l46kok/smart-doorlock/Documents/Smart Doorlock Poster.pptx

Department of
Electrical and
Computer Engineering

Applications

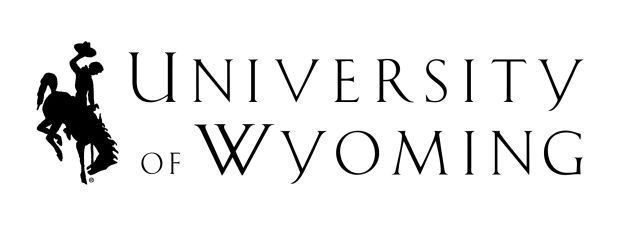
[picture p1: figure]
Image result for university of wyoming college of engineering

Smart Doorlock

Sokwhan Huh

Technology Background

http://sd.ufwfate.net/ Funded by Volpi and Cupal Senior Design Fund

Traditional mechanical locks have numerous issues pertaining to accessibility and security. Keys can be misplaced, broken, stuck in the lock and may not even turn, causing great deal of problems to home owners. Mechanical locks are easily picked by people with minimal knowledge in lock picking and keys are vulnerable to replication. A new type of door lock needs to be designed to better secure your assets.
With the advent of NFC (Near Field Communication) and IoT (Internet of Things), virtually everything around us can now be controlled via nothing more than a smartphone. The intent of this project is to provide a practical solution to aforementioned problems with traditional mechanical locks by applying both NFC and IoT technologies to an electronic door lock.

NFC Capability
- Open the door lock with NFC using an Android device.
IoT Capability
- Open the door lock over the internet using an Android device or by accessing Smart Doorlock’s web server with an internet browser.
Enhanced Security System
- Manage user access by registering smartphones.
- Entries are logged and can be audited.
Robust Operation
- 24 hour rechargeable battery backup system.

Smart Doorlock supports the following operations that can be navigated using the keypad:
- Active
- Configuration
  - Operation Setup
  - Register Phone
  - Unregister Phone
  - Setup Wi-Fi
  - Test Wi-Fi Connection
  - Factory Reset
- Reboot

System Block Diagram

Overview

Cost Summary

CC3200 Launchpad | $ 29.99
TRF7970A NFC BoosterPack | $ 24.99
Keypad | $ 9.04
6xAA Battery Holder | $ 2.50
20x4 LCD Display | $ 22.71
Solenoid Lock | $ 14.95
Enclosure | $ 21.94
Miscellaneous | $ 10.00
Total | $ 136.12

Final Design

Acknowledgements

For support and guidance in creating this project, I would like to give my special thanks to:
University of Wyoming
Dr. Steven Barrett
Victor Bershinsky
George Janack
Mike
LG Electronics Gasan R&D
Junseo Son
Nexol System
Jaesik Cho

Near Field Communication

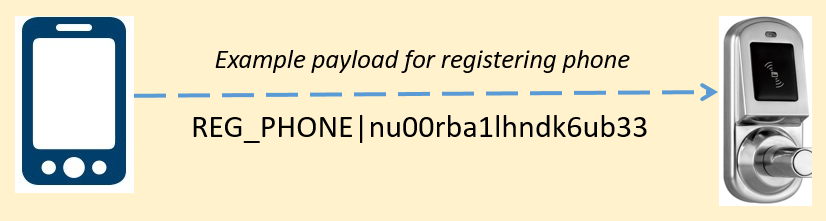
[picture p2: figure]

NFC is a collection of communication protocols that enable two electronic devices to establish communication in a close proximity, typically within 5cm if each other.
Android HCE (Host Based Card Emulation) technology
is used to emulate ISO 14443 type NFC tags. An encrypted payload from the smart phone is created in NDEF structure and sent to the door lock.

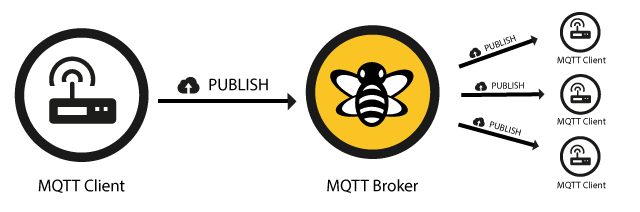
[picture p3: figure]
MQTT Publish Message Flow

MQTT (Message Queue Telemetry Transport) is a publish/subscribe based protocol specifically designed for use in IoT. Web server on cloud acts as a MQTT broker and Smart Doorlock acts as a MQTT client. Messages such as LOCK_CONTROL can published from the broker to control the door lock.

TRF7970A Circuit Diagram

Internet of Things

IoT Control Panel

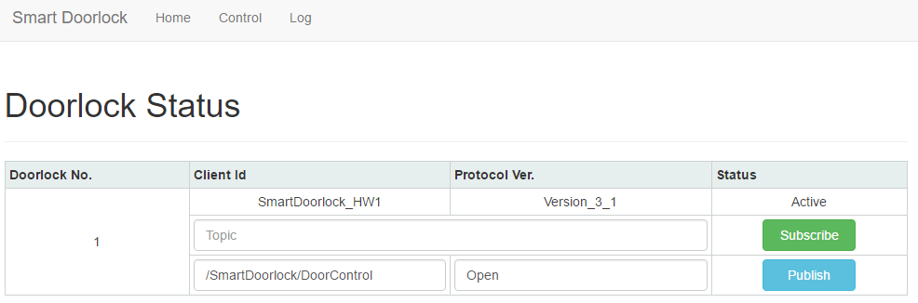
[picture p4: figure]

Android Application

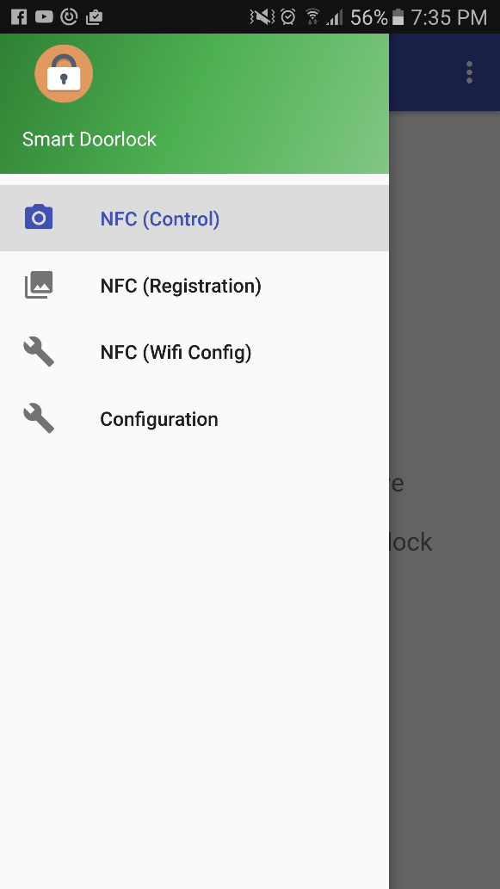
[picture p5: figure]

Access Log Audit

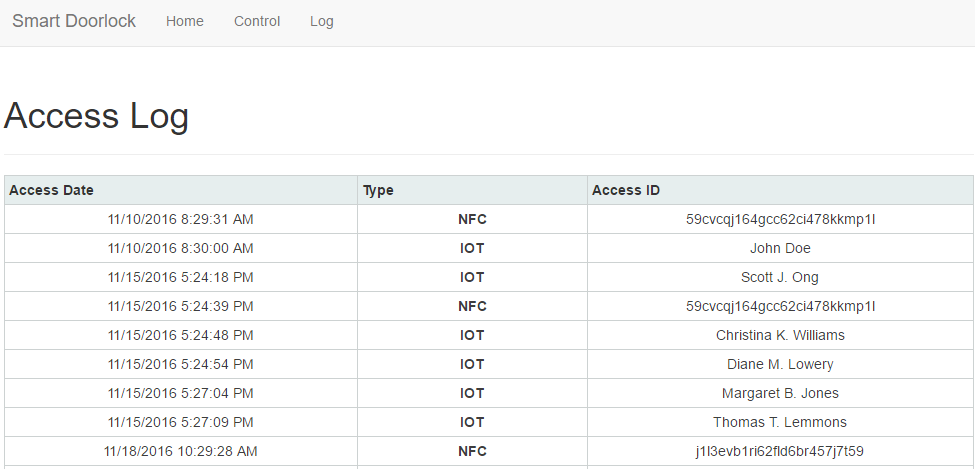
[picture p6: figure]

Features

CC3200 Circuit Diagram

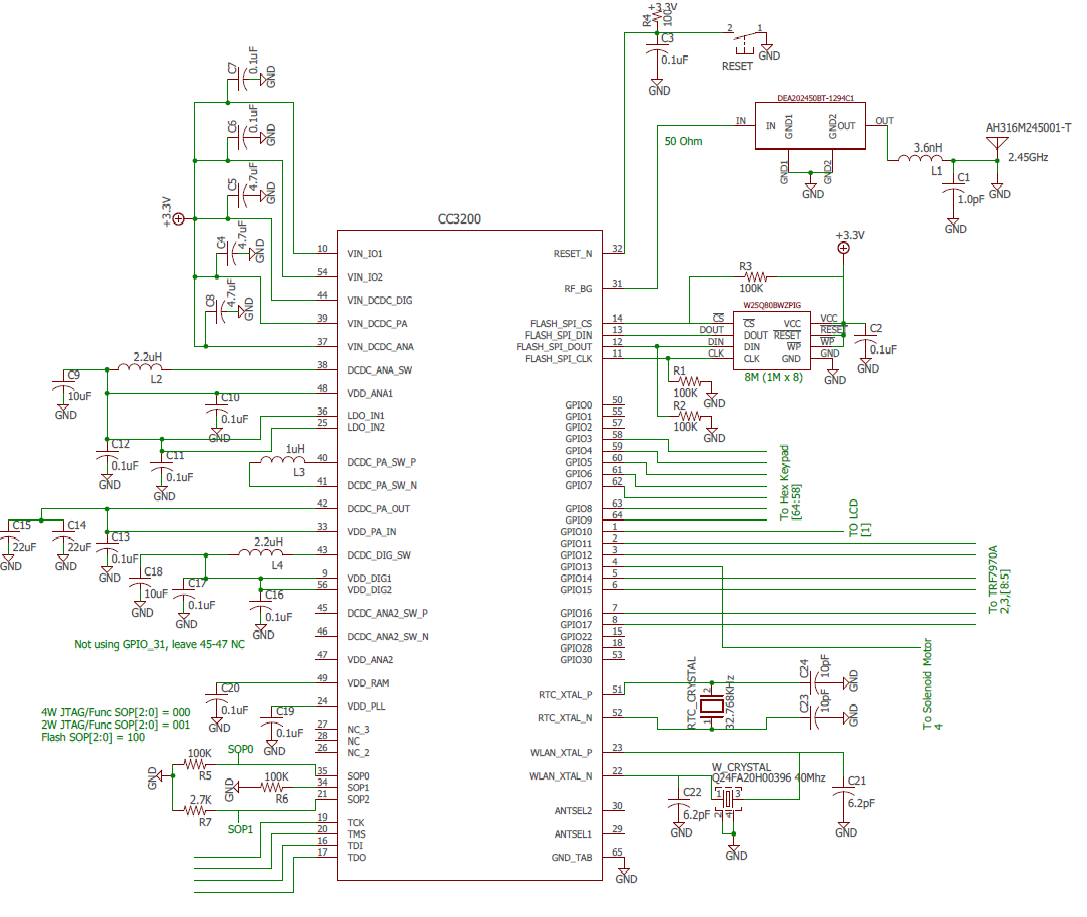
[picture p7: figure]

Hardware Design

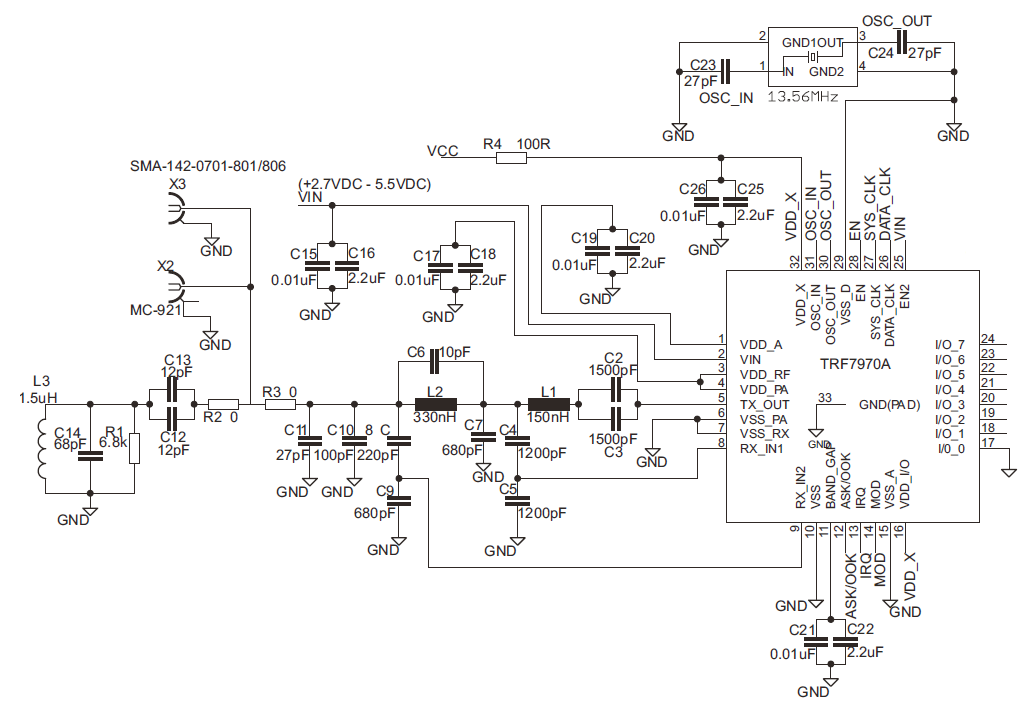
[picture p8: figure]

LCD/Solenoid/Keypad Driver Circuit Diagram

Operations

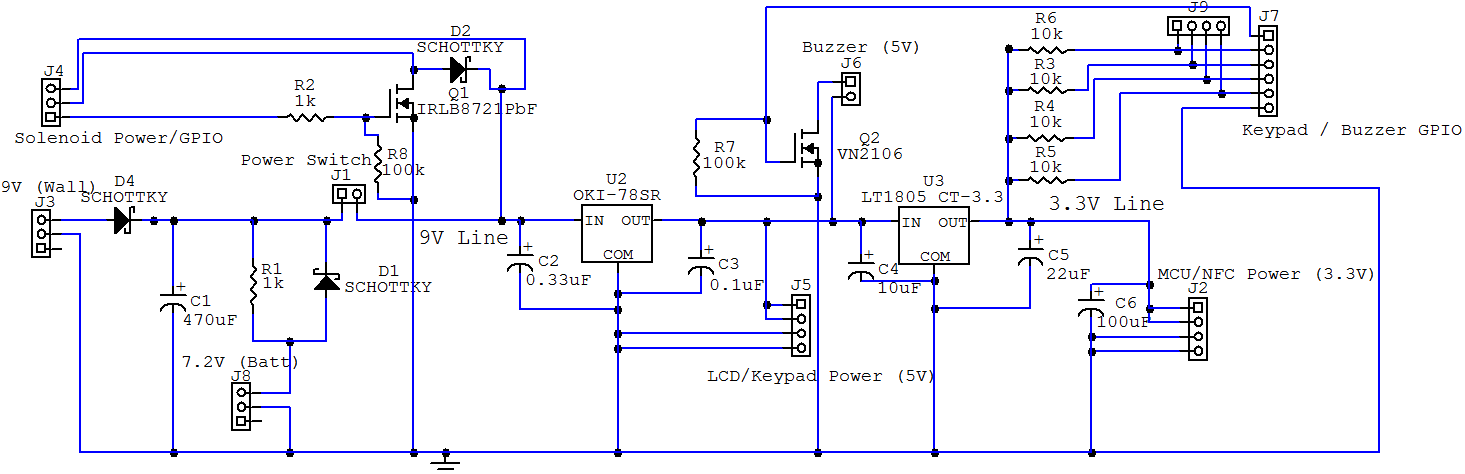
[picture p9: figure]
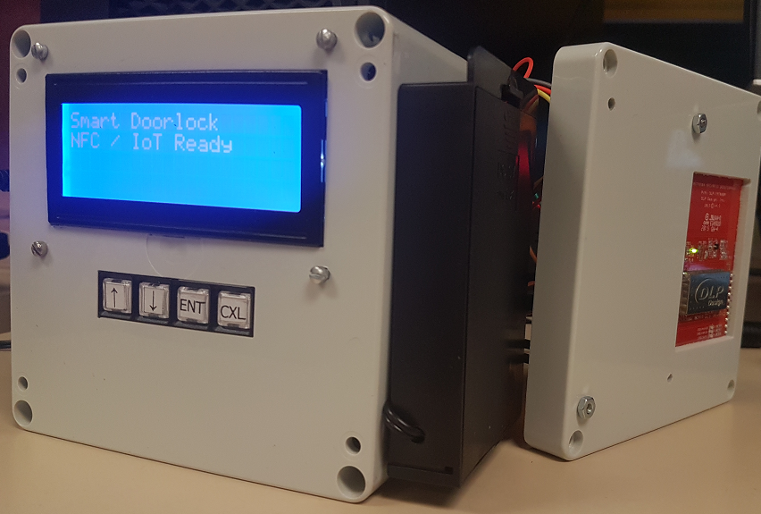
[picture p10: figure]

Microcontroller Boot Sequence

Software Design

NFC Task Diagram

Web Server Class Diagram

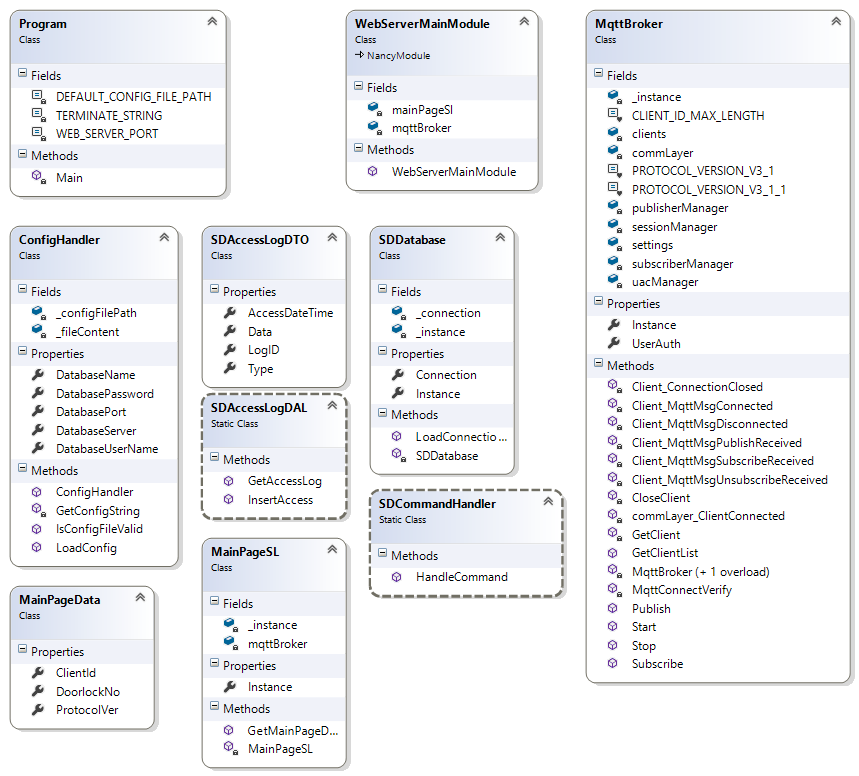
[picture p11: figure]
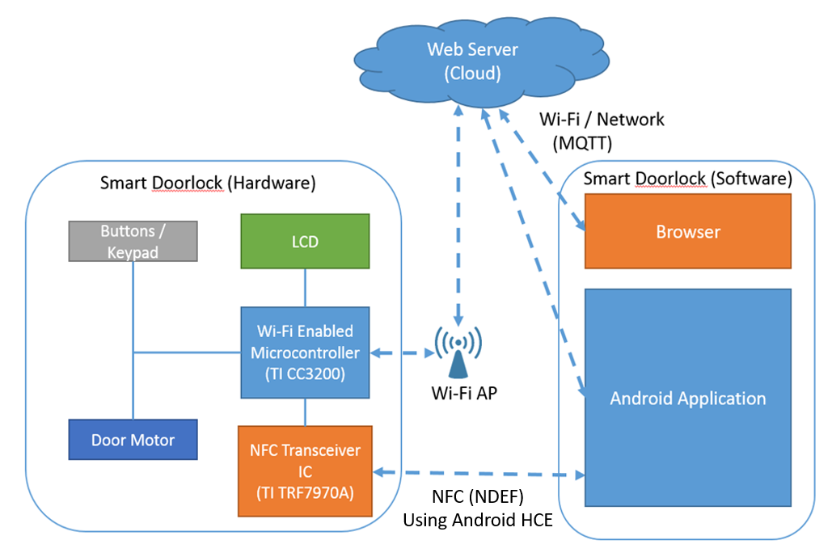
[picture p12: figure]

Android Application Flow Diagram

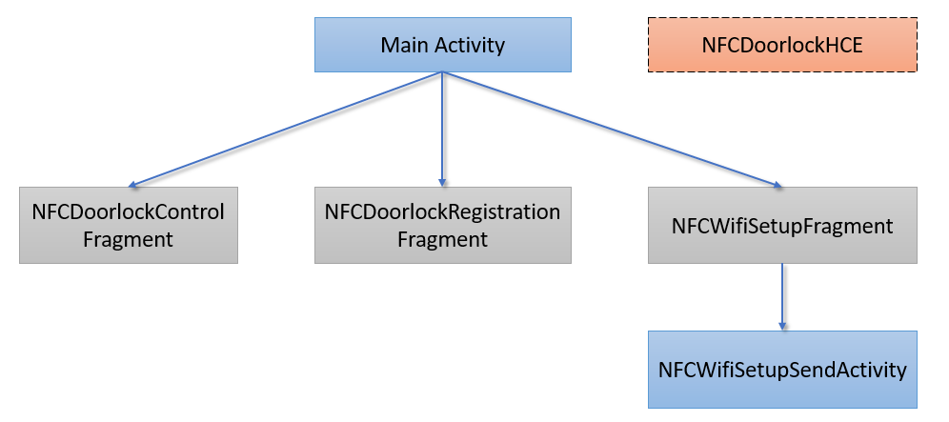
[picture p13: figure]

Microontroller Menu Flow Diagram

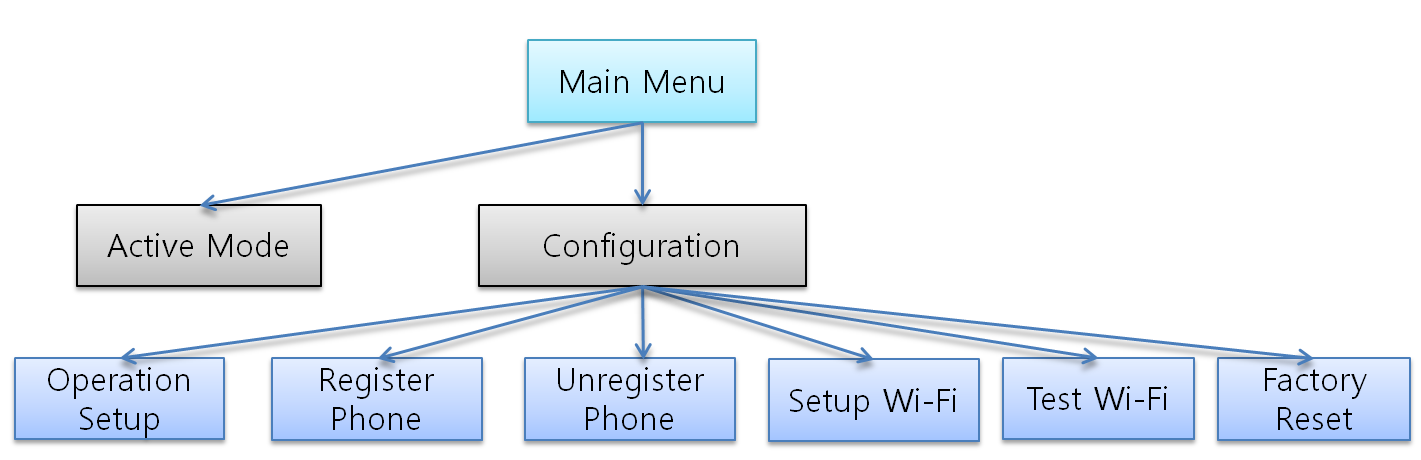
[picture p14: figure]
