l46kok/smart-doorlock/Documents/Smart Doorlock Final Project Report.docx

FINAL DESIGN REPORT TO: Dr. Steven F. Barrett

Associate Dean for Academic Programs

Professor, Electrical & Computer Engineering

FROM: Sokwhan Huh

DATE: Nov 21st, 2016

SUBJECT: Smart Doorlock Final Design Report Draft

For your review, attached is the final design report of the senior design project. Contents include 1) Introduction, briefly summarizing the goals, requirements and specification of the project, 2) Operation, discussing the functionalities and possible use cases of the door lock, 3) Parts, describing the specifications and the rationale for choosing the parts in detail, 4) Development, which captures the approach I will take to complete this project, 5) Project cost, which describes a preliminary analysis of the anticipated cost of the project and 6) References.

Sincerely,

Sokwhan Huh

Smart Doorlock Final Project Report

Date: November 21st, 2016

Primary Author: Sokwhan Huh

Revision History

Revision | Date | Reason for Changes
1.0 | May 12, 2016 | Created design report for Spring of 2016
1.1 | November 18, 2016 | Updated document to reflect actual progress of the project, added technical background section.
1.2 | November 19, 2016 | Added source codes for the project

Tables of Contents

# 1. Introduction

## 1.1 Executive Summary

Traditional mechanical locks have numerous issues pertaining to accessibility and security. Always having to carry keys can be burdensome and keys themselves can be misplaced, broken, stuck in the lock or may not even turn causing great deal of problems to home owners. These locks often are also not built to cater for disabled personnel who may lack the capability of operating such lock. But the bigger problem lies with its insufficient security. Mechanical locks are easily picked by people with minimal knowledge in lock picking and keys are vulnerable to replication by locksmiths. A new type of door lock needs to be designed to better secure your assets.

With the advent of NFC (Near Field Communication) and IoT (Internet of Things), virtually everything around us can now be controlled via nothing more than a smartphone. NFC is now a quintessential technology for transportation systems around the world, as a passenger simply needs to carry his or her smartphone to use the services as opposed to purchasing tickets and transportation cards. Commonly known as Smart Home Technology, IoT is being deployed in many households which allow household products to be controlled in all imaginable ways requiring nothing but an internet connection. The intent of this project is to provide a practical solution to aforementioned problems with traditional mechanical locks by applying both NFC and IoT technologies to an electronic door lock.

## 1.2 Terminologies

The following acronyms and terminologies are used in this document:

Acronym / Terminology | Description
NFC | Near Field Communication.
RFID | Radio-Frequency Identification.
IOT | Internet of Things.
ISO/IEC 14443 | Four-part international standard for contact-less smart cards operating at 13.56 MHz in close proximity.
ISO/IEC 7816-4 | International standard for logical structure of data in smart cards.
HCE | Host-based Card Emulation. Feature of Android operating system that allows smartphones to emulate a NFC tag in ISO 14443 standard.
NDEF | NFC Data Exchange Format. A standardized data format that is used to exchange information between any compatible NFC device.
TCP/IP | Transmission Control Protocol / Internet Protocol. Commonly known as Internet protocol suite. Defines set of communications protocols used on the Internet.
MQTT | Message Queuing Telemetry Transport. A publish-subscribe based "light weight" messaging protocol for use on top of the TCP/IP protocol.
API | Application Programming Interface.
OFDM | Orthogonal Frequency-Division Multiplexing
AP | Access Point.
SSID | Service Set Identifier.
ASK | Amplitude-Shift Keying .
APDU | Application Protocol Data Unit. Command and response packets for communication with smartcards. Defined in ISO 7816-4 standard.
AID | Application ID. Defined in ISO 7816-4 standard to distinguish NFC devices.
PICC | Proximity Integrated Circuit Cards. Examples include NFC tags and contactless smart cards.

## 1.3 Target Market

This project is intended for the following audience:

- Lay person being able to control their door locks with ease, eliminating the need of carrying a key or memorizing passwords.
- Handicapped personnel who may have difficulties locking and unlocking a traditional door lock.
- People who are looking for additional security measures.

## 1.4 Project Requirements

The core project requirements are as follows:

- Demonstrate NFC capability
  - Be able to open the door lock with NFC using an Android device. The device must be registered in advance to open the door lock.
- Demonstrate IoT capability
  - Be able to open or permanently lock (lockdown mode) the door lock over the internet using an Android device or by accessing Smart Doorlock’s web server with a browser. The phone must be registered in advance to open the door lock.
- Demonstrate enhanced security system
  - Be able to register phones for access.
  - Be able to clear existing registered phones.

Additional requirements are as follows:

- Implement full logging system for entries.
- Have the door lock function with a battery backup in case of power outage.

## 1.5 Technical Specifications

- Interfacing via NFC between Smart Doorlock and an Android device using Host-based Card Emulation technology
- Interfacing via IoT to a cloud server over MQTT Protocol
- NFC communication range: 5 cm maximum (from smartphone to Smart Doorlock)
- Wi-Fi communication range: 50 meters maximum (TX 14.5dBM, RX -74.0dBM at 54 OFDM)
- Microcontroller: Texas Instruments CC3200
- NFC Transceiver IC: Texas Instruments TRF7970A
- AC power with DC battery backup
- Minimum backup battery life of 24 hours
- Keypad: Grayhill 4x1 87FC3-201 transparent keypad
- LCD: Newhaven’s NHD-0420D3Z-NSW-BBW-V3-ND 4x20 characters
- Programming Language: C (Microcontroller), Java (Android Application), C# (Web Server)
- Supported Android versions: 4.4 (Kitkat) and above
- Web Server Framework: NancyFX
- Web Server Database: MySQL

# 2. Technology Background

As Smart Doorlock utilizes some of the most cutting edge technologies available today, this section will briefly provide a background information on the two major technologies (NFC, IoT) driving the project.

## 2.1 NFC Introduction

NFC is a collection of communication protocols that enable two electronic devices to establish communication in a close proximity, typically within 5 cm of each other. Specifically, NFC is a branch of High-Frequency (HF) RFID (Radio-Frequency Identification) that operates at the 13.56 MHz frequency. NFC is designed to be a secure form of data exchange and unlike RFID, an NFC device is flexible in the sense that it is capable of acting as a reader (active mode) or as a tag (passive mode). This unique feature allows the two devices to communicate in a bi-directional manner (peer-to-peer communication). The following chart displays the speed and two codings NFC employs:

Speed | Active device | Passive device
424 kbits/s | Manchester coding, 10% ASK | Manchester coding, 10% ASK
212 kbits/s | Manchester coding, 10% ASK | Manchester coding, 10% ASK
106 kbits/s | Modified Miller, 100% ASK | Manchester coding, 10% ASK

Table 2.1: Speed and codings used by NFC technology

## 2.2 NFC Standards

As NFC is a subset of RFID, much of its standards are derived from existing RFID standards including ISO 7816-4, ISO 14443, ISO 15693, ISO 18092 and FeliCa. These standards specify the modulation schemes, coding, transfer speeds, frame format, initialization schemes, collision-control, and transport protocol. The choice of standard entirely dictates the method and capability of communication between the two NFC devices. This document will provide background on ISO 7816-4 and ISO 14443 standards as Smart Doorlock utilizes these two standards to communicate between the door lock and the smart phone.

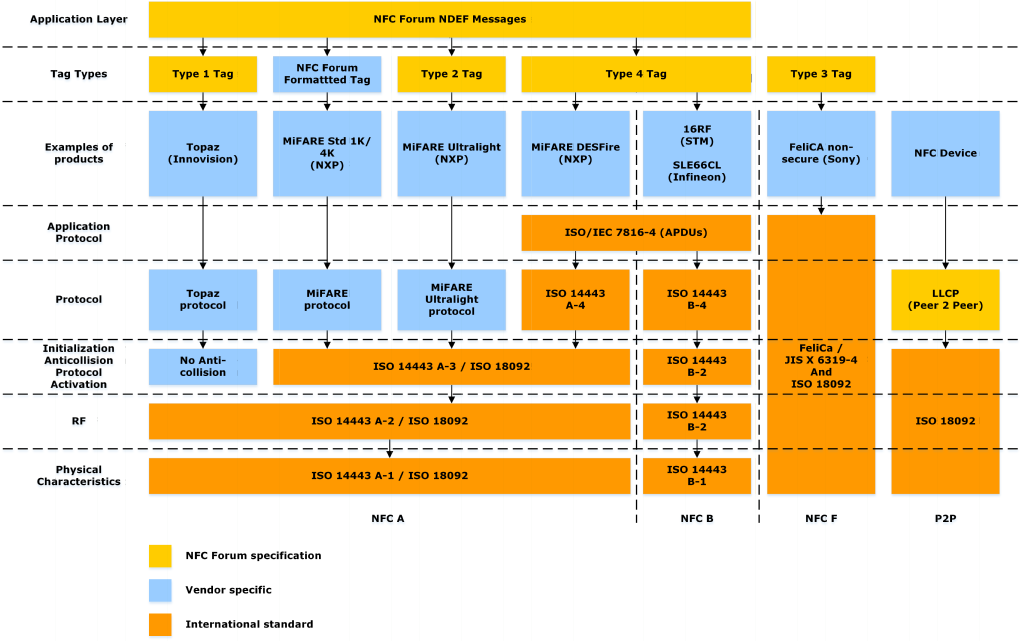
[picture p15: figure]

Figure 2.2: NFC protocol stack overview

## 2.3 ISO 7816-4 Standard

ISO 7816 is an international standard covering electronic identification cards with contacts, such as smart cards. ISO 7816-4 specifically denotes the organization, security and commands for interchange. The standard specifies the following:

- Contents of command-response pairs exchanged at the interface,
- Means of retrieval of data elements and data objects in the card,
- Structures and contents of historical bytes to describe operating characteristics of the card,
- Structures for applications and data in the card, as seen at the interface when processing commands,
- Access methods to files and data in the card,
- A security architecture defining access rights to files and data in the card,
- Means and mechanisms for identifying and addressing applications in the card,
- Methods for secure messaging,
- Access methods to the algorithms processed by the card.

Note that this standard does not cover the internal implementation within the card or the outside world. This is covered in a different standard such as ISO 14443.

APDU (Application Protocol Data Unit) are the command and response packets used in ISO 7816-4 standard. A command APDU consists of an instruction code and associated parameter data. In response to a preceding command APDU, a response APDU is sent back which consists of response data and a response status code. Table 2.31 shows the structure of command-response APDU.

Field | Description | Number of bytes
Command Header | Class byte denoted CLA | 1
| Instruction byte denoted INS | 1
| Parameter bytes denoted P1-P2 | 2
Lc field | Absent for encoding Nc = 0, present for encoding Nc > 0 | 0, 1 or 3
Command data field | Absent if Nc = 0, present as a string of Nc bytes if Nc > 0 | Nc
Le field | Absent for encoding Ne = 0, present for encoding Ne > 0 | 0, 1, 2 or 3
Response data field | Absent if Nr = 0, present as a string of Nr bytes if Nr > 0 | Nr (at most Ne)
Response trailer | Status bytes denoted SW1-SW2 | 2

Table 2.31: Command-response APDU pair

ISO 7816-4 also defines a unique identifier called AID (Application Identifier). This identifier is used to distinguish between different NFC devices so that it provides a guarantee method for an NFC device to recognize that it’s communicating to the correct target.

In relation to Smart Doorlock, a SELECT AID command is sent from NFC reader to Android device when the two devices are attempting to establish the NFC communication. For appliactions to be used with existing NFC readers, the AIDs that those readers are looking for are typically well-known and publicly registered (for example, the AIDs of payment networks such as Visa and MasterCard). If a new reader infrastructure is to be deployed for a proprietary application, registering a unique AID in accordance to ISO 7816-5 specification is recommended to avoid collisions with other applications.

Table 2.32 shows an actual example of APDU sent from Smart Doorlock to Android device in an attempt to check if the target has an AID of “D2760000850101”

Command Header | | | | Lc | Command Data Field | Le
CLA | INS | P1 | P2 | | AID
0x00 | 0xA4 | 0x04 | 0x00 | 0x07 | 0xD2760000850101 | 0x00

Table 2.32: Command-response APDU pair

## 2.4 ISO 14443 Standard

ISO 14443 is a four-part international standard for contactless smart cards. The four parts, denoted from ISO 14443-1 to ISO 14443-4 are as follows:

- Part 1 [ISO 14443-1]: Defines the size and physical characteristics of the card. This standard lists several environmental stresses that the card must be capable of withstanding without permanent damage to the functionality.
- Part 2 [ISO 14443-2]: Defines the RF power and signal interface. Two signaling schemes known as Type A and Type B are defined in this part. Both communication schemes are half duplex with a 106 kbis per second data rate in each direction. Data transmitted by the card is load modulated with a 847.5 kHz subcarrier.
- Part 3 [ISO 14443-3]: Defines the initialization and anticollision protocols for Type A and Type B. The anticollision commands, responses, data frame, and timing are defined in this part. The initialization and anticollision scheme is designed to permit the construction of multi-protocol readers capable of communication with both Type A and Type B cards. Both card types wait silently in the field for a polling command. A multi-protocol reader would poll one type of card, complete any transactions with cards responding and then poll for the other type of card and transact witht hem.
- Part 4 [ISO 14443-4]: Defines the high-level data transmission protocols for Type A and Type B. The protocol defined in this part is also capable of transferring APDU as defined in ISO 7816-4 and of AID selection.

Difference between Type A and Type B is that Type A uses Miller encoding (delay encoding) with an amplitude modulation at 100% while Type B uses Manchester encoding with amplitude modulation at 10%. Note that in case of Smart Doorlock, Android devices emulate Type A cards with HCE (Host-Based Card Emulation) technology. Figure 2.4 provides an overview of ISO 14443 protocol stack.

ISO/IEC 14443

ISO 14443-1
Physical Properties

ISO 14443-2 Type A

Power, Bit Transmission

ISO 14443-3 Type A

Activation, Anticollision

ISO 14443-4

Transport Protocol

ISO 7816-4
APDU, Application Protocol

Figure 2.41: ISO 14443 Protocol Stack

As ISO 14443-1 and ISO 14443-2 focuses on the physical and RF characteristics of the standard, the actual implementation of these two protocols are dictated by the choice of hardware (in case of Smart Doorlock, this refers to NFC reader and Android device). This section will primarily focus on ISO 14443-3 and ISO 14443-4 for the actual implementation of the protocol.

ISO 14443-3 defines the activation and anticollision sequence. In order for an NFC reader to detect PICC (Proximity Integrated Circuit Cards), the NFC reader goes through a sequence of polling to repeatedly send request commands known as REQA (Request Command, Type A). When a PICC of Type A is exposed to an unmodulated operating field, the request to command is accepted and responded with ATQA (Answer to Request, Type A). Next, the NFC reader undergoes a looping process known as anticollision detection to determine if at least two PICCs are simultaneously transmitting bit patterns. As bit patterns are continuously sent from the PICC, the NFC reader needs to determine if the received UID (Unique Identifier, Type A) is complete during its anticollision loop.

Each time the NFC reader receives a UID, it transmits a SEL (Select) command appended with either partial or fully received UID to the PICC, which is responded with SAK (Select Acknowledge). The SAK response indicates that UID transmission is complete or not. ISO 14443A standard permits UIDs of different lengths – 4 bytes, 7 bytes and 10 bytes. Therefore, in case the PICC has a UID of 7 or 10 bytes, it will notify the NFC reader by setting the cascade bit in SAK command. This causes the reader to increase the cascade level in anticollision loop and repeat the process starting from selecting the UID. If the UID is 10 bytes long, the anticollision loop is ran a third time. Table 2.42 and 2.43 shows the SEL command and the SAK response structure.

b8 | b7 | b6 | b5 | b4 | b3 | b2 | b1 | Meaning
1 | 0 | 0 | 1 | 0 | 1 | 1 | 1 | ‘93’ Select cascade level 1
1 | 0 | 0 | 1 | 0 | 1 | 0 | 1 | ‘95’ Select cascade level 2
1 | 0 | 0 | 1 | 0 | 1 | 1 | 1 | ‘97’ Select cascade level 3
1 | 0 | 0 | 1 | Other values except those here above | | | | RFU

Table 2.42 SEL command structure

b8 | b7 | b6 | b5 | b4 | b3 | b2 | b1 | Meaning
x | x | x | x | x | 1 | x | x | Cascade bit set: UID not complete
x | x | 1 | x | x | 0 | x | x | UID complete, PICC compliant with ISO 14443-4
x | x | 0 | x | x | 0 | x | x | UID complete, PICC not compliant with ISO 14443-4

Table 2.43 SAK response structure

Note that UID serves a completely different purpose than AID as mentioned in ISO 7816-4 standard. Contrary to its name, there is no specification in the standard that mandates the UID to be truly unique. As it will be apparent in Android HCE section of this document, the UID is randomly generated on an Android device each time the device attempts to perform NFC communication. Hence, the UID should not be relied on for actual identification of the NFC device or PICC in the actual implementation of an application. Figure 2.44 is a flowchart for initialization and anticollision procedure of ISO 14443-3.

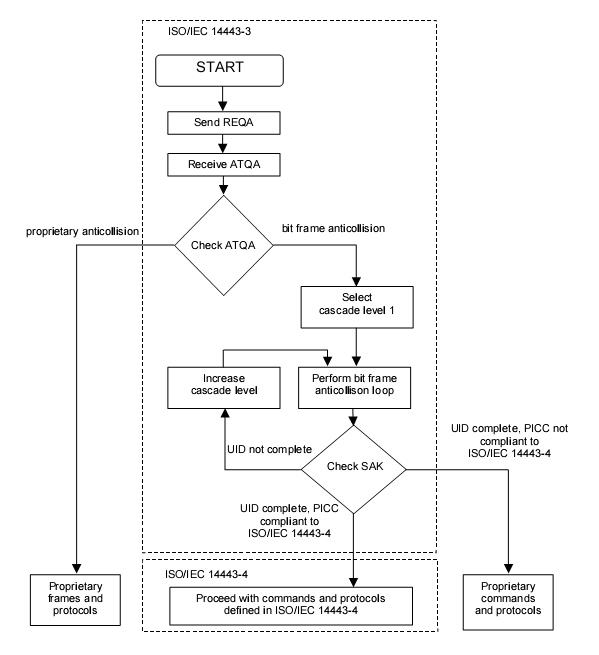
[picture p16: figure]

Figure 2.44 – Initialization and anticollision flowchart for NFC reader

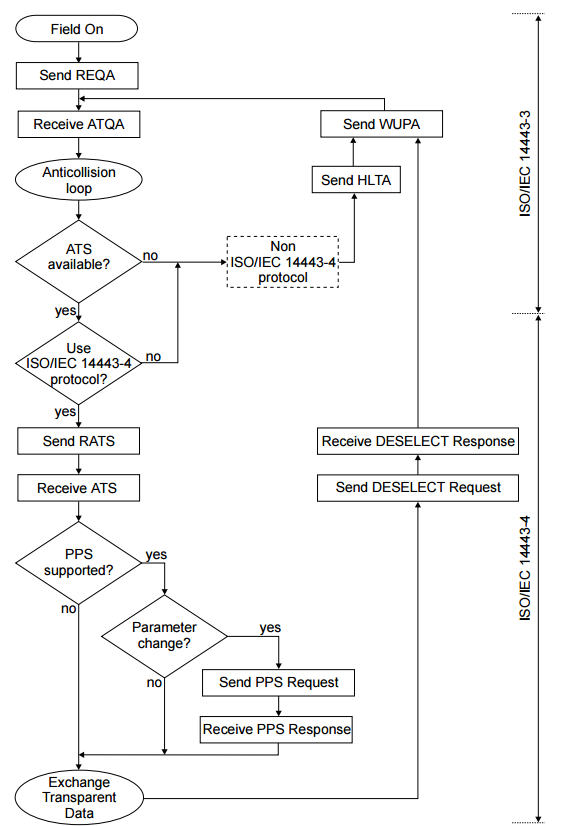
[picture p17: figure]

ISO 14443-4 specifies a half-duplex block transmission protocol featuring the special needs of contactless environment and defines the activation and deactivation sequence of the protocol. When PICC activation sequence as defind in ISO 14443-3 is complete, the SAK byte is checked for availability of an ATS (Answer To Select). If ATS is not available, then the target of NFC reader is assumed to be non ISO14443-4 compliant. If it is available, the NFC reader sends RATS (Request for Answer To Select) to the PICC. The PICC must respond with ATS as an answer to the RATS. NFC reader can check the ATS to determine if PICC supports any changeable parameters, such as transmission rate. The NFC reader may optionally send a PPS command if the PICC has any modifiable parameters. The protocol activation sequence for ISO 14443-4 is shown in Figure 2.45.

Figure 2.45 – Protocol activation sequence for ISO 14443-4

## 2.5 NDEF Structure

NDEF (NFC Data Exchange Format) is a standardized data format that is used to exchange information between any compatible NFC devices. It is a binary format structured in messages, intended to be used on the application layer. Each record is made up of a header, which contains metadata about the record, such as the record type, length etc. The header is followed by a payload, which is the actual content of the message being transmitted.

Each record’s payload can be one of several different data types. The header for each record contains metadata describing the record and its place in the mssage, followed by its type and ID. Figure 2.51 shows the structure of the bits and bytes of an NDEF record.

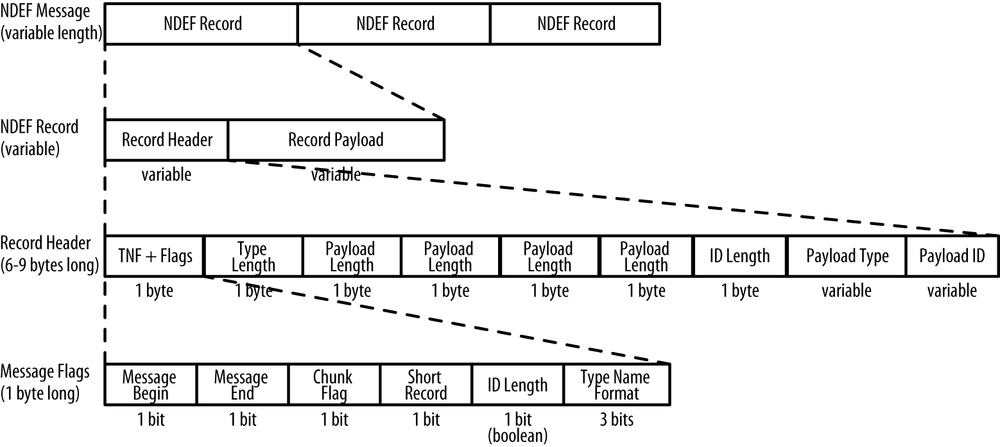
[picture p18: figure]
NDEF message structure, with details about the bytes of the header

Figure 2.51 NDEF Message Structure

TNF (Type Name Format) indicates how to interpret the type field. The seven possible TNF values are shown in Table 2.52

TNF | Meaning | Description
0 | Empty | Empty record with no payload
1 | Well-Known | One of several pre-defined types laid out in the NFC Forum RTD specification
2 | MIME media-type | An Internet media type as defined in RFC 2046
3 | Absolute URI | A URI as defined in RFC 3986
4 | External | A user-defined value
5 | Unknown | Type is unknown
6 | Unchanged | Only for middle and terminating records of chunked payloads
7 | Reserved | Reserved by the NFC Forum for future use

Table 2.52 Type Name Format values

For use in proprietary applications, the choice of TNF is often 04 (external). Smart Doorlock uses this TNF to transmit its set of messages defined by the application protocol.

Use of NDEF structure is not mandated for NFC communication by ISO 7816-4 and ISO 14443. However, large data may have to be transmitted in chunks due to the nature of NFC transactions being short. Thus, NDEF structure is generally considered to be lingua franca for NFC devices and certain protocols in Android devices, such as ISO 18092 (Peer-to-Peer) is strictly configured to handle NDEF type messages only.

## 2.6 Android Host-Based Card Emulation

Android-powered devices with NFC support three main modes of operation:

  - Reader / writer mode, allowing the NFC device to read and/or write passive NFC tags and stickers. Supported from version Gingerbread (2.3.3).
  - Peer-to-Peer mode, allowing the NFC device to exchange data with other NFC peers (Android Beam). Supported from version Ice Cream Sandwitch (4.0).
  - Card emulation mode, allowing the NFC device itself to act as an NFC card. The emulated NFC card can then be accessed by an external NFC reader. Supported from version KitKat (4.4)

For bi-directional NFC communication, Peer-to-Peer mode or Card emulation mode may be chosen as the mode of operation. While Peer-to-Peer mode has the advantage that the API (Application Programming Interface) is more widely supported than Card emulation mode, Android OS requires the user to manually “tap” the screen to transmit the payload to the target with Peer-to-Peer mode. As this manual intervention by the user can cause usability issues, Smart Doorlock’s Android application takes advantage of HCE (Host-Based Card Emulation) mode to perform NFC communication.

HCE emulates NFC cards that are based on ISO 14443 and ISO 7816-4 specification. By default, Type A technology is supported by the Android but support for Type B technology is optional.

When an NFC card is emulated, the data is routed to the host CPU on which Android applications are running directly. Figure 2.6 illustrates how HCE works.

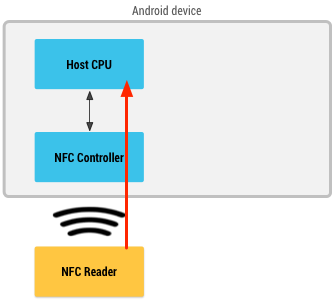
[picture p19: figure]

Figure 2.6 NFC card emulation on an Android device

Majority of details pertaining to ISO 14443 and ISO 7816-4, such as the anti-collision sequence and protocol activation are all handled by Android automatically are abstracted away in Android APIs hence, this allows Android developers to primarily focus on the highest NFC layer available to them, but any implementation change in the underneath protocol is practically disallowed. HCE based applications must define an AID for NFC readers to be able to select for identification (See ISO 7816-4 standard).

## 2.7 IoT Introduction

IoT (Internet of Things) is the internetworking of physical devices embedded with electronics, software, sensors, actuators, and network connectivity that enable these objects to exchange data. As the name “Things” indicate, it can refer to a variety of devices such as heart monitoring implants, biochip transponders, automobiles with built-in sensors, or field operation devices that assist firefighters in search and rescue operations. IoT is expected to offer advanced connectivity of devices, systems, and services that goes beyond machine-to-machine communications and covers a variety of protocols, domains, and applications.

Many connectivity options exist today for IoT including Bluetooth, Zigbee, Wi-Fi, and 2G/3G/4G cellular. As Smart Doorlock is expected to be installed in buildings with access point available nearby, Wi-Fi was chosen as main option for IoT connection. Thus, this document will illustrate the technology and protocol behind Smart Doorlock’s Wi-Fi connectivity.

## 2.7 MQTT Protocol

MQTT (Message Queing Telemetry Transport) is a connectivity protocol specifically designed for use in IoT. It is a publish/subscribe, simple and lightweight messaging protocol for use on top of the TCP/IP protocol. Its design makes it ideal for constrained devices and low-bandwidth, high-latency or unreliable networks.

MQTT defines methods (also referred to as verbs) to indicate the desired action to be performed on the identified resource. The representation of this resource, wherther pre-existing data or data that is generated dynamically depends entirely on the implementation of the server, known as MQTT broker. Table 2.71 shows the available MQTT methods.

Method | Description
Connect | Waits for a connection to be established with the server.
Disconnect | Waits for the MQTT client to finish any work it must do, and for the TCP/IP session to disconnect.
Subscribe | Subscribes to a given topic to receive messages in the futre via Publish.
Unsubscribe | Unsubscribes from a given topic to no longer receive published message on the topic.
Publish | Publishes a message to a topic. The message is broadcasted to all clients subscribed to the topic.

Table 2.71 MQTT Methods

After a MQTT client is connected to a broker, it can publish messages. MQTT has a topic-based filtering of the messages on the broker; hence each message must contain a topic, which will be used by the broker to forward the message to interested clients. Each message typically has a payload which contains the actual data to transmit in byte format. As MQTT is data-agnostic, the format of the data is up to the implementation of application. An example MQTT packet is shown in figure 2.72.

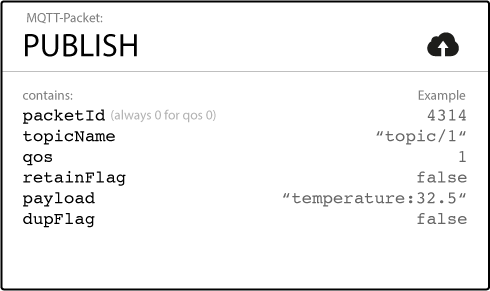
[picture p20: figure]
MQTT Publish attributes

Figure 2.72 Example of MQTT Packet

Aside from the performance bottleneck of the broker, there is no hard limitation on the number of MQTT clients that can connect. As mentioned earlier, a published message from a client is only broadcasted to other clients that subscribed to the topic of interest. This enables a simple yet efficient management of multiple IoT devices being connected to a single MQTT broker as illustrated in Figure 2.73.

MQTT Publish Message Flow

Figure 2.73 Example of MQTT Broker Handling Message Publish

A QoS (Quality of Service) level can be defined for each message being published. The level (0,1,2) determines the guarantee of message reaching the other end (client or broker). The minimal level zero, often referred to as “fire and forget”, guarantees a best effort delivery. The message sent won’t be acknowledged by the receiver or stored and redelivered by the sender. Using QoS level one guarantees that a message will be delivered at least once to the receiver. However, there is a chance that a duplicate message is delivered to the receiver. The highest level of QoS two guarantees that each message is received only once by the counter part. This is by far the safest and also the slowest quality of service level. The guarantee is provided by two flows there and back between sender and receiver. If a receiver gets a QoS two publish, it will process the publish message accordingly and acknowledge it to the sender with a PUBREC message. Security is of a highest concern in Smart Doorlock thus, QoS level of two was used.

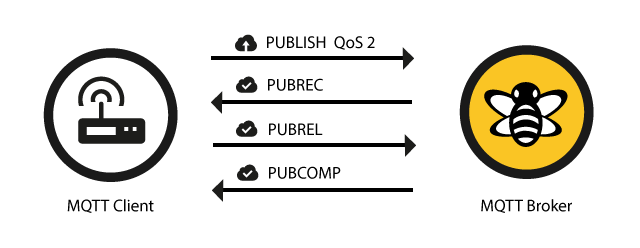
[picture p21: figure]
publish_qos2_flow

Figure 2.74 Example of QoS Two Message Publish and Response

# 3. Hardware

## 3.1 Microcontroller

Texas Instruments CC3200 SimpleLink™ was chosen for the microcontroller for this project. Relevant specifications of the chip are as follows:

- Single-Chip Wireless MCU
- ARM®Cortex®-M4 Core at 80 MHz
- Up to 27 Individually Programmable, Multiplexed GPIO Pins
- 1 Serial Peripheral Interface (SPI)

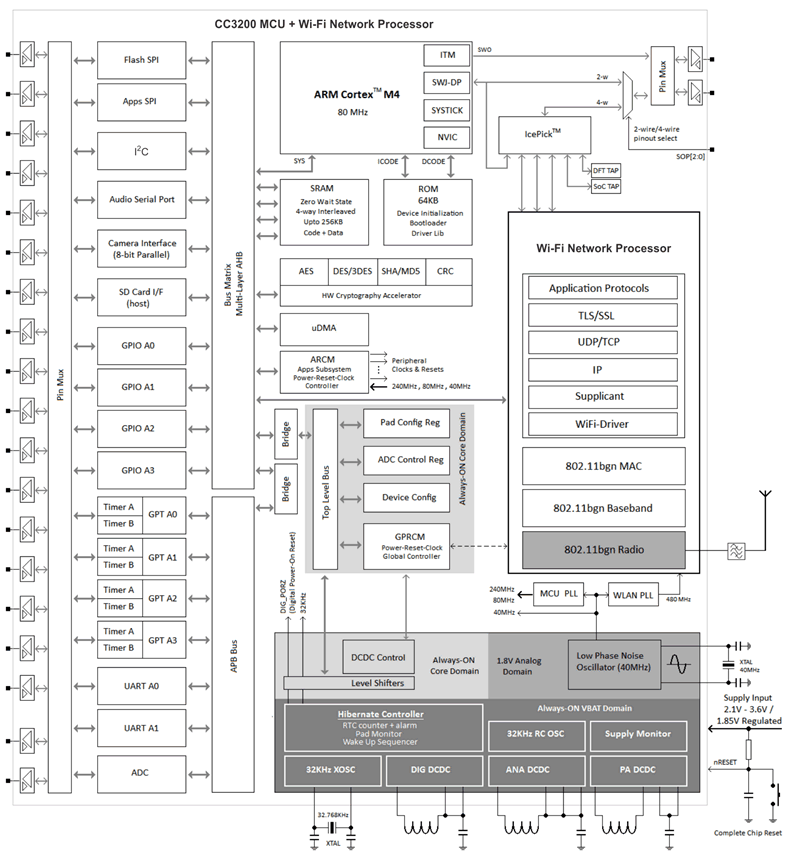
[picture p22: figure]

- Embedded Memory RAM (Up to 256KB)

Figure 3.1: Functional block diagram of Texas Instruments CC3200

## 3.2 NFC Transceiver IC

Texas Instruments TRF7970A was chosen for the NFC transceiver IC. A core requirement of this project is to be able to perform P2P communication via NFC and this chip satisfies this requirement. Relevant specifications of the chip are as follows:

- Supports Near Field Communication (NFC) Standards NFCIP-1 (ISO/IEC 18092) and NFCIP-2 (ISO/IEC 21481)
- Parallel or SPI Interface (With 127-Byte FIFO)
- Integrated Encoders, Decoders, and Data Framing for NFC Initiator, Active and Passive Target Operation for All Three Bit Rates (106 kbps, 212 kbps, 424 kbps) and Card Emulation

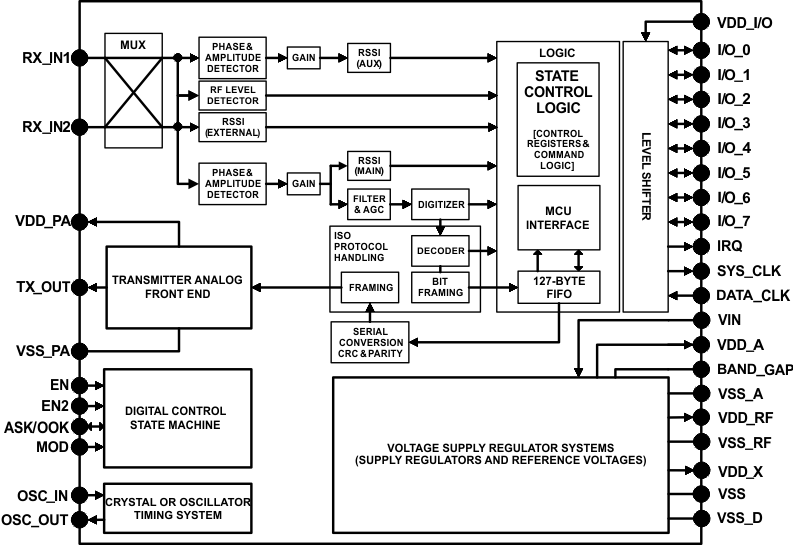
[picture p23: figure]

Figure 3.2: Functional block diagram of Texas Instruments TRF7970A

## 3.3 LCD

Due to the number of initial configuration required, an LCD display that can display a relatively large number of characters is required. An LCD capable of interfacing in UART was chosen to limit the number of connections lines to the MCU. This project will use Newhaven’s NHD-0420D3Z-NSW-BBW-V3-ND LCD as it is capable of displaying 80 characters total and supports UART interfacing. Following is the specification of the LCD:

- Display Format: 20 x 4
- Character Format: 5 x 8 Dots
- Character Size: 4.75mm H x 2.95mm W
- Outline: 98.00mm x 60.00mm x 13.50mm
- Viewing Area: 76.00mm L x 25.20mm W

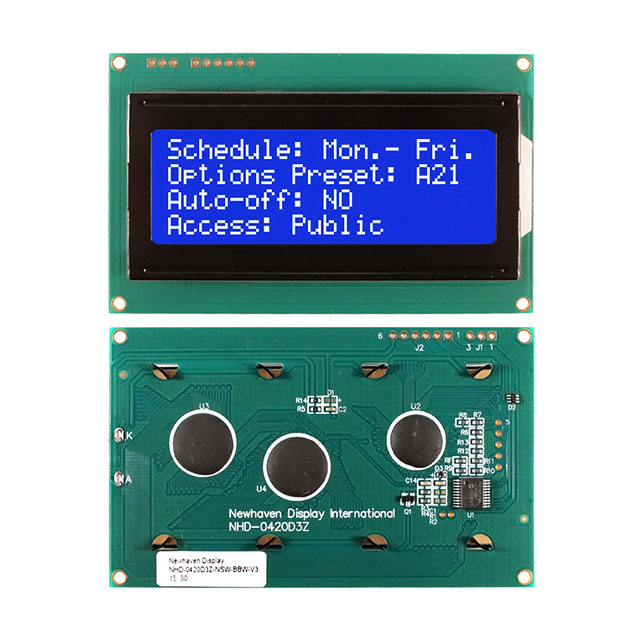
[picture p24: figure]

- Interface: UART

Figure 3.3: NHD-0420D3Z-NSW-BBW-V3-ND LCD unit

## 3.4 Keypad

A keypad is required for the navigation of the menus described in section 2: Operation of this document. This project will use Storm Interface’s Storm 720GFXI Series (7207-121W20) keypad. Relevant specifications of the keypad are as follows:

- 3 x 4 Matrix keypad
- Switch Type: Snap Dome
- Pins required: 10
- Mounting Type: Panel Mount, Front

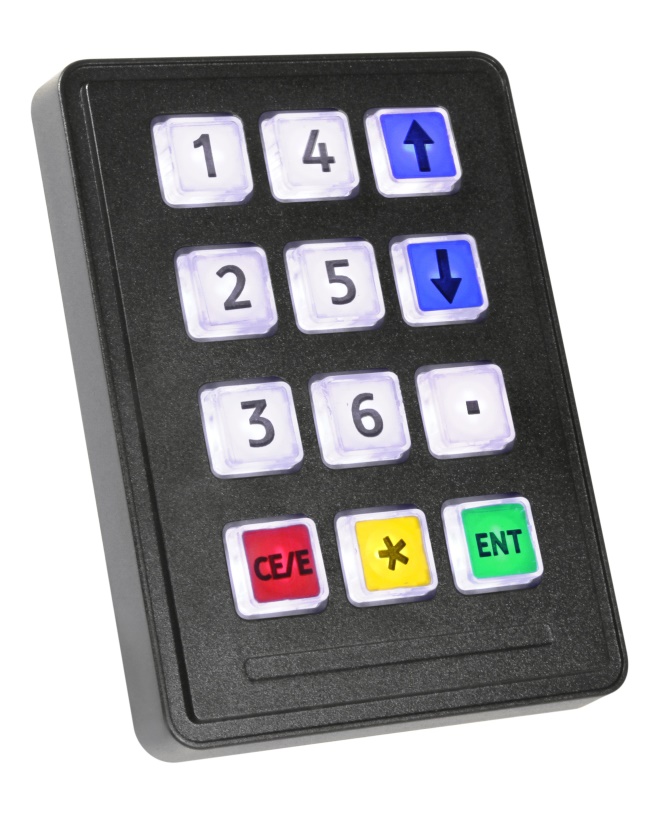
[picture p25: figure]

Figure 3.4: Storm Interface’s Storm 720GFXI Series

# 4. Operation

## 4.1 General

The Smart Doorlock will have three modes of operation: 1) Active, 2) Registration and 3) Configuration. Current mode of operation is displayed on LCD and the user is able to shift through the modes using the keypad. It should be noted that any IoT related functionalities are purely optional as the door lock may not have access to internet on the premises.

## 4.2 Active Mode

This is the default mode of operation for the door lock. In order to operate the door lock by smartphone contact (NFC) or by accessing the Smart Doorlock’s web service (IoT), the door lock must currently be set in this mode. Only registered phones will be able to open the door using NFC (see registration mode). A login ID with a password is required to operate the door lock over the web service. Records of access are written inside the microcontroller’s log each time the door lock is operated which can be queried by accessing the web service.

## 4.3 Registration Mode

This is the mode to register or unregister a given smartphone. Upon entering this mode, a list of already registered smartphones will be shown on the LCD. Using the arrow keys on the keypad, the user can navigate through registered phones and press a designated “clear” button to delete it from the list. Upon pressing a designated “new” button, the LCD will display “contact smartphone on the door lock to register”, indicating that the door lock is ready to register a new phone. When the phone is in contact with the reader in this instance, NFC communication is initiated and the phone is successfully registered into the door lock.

## 4.4 Configuration Mode

Settings for the Smart Doorlock can be adjusted in this mode. There are several configurations to adjust from:

- Door lock operation: NFC / Web Service / Both Default setting is NFC. To enable web service access, Smart Doorlock must be configured in advance to ensure proper connectivity with the access point (see IoT settings below).
- Enable / Disable Lockdown Mode When lockdown mode is initiated, operating the door lock via NFC or web service is entirely forbidden. Intended for emergent cases only.
- IoT settings In order for the IoT functionality to work, Smart Doorlock must be connected to an active AP. Due to the complexity of configuring the AP connection using the keypad, all settings must be entered in the application of smartphone, then the settings will be transferred via NFC. A confirmation message will be displayed on the LCD upon the transmission of settings. The following IoT settings are available:
  - Set / Reset admin password
  - Configure AP settings (SSID, Password, DHCP/Static IP)

## 4.5 Web Service

Upon successfully configuring AP, the door lock will automatically be added to a list of devices in the web server in order to maintain the connection. At any point the connection is lost (based on the keep alive interval set in the protocol), the door lock is automatically removed from the web server’s list. As long as the connection is maintained, users can access the web service using a browser to control the door lock. The following is a list of functionalities offered by the web service:

- Open / Lock door lock
- Lockdown Mode
- Create / Modify / Delete web service accounts
- View / Clear entry logs

# 5. Design

## 5.1 Platform and Dependencies

## 5.2 Block Diagram

The following is a functional block diagram of Smart Doorlock. The diagram shows the relationship between each electronic components and the method of interface between hardware and software.

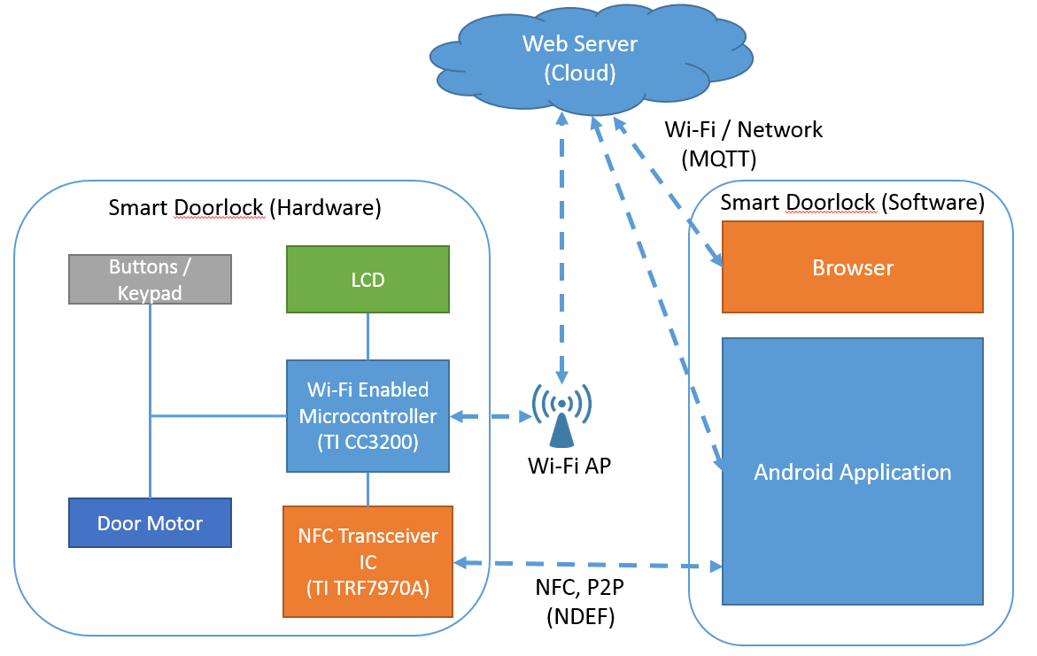
[picture p26: figure]

Figure 4.2: Functional block diagram of Smart Doorlock

## 5.3 High-Level Design (Microcontroller)

## 5.4 UML Flowchart(Microcontroller)

## 5.5 High-Level Design (Web Server)

## 5.6 UML Flowchart(Web Server)

## 5.7 High-Level Design (Android)

## 5.8 UML Flowchart(Android)

## 5.9 Database Schema

## 5.10 Schematic Diagram

The following is a schematic diagram of the hardware part of Smart Doorlock.

## 5.11 Development Plan

To ensure the project can be successfully completed, the project will take the following phases of development:

Phase | Content | Estimated date of completion
1 | Design the case and any related mechanic parts using Solidworks | August 15, 2016
2 | Build a prototype of the hardware with only microcontroller and NFC Transceiver IC connected. Ensure the microcontroller is able to utilize NFC communication by reading and writing to a simple tag. | August 22, 2016
3 | Connect LCD, Keypad and door servo. Test their basic functionalities. Begin coding logic for active / registration mode of the phone. | September 5, 2016
4 | Begin developing android application, switch NFC Transceiver IC from tag mode to P2P mode. Ensure P2P communication via NDEF protocol works as intended. Test that phone registration and door lock activation via NFC works without any issue. | September 19, 2016
5 | Begin writing logic for MQTT server on microcontroller’s side. Ensure MQTT protocol works as intended by directly performing test calls from a browser connected to the same AP. | October 3, 2016
6 | Begin developing web server for the cloud. Ensure the communication works when the calls to control APIs are invoked outside the network microcontroller is connected in. | October 17, 2016
7 | Design UI for android application, browser and build a case for the door lock. Assemble the final product. | November 7, 2016
8 | Stress test the final product | December 5, 2016

# 6. Testing

# 7. Packaging

# 8. Project Cost

## 8.1 Preliminary Cost Analysis

The following table is an estimation of the total project cost. All figures are in US dollars.

Type | Part name | Cost ($, USD)
Microcontroller | Texas Instruments CC3200 | 16.78
Microcontroller development board | Texas Instruments CC3200 LaunchPad | 29.99
NFC transceiver IC | Texas Instruments TRF7970A | 6.98
NFC transceiver IC development kit | Texas Instruments TRF7970A booster pack | 24.99
Keypad | Storm 720GFXI Series (7207-121W20) | 39.14
LCD | Electronic Assembly EADIP203G-4NLED LCD | 30.32
Total | | 145.20

The figure includes the parts needed for development as well (CC3200 LaunchPad and TRF7970A booster pack). Excluding parts necessary for development, the actual total of the final product is estimated to be $90.22 USD. The figure also excludes any labor fee that may occur.

## 8.2 Funding Source

A total amount of $250 from Volpi Cupal fund will be used to cover for the expenses of the project.

# 7. Other Considerations

## 7.1 Security

# 8. Lessons Learned

# 9. Source Code

## 9.1 Microcontroller (C language)

main.c

/*

* Smart Doorlock

* main.c

*

* Created on: 2016. 8. 27.

*

* Author: Sokwhan Huh

*/

// C-Library includes

#include <string.h>

// Driverlib includes

#include "rom.h"

#include "rom_map.h"

#include "hw_memmap.h"

#include "hw_common_reg.h"

#include "hw_types.h"

#include "hw_ints.h"

#include "uart.h"

#include "interrupt.h"

#include "pinmux.h"

#include "utils.h"

#include "prcm.h"

#include "simplelink.h"

#include "gpio.h"

// Common interface include

#include "common.h"

#include "uart_if.h"

#include "gpio_if.h"

// Project includes

#include "sd_globals.h"

#include "network.h"

#include "keypad.h"

#include "lcd.h"

#include "nfc.h"

#include "mqtt_client.h"

#include "spi_l.h"

#include "s_flash.h"

#include "menu.h"

#include "mcu.h"

#define APP_NAME "Smart Doorlock"

//RTOS Related Defines

#define OSI_STACK_SIZE 4096 /* 2048 */

#define SPAWN_TASK_PRIORITY 9

//SD Related Defines

#define DOORLOCK_OPEN_DELAY 4000

#define PHONE_REGISTER_DELAY 6000

#define MENU_NAVIGATE_DELAY 110

#define BUZZER_DELAY 55

//Globals

unsigned int g_firstTimeSetup;

unsigned int g_appMode;

unsigned int g_currMenuOption;

static unsigned int g_nfcFirstTimeSetup = 0;

//Function Prototypes

static void SmartDoorlockNFCTask(void *pvParameters);

static void SmartDoorlockMenuTask(void *pvParameters);

static void SmartDoorlockInitTask(void *pvParameters);

static void DisplayBanner(char * AppName)

{

Report("\n\n\n\r");

Report("\t\t *************************************************\n\r");

Report("\t\t %s \n\r", AppName);

Report("\t\t *************************************************\n\r");

Report("\n\n\n\r");

}

static void BoardInit(void)

{

// Enable Processor

MAP_IntMasterEnable();

MAP_IntEnable(FAULT_SYSTICK);

PRCMCC3200MCUInit();

}

static void SoundBuzzer(unsigned int count) {

unsigned int i;

for (i = 0; i < count; i++) {

GPIO_IF_Set(PIN_BUZZER,1);

osi_Sleep(BUZZER_DELAY);

GPIO_IF_Set(PIN_BUZZER,0);

osi_Sleep(BUZZER_DELAY);

}

GPIO_IF_Set(PIN_BUZZER,0);

}

static void OpenDoor(unsigned char *logMsg) {

Report("Opening Doorlock\n\r");

SmartDoorlockLCDDisplay(LCD_DISP_OPENING_DOOR);

if (g_ConfigData.operationMode != OPER_NFC_ONLY) {

MqttPublishLockAccess(logMsg);

}

g_appMode = MODE_OPENING_DOOR;

GPIO_IF_Set(13,1);

SoundBuzzer(1);

osi_Sleep(DOORLOCK_OPEN_DELAY);

GPIO_IF_Set(13,0);

g_appMode = MODE_ACTIVE;

SmartDoorlockLCDDisplay(LCD_DISP_ACTIVE);

Report("Closing Doorlock\n\r");

}

static void RebootSmartDoorlock() {

g_appMode = MODE_EXIT;

Report("Disconnecting from MQTT/AP\n\r");

/* Mqtt_ClientExit();

Network_IF_DisconnectFromAP();

Network_IF_DeInitDriver();*/

SmartDoorlockLCDDisplay(LCD_DISP_REBOOTING);

osi_Sleep(2000);

RebootMCU();

Report("Rebooting");

}

static void RegisterNewPhone() {

g_appMode = MODE_REGISTERING_PHONE;

SmartDoorlockLCDDisplay(LCD_DISP_REGISTERING_PHONE);

Report("Register Phone\n\r");

strcpy(g_ConfigData.doorlockPhoneId[g_ConfigData.regDoorlockCount],nfcCmdPayload);

strcpy(g_ConfigData.doorlockRegDate[g_ConfigData.regDoorlockCount],nfcCmdPayload2);

Report("Writing Phone ID: %s\n\r",g_ConfigData.doorlockPhoneId[g_ConfigData.regDoorlockCount]);

Report("Date: %s\n\r",g_ConfigData.doorlockRegDate[g_ConfigData.regDoorlockCount]);

g_ConfigData.regDoorlockCount++;

ManageConfigData(SF_WRITE_DATA_RECORD);

osi_Sleep(PHONE_REGISTER_DELAY);

if (g_firstTimeSetup) {

if (g_ConfigData.operationMode == OPER_NFC_ONLY) {

SmartDoorlockLCDDisplay(LCD_DISP_REBOOTING);

osi_Sleep(2000);

RebootMCU();

}

else {

SmartDoorlockLCDDisplay(LCD_DISP_WIFI_SETUP_NFC);

g_appMode = MODE_WIFI_CONFIG_NFC;

}

}

else {

SmartDoorlockLCDDisplay(LCD_DISP_REGISTER_ACTIVE);

g_appMode = MODE_REGISTER_ACTIVE;

}

}

static long IsPhoneIdRegistered(char *phoneId) {

int i;

Report("Received ID: %s\n\r",phoneId);

for (i = 0; i < g_ConfigData.regDoorlockCount; i++) {

Report("Comparing: %s\n\r",g_ConfigData.doorlockPhoneId[i]);

if (strcmp(phoneId,g_ConfigData.doorlockPhoneId[i]) == 0) {

return 1;

}

}

return 0;

}

static void NFCWifiConfig() {

g_appMode = MODE_REGISTERING_PHONE;

SmartDoorlockLCDDisplay(LCD_DISP_WIFI_SETUP_NFC_CONFIGURING);

Report("Wifi Config (NFC)\n\r");

strcpy(g_ConfigData.SSID,nfcCmdPayload);

strcpy(g_ConfigData.Password,nfcCmdPayload2);

Report("SSID: %s\n\r",g_ConfigData.SSID);

Report("Password: %s\n\r",g_ConfigData.Password);

ManageConfigData(SF_WRITE_DATA_RECORD);

osi_Sleep(3000);

SmartDoorlockLCDDisplay(LCD_DISP_REBOOTING);

osi_Sleep(2000);

RebootMCU();

}

static void SmartDoorlockMenuTask(void *pvParameters) {

if (g_firstTimeSetup) {

g_currMenuOption = MENU_OPERATION_SETUP;

MenuProcessConfig(ENTER);

}

while (g_firstTimeSetup) {

buttonEnum pressedBtn = getPressedButton();

if (g_appMode == MODE_REGISTER_ACTIVE && !g_nfcFirstTimeSetup) {

g_nfcFirstTimeSetup = 1;

// Start the SmartDoorlock NFC task

osi_TaskCreate( SmartDoorlockNFCTask,

(const signed char*)"Smart Doorlock NFCTask",

OSI_STACK_SIZE, NULL, 1, NULL );

}

MenuProcessConfigInner(pressedBtn);

osi_Sleep(MENU_NAVIGATE_DELAY);

}

while (g_appMode != MODE_INITIALIZE_COMPLETE) {

osi_Sleep(1);

}

g_currMenuOption = 0;

Report("Initializing Menu\n\r");

g_appMode = MODE_ACTIVE;

SmartDoorlockLCDDisplay(LCD_DISP_ACTIVE);

/*g_appMode = MODE_MENU;

MoveMenu(g_currMenuOption);*/

for (;;) {

if (g_appMode == MODE_EXIT) {

RebootSmartDoorlock();

return;

}

buttonEnum pressedBtn = getPressedButton();

if (g_appMode == MODE_MENU) {

MenuProcessMain(pressedBtn);

}

else if (g_appMode == MODE_ACTIVE) {

if (pressedBtn == CANCEL) {

g_appMode = MODE_MENU;

MoveMenu(g_currMenuOption);

}

}

else if (g_appMode == MODE_CONFIG) {

MenuProcessConfig(pressedBtn);

}

else if (g_appMode == MODE_REGISTER_ACTIVE ||

g_appMode == MODE_UNREGISTER_PHONE ||

g_appMode == MODE_OPERATION_SETUP ||

g_appMode == MODE_WIFI_CONFIG_NFC) {

MenuProcessConfigInner(pressedBtn);

}

osi_Sleep(MENU_NAVIGATE_DELAY);

}

}

static void SmartDoorlockNFCTask(void *pvParameters) {

// Init NFC hardware

Report("Initializing NFC\n\r");

NFCInit();

unsigned char logPayload[100];

if (!g_firstTimeSetup) {

g_appMode = MODE_INITIALIZE_COMPLETE;

}

for (;;) {

if (g_appMode == MODE_EXIT)

return;

if (g_appMode != MODE_ACTIVE && g_appMode != MODE_REGISTER_ACTIVE && g_appMode != MODE_WIFI_CONFIG_NFC) {

osi_Sleep(1);

continue;

}

nfcCmdEnum cmd = readNFCTag();

switch (cmd) {

case NFC_OPEN_DOORLOCK:

if (g_appMode == MODE_ACTIVE) {

if (IsPhoneIdRegistered(nfcCmdPayload)) {

memset(logPayload, 0, sizeof(logPayload));

strncpy((char*)logPayload, "LOG|NFC|", 8);

strncat((char*)logPayload, nfcCmdPayload, sizeof(nfcCmdPayload));

OpenDoor(logPayload);

}

else {

g_appMode = MODE_UNREGISTERED_PHONE_TAPPED;

SmartDoorlockLCDDisplay(LCD_DISP_UNREGISTERED_PHONE_TAPPED);

osi_Sleep(3000);

SmartDoorlockLCDDisplay(LCD_DISP_ACTIVE);

g_appMode = MODE_ACTIVE;

}

}

break;

case NFC_REG_PHONE:

if (g_appMode == MODE_REGISTER_ACTIVE) {

SoundBuzzer(1);

RegisterNewPhone();

}

break;

case NFC_WIFI_CONFIG:

if (g_appMode == MODE_WIFI_CONFIG_NFC) {

SoundBuzzer(1);

NFCWifiConfig();

}

break;

default:

break;

}

}

}

static void SmartDoorlockIoTTask(void *pvParameters) {

unsigned char logPayload[100];

while (g_appMode == MODE_INITIALIZING) {

osi_Sleep(1);

}

SmartDoorlockLCDDisplay(LCD_DISP_CONNECT_AP);

int retVal = ConnectAP(g_ConfigData.SSID, g_ConfigData.Password);

if (retVal != 0) {

SmartDoorlockLCDDisplay(LCD_DISP_AP_CONN_FAILURE);

g_ConfigData.operationMode = OPER_NFC_ONLY;

osi_Sleep(3000);

// Start the SmartDoorlock NFC task

osi_TaskCreate( SmartDoorlockNFCTask,

(const signed char*)"Smart Doorlock NFCTask",

OSI_STACK_SIZE, NULL, 1, NULL );

return;

}

Report("Connection Successful!\n\r");

retVal = initMqtt();

if (retVal != 0)

return;

osi_Sleep(100);

SmartDoorlockLCDDisplay(LCD_DISP_CONNECT_MQTT);

retVal = mqttConnect();

osi_Sleep(500);

if (retVal != 0) {

SmartDoorlockLCDDisplay(LCD_DISP_MQTT_CONN_FAILURE);

g_ConfigData.operationMode = OPER_NFC_ONLY;

osi_Sleep(3000);

// Start the SmartDoorlock NFC task

osi_TaskCreate( SmartDoorlockNFCTask,

(const signed char*)"Smart Doorlock NFCTask",

OSI_STACK_SIZE, NULL, 1, NULL );

return;

}

if (g_ConfigData.operationMode == OPER_NFC_IOT) {

// Start the SmartDoorlock NFC task

osi_TaskCreate( SmartDoorlockNFCTask,

(const signed char*)"Smart Doorlock NFCTask",

OSI_STACK_SIZE, NULL, 1, NULL );

}

else {

g_appMode = MODE_INITIALIZE_COMPLETE;

}

event_msg RecvQue;

for(;;)

{

if (g_appMode == MODE_EXIT)

return;

osi_MsgQRead( &g_PBQueue, &RecvQue, OSI_WAIT_FOREVER);

if (g_appMode != MODE_ACTIVE) {

Report("IoT Task: Msg received but not in active mode\n\r");

osi_Sleep(1);

continue;

}

if(BROKER_DISCONNECTION == RecvQue.event)

{

attemptReconnect();

}

if(DOORLOCK_OPEN == RecvQue.event)

{

if (g_appMode == MODE_OPENING_DOOR) {

Report("IoT Task: Doorlock is already being opened\n\r");

continue;

}

memset(logPayload, 0, sizeof(logPayload));

strncpy((char*)logPayload, "LOG|IOT|SmartDoorlock", 21);

OpenDoor(logPayload);

}

}

}

static void SmartDoorlockInitTask(void *pvParameters) {

// Init LCD

lcdInit();

lcdClearScreen();

SmartDoorlockLCDDisplay(LCD_DISP_INIT);

SoundBuzzer(3);

//Initialize simplelink

long lMode = sl_Start(0, 0, 0);

ASSERT_ON_ERROR(lMode);

//ManageConfigData(SF_DELETE_DATA_RECORD);

if (ManageConfigData(SF_TEST_DATA_RECORD) < 0) {

ManageConfigData(SF_CREATE_DATA_RECORD);

g_firstTimeSetup = 1;

g_appMode = MODE_OPERATION_SETUP;

osi_Sleep(1000);

SmartDoorlockLCDDisplay(LCD_DISP_FIRST_TIME_SETUP);

osi_Sleep(4000);

// Start the Menu task

osi_TaskCreate( SmartDoorlockMenuTask,

(const signed char*)"MenuTask",

OSI_STACK_SIZE, NULL, 1, NULL );

return;

}

else {

ManageConfigData(SF_READ_DATA_RECORD);

g_firstTimeSetup = 0;

// Start the Menu task

osi_TaskCreate( SmartDoorlockMenuTask,

(const signed char*)"MenuTask",

OSI_STACK_SIZE, NULL, 1, NULL );

}

if (g_ConfigData.operationMode == OPER_NFC_IOT || g_ConfigData.operationMode == OPER_IOT_ONLY) {

g_appMode = MODE_INITIALIZING_IOT;

// Start the SmartDoorlock IoT task

osi_MsgQCreate(&g_PBQueue,"PBQueue",sizeof(event_msg),10);

osi_TaskCreate( SmartDoorlockIoTTask,

(const signed char*)"Smart Doorlock IoTTask",

OSI_STACK_SIZE, NULL, 1, NULL );

}

else {

g_appMode = MODE_INITIALIZING_NFC;

// Start the SmartDoorlock NFC task

osi_TaskCreate( SmartDoorlockNFCTask,

(const signed char*)"Smart Doorlock NFCTask",

OSI_STACK_SIZE, NULL, 1, NULL );

}

}

int main(void) {

// Initailizing the board

BoardInit();

// Muxing for Enabling GPIO, UART_TX and UART_RX.

PinMuxConfig();

// Init SPI

SPIInit();

// Init Terminal

InitTerm();

ClearTerm();

DisplayBanner(APP_NAME);

GPIO_IF_Set(PIN_BUZZER,0);

//Start the simplelink host

VStartSimpleLinkSpawnTask(SPAWN_TASK_PRIORITY);

//Set app mode to initializing

g_appMode = MODE_INITIALIZING;

// Start the SmartDoorlock Initialization Task

osi_TaskCreate( SmartDoorlockInitTask,

(const signed char*)"Smart Doorlock InitTask",

OSI_STACK_SIZE, NULL, 1, NULL );

osi_start();

return 0;

}

sd_globals.h

/*

* sd_globals.h

*

* Created on: Oct 31, 2016

* Author: shuh

*/

#ifndef SD_GLOBALS_H_

#define SD_GLOBALS_H_

typedef enum

{

MODE_INITIALIZING,

MODE_INITIALIZING_IOT,

MODE_INITIALIZING_NFC,

MODE_INITIALIZE_COMPLETE,

MODE_MENU,

MODE_ACTIVE,

MODE_CONFIG,

MODE_OPENING_DOOR,

MODE_OPERATION_SETUP_FIRST,

MODE_OPERATION_SETUP,

MODE_REGISTER_ACTIVE,

MODE_REGISTERING_PHONE,

MODE_UNREGISTERED_PHONE_TAPPED,

MODE_UNREGISTER_PHONE,

MODE_WIFI_TEST,

MODE_WIFI_CONFIG_NFC,

MODE_EXIT

} appModeEnum;

typedef enum

{

MENU_ACTIVE,

MENU_CONFIG,

MENU_REBOOT

} appMenuEnum;

typedef enum

{

MENU_OPERATION_SETUP,

MENU_REGISTER_PHONE,

MENU_UNREGISTER_PHONE,

MENU_WIFI_CONFIG,

MENU_WIFI_TEST,

MENU_FACTORY_RESET

} configMenuEnum;

typedef enum

{

OPER_NFC_ONLY,

OPER_IOT_ONLY,

OPER_NFC_IOT,

OPER_NOT_SET

} operEnum;

//Globals

extern unsigned int g_appMode;

extern unsigned int g_currMenuOption;

extern unsigned int g_firstTimeSetup;

#endif /* SD_GLOBALS_H_ */

mcu.h

/*

* mcu.h

*

* Created on: Oct 31, 2016

* Author: shuh

*/

#ifndef MCU_H_

#define MCU_H_

extern void RebootMCU();

#endif /* MCU_H_ */

mcu.c

/*

* mcu.c

*

* Created on: Oct 31, 2016

* Author: shuh

*/

#include "rom.h"

#include "rom_map.h"

#include "hw_memmap.h"

#include "hw_common_reg.h"

#include "hw_types.h"

#include "hw_ints.h"

#include "prcm.h"

void RebootMCU() {

sl_Stop(30);

MAP_PRCMHibernateIntervalSet(330);

MAP_PRCMHibernateWakeupSourceEnable(PRCM_HIB_SLOW_CLK_CTR);

MAP_PRCMHibernateEnter();

}

gpio_if.h

/*

* gpio_if.h

*

* Created on: 2016. 9. 7.

* Author: Sokwhan

*/

#ifndef __GPIOIF_H__

#define __GPIOIF_H__

//GPIO # Definitions

typedef enum

{

PIN_LCD_RS = 0, //4 RS (CS) H / L H=Data, L=Command

PIN_LCD_RW = 3, //5 R/W (SID) H / L H=Read, L=Write

PIN_LCD_E = 4, //6 E (SCLK) H Enable (falling edge)

PIN_LCD_D0 = 5, //7 D0 (SOD) H / L Display Data, LSB

PIN_LCD_D1 = 6, //8 D1 H / L Display Data

PIN_LCD_D2 = 7, //9 D2 H / L Display Data

PIN_LCD_D3 = 8, //10 D3 H / L Display Data

PIN_LCD_D4 = 9, //11 D4 (D0) H / L Display Data

PIN_LCD_D5 = 10, //12 D5 (D1) H / L Display Data

PIN_LCD_D6 = 11, //13 D6 (D2) H / L Display Data

PIN_LCD_D7 = 12 //14 D7 (D3) H / L Display Data, MSB

} lcdPinEnum;

typedef enum

{

PIN_KEYPAD_B1 = 3,

PIN_KEYPAD_B2 = 4,

PIN_KEYPAD_B3 = 5,

PIN_KEYPAD_B4 = 6,

} keypadPinEnum;

#define PIN_BUZZER 8

//*****************************************************************************

//

// API Function prototypes

//

//*****************************************************************************

extern void GPIO_IF_GetPortNPin(unsigned char ucPin,

unsigned int *puiGPIOPort,

unsigned char *pucGPIOPin);

extern void GPIO_IF_ConfigureNIntEnable(unsigned int uiGPIOPort,

unsigned char ucGPIOPin,

unsigned int uiIntType,

void (*pfnIntHandler)(void));

extern void GPIO_IF_Set(unsigned int gpioNum, unsigned int state);

extern void GPIO_IF_Toggle(unsigned int gpioNum);

extern unsigned char GPIO_IF_GetVal(unsigned char ucPin,

unsigned int uiGPIOPort,

unsigned char ucGPIOPin);

static void GPIO_IF_SetVal(unsigned char ucPin,

unsigned int uiGPIOPort,

unsigned char ucGPIOPin,

unsigned char ucGPIOValue);

extern void GPIO_Set(unsigned char ucGPIONum);

extern void GPIO_Clear(unsigned char ucGPIONum);

extern void GPIO_Toggle(unsigned char ucGPIONum);

extern unsigned char GPIO_IF_Get(unsigned int gpioNum);

void GPIOIntInit( unsigned long ulPort,

unsigned char ucPin,

unsigned long ulInterrupt,

void (*pfnHandler)(void),

unsigned long ulIntType,

unsigned char ucPriority);

void GPIOs3IntHandler(void);

//*****************************************************************************

//

// Mark the end of the C bindings section for C++ compilers.

//

//*****************************************************************************

#ifdef __cplusplus

}

#endif

#endif // __GPIOIF_H__

gpio_if.c

/*

* gpio_if.c

*

* Created on: 2016. 9. 7.

* Author: Sokwhan

*/

#include <stdio.h>

#include "hw_types.h"

#include "hw_ints.h"

#include "hw_memmap.h"

#include "interrupt.h"

#include "pin.h"

#include "gpio.h"

#include "hw_apps_rcm.h"

#include "prcm.h"

#include "rom.h"

#include "rom_map.h"

#include "gpio_if.h"

//****************************************************************************

// GLOBAL VARIABLES

//****************************************************************************

static unsigned long ulReg[]=

{

GPIOA0_BASE,

GPIOA1_BASE,

GPIOA2_BASE,

GPIOA3_BASE

};

//****************************************************************************

// LOCAL FUNCTION DEFINITIONS

//****************************************************************************

void

GPIO_IF_Set(unsigned int gpioNum, unsigned int state) {

unsigned int portNum = 0;

unsigned char pinNum;

GPIO_IF_GetPortNPin(gpioNum,

&portNum,

&pinNum);

GPIO_IF_SetVal(gpioNum, portNum, pinNum, state);

}

void

GPIO_IF_Toggle(unsigned int gpioNum) {

unsigned int portNum = 0;

unsigned char pinNum;

unsigned int portStatus;

GPIO_IF_GetPortNPin(gpioNum,

&portNum,

&pinNum);

portStatus = !GPIO_IF_GetVal(gpioNum, portNum, pinNum);

GPIO_IF_SetVal(gpioNum, portNum, pinNum, portStatus);

}

unsigned char

GPIO_IF_Get(unsigned int gpioNum) {

unsigned int portNum = 0;

unsigned char pinNum;

GPIO_IF_GetPortNPin(gpioNum,

&portNum,

&pinNum);

return GPIO_IF_GetVal(gpioNum, portNum, pinNum);

}

//****************************************************************************

//

//! Get the port and pin of a given GPIO

//!

//! \param ucPin is the pin to be set-up as a GPIO (0:39)

//! \param puiGPIOPort is the pointer to store GPIO port address return value

//! \param pucGPIOPin is the pointer to store GPIO pin return value

//!

//! This function

//! 1. Return the GPIO port address and pin for a given external pin number

//!

//! \return None.

//

//****************************************************************************

void

GPIO_IF_GetPortNPin(unsigned char ucPin,

unsigned int *puiGPIOPort,

unsigned char *pucGPIOPin)

{

//

// Get the GPIO pin from the external Pin number

//

*pucGPIOPin = 1 << (ucPin % 8);

//

// Get the GPIO port from the external Pin number

//

*puiGPIOPort = (ucPin / 8);

*puiGPIOPort = ulReg[*puiGPIOPort];

}

//****************************************************************************

//

//! Configures the GPIO selected as input to generate interrupt on activity

//!

//! \param uiGPIOPort is the GPIO port address

//! \param ucGPIOPin is the GPIO pin of the specified port

//! \param uiIntType is the type of the interrupt (refer gpio.h)

//! \param pfnIntHandler is the interrupt handler to register

//!

//! This function

//! 1. Sets GPIO interrupt type

//! 2. Registers Interrupt handler

//! 3. Enables Interrupt

//!

//! \return None

//

//****************************************************************************

void

GPIO_IF_ConfigureNIntEnable(unsigned int uiGPIOPort,

unsigned char ucGPIOPin,

unsigned int uiIntType,

void (*pfnIntHandler)(void))

{

//

// Set GPIO interrupt type

//

MAP_GPIOIntTypeSet(uiGPIOPort,ucGPIOPin,uiIntType);

//

// Register Interrupt handler

//

MAP_GPIOIntRegister(uiGPIOPort,pfnIntHandler);

//

// Enable Interrupt

//

MAP_GPIOIntClear(uiGPIOPort,ucGPIOPin);

MAP_GPIOIntEnable(uiGPIOPort,ucGPIOPin);

}

//****************************************************************************

//

//! Set a value to the specified GPIO pin

//!

//! \param ucPin is the GPIO pin to be set (0:39)

//! \param uiGPIOPort is the GPIO port address

//! \param ucGPIOPin is the GPIO pin of the specified port

//! \param ucGPIOValue is the value to be set

//!

//! This function

//! 1. Sets a value to the specified GPIO pin

//!

//! \return None.

//

//****************************************************************************

static void

GPIO_IF_SetVal(unsigned char ucPin,

unsigned int uiGPIOPort,

unsigned char ucGPIOPin,

unsigned char ucGPIOValue)

{

//

// Set the corresponding bit in the bitmask

//

ucGPIOValue = ucGPIOValue << (ucPin % 8);

//

// Invoke the API to set the value

//

MAP_GPIOPinWrite(uiGPIOPort,ucGPIOPin,ucGPIOValue);

}

//****************************************************************************

//

//! Set a value to the specified GPIO pin

//!

//! \param ucPin is the GPIO pin to be set (0:39)

//! \param uiGPIOPort is the GPIO port address

//! \param ucGPIOPin is the GPIO pin of the specified port

//!

//! This function

//! 1. Gets a value of the specified GPIO pin

//!

//! \return value of the GPIO pin

//

//****************************************************************************

unsigned char

GPIO_IF_GetVal(unsigned char ucPin,

unsigned int uiGPIOPort,

unsigned char ucGPIOPin)

{

unsigned char ucGPIOValue;

long lGPIOStatus;

//

// Invoke the API to Get the value

//

lGPIOStatus = MAP_GPIOPinRead(uiGPIOPort,ucGPIOPin);

//

// Set the corresponding bit in the bitmask

//

ucGPIOValue = lGPIOStatus >> (ucPin % 8);

return ucGPIOValue;

}

void GPIOIntInit(unsigned long ulPort, unsigned char ucPin, unsigned long ulInterrupt, void (*pfnHandler)(void), unsigned long ulIntType, unsigned char ucPriority) {

IntRegister(ulInterrupt, pfnHandler);

IntPrioritySet(ulInterrupt, INT_PRIORITY_LVL_1);

GPIOIntTypeSet(ulPort,ucPin,ulIntType);

GPIOIntClear(ulPort,0xFF);

GPIOIntEnable(ulPort,ucPin);

IntEnable(ulInterrupt);

}

keypad.h

/*

* keypad.h

*

* Created on: Sep 23, 2016

* Author: shuh

*/

#ifndef KEYPAD_H_

#define KEYPAD_H_

#define MAX_KEYPAD_ROWS 4

typedef enum

{

NONE = 0,

UP_ARROW = 1,

LEFT_ARROW = 2,

DOWN_ARROW = 3,

RIGHT_ARROW = 4,

ENTER = 5,

CANCEL = 6

} buttonEnum;

extern buttonEnum getPressedButton();

#endif /* KEYPAD_H_ */

keypad.c

/*

* keypad.c

*

* Created on: Sep 23, 2016

* Author: shuh

*/

#include "keypad.h"

#include "gpio_if.h"

buttonEnum getPressedButton() {

if (GPIO_IF_Get(PIN_KEYPAD_B1) == 0)

return CANCEL;

if (GPIO_IF_Get(PIN_KEYPAD_B2) == 0)

return ENTER;

if (GPIO_IF_Get(PIN_KEYPAD_B3) == 0)

return DOWN_ARROW;

if (GPIO_IF_Get(PIN_KEYPAD_B4) == 0)

return UP_ARROW;

return NONE;

}

lcd.h

/*

* lcd.h

*

* Created on: Sep 23, 2016

* Author: shuh

*/

#ifndef LCD_H_

#define LCD_H_

typedef enum

{

LCD_DISP_INIT,

LCD_DISP_CONNECT_AP,

LCD_DISP_CONNECT_MQTT,

LCD_DISP_ACTIVE,

LCD_DISP_REGISTER_ACTIVE,

LCD_DISP_OPENING_DOOR,

LCD_DISP_UNREGISTERED_PHONE_TAPPED,

LCD_DISP_REGISTERING_PHONE,

LCD_DISP_EXITING_APP,

LCD_DISP_NFC_DISABLED,

LCD_DISP_NO_PHONE_REGISTERED,

LCD_DISP_FACTORY_RESET,

LCD_DISP_REBOOTING,

LCD_DISP_UNREGISTER_PHONE_SUCCESS,

LCD_DISP_FIRST_TIME_SETUP,

LCD_DISP_WIFI_SETUP_NFC,

LCD_DISP_WIFI_SETUP_NFC_CONFIGURING,

LCD_DISP_IOT_DISABLED,

LCD_DISP_AP_CONN_FAILURE,

LCD_DISP_MQTT_CONN_FAILURE,

LCD_DISP_WIFI_TEST_LAN,

LCD_DISP_WIFI_TEST_MQTT_BROKER,

LCD_DISP_WIFI_TEST_PASS

} sdLcdEnum;

extern void lcdInit();

extern void lcdClearScreen(void);

extern void lcdPutString(unsigned char* str);

extern void lcdPutChar(unsigned char lcdChar);

extern void lcdSetPosition(unsigned int position);

extern void SmartDoorlockLCDDisplay(sdLcdEnum lcdEnum);

#endif /* LCD_H_ */

lcd.c

/*

* lcd.c

*

* Created on: Sep 23, 2016

* Author: shuh

*/

// Driverlib includes

#include "rom_map.h"

#include "hw_memmap.h"

#include "hw_types.h"

#include "prcm.h"

#include "simplelink.h"

#include "uart.h"

// Common Interface Includes

#include "uart_if.h"

//Project includes

#include "sd_globals.h"

#include "lcd.h"

#include "s_flash.h"

#define LCD_LINE1 0

#define LCD_LINE2 0x40

#define LCD_LINE3 0x14

#define LCD_LINE4 0x54

typedef enum

{

LCD_INIT,

CLEAR_SCREEN

} lcdCommandEnum;

static void lcdPutCommand(lcdCommandEnum cmdType) {

switch (cmdType) {

case CLEAR_SCREEN:

MAP_UARTCharPut(UARTA1_BASE,0xFE);

MAP_UARTCharPut(UARTA1_BASE,0x51);

break;

case LCD_INIT:

MAP_UARTConfigSetExpClk(UARTA1_BASE,MAP_PRCMPeripheralClockGet(CONSOLE_PERIPH),

9600, (UART_CONFIG_WLEN_8 | UART_CONFIG_STOP_ONE |

UART_CONFIG_PAR_NONE));

osi_Sleep(5);

MAP_UARTCharPut(UARTA1_BASE,0xFE);

MAP_UARTCharPut(UARTA1_BASE,0x41);

break;

}

}

void lcdSetPosition(unsigned int position) {

if (position < 1 || position > 4)

return;

MAP_UARTCharPut(UARTA1_BASE,0xFE);

MAP_UARTCharPut(UARTA1_BASE,0x45);

switch (position) {

case 1:

MAP_UARTCharPut(UARTA1_BASE,LCD_LINE1);

break;

case 2:

MAP_UARTCharPut(UARTA1_BASE,LCD_LINE2);

break;

case 3:

MAP_UARTCharPut(UARTA1_BASE,LCD_LINE3);

break;

case 4:

MAP_UARTCharPut(UARTA1_BASE,LCD_LINE4);

break;

}

}

void lcdClearScreen(void) {

lcdPutCommand(CLEAR_SCREEN);

osi_Sleep(4);

}

void lcdInit(void) {

lcdPutCommand(LCD_INIT);

osi_Sleep(1);

}

void lcdPutChar(unsigned char lcdChar) {

MAP_UARTCharPut(UARTA1_BASE,lcdChar);

}

void lcdPutString(unsigned char* str) {

osi_Sleep(1);

do

{

lcdPutChar(*str++);

}

while(*str);

}

void SmartDoorlockLCDDisplay(sdLcdEnum lcdEnum) {

lcdClearScreen();

switch (lcdEnum) {

case LCD_DISP_INIT:

lcdPutString("Smart Doorlock");

lcdSetPosition(2);

lcdPutString("Initializing");

break;

case LCD_DISP_CONNECT_AP:

lcdPutString("Smart Doorlock");

lcdSetPosition(2);

lcdPutString("Connecting to AP...");

lcdSetPosition(3);

lcdPutString("SSID: ");

lcdPutString((unsigned char*)g_ConfigData.SSID);

break;

case LCD_DISP_CONNECT_MQTT:

lcdPutString("Smart Doorlock");

lcdSetPosition(2);

lcdPutString("Connecting to");

lcdSetPosition(3);

lcdPutString("MQTT Broker...");

break;

case LCD_DISP_ACTIVE:

lcdPutString("Smart Doorlock");

lcdSetPosition(2);

switch (g_ConfigData.operationMode) {

case OPER_NFC_IOT:

lcdPutString("NFC / IoT Ready");

break;

case OPER_NFC_ONLY:

lcdPutString("NFC Ready");

break;

case OPER_IOT_ONLY:

lcdPutString("IoT Ready");

break;

}

break;

case LCD_DISP_OPENING_DOOR:

lcdPutString("Smart Doorlock");

lcdSetPosition(2);

lcdPutString("Opening Door...");

break;

case LCD_DISP_NFC_DISABLED:

lcdPutString("NFC is disabled");

lcdSetPosition(2);

lcdPutString("Please enable NFC");

lcdSetPosition(3);

lcdPutString("From Oper. Setup");

break;

case LCD_DISP_UNREGISTERED_PHONE_TAPPED:

lcdPutString("Smart Doorlock");

lcdSetPosition(2);

lcdPutString("Unregister Phone");

break;

case LCD_DISP_EXITING_APP:

lcdPutString("Smart Doorlock");

lcdSetPosition(2);

lcdPutString("Exiting App.");

break;

case LCD_DISP_REGISTERING_PHONE:

lcdPutString("Registering phone");

lcdSetPosition(3);

lcdPutString("Please remove phone");

lcdSetPosition(4);

lcdPutString("from the doorlock");

break;

case LCD_DISP_REGISTER_ACTIVE:

lcdPutString("Registering phone");

lcdSetPosition(3);

lcdPutString("Please place phone");

lcdSetPosition(4);

lcdPutString("on the doorlock");

break;

case LCD_DISP_NO_PHONE_REGISTERED:

lcdPutString("No Phone Registered");

break;

case LCD_DISP_FACTORY_RESET:

lcdPutString("Factory Resetting..");

lcdSetPosition(2);

lcdPutString("Please do not");

lcdSetPosition(3);

lcdPutString("turn off the power");

break;

case LCD_DISP_REBOOTING:

lcdPutString("Rebooting..");

lcdSetPosition(2);

lcdPutString("Please do not");

lcdSetPosition(3);

lcdPutString("turn off the power");

break;

case LCD_DISP_UNREGISTER_PHONE_SUCCESS:

lcdPutString("Phone Unregistered");

break;

case LCD_DISP_FIRST_TIME_SETUP:

lcdPutString("Welcome to");

lcdSetPosition(2);

lcdPutString("Smart Doorlock");

lcdSetPosition(3);

lcdPutString("We will walk you");

lcdSetPosition(4);

lcdPutString("Through Setup");

break;

case LCD_DISP_WIFI_SETUP_NFC:

lcdPutString("Wifi Config (NFC)");

lcdSetPosition(2);

lcdPutString("Select AP from");

lcdSetPosition(3);

lcdPutString("Android Application");

lcdSetPosition(4);

lcdPutString("Then tap phone");

break;

case LCD_DISP_IOT_DISABLED:

lcdPutString("IoT is disabled");

lcdSetPosition(2);

lcdPutString("Please enable IoT");

lcdSetPosition(3);

lcdPutString("From Oper. Setup");

break;

case LCD_DISP_WIFI_SETUP_NFC_CONFIGURING:

lcdPutString("Configuring Wi-Fi...");

lcdSetPosition(3);

lcdPutString("Please remove phone");

lcdSetPosition(4);

lcdPutString("from the doorlock");

break;

case LCD_DISP_AP_CONN_FAILURE:

lcdPutString("Failed to connect");

lcdSetPosition(2);

lcdPutString("to Access Point.");

lcdSetPosition(3);

lcdPutString("Please check your");

lcdSetPosition(4);

lcdPutString("Settings");

break;

case LCD_DISP_MQTT_CONN_FAILURE:

lcdPutString("Connection to MQTT");

lcdSetPosition(2);

lcdPutString("broker failed!");

break;

case LCD_DISP_WIFI_TEST_LAN:

lcdPutString("Testing Access Point");

lcdSetPosition(2);

lcdPutString("Connectivity...");

break;

case LCD_DISP_WIFI_TEST_MQTT_BROKER:

lcdPutString("Ping Testing");

lcdSetPosition(2);

lcdPutString("MQTT Broker...");

break;

case LCD_DISP_WIFI_TEST_PASS:

lcdPutString("Wi-Fi Testing");

lcdSetPosition(2);

lcdPutString("Successful");

lcdSetPosition(3);

lcdPutString("IoT is Available");

break;

}

}

menu.h

/*

* menu.h

*

* Created on: Oct 31, 2016

* Author: shuh

*/

#ifndef MENU_H_

#define MENU_H_

#include "keypad.h"

extern void MoveMenu(int menuOption);

extern void MoveConfigMenu(int menuOption);

extern void MenuProcessMain(buttonEnum pressedBtn);

extern void MenuProcessConfig(buttonEnum pressedBtn);

extern void MenuProcessConfigInner(buttonEnum pressedBtn);

#endif /* MENU_H_ */

menu.c

/*

* menu.c

*

* Created on: Oct 31, 2016

* Author: shuh

*/

// Driverlib includes

#include "simplelink.h"

//Standard Library Includes

#include <string.h>

#include <stdio.h>

//Project Includes

#include "s_flash.h"

#include "sd_globals.h"

#include "menu.h"

#include "lcd.h"

#include "mcu.h"

#include "network.h"

#define MENU_COUNT 3

#define CONFIG_MENU_COUNT 6

#define OPER_COUNT 3

static unsigned int innerMenuOption = 0;

const unsigned char *menuList[MENU_COUNT] = {

"Active",

"Configuration",

"Reboot"

};

const unsigned char *configMenuList[CONFIG_MENU_COUNT] = {

"Operation Setup",

"Register Phone",

"Unregister Phone",

"Setup Wifi",

"Test Wifi Conn.",

"Factory Reset"

};

const unsigned char *menuOperList[OPER_COUNT] = {

"NFC Only",

"IoT Only",

"NFC / IoT"

};

void MoveMenu(int menuOption) {

lcdClearScreen();

int i = 0;

for (i = 0; i < MENU_COUNT; i++) {

lcdSetPosition(i+1);

i == menuOption ? lcdPutChar('>') : lcdPutChar(' ');

lcdPutString((unsigned char*)menuList[i]);

}

}

void MoveConfigMenu(int menuOption) {

lcdClearScreen();

int i;

int menuIdx = 0;

int menuCount = 4;

if (menuOption >= 4) {

menuIdx = 4;

menuCount = CONFIG_MENU_COUNT - 4;

}

for (i = 0; i < menuCount; i++) {

lcdSetPosition(i+1);

i == (menuOption % 4) ? lcdPutChar('>') : lcdPutChar(' ');

lcdPutString((unsigned char*)configMenuList[menuIdx]);

menuIdx++;

}

}

void MoveUnregisterMenu(unsigned int phoneIdx) {

char phoneId[19];

sprintf(phoneId,"%u: ", phoneIdx+1);

char strippedId[16];

memcpy(strippedId, g_ConfigData.doorlockPhoneId[phoneIdx], sizeof(strippedId));

strncat(phoneId, strippedId, 16);

lcdClearScreen();

lcdPutString((unsigned char*)phoneId);

lcdSetPosition(2);

char date[16] = "Date: ";

char dateStripped[10];

memcpy(dateStripped, g_ConfigData.doorlockRegDate[phoneIdx], sizeof(dateStripped));

strncat(date, dateStripped, 10);

lcdPutString((unsigned char*)date);

lcdSetPosition(3);

lcdPutString("[Up/Down]: Select");

lcdSetPosition(4);

lcdPutString("[OK]: Delete");

}

void MoveOperMenu(unsigned int operMenu) {

lcdClearScreen();

switch (g_ConfigData.operationMode) {

case OPER_NFC_IOT:

lcdPutString("Current: NFC/IOT");

break;

case OPER_NFC_ONLY:

lcdPutString("Current: NFC Only");

break;

case OPER_IOT_ONLY:

lcdPutString("Current: IoT Only");

break;

case OPER_NOT_SET:

lcdPutString("Select Operation");

break;

}

int i;

for (i = 0; i < OPER_COUNT; i++) {

lcdSetPosition(i+2);

i == operMenu ? lcdPutChar('>') : lcdPutChar(' ');

lcdPutString((unsigned char*)menuOperList[i]);

}

}

static void FactoryReset() {

SmartDoorlockLCDDisplay(LCD_DISP_FACTORY_RESET);

ManageConfigData(SF_DELETE_DATA_RECORD);

osi_Sleep(2000);

RebootMCU();

}

static void SetOperationMode() {

g_ConfigData.operationMode = innerMenuOption;

ManageConfigData(SF_WRITE_DATA_RECORD);

if (g_firstTimeSetup) {

if (g_ConfigData.operationMode == OPER_NFC_IOT || g_ConfigData.operationMode == OPER_NFC_ONLY) {

g_appMode = MODE_REGISTER_ACTIVE;

g_currMenuOption = MENU_REGISTER_PHONE;

MenuProcessConfig(ENTER);

}

}

else {

SmartDoorlockLCDDisplay(LCD_DISP_REBOOTING);

osi_Sleep(2000);

RebootMCU();

}

}

static void UnregisterPhone(unsigned int phoneIdx) {

int i;

memset(g_ConfigData.doorlockPhoneId[phoneIdx], 0, sizeof(g_ConfigData.doorlockPhoneId[phoneIdx]));

memset(g_ConfigData.doorlockRegDate[phoneIdx], 0, sizeof(g_ConfigData.doorlockRegDate[phoneIdx]));

for (i = phoneIdx; i < g_ConfigData.regDoorlockCount-1; i++) {

strncpy(g_ConfigData.doorlockPhoneId[i], g_ConfigData.doorlockPhoneId[i+1], 40);

strncpy(g_ConfigData.doorlockRegDate[i], g_ConfigData.doorlockRegDate[i+1], 10);

}

g_ConfigData.regDoorlockCount--;

ManageConfigData(SF_WRITE_DATA_RECORD);

SmartDoorlockLCDDisplay(LCD_DISP_UNREGISTER_PHONE_SUCCESS);

osi_Sleep(1000);

}

void MenuProcessMain(buttonEnum pressedBtn) {

if (pressedBtn == UP_ARROW && g_currMenuOption > 0) {

g_currMenuOption--;

MoveMenu(g_currMenuOption);

}

else if (pressedBtn == DOWN_ARROW && g_currMenuOption < MENU_COUNT - 1) {

g_currMenuOption++;

MoveMenu(g_currMenuOption);

}

else if (pressedBtn == ENTER) {

if (g_currMenuOption == MENU_ACTIVE) {

g_appMode = MODE_ACTIVE;

SmartDoorlockLCDDisplay(LCD_DISP_ACTIVE);

}

else if (g_currMenuOption == MENU_CONFIG) {

g_appMode = MODE_CONFIG;

g_currMenuOption = MENU_OPERATION_SETUP;

MoveConfigMenu(g_currMenuOption);

}

else if (g_currMenuOption == MENU_REBOOT) {

SmartDoorlockLCDDisplay(LCD_DISP_EXITING_APP);

g_appMode = MODE_EXIT;

return;

}

}

}

void MenuProcessConfig(buttonEnum pressedBtn) {

if (pressedBtn == CANCEL) {

g_appMode = MODE_MENU;

g_currMenuOption = MENU_CONFIG;

MoveMenu(g_currMenuOption);

}

else if (pressedBtn == UP_ARROW && g_currMenuOption > 0) {

g_currMenuOption--;

MoveConfigMenu(g_currMenuOption);

}

else if (pressedBtn == DOWN_ARROW && g_currMenuOption < CONFIG_MENU_COUNT - 1) {

g_currMenuOption++;

MoveConfigMenu(g_currMenuOption);

}

else if (pressedBtn == ENTER) {

if (g_currMenuOption == MENU_REGISTER_PHONE) {

if (g_ConfigData.operationMode == OPER_IOT_ONLY) {

SmartDoorlockLCDDisplay(LCD_DISP_NFC_DISABLED);

osi_Sleep(1500);

MoveConfigMenu(g_currMenuOption);

}

else {

g_appMode = MODE_REGISTER_ACTIVE;

SmartDoorlockLCDDisplay(LCD_DISP_REGISTER_ACTIVE);

}

}

else if (g_currMenuOption == MENU_UNREGISTER_PHONE) {

if (g_ConfigData.regDoorlockCount == 0) {

SmartDoorlockLCDDisplay(LCD_DISP_NO_PHONE_REGISTERED);

osi_Sleep(1500);

MoveConfigMenu(g_currMenuOption);

return;

}

innerMenuOption = 0;

g_appMode = MODE_UNREGISTER_PHONE;

MoveUnregisterMenu(innerMenuOption);

}

else if (g_currMenuOption == MENU_WIFI_TEST) {

if (g_ConfigData.operationMode == OPER_NFC_ONLY) {

SmartDoorlockLCDDisplay(LCD_DISP_IOT_DISABLED);

osi_Sleep(2000);

MoveConfigMenu(g_currMenuOption);

return;

}

g_appMode = MODE_WIFI_TEST;

SmartDoorlockLCDDisplay(LCD_DISP_WIFI_TEST_LAN);

long lRetVal;

lRetVal = CheckLanConnection();

if (lRetVal < 0) {

SmartDoorlockLCDDisplay(LCD_DISP_AP_CONN_FAILURE);

osi_Sleep(2000);

g_appMode = MODE_CONFIG;

return;

}

SmartDoorlockLCDDisplay(LCD_DISP_WIFI_TEST_MQTT_BROKER);

lRetVal = CheckInternetConnection();

if (lRetVal < 0) {

SmartDoorlockLCDDisplay(LCD_DISP_MQTT_CONN_FAILURE);

osi_Sleep(2000);

g_appMode = MODE_CONFIG;

return;

}

SmartDoorlockLCDDisplay(LCD_DISP_WIFI_TEST_PASS);

osi_Sleep(2000);

g_appMode = MODE_CONFIG;

MoveConfigMenu(g_currMenuOption);

return;

}

else if (g_currMenuOption == MENU_FACTORY_RESET) {

FactoryReset();

return;

}

else if (g_currMenuOption == MENU_OPERATION_SETUP) {

g_appMode = MODE_OPERATION_SETUP;

if (g_firstTimeSetup)

innerMenuOption = OPER_NFC_ONLY;

else

innerMenuOption = g_ConfigData.operationMode;

MoveOperMenu(innerMenuOption);

}

else if (g_currMenuOption == MENU_WIFI_CONFIG) {

if (g_ConfigData.operationMode == OPER_NFC_ONLY) {

SmartDoorlockLCDDisplay(LCD_DISP_IOT_DISABLED);

osi_Sleep(2000);

MoveConfigMenu(g_currMenuOption);

}

else {

SmartDoorlockLCDDisplay(LCD_DISP_WIFI_SETUP_NFC);

g_appMode = MODE_WIFI_CONFIG_NFC;

}

}

}

}

void MenuProcessConfigInner(buttonEnum pressedBtn) {

if (!g_firstTimeSetup && pressedBtn == CANCEL) {

g_appMode = MODE_CONFIG;

MoveConfigMenu(g_currMenuOption);

return;

}

if (g_appMode == MODE_UNREGISTER_PHONE) {

if (pressedBtn == UP_ARROW) {

if (innerMenuOption > 0) {

innerMenuOption--;

}

MoveUnregisterMenu(innerMenuOption);

}

else if (pressedBtn == DOWN_ARROW) {

if (innerMenuOption < g_ConfigData.regDoorlockCount - 1) {

innerMenuOption++;

}

MoveUnregisterMenu(innerMenuOption);

}

else if (pressedBtn == ENTER) {

UnregisterPhone(innerMenuOption);

if (g_ConfigData.regDoorlockCount > 0) {

innerMenuOption = 0;

MoveUnregisterMenu(innerMenuOption);

}

else {

g_appMode = MODE_CONFIG;

MoveConfigMenu(g_currMenuOption);

}

}

return;

}

if (g_appMode == MODE_OPERATION_SETUP) {

if (pressedBtn == UP_ARROW) {

if (innerMenuOption > 0) {

innerMenuOption--;

}

MoveOperMenu(innerMenuOption);

}

else if (pressedBtn == DOWN_ARROW) {

if (innerMenuOption < OPER_COUNT - 1) {

innerMenuOption++;

}

MoveOperMenu(innerMenuOption);

}

else if (pressedBtn == ENTER) {

SetOperationMode();

}

return;

}

}

mqtt_client.h

/*

* mqtt_client.h

*

* Created on: Sep 26, 2016

* Author: shuh

*/

#ifndef MQTT_CLIENT_H_

#define MQTT_CLIENT_H_

typedef enum

{

BROKER_DISCONNECTION,

DOORLOCK_OPEN

}events;

typedef struct

{

void * hndl;

events event;

}event_msg;

extern int initMqtt();

extern int mqttConnect();

extern int attemptReconnect();

extern void Mqtt_ClientExit();

extern void MqttPublishLockAccess(unsigned char *data);

extern OsiMsgQ_t g_PBQueue;

#endif /* MQTT_CLIENT_H_ */

mqtt_client.c

/*

* mqtt_client.c

*

* Created on: Sep 26, 2016

* Author: shuh

*/

// Standard includes

#include <stdlib.h>

// Common Interface Includes

#include "common.h"

#include "sl_mqtt_client.h"

#include "uart_if.h"

#include "network.h"

// Project Includes

#include "mqtt_client.h"

/*Operate Lib in MQTT 3.1 mode.*/

#define MQTT_3_1_1 false /*MQTT 3.1.1 */

#define MQTT_3_1 true /*MQTT 3.1*/

#define WILL_TOPIC "Client"

#define WILL_MSG "Client Stopped"

#define WILL_QOS QOS2

#define WILL_RETAIN false

/*Background receive task priority*/

#define TASK_PRIORITY 3

#define UART_PRINT Report

/*Defining Number of topics*/

#define TOPIC_COUNT 1

/* Keep Alive Timer value*/

#define KEEP_ALIVE_TIMER 25

/*Retain Flag. Used in publish message. */

#define RETAIN 1

/*Defining Broker IP address and port Number*/

#define SERVER_ADDRESS "54.210.38.182"

//#define SERVER_ADDRESS "192.168.2.2"

#define PORT_NUMBER 1883

#define SERVER_MODE MQTT_3_1

/*Specifying Receive time out for the Receive task*/

#define RCV_TIMEOUT 30

/*Defining QOS levels*/

#define QOS0 0

#define QOS1 1

#define QOS2 2

/*Defining Subscription Topic Values*/

#define TOPIC_DOORLOCK_CONTROL "/SmartDoorlock/DoorControl"

#define TOPIC_PUB_LOG "/SmartDoorlock/Log"

//*****************************************************************************

// LOCAL FUNCTION PROTOTYPES

//*****************************************************************************

static void

Mqtt_Recv(void *app_hndl, const char *topstr, long top_len, const void *payload,

long pay_len, bool dup,unsigned char qos, bool retain);

static void sl_MqttEvt(void *app_hndl,long evt, const void *buf,

unsigned long len);

static void sl_MqttDisconnect(void *app_hndl);

int initMqtt();

/* library configuration */

SlMqttClientLibCfg_t Mqtt_Client={

1882,

TASK_PRIORITY,

30,

true,

(long(*)(const char *, ...))UART_PRINT

};

typedef struct connection_config{

SlMqttClientCtxCfg_t broker_config;

void *clt_ctx;

unsigned char *client_id;

unsigned char *usr_name;

unsigned char *usr_pwd;

bool is_clean;

unsigned int keep_alive_time;

SlMqttClientCbs_t CallBAcks;

int num_topics;

char *topic[TOPIC_COUNT];

unsigned char qos[TOPIC_COUNT];

SlMqttWill_t will_params;

bool is_connected;

}connect_config;

/* connection configuration */

connect_config usr_connect_config[] =

{

{

{

{

SL_MQTT_NETCONN_URL,

SERVER_ADDRESS,

PORT_NUMBER,

0,

0,

0,

NULL

},

SERVER_MODE,

true,

},

NULL,

"SmartDoorlock_HW1",

NULL,

NULL,

true,

KEEP_ALIVE_TIMER,

{Mqtt_Recv, sl_MqttEvt, sl_MqttDisconnect},

TOPIC_COUNT,

{TOPIC_DOORLOCK_CONTROL},

{QOS2},

{WILL_TOPIC,WILL_MSG,WILL_QOS,WILL_RETAIN},

false

}

};

/*Message Queue*/

OsiMsgQ_t g_PBQueue;

void *app_hndl = (void*)usr_connect_config;

int mqttConnect() {

int iCount = 0;

connect_config *local_con_conf = (connect_config *)app_hndl;

//create client context

local_con_conf[iCount].clt_ctx =

sl_ExtLib_MqttClientCtxCreate(&local_con_conf[iCount].broker_config,

&local_con_conf[iCount].CallBAcks,

&(local_con_conf[iCount]));

//

// Set Client ID

//

sl_ExtLib_MqttClientSet((void*)local_con_conf[iCount].clt_ctx,

SL_MQTT_PARAM_CLIENT_ID,

local_con_conf[iCount].client_id,

strlen((char*)(local_con_conf[iCount].client_id)));

//

// Set will Params

//

if(local_con_conf[iCount].will_params.will_topic != NULL)

{

sl_ExtLib_MqttClientSet((void*)local_con_conf[iCount].clt_ctx,

SL_MQTT_PARAM_WILL_PARAM,

&(local_con_conf[iCount].will_params),

sizeof(SlMqttWill_t));

}

//

// setting username and password

//

if(local_con_conf[iCount].usr_name != NULL)

{

sl_ExtLib_MqttClientSet((void*)local_con_conf[iCount].clt_ctx,

SL_MQTT_PARAM_USER_NAME,

local_con_conf[iCount].usr_name,

strlen((char*)local_con_conf[iCount].usr_name));

if(local_con_conf[iCount].usr_pwd != NULL)

{

sl_ExtLib_MqttClientSet((void*)local_con_conf[iCount].clt_ctx,

SL_MQTT_PARAM_PASS_WORD,

local_con_conf[iCount].usr_pwd,

strlen((char*)local_con_conf[iCount].usr_pwd));

}

}

//

// connectin to the broker

//

if((sl_ExtLib_MqttClientConnect((void*)local_con_conf[iCount].clt_ctx,

local_con_conf[iCount].is_clean,

local_con_conf[iCount].keep_alive_time) & 0xFF) != 0)

{

UART_PRINT("\n\rBroker connect fail for conn no. %d \n\r",iCount+1);

//delete the context for this connection

sl_ExtLib_MqttClientCtxDelete(local_con_conf[iCount].clt_ctx);

return -1;

}

else

{

UART_PRINT("\n\rSuccess: conn to Broker no. %d\n\r ", iCount+1);

local_con_conf[iCount].is_connected = true;

}

//

// Subscribe to topics

//

if(sl_ExtLib_MqttClientSub((void*)local_con_conf[iCount].clt_ctx,

local_con_conf[iCount].topic,

local_con_conf[iCount].qos, TOPIC_COUNT) < 0)

{

UART_PRINT("\n\r Subscription Error for conn no. %d\n\r", iCount+1);

UART_PRINT("Disconnecting from the broker\r\n");

sl_ExtLib_MqttClientDisconnect(local_con_conf[iCount].clt_ctx);

local_con_conf[iCount].is_connected = false;

//delete the context for this connection

sl_ExtLib_MqttClientCtxDelete(local_con_conf[iCount].clt_ctx);

return -1;

}

else

{

int iSub;

UART_PRINT("Client subscribed on following topics:\n\r");

for(iSub = 0; iSub < local_con_conf[iCount].num_topics; iSub++)

{

UART_PRINT("%s\n\r", local_con_conf[iCount].topic[iSub]);

}

}

return 0;

}

int attemptReconnect() {

if(!IS_CONNECTED(g_ulStatus))

{

UART_PRINT("device has disconnected from AP \n\r");

UART_PRINT("retry connection to the AP\n\r");

while(!(IS_CONNECTED(g_ulStatus)) || !(IS_IP_ACQUIRED(g_ulStatus)))

{

osi_Sleep(10);

}

}

return mqttConnect();

}

int initMqtt() {

long lRetVal = -1;

lRetVal = sl_ExtLib_MqttClientInit(&Mqtt_Client);

if(lRetVal != 0)

{

// lib initialization failed

UART_PRINT("MQTT Client lib initialization failed\n\r");

return -1;

}

return 0;

}

void MqttPublishLockAccess(unsigned char *data) {

connect_config *local_con_conf = (connect_config *)app_hndl;

//unsigned char *data_sw2={"Push button sw2 is pressed on CC32XX device"};

sl_ExtLib_MqttClientSend((void*)local_con_conf[0].clt_ctx,//

TOPIC_PUB_LOG,data,strlen((char*)data),QOS2,RETAIN);

UART_PRINT("\n\r CC3200 Publishes the following message \n\r");

UART_PRINT("Topic: %s\n\r",TOPIC_PUB_LOG);

UART_PRINT("Data: %s\n\r",data);

}

void Mqtt_ClientExit() {

sl_ExtLib_MqttClientExit();

}

//****************************************************************************

//! Defines Mqtt_Pub_Message_Receive event handler.

//! Client App needs to register this event handler with sl_ExtLib_mqtt_Init

//! API. Background receive task invokes this handler whenever MQTT Client

//! receives a Publish Message from the broker.

//!

//!\param[out] topstr => pointer to topic of the message

//!\param[out] top_len => topic length

//!\param[out] payload => pointer to payload

//!\param[out] pay_len => payload length

//!\param[out] retain => Tells whether its a Retained message or not

//!\param[out] dup => Tells whether its a duplicate message or not

//!\param[out] qos => Tells the Qos level

//!

//!\return none

//****************************************************************************

static void

Mqtt_Recv(void *app_hndl, const char *topstr, long top_len, const void *payload,

long pay_len, bool dup,unsigned char qos, bool retain)

{

char *topic_str=(char*)malloc(top_len+1);

memset(topic_str,'\0',top_len+1);

strncpy(topic_str, (char*)topstr, top_len);

topic_str[top_len]='\0';

char *data_str=(char*)malloc(pay_len+1);

memset(data_str,'\0',pay_len+1);

strncpy(data_str, (char*)payload, pay_len);

data_str[pay_len]='\0';

if(strncmp(topic_str, TOPIC_DOORLOCK_CONTROL, top_len) == 0)

{

event_msg msg;

msg.hndl = app_hndl;

msg.event = DOORLOCK_OPEN;

// write message indicating publish message

osi_MsgQWrite(&g_PBQueue,&msg,OSI_NO_WAIT);

}

UART_PRINT("\n\rPublish Message Received");

UART_PRINT("\n\rTopic: %s\n\r", topic_str);

free(topic_str);

UART_PRINT(" [Qos: %d] ",qos);

if(retain)

UART_PRINT(" [Retained]");

if(dup)

UART_PRINT(" [Duplicate]");

UART_PRINT("\n\rData is: %s\n\r", data_str);

free(data_str);

return;

}

//****************************************************************************

//! Defines sl_MqttEvt event handler.

//! Client App needs to register this event handler with sl_ExtLib_mqtt_Init

//! API. Background receive task invokes this handler whenever MQTT Client

//! receives an ack(whenever user is in non-blocking mode) or encounters an error.

//!

//! param[out] evt => Event that invokes the handler. Event can be of the

//! following types:

//! MQTT_ACK - Ack Received

//! MQTT_ERROR - unknown error

//!

//!

//! \param[out] buf => points to buffer

//! \param[out] len => buffer length

//!

//! \return none

//****************************************************************************

static void

sl_MqttEvt(void *app_hndl, long evt, const void *buf,unsigned long len)

{

int i;

switch(evt)

{

case SL_MQTT_CL_EVT_PUBACK:

UART_PRINT("PubAck:\n\r");

UART_PRINT("%s\n\r",buf);

break;

case SL_MQTT_CL_EVT_SUBACK:

UART_PRINT("\n\rGranted QoS Levels are:\n\r");

for(i=0;i<len;i++)

{

UART_PRINT("QoS %d\n\r",((unsigned char*)buf)[i]);

}

break;

case SL_MQTT_CL_EVT_UNSUBACK:

UART_PRINT("UnSub Ack \n\r");

UART_PRINT("%s\n\r",buf);

break;

default:

break;

}

}

//****************************************************************************

//

//! callback event in case of MQTT disconnection

//!

//! \param app_hndl is the handle for the disconnected connection

//!

//! return none

//

//****************************************************************************

static void

sl_MqttDisconnect(void *app_hndl)

{

connect_config *local_con_conf;

event_msg msg;

local_con_conf = app_hndl;

msg.hndl = app_hndl;

msg.event = BROKER_DISCONNECTION;

UART_PRINT("disconnect from broker %s\r\n",

(local_con_conf->broker_config).server_info.server_addr);

local_con_conf->is_connected = false;

//Derive the value of the local_con_conf or clt_ctx from the message

sl_ExtLib_MqttClientCtxDelete(local_con_conf->clt_ctx);

//

// write message indicating publish message

//

osi_MsgQWrite(&g_PBQueue,&msg,OSI_NO_WAIT);

}

network_common.c

/*

* network_common.c

*

* Created on: 2016. 9. 7.

* Author: Sokwhan

*/

#include <stdlib.h>

// Simplelink includes

#include "simplelink.h"

//*****************************************************************************

// SimpleLink Asynchronous Event Handlers -- Start

//*****************************************************************************

//*****************************************************************************

//

//! \brief This function serves as first level handler for HTTP GET/POST tokens

//! It runs under driver context and performs only operation that can run

//! from this context. For operations that can't is sets an indication of

//! received token and preempts the provisioning context.

//!

//! \param pSlHttpServerEvent Pointer indicating http server event

//! \param pSlHttpServerResponse Pointer indicating http server response

//!

//! \return None

//!

//*****************************************************************************

_SlEventPropogationStatus_e sl_Provisioning_HttpServerEventHdl(

SlHttpServerEvent_t *apSlHttpServerEvent,

SlHttpServerResponse_t *apSlHttpServerResponse)

{

// Unused in this application

return EVENT_PROPAGATION_CONTINUE;

}

//*****************************************************************************

//

//! \brief This function serves as first level network application events handler.

//! It runs under driver context and performs only operation that can run

//! from this context. For operations that can't is sets an indication of

//! received token and preempts the provisioning context.

//!

//! \param apEventInfo Pointer to the net app event information

//!

//! \return None

//!

//*****************************************************************************

_SlEventPropogationStatus_e sl_Provisioning_NetAppEventHdl(SlNetAppEvent_t *apNetAppEvent)

{

// Unused in this application

return EVENT_PROPAGATION_CONTINUE;

}

//*****************************************************************************

//

//! \brief This function serves as first level WLAN events handler.

//! It runs under driver context and performs only operation that can run

//! from this context. For operations that can't is sets an indication of

//! received token and preempts the provisioning context.

//!

//! \param apEventInfo Pointer to the WLAN event information

//!

//! \return None

//!

//*****************************************************************************

_SlEventPropogationStatus_e sl_Provisioning_WlanEventHdl(SlWlanEvent_t *apEventInfo)

{

// Unused in this application

return EVENT_PROPAGATION_CONTINUE;

}

//*****************************************************************************

// SimpleLink Asynchronous Event Handlers -- End

//*****************************************************************************

network.h

/*

* network.h

*

* Created on: 2016. 9. 7.

* Author: Sokwhan

*/

#ifndef NETWORK_H_

#define NETWORK_H_

extern unsigned long g_ulStatus;

// Application specific status/error codes

typedef enum{

// Choosing -0x7D0 to avoid overlap w/ host-driver's error codes

LAN_CONNECTION_FAILED = -0x7D0,

INTERNET_CONNECTION_FAILED = LAN_CONNECTION_FAILED - 1,

DEVICE_NOT_IN_STATION_MODE = INTERNET_CONNECTION_FAILED - 1,

STATUS_CODE_MAX = -0xBB8

}e_AppStatusCodes;

extern int ConnectAP(const char* ssidName, const char* securityKey);

extern long Network_IF_DeInitDriver(void);

extern long Network_IF_DisconnectFromAP();

extern long CheckInternetConnection();

extern long CheckLanConnection();

#endif /* NETWORK_H_ */

network.c

/* network.c

*

* Created on: 2016. 9. 7.

* Author: Sokwhan

*/

#include <string.h>

// Simplelink includes

#include "simplelink.h"

//Driverlib includes

#include "hw_ints.h"

//Common interface includes

#include "gpio_if.h"

#include "uart_if.h"

#include "common.h"

//Project includes

#include "network.h"

#define HOST_NAME "www.google.com"

//

// Values for below macros shall be modified for setting the 'Ping' properties

//

#define PING_INTERVAL 1000 /* In msecs */

#define PING_TIMEOUT 3000 /* In msecs */

#define PING_PKT_SIZE 20 /* In bytes */

#define NO_OF_ATTEMPTS 3

#define WLAN_CONNECT_TIMEOUT 10000 /* In msecs */

//*****************************************************************************

// GLOBAL VARIABLES -- Start

//*****************************************************************************

unsigned long g_ulStatus = 0;//SimpleLink Status

unsigned long g_ulPingPacketsRecv = 0; //Number of Ping Packets received

unsigned long g_ulGatewayIP = 0; //Network Gateway IP address

unsigned char g_ucConnectionSSID[SSID_LEN_MAX+1]; //Connection SSID

unsigned char g_ucConnectionBSSID[BSSID_LEN_MAX]; //Connection BSSID

//*****************************************************************************

// GLOBAL VARIABLES -- End

//*****************************************************************************

//****************************************************************************

// LOCAL FUNCTION PROTOTYPES

//****************************************************************************

static long WlanConnect();

void WlanStationMode( void *pvParameters );

static void InitializeAppVariables();

static long ConfigureSimpleLinkToDefaultState();

long Network_IF_DeInitDriver(void);

long Network_IF_DisconnectFromAP();

void Network_IF_UnsetMCUMachineState(char cStat);

void Network_IF_SetMCUMachineState(char cStat);

unsigned long Network_IF_CurrentMCUState();

void Network_IF_ResetMCUStateMachine();

long Network_IF_GetHostIP( char* pcHostName,unsigned long * pDestinationIP );

long Network_IF_IpConfigGet(unsigned long *pulIP, unsigned long *pulSubnetMask,

unsigned long *pulDefaultGateway, unsigned long *pulDNSServer);

//*****************************************************************************

// SimpleLink Asynchronous Event Handlers -- Start

//*****************************************************************************

//*****************************************************************************

//

//! \brief The Function Handles WLAN Events

//!

//! \param[in] pWlanEvent - Pointer to WLAN Event Info

//!

//! \return None

//!

//*****************************************************************************

void SimpleLinkWlanEventHandler(SlWlanEvent_t *pWlanEvent)

{

switch(pWlanEvent->Event)

{

case SL_WLAN_CONNECT_EVENT:

{

SET_STATUS_BIT(g_ulStatus, STATUS_BIT_CONNECTION);

//

// Information about the connected AP (like name, MAC etc) will be

// available in 'slWlanConnectAsyncResponse_t'-Applications

// can use it if required

//

// slWlanConnectAsyncResponse_t *pEventData = NULL;

// pEventData = &pWlanEvent->EventData.STAandP2PModeWlanConnected;

//

// Copy new connection SSID and BSSID to global parameters

memcpy(g_ucConnectionSSID,pWlanEvent->EventData.

STAandP2PModeWlanConnected.ssid_name,

pWlanEvent->EventData.STAandP2PModeWlanConnected.ssid_len);

memcpy(g_ucConnectionBSSID,

pWlanEvent->EventData.STAandP2PModeWlanConnected.bssid,

SL_BSSID_LENGTH);

UART_PRINT("[WLAN EVENT] STA Connected to the AP: %s ,"

"BSSID: %x:%x:%x:%x:%x:%x\n\r",

g_ucConnectionSSID,g_ucConnectionBSSID[0],

g_ucConnectionBSSID[1],g_ucConnectionBSSID[2],

g_ucConnectionBSSID[3],g_ucConnectionBSSID[4],

g_ucConnectionBSSID[5]);

}

break;

case SL_WLAN_DISCONNECT_EVENT:

{

slWlanConnectAsyncResponse_t* pEventData = NULL;

CLR_STATUS_BIT(g_ulStatus, STATUS_BIT_CONNECTION);

CLR_STATUS_BIT(g_ulStatus, STATUS_BIT_IP_AQUIRED);

pEventData = &pWlanEvent->EventData.STAandP2PModeDisconnected;

// If the user has initiated 'Disconnect' request,

//'reason_code' is SL_WLAN_DISCONNECT_USER_INITIATED_DISCONNECTION

if(SL_WLAN_DISCONNECT_USER_INITIATED_DISCONNECTION == pEventData->reason_code)

{

UART_PRINT("[WLAN EVENT]Device disconnected from the AP: %s,"

"BSSID: %x:%x:%x:%x:%x:%x on application's request \n\r",

g_ucConnectionSSID,g_ucConnectionBSSID[0],

g_ucConnectionBSSID[1],g_ucConnectionBSSID[2],

g_ucConnectionBSSID[3],g_ucConnectionBSSID[4],

g_ucConnectionBSSID[5]);

}

else

{

UART_PRINT("[WLAN ERROR]Device disconnected from the AP AP: %s,"

"BSSID: %x:%x:%x:%x:%x:%x on an ERROR..!! \n\r",

g_ucConnectionSSID,g_ucConnectionBSSID[0],

g_ucConnectionBSSID[1],g_ucConnectionBSSID[2],

g_ucConnectionBSSID[3],g_ucConnectionBSSID[4],

g_ucConnectionBSSID[5]);

}

memset(g_ucConnectionSSID,0,sizeof(g_ucConnectionSSID));

memset(g_ucConnectionBSSID,0,sizeof(g_ucConnectionBSSID));

}

break;

default:

{

UART_PRINT("[WLAN EVENT] Unexpected event [0x%x]\n\r",

pWlanEvent->Event);

}

break;

}

}

//*****************************************************************************

//

//! \brief This function handles network events such as IP acquisition, IP

//! leased, IP released etc.

//!

//! \param[in] pNetAppEvent - Pointer to NetApp Event Info

//!

//! \return None

//!

//*****************************************************************************

void SimpleLinkNetAppEventHandler(SlNetAppEvent_t *pNetAppEvent)

{

switch(pNetAppEvent->Event)

{

case SL_NETAPP_IPV4_IPACQUIRED_EVENT:

{

SlIpV4AcquiredAsync_t *pEventData = NULL;

SET_STATUS_BIT(g_ulStatus, STATUS_BIT_IP_AQUIRED);

//Ip Acquired Event Data

pEventData = &pNetAppEvent->EventData.ipAcquiredV4;

//Gateway IP address

g_ulGatewayIP = pEventData->gateway;

UART_PRINT("[NETAPP EVENT] IP Acquired: IP=%d.%d.%d.%d , "

"Gateway=%d.%d.%d.%d\n\r",

SL_IPV4_BYTE(pNetAppEvent->EventData.ipAcquiredV4.ip,3),

SL_IPV4_BYTE(pNetAppEvent->EventData.ipAcquiredV4.ip,2),

SL_IPV4_BYTE(pNetAppEvent->EventData.ipAcquiredV4.ip,1),

SL_IPV4_BYTE(pNetAppEvent->EventData.ipAcquiredV4.ip,0),

SL_IPV4_BYTE(pNetAppEvent->EventData.ipAcquiredV4.gateway,3),

SL_IPV4_BYTE(pNetAppEvent->EventData.ipAcquiredV4.gateway,2),

SL_IPV4_BYTE(pNetAppEvent->EventData.ipAcquiredV4.gateway,1),

SL_IPV4_BYTE(pNetAppEvent->EventData.ipAcquiredV4.gateway,0));

}

break;

default:

{

UART_PRINT("[NETAPP EVENT] Unexpected event [0x%x] \n\r",

pNetAppEvent->Event);

}

break;

}

}

//*****************************************************************************

//

//! \brief This function handles HTTP server events

//!

//! \param[in] pServerEvent - Contains the relevant event information

//! \param[in] pServerResponse - Should be filled by the user with the

//! relevant response information

//!

//! \return None

//!

//****************************************************************************

void SimpleLinkHttpServerCallback(SlHttpServerEvent_t *pHttpEvent,

SlHttpServerResponse_t *pHttpResponse)

{

// Unused in this application

}

//*****************************************************************************

//

//! \brief This function handles General Events

//!

//! \param[in] pDevEvent - Pointer to General Event Info

//!

//! \return None

//!

//*****************************************************************************

void SimpleLinkGeneralEventHandler(SlDeviceEvent_t *pDevEvent)

{

//

// Most of the general errors are not FATAL are are to be handled

// appropriately by the application

//

UART_PRINT("[GENERAL EVENT] - ID=[%d] Sender=[%d]\n\n",

pDevEvent->EventData.deviceEvent.status,

pDevEvent->EventData.deviceEvent.sender);

}

//*****************************************************************************

//

//! This function handles socket events indication

//!

//! \param[in] pSock - Pointer to Socket Event Info

//!

//! \return None

//!

//*****************************************************************************

void SimpleLinkSockEventHandler(SlSockEvent_t *pSock)

{

if(pSock == NULL)

{

return;

}

//

// This application doesn't work w/ socket - Events are not expected

//

switch( pSock->Event )

{

case SL_SOCKET_TX_FAILED_EVENT:

switch( pSock->socketAsyncEvent.SockTxFailData.status)

{

case SL_ECLOSE:

UART_PRINT("[SOCK ERROR] - close socket (%d) operation "

"failed to transmit all queued packets\n\n",

pSock->socketAsyncEvent.SockTxFailData.sd);

break;

default:

UART_PRINT("[SOCK ERROR] - TX FAILED : socket %d , reason "

"(%d) \n\n",

pSock->socketAsyncEvent.SockTxFailData.sd, pSock->socketAsyncEvent.SockTxFailData.status);

break;

}

break;

case SL_SOCKET_ASYNC_EVENT:

switch(pSock->socketAsyncEvent.SockAsyncData.type)

{

case SSL_ACCEPT:/*accept failed due to ssl issue ( tcp pass)*/

UART_PRINT("[SOCK ERROR] - close socket (%d) operation"

"accept failed due to ssl issue\n\r",

pSock->socketAsyncEvent.SockAsyncData.sd);

break;

case RX_FRAGMENTATION_TOO_BIG:

UART_PRINT("[SOCK ERROR] -close scoket (%d) operation"

"connection less mode, rx packet fragmentation\n\r"

"> 16K, packet is being released",

pSock->socketAsyncEvent.SockAsyncData.sd);

break;

case OTHER_SIDE_CLOSE_SSL_DATA_NOT_ENCRYPTED:

UART_PRINT("[SOCK ERROR] -close socket (%d) operation"

"remote side down from secure to unsecure\n\r",

pSock->socketAsyncEvent.SockAsyncData.sd);

break;

default:

UART_PRINT("unknown sock async event: %d\n\r",

pSock->socketAsyncEvent.SockAsyncData.type);

}

break;

default:

UART_PRINT("[SOCK EVENT] - Unexpected Event [%x0x]\n\n",pSock->Event);

break;

}

}

//*****************************************************************************

// SimpleLink Asynchronous Event Handlers -- End

//*****************************************************************************

//*****************************************************************************

//

//! \brief This function handles ping report events

//!

//! \param[in] pPingReport - Ping report statistics

//!

//! \return None

//!

//*****************************************************************************

static void SimpleLinkPingReport(SlPingReport_t *pPingReport)

{

SET_STATUS_BIT(g_ulStatus, STATUS_BIT_PING_DONE);

g_ulPingPacketsRecv = pPingReport->PacketsReceived;

}

//*****************************************************************************

//

//! \brief This function initializes the application variables

//!

//! \param None

//!

//! \return None

//!

//*****************************************************************************

static void InitializeAppVariables()

{

g_ulStatus = 0;

g_ulPingPacketsRecv = 0;

g_ulGatewayIP = 0;

memset(g_ucConnectionSSID,0,sizeof(g_ucConnectionSSID));

memset(g_ucConnectionBSSID,0,sizeof(g_ucConnectionBSSID));

}

//*****************************************************************************

//! \brief This function puts the device in its default state. It:

//! - Set the mode to STATION

//! - Configures connection policy to Auto and AutoSmartConfig

//! - Deletes all the stored profiles

//! - Enables DHCP

//! - Disables Scan policy

//! - Sets Tx power to maximum

//! - Sets power policy to normal

//! - Unregister mDNS services

//! - Remove all filters

//!

//! \param none

//! \return On success, zero is returned. On error, negative is returned

//*****************************************************************************

static long ConfigureSimpleLinkToDefaultState()

{

SlVersionFull ver = {0};

_WlanRxFilterOperationCommandBuff_t RxFilterIdMask = {0};

unsigned char ucVal = 1;

unsigned char ucConfigOpt = 0;

unsigned char ucConfigLen = 0;

unsigned char ucPower = 0;

long lRetVal = -1;

long lMode = -1;

/* lMode = sl_Start(0, 0, 0);

ASSERT_ON_ERROR(lMode);*/

// If the device is not in station-mode, try configuring it in station-mode

if (ROLE_STA != lMode)

{

if (ROLE_AP == lMode)

{

// If the device is in AP mode, we need to wait for this event

// before doing anything

while(!IS_IP_ACQUIRED(g_ulStatus))

{

#ifndef SL_PLATFORM_MULTI_THREADED

_SlNonOsMainLoopTask();

#endif

}

}

// Switch to STA role and restart

lRetVal = sl_WlanSetMode(ROLE_STA);

ASSERT_ON_ERROR(lRetVal);

lRetVal = sl_Stop(0xFF);

ASSERT_ON_ERROR(lRetVal);

lRetVal = sl_Start(0, 0, 0);

ASSERT_ON_ERROR(lRetVal);

// Check if the device is in station again

if (ROLE_STA != lRetVal)

{

// We don't want to proceed if the device is not coming up in STA-mode

ASSERT_ON_ERROR(DEVICE_NOT_IN_STATION_MODE);

}

}

// Get the device's version-information

ucConfigOpt = SL_DEVICE_GENERAL_VERSION;

ucConfigLen = sizeof(ver);

lRetVal = sl_DevGet(SL_DEVICE_GENERAL_CONFIGURATION, &ucConfigOpt,

&ucConfigLen, (unsigned char *)(&ver));

ASSERT_ON_ERROR(lRetVal);

UART_PRINT("Host Driver Version: %s\n\r",SL_DRIVER_VERSION);

UART_PRINT("Build Version %d.%d.%d.%d.31.%d.%d.%d.%d.%d.%d.%d.%d\n\r",

ver.NwpVersion[0],ver.NwpVersion[1],ver.NwpVersion[2],ver.NwpVersion[3],

ver.ChipFwAndPhyVersion.FwVersion[0],ver.ChipFwAndPhyVersion.FwVersion[1],

ver.ChipFwAndPhyVersion.FwVersion[2],ver.ChipFwAndPhyVersion.FwVersion[3],

ver.ChipFwAndPhyVersion.PhyVersion[0],ver.ChipFwAndPhyVersion.PhyVersion[1],

ver.ChipFwAndPhyVersion.PhyVersion[2],ver.ChipFwAndPhyVersion.PhyVersion[3]);

// Set connection policy to Auto + SmartConfig

// (Device's default connection policy)

lRetVal = sl_WlanPolicySet(SL_POLICY_CONNECTION,

SL_CONNECTION_POLICY(1, 0, 0, 0, 1), NULL, 0);

ASSERT_ON_ERROR(lRetVal);

// Remove all profiles

lRetVal = sl_WlanProfileDel(0xFF);

ASSERT_ON_ERROR(lRetVal);

//

// Device in station-mode. Disconnect previous connection if any

// The function returns 0 if 'Disconnected done', negative number if already

// disconnected Wait for 'disconnection' event if 0 is returned, Ignore

// other return-codes

//

lRetVal = sl_WlanDisconnect();

if(0 == lRetVal)

{

// Wait

while(IS_CONNECTED(g_ulStatus))

{

#ifndef SL_PLATFORM_MULTI_THREADED

_SlNonOsMainLoopTask();

#endif

}

}

// Enable DHCP client

lRetVal = sl_NetCfgSet(SL_IPV4_STA_P2P_CL_DHCP_ENABLE,1,1,&ucVal);

ASSERT_ON_ERROR(lRetVal);

// Disable scan

ucConfigOpt = SL_SCAN_POLICY(0);

lRetVal = sl_WlanPolicySet(SL_POLICY_SCAN , ucConfigOpt, NULL, 0);

ASSERT_ON_ERROR(lRetVal);

// Set Tx power level for station mode

// Number between 0-15, as dB offset from max power - 0 will set max power

ucPower = 0;

lRetVal = sl_WlanSet(SL_WLAN_CFG_GENERAL_PARAM_ID,

WLAN_GENERAL_PARAM_OPT_STA_TX_POWER, 1, (unsigned char *)&ucPower);

ASSERT_ON_ERROR(lRetVal);

// Set PM policy to normal

lRetVal = sl_WlanPolicySet(SL_POLICY_PM , SL_NORMAL_POLICY, NULL, 0);

ASSERT_ON_ERROR(lRetVal);

// Unregister mDNS services

lRetVal = sl_NetAppMDNSUnRegisterService(0, 0);

ASSERT_ON_ERROR(lRetVal);

// Remove all 64 filters (8*8)

memset(RxFilterIdMask.FilterIdMask, 0xFF, 8);

lRetVal = sl_WlanRxFilterSet(SL_REMOVE_RX_FILTER, (_u8 *)&RxFilterIdMask,

sizeof(_WlanRxFilterOperationCommandBuff_t));

ASSERT_ON_ERROR(lRetVal);

lRetVal = sl_Stop(SL_STOP_TIMEOUT);

ASSERT_ON_ERROR(lRetVal);

InitializeAppVariables();

return lRetVal; // Success

}

//*****************************************************************************

//! \brief This function checks the LAN connection by pinging the AP's gateway

//!

//! \param None

//!

//! \return 0 on success, negative error-code on error

//!

//*****************************************************************************

long CheckLanConnection()

{

SlPingStartCommand_t pingParams = {0};

SlPingReport_t pingReport = {0};

long lRetVal = -1;

CLR_STATUS_BIT(g_ulStatus, STATUS_BIT_PING_DONE);

g_ulPingPacketsRecv = 0;

// Set the ping parameters

pingParams.PingIntervalTime = PING_INTERVAL;

pingParams.PingSize = PING_PKT_SIZE;

pingParams.PingRequestTimeout = PING_TIMEOUT;

pingParams.TotalNumberOfAttempts = NO_OF_ATTEMPTS;

pingParams.Flags = 0;

pingParams.Ip = g_ulGatewayIP;

// Check for LAN connection

lRetVal = sl_NetAppPingStart((SlPingStartCommand_t*)&pingParams, SL_AF_INET,

(SlPingReport_t*)&pingReport, SimpleLinkPingReport);

ASSERT_ON_ERROR(lRetVal);

// Wait for NetApp Event

while(!IS_PING_DONE(g_ulStatus))

{

#ifndef SL_PLATFORM_MULTI_THREADED

_SlNonOsMainLoopTask();

#endif

}

if(0 == g_ulPingPacketsRecv)

{

//Problem with LAN connection

ASSERT_ON_ERROR(LAN_CONNECTION_FAILED);

}

// LAN connection is successful

return SUCCESS;

}

//*****************************************************************************

//! \brief This function checks the internet connection by pinging

//! the external-host (HOST_NAME)

//!

//! \param None

//!

//! \return 0 on success, negative error-code on error

//!

//*****************************************************************************

long CheckInternetConnection()

{

SlPingStartCommand_t pingParams = {0};

SlPingReport_t pingReport = {0};

unsigned long ulIpAddr = 0;

long lRetVal = -1;

CLR_STATUS_BIT(g_ulStatus, STATUS_BIT_PING_DONE);

g_ulPingPacketsRecv = 0;

// Set the ping parameters

pingParams.PingIntervalTime = PING_INTERVAL;

pingParams.PingSize = PING_PKT_SIZE;

pingParams.PingRequestTimeout = PING_TIMEOUT;

pingParams.TotalNumberOfAttempts = NO_OF_ATTEMPTS;

pingParams.Flags = 0;

pingParams.Ip = g_ulGatewayIP;

// Get external host IP address

lRetVal = sl_NetAppDnsGetHostByName((signed char*)HOST_NAME, sizeof(HOST_NAME),

&ulIpAddr, SL_AF_INET);

ASSERT_ON_ERROR(lRetVal);

// Replace the ping address to match HOST_NAME's IP address

pingParams.Ip = ulIpAddr;

// Try to ping HOST_NAME

lRetVal = sl_NetAppPingStart((SlPingStartCommand_t*)&pingParams, SL_AF_INET,

(SlPingReport_t*)&pingReport, SimpleLinkPingReport);

ASSERT_ON_ERROR(lRetVal);

// Wait

while(!IS_PING_DONE(g_ulStatus))

{

// Wait for Ping Event

#ifndef SL_PLATFORM_MULTI_THREADED

_SlNonOsMainLoopTask();

#endif

}

if (0 == g_ulPingPacketsRecv)

{

// Problem with internet connection

ASSERT_ON_ERROR(INTERNET_CONNECTION_FAILED);

}

// Internet connection is successful

return SUCCESS;

}

//****************************************************************************

//

//! \brief Connecting to a WLAN Accesspoint

//!

//! This function connects to the required AP (SSID_NAME) with Security

//! parameters specified in te form of macros at the top of this file

//!

//! \param None

//!

//! \return None

//!

//

//****************************************************************************

static long WlanConnect(const char* ssidName, const char* password)

{

SlSecParams_t secParams = {0};

long lRetVal = 0;

secParams.Key = (signed char*)password;

secParams.KeyLen = strlen(password);

secParams.Type = SL_SEC_TYPE_WPA;

lRetVal = sl_WlanConnect((signed char*)ssidName, strlen(ssidName), 0, &secParams, 0);

ASSERT_ON_ERROR(lRetVal);

unsigned long timeout = 0;

// Wait for WLAN Event

while((!IS_CONNECTED(g_ulStatus)) || (!IS_IP_ACQUIRED(g_ulStatus)))

{

if (timeout > WLAN_CONNECT_TIMEOUT) {

return FAILURE;

}

// Toggle LEDs to Indicate Connection Progress

GPIO_IF_Toggle(10);

osi_Sleep(250);

GPIO_IF_Toggle(10);

osi_Sleep(250);

timeout += 500;

}

return SUCCESS;

}

//****************************************************************************

//

//! \brief Start simplelink, connect to the ap and run the ping test

//!

//! This function starts the simplelink, connect to the ap and start the ping

//! test on the default gateway for the ap

//!

//! \param[in] pvParameters - Pointer to the list of parameters that

//! can bepassed to the task while creating it

//!

//! \return None

//

//****************************************************************************

int ConnectAP(const char* ssidName, const char* securityKey)

{

long lRetVal = -1;

InitializeAppVariables();

//

// Following function configure the device to default state by cleaning

// the persistent settings stored in NVMEM (viz. connection profiles &

// policies, power policy etc)

//

// Applications may choose to skip this step if the developer is sure

// that the device is in its default state at start of applicaton

//

// Note that all profiles and persistent settings that were done on the

// device will be lost

//

lRetVal = ConfigureSimpleLinkToDefaultState();

if(lRetVal < 0)

{

if (DEVICE_NOT_IN_STATION_MODE == lRetVal)

{

UART_PRINT("Failed to configure the device in its default state\n\r");

}

return lRetVal;

}

UART_PRINT("Device is configured in default state \n\r");

//

// Assumption is that the device is configured in station mode already

// and it is in its default state

//

lRetVal = sl_Start(0, 0, 0);

if (lRetVal < 0 || ROLE_STA != lRetVal)

{

UART_PRINT("Failed to start the device \n\r");

return lRetVal;

}

UART_PRINT("Device started as STATION \n\r");

//

//Connecting to WLAN AP

//

lRetVal = WlanConnect(ssidName,securityKey);

if(lRetVal < 0)

{

UART_PRINT("Failed to establish connection w/ an AP \n\r");

return lRetVal;

}

UART_PRINT("Connection established w/ AP and IP is aquired \n\r");

return 0;

}

//*****************************************************************************

//

//! Network_IF_DeInitDriver

//! The function de-initializes a CC3200 device

//!

//! \param None

//!

//! \return On success, zero is returned. On error, other

//

//*****************************************************************************

long

Network_IF_DeInitDriver(void)

{

long lRetVal = -1;

UART_PRINT("SL Disconnect...\n\r");

//

// Disconnect from the AP

//

lRetVal = Network_IF_DisconnectFromAP();

//

// Stop the simplelink host

//

sl_Stop(SL_STOP_TIMEOUT);

//

// Reset the state to uninitialized

//

Network_IF_ResetMCUStateMachine();

return lRetVal;

}

//*****************************************************************************

//

//! Disconnect Disconnects from an Access Point

//!

//! \param none

//!

//! \return 0 disconnected done, other already disconnected

//

//*****************************************************************************

long Network_IF_DisconnectFromAP()

{

long lRetVal = 0;

if (IS_CONNECTED(g_ulStatus))

{

lRetVal = sl_WlanDisconnect();

if(0 == lRetVal)

{

// Wait

while(IS_CONNECTED(g_ulStatus))

{

#ifndef SL_PLATFORM_MULTI_THREADED

_SlNonOsMainLoopTask();

#else

osi_Sleep(1);

#endif

}

return lRetVal;

}

else

{

return lRetVal;

}

}

else

{

return lRetVal;

}

}

//*****************************************************************************

//

//! Network_IF_IpConfigGet Get the IP Address of the device.

//!

//! \param pulIP IP Address of Device

//! \param pulSubnetMask Subnetmask of Device

//! \param pulDefaultGateway Default Gateway value

//! \param pulDNSServer DNS Server

//!

//! \return On success, zero is returned. On error, -1 is returned

//

//*****************************************************************************

long Network_IF_IpConfigGet(unsigned long *pulIP, unsigned long *pulSubnetMask,

unsigned long *pulDefaultGateway, unsigned long *pulDNSServer)

{

unsigned char isDhcp;

unsigned char len = sizeof(SlNetCfgIpV4Args_t);

long lRetVal = -1;

SlNetCfgIpV4Args_t ipV4 = {0};

lRetVal = sl_NetCfgGet(SL_IPV4_STA_P2P_CL_GET_INFO,&isDhcp,&len,

(unsigned char *)&ipV4);

ASSERT_ON_ERROR(lRetVal);

*pulIP=ipV4.ipV4;

*pulSubnetMask=ipV4.ipV4Mask;

*pulDefaultGateway=ipV4.ipV4Gateway;

*pulDefaultGateway=ipV4.ipV4DnsServer;

return lRetVal;

}

//*****************************************************************************

//

//! Network_IF_GetHostIP

//!

//! \brief This function obtains the server IP address using a DNS lookup

//!

//! \param[in] pcHostName The server hostname

//! \param[out] pDestinationIP This parameter is filled with host IP address.

//!

//! \return On success, +ve value is returned. On error, -ve value is returned

//!

//

//*****************************************************************************

long Network_IF_GetHostIP( char* pcHostName,unsigned long * pDestinationIP )

{

long lStatus = 0;

lStatus = sl_NetAppDnsGetHostByName((signed char *) pcHostName,

strlen(pcHostName),

pDestinationIP, SL_AF_INET);

ASSERT_ON_ERROR(lStatus);

UART_PRINT("Get Host IP succeeded.\n\rHost: %s IP: %d.%d.%d.%d \n\r\n\r",

pcHostName, SL_IPV4_BYTE(*pDestinationIP,3),

SL_IPV4_BYTE(*pDestinationIP,2),

SL_IPV4_BYTE(*pDestinationIP,1),

SL_IPV4_BYTE(*pDestinationIP,0));

return lStatus;

}

//*****************************************************************************

//

//! \brief Reset state from the state machine

//!

//! \param None

//!

//! \return none

//!

//*****************************************************************************

void Network_IF_ResetMCUStateMachine()

{

g_ulStatus = 0;

}

//*****************************************************************************

//

//! \brief Return the current state bits

//!

//! \param None

//!

//! \return none

//!

//

//*****************************************************************************

unsigned long Network_IF_CurrentMCUState()

{

return g_ulStatus;

}

//*****************************************************************************

//

//! \brief sets a state from the state machine

//!

//! \param cStat Status of State Machine defined in e_StatusBits

//!

//! \return none

//!

//*****************************************************************************

void Network_IF_SetMCUMachineState(char cStat)

{

SET_STATUS_BIT(g_ulStatus, cStat);

}

//*****************************************************************************

//

//! \brief Unsets a state from the state machine

//!

//! \param cStat Status of State Machine defined in e_StatusBits

//!

//! \return none

//!

//*****************************************************************************

void Network_IF_UnsetMCUMachineState(char cStat)

{

CLR_STATUS_BIT(g_ulStatus, cStat);

}

nfc.h

/*

* nfc.h

*

* Created on: 2016. 10. 12.

* Author: Sokwhan

*/

#ifndef NFC_H_

#define NFC_H_

typedef enum

{

NFC_NONE,

NFC_INVALID_PAYLOAD,

NFC_REG_PHONE,

NFC_UNREGISTERED_PHONE,

NFC_OPEN_DOORLOCK,

NFC_WIFI_CONFIG

} nfcCmdEnum;

extern void NFCInit();

extern nfcCmdEnum readNFCTag();

extern char nfcCmdPayload[100];

extern char nfcCmdPayload2[100];

extern char nfcCmdPayload3[100];

#endif /* NFC_H_ */

nfc.c

/*

* nfc.c

*

* Created on: 2016. 10. 12.

* Author: Sokwhan

*/

//Driver lib includes

#include "rom_map.h"

#include "hw_memmap.h"

#include "hw_types.h"

#include "prcm.h"

#include "simplelink.h"

#include "uart.h"

#include "gpio.h"

#include "hw_ints.h"

#include "interrupt.h"

#include "timer.h"

//Common interface includes

#include "common.h"

#include "timer_if.h"

#include "gpio_if.h"

#include "uart_if.h"

//Project includes

#include "nfc.h"

#include "trf797x.h"

#include "trf7970BoosterPack.h"

#include "iso15693.h"

#include "iso14443a.h"

#include "spi_l.h"

//===============================================================

/********** GLOBAL VARIABLES TRF7970A **********/

//===============================================================

u08_t i_reg = 0x01; // INTERRUPT REGISTER

u08_t irq_flag = 0x00;

s08_t rxtx_state = 1; // USED FOR TRANSMIT RECEIVE BYTE COUNT

u08_t stand_alone_flag = 1;

const char *CMD_DELIM_CHAR = "|";

char nfcCmdPayload[100];

char nfcCmdPayload2[100];

char nfcCmdPayload3[100];

void NFCInit() {

//Turn off TRF7970A CS

SPI_TRF_CS_OFF;

// GPIO interrupt setting

// TRF7970 IRQ

GPIOIntInit(GPIOA1_BASE, GPIO_PIN_4, INT_GPIOA1, Trf797xIRQ, GPIO_RISING_EDGE, INT_PRIORITY_LVL_1);

// Set Clock Frequency and Modulation

Trf797xCommunicationSetup();

}

static nfcCmdEnum parsePayload(char *ndef_content) {

char *splitStr;

splitStr = strtok (ndef_content,CMD_DELIM_CHAR);

nfcCmdEnum cmd = NFC_NONE;

int idx = 0;

while (splitStr != NULL)

{

if (idx == 0) {

if (strcmp(splitStr,"DOORLOCK_REGISTRATION") == 0) {

cmd = NFC_REG_PHONE;

}

else if (strcmp(splitStr,"DOORLOCK_CONTROL") == 0) {

cmd = NFC_OPEN_DOORLOCK;

}

else if (strcmp(splitStr,"WIFI_SETUP") == 0) {

cmd = NFC_WIFI_CONFIG;

}

}

else if (idx == 1) {

strcpy (nfcCmdPayload, splitStr);

}

else if (idx == 2) {

strcpy (nfcCmdPayload2, splitStr);

}

else if (idx == 3) {

strcpy (nfcCmdPayload3, splitStr);

}

splitStr = strtok (NULL,CMD_DELIM_CHAR);

idx++;

}

return cmd;

}

nfcCmdEnum readNFCTag() {

g_ndef_content_received = 0;

// TRF IRQ disable and clear

IRQ_OFF;

// TRF disable

TRF_OFF;

// delay at least 10 ms

osi_Sleep(100);

// Enter LPM3

TRF_ON;

// Must wait at least 4.8 mSec to allow TRF7970A to initialize.

osi_Sleep(5);

//ISO15693FindTag(); // Scan for 15693 tags

ISO14443aFindTag();

if(g_ndef_content_received) {

nfcCmdEnum cmd = parsePayload(g_ndef_content);

return cmd;

}

osi_Sleep(150);

return NFC_NONE;

}

pinmux.h

/*

* Smart Doorlock

*

* pinmux.h

*

* Created on: 2016. 8. 27.

* Author: Sokwhan

*/

#ifndef PINMUX_H_

#define PINMUX_H_

extern void PinMuxConfig(void);

#endif /* PINMUX_H_ */

pinmux.c

/*

* Smart Doorlock

*

* pinmux.c

*

* Created on: 2016. 8. 27.

* Author: Sokwhan

*/

#include "pinmux.h"

#include "hw_types.h"

#include "hw_memmap.h"

#include "hw_gpio.h"

#include "pin.h"

#include "rom.h"

#include "rom_map.h"

#include "gpio.h"

#include "prcm.h"

//*****************************************************************************

void

PinMuxConfig(void)

{

//

// Enable Peripheral Clocks

//

MAP_PRCMPeripheralClkEnable(PRCM_UARTA0, PRCM_RUN_MODE_CLK);

MAP_PRCMPeripheralClkEnable(PRCM_UARTA1, PRCM_RUN_MODE_CLK);

MAP_PRCMPeripheralClkEnable(PRCM_GSPI, PRCM_RUN_MODE_CLK);

MAP_PRCMPeripheralClkEnable(PRCM_GPIOA0, PRCM_RUN_MODE_CLK);

MAP_PRCMPeripheralClkEnable(PRCM_GPIOA1, PRCM_RUN_MODE_CLK);

MAP_PRCMPeripheralClkEnable(PRCM_TIMERA2, PRCM_RUN_MODE_CLK);

//

// Configure PIN_05 for SPI0 GSPI_CLK

//

MAP_PinTypeSPI(PIN_05, PIN_MODE_7);

//

// Configure PIN_06 for SPI0 GSPI_MISO (DOUT)

//

MAP_PinTypeSPI(PIN_06, PIN_MODE_7);

//

// Configure PIN_07 for SPI0 GSPI_MOSI (DIN)

//

MAP_PinTypeSPI(PIN_07, PIN_MODE_7);

//

// Configure PIN_08 for SPI0 GSPI_CS

//

MAP_PinTypeSPI(PIN_08, PIN_MODE_7);

//

// Configure PIN_03 for TRF IRQ Input (GPIO 12)

//

MAP_PinTypeGPIO(PIN_03, PIN_MODE_0, false);

MAP_GPIODirModeSet(GPIOA1_BASE, 0x10, GPIO_DIR_MODE_IN);

//

// Configure PIN_02 for TRF enable Output (GPIO11, LED D5)

//

MAP_PinTypeGPIO(PIN_02, PIN_MODE_0, false);

MAP_GPIODirModeSet(GPIOA1_BASE, 0x8, GPIO_DIR_MODE_OUT);

//

// Configure PIN_04 for Solenoid Motor (GPIO Output 13)

//

MAP_PinTypeGPIO(PIN_04, PIN_MODE_0, false);

MAP_GPIODirModeSet(GPIOA1_BASE, 0x20, GPIO_DIR_MODE_OUT);

// GPIO Definitions for keypad

// Pins 58/59/60/61 - GPIO 3,4,5,6

// Configure PIN_58 for GPIO Input 3

//

MAP_PinTypeGPIO(PIN_58, PIN_MODE_0, false);

MAP_GPIODirModeSet(GPIOA0_BASE, 0x8, GPIO_DIR_MODE_IN);

//

// Configure PIN_59 for GPIO Input 4

//

MAP_PinTypeGPIO(PIN_59, PIN_MODE_0, false);

MAP_GPIODirModeSet(GPIOA0_BASE, 0x10, GPIO_DIR_MODE_IN);

//

// Configure PIN_60 for GPIO Input 5

//

MAP_PinTypeGPIO(PIN_60, PIN_MODE_0, false);

MAP_GPIODirModeSet(GPIOA0_BASE, 0x20, GPIO_DIR_MODE_IN);

//

// Configure PIN_61 for GPIO Input 6

//

MAP_PinTypeGPIO(PIN_61, PIN_MODE_0, false);

MAP_GPIODirModeSet(GPIOA0_BASE, 0x40, GPIO_DIR_MODE_IN);

//

// Configure PIN_63 for GPIO Output

//

MAP_PinTypeGPIO(PIN_63, PIN_MODE_0, false);

MAP_GPIODirModeSet(GPIOA1_BASE, 0x1, GPIO_DIR_MODE_OUT);

//

// Configure PIN_55 for UART0 UART0_TX

//

MAP_PinTypeUART(PIN_55, PIN_MODE_3);

//

// Configure PIN_57 for UART0 UART0_RX

//

MAP_PinTypeUART(PIN_57, PIN_MODE_3);

//

// Configure PIN_01 for UART1 UART1_TX (LCD)

//

MAP_PinTypeUART(PIN_01, PIN_MODE_7);

}

s_flash.h

/*

* s_flash.h

*

* Created on: Oct 23, 2016

* Author: shuh

*/

#ifndef S_FLASH_H_

#define S_FLASH_H_

/* Configuration Data Access options */

#define SF_DELETE_DATA_RECORD (1)

#define SF_CREATE_DATA_RECORD (2)

#define SF_WRITE_DATA_RECORD (3)

#define SF_READ_DATA_RECORD (4)

#define SF_TEST_DATA_RECORD (5)

typedef struct

{

unsigned char operationMode;

char SSID[40];

char Password[40];

int regDoorlockCount;

char doorlockPhoneId[10][40];

char doorlockRegDate[10][10];

}ConfigData_t;

// initialize configuration data

extern ConfigData_t g_ConfigData;

extern long ManageConfigData(unsigned char Mode);

#endif /* S_FLASH_H_ */

s_flash.c

/*

* s_flash.c

*

* Created on: Oct 23, 2016

* Author: shuh

*/

#include "sd_globals.h"

#include "simplelink.h"

#include "s_flash.h"

#define CONFIG_FILE_NAME "SD_Config.txt"

long g_isFileHandle; // Configuration Record File Handler

// initialize configuration data

ConfigData_t g_ConfigData =

{

OPER_NOT_SET, \

"SW_Private", \

"smartdoorlock", \

0, \

{"Test"}, \

{"01/01/1900"}

};

//****************************************************************************

//

//! Manages the configuration data in the s-flash

//!

//! \param Mode indicates type of requested operation

//!

//! Possible Mode values: SF_TEST_DATA_RECORD, SF_CREATE_DATA_RECORD, SF_WRITE_DATA_RECORD, SF_READ_DATA_RECORD, SF_DELETE_DATA_RECORD

//!

//!

//! \return 0 on success.

//

//****************************************************************************

long ManageConfigData(unsigned char Mode)

{

long lRetVal;

unsigned long ulToken;

switch (Mode)

{

case SF_TEST_DATA_RECORD:

lRetVal = sl_FsOpen((unsigned char *)CONFIG_FILE_NAME, FS_MODE_OPEN_READ, &ulToken, &g_isFileHandle);

sl_FsClose(g_isFileHandle,0,0,NULL);

break;

case SF_CREATE_DATA_RECORD:

sl_FsOpen((unsigned char *) CONFIG_FILE_NAME, FS_MODE_OPEN_CREATE(1024,_FS_FILE_OPEN_FLAG_COMMIT|_FS_FILE_PUBLIC_WRITE), &ulToken,&g_isFileHandle);

sl_FsWrite(g_isFileHandle, 0, (unsigned char *) &g_ConfigData, sizeof(g_ConfigData));

sl_FsClose(g_isFileHandle,0,0,NULL);

break;

case SF_WRITE_DATA_RECORD:

sl_FsOpen((unsigned char *) CONFIG_FILE_NAME, FS_MODE_OPEN_WRITE, &ulToken,&g_isFileHandle);

sl_FsWrite(g_isFileHandle, 0, (unsigned char *) &g_ConfigData, sizeof(g_ConfigData));

sl_FsClose(g_isFileHandle,0,0,NULL);

break;

case SF_READ_DATA_RECORD:

sl_FsOpen((unsigned char *) CONFIG_FILE_NAME,FS_MODE_OPEN_READ, &ulToken,&g_isFileHandle);

sl_FsRead(g_isFileHandle,0, (unsigned char *) &g_ConfigData, sizeof(g_ConfigData));

sl_FsClose(g_isFileHandle,0,0,NULL);

break;

case SF_DELETE_DATA_RECORD:

sl_FsDel((unsigned char *) CONFIG_FILE_NAME,0);

break;

default:

lRetVal = -1;

break;

}

return lRetVal;

}

spi_l.h

/*

* spi.h

*

* Created on: Sep 30, 2016

* Author: shuh

*/

#ifndef SPI_L_H_

#define SPI_L_H_

//Common Interface Includes

#include "spi.h"

#include "gpio_if.h"

//#define SPI_IF_BIT_RATE 2000000

#define SPI_IF_BIT_RATE 2000000

#define SPI_TRF_CS_ON MAP_SPICSEnable(GSPI_BASE);

#define SPI_TRF_CS_OFF MAP_SPICSDisable(GSPI_BASE);

extern void SPIInit(void);

#endif /* SPI_L_H_ */

spi_l.c

/*

* spi.c

*

* Created on: Sep 30, 2016

* Author: shuh

*/

//Driver Lib Includes

#include "rom_map.h"

#include "hw_memmap.h"

#include "hw_types.h"

#include "prcm.h"

// Project Includes

#include "spi_l.h"

void SPIInit(void) {

MAP_PRCMPeripheralReset(PRCM_GSPI);

// Reset SPI

MAP_SPIReset(GSPI_BASE);

// Configure SPI interface

//SPI_SUB_MODE_1 = [POL = 0, PHA = 1]

MAP_SPIConfigSetExpClk(GSPI_BASE,MAP_PRCMPeripheralClockGet(PRCM_GSPI),

SPI_IF_BIT_RATE,SPI_MODE_MASTER,SPI_SUB_MODE_1,

(SPI_SW_CTRL_CS |

SPI_4PIN_MODE |

SPI_TURBO_OFF |

SPI_CS_ACTIVELOW |

SPI_WL_8));

// Enable SPI for communication

MAP_SPIEnable(GSPI_BASE);

}

timer_if.h

//*****************************************************************************

// timer_if.h

//

// timer interface header file: Prototypes and Macros for timer APIs

//

// Copyright (C) 2014 Texas Instruments Incorporated - http://www.ti.com/

//

//

// Redistribution and use in source and binary forms, with or without

// modification, are permitted provided that the following conditions

// are met:

//

// Redistributions of source code must retain the above copyright

// notice, this list of conditions and the following disclaimer.

//

// Redistributions in binary form must reproduce the above copyright

// notice, this list of conditions and the following disclaimer in the

// documentation and/or other materials provided with the

// distribution.

//

// Neither the name of Texas Instruments Incorporated nor the names of

// its contributors may be used to endorse or promote products derived

// from this software without specific prior written permission.

//

// THIS SOFTWARE IS PROVIDED BY THE COPYRIGHT HOLDERS AND CONTRIBUTORS

// "AS IS" AND ANY EXPRESS OR IMPLIED WARRANTIES, INCLUDING, BUT NOT

// LIMITED TO, THE IMPLIED WARRANTIES OF MERCHANTABILITY AND FITNESS FOR

// A PARTICULAR PURPOSE ARE DISCLAIMED. IN NO EVENT SHALL THE COPYRIGHT

// OWNER OR CONTRIBUTORS BE LIABLE FOR ANY DIRECT, INDIRECT, INCIDENTAL,

// SPECIAL, EXEMPLARY, OR CONSEQUENTIAL DAMAGES (INCLUDING, BUT NOT

// LIMITED TO, PROCUREMENT OF SUBSTITUTE GOODS OR SERVICES; LOSS OF USE,

// DATA, OR PROFITS; OR BUSINESS INTERRUPTION) HOWEVER CAUSED AND ON ANY

// THEORY OF LIABILITY, WHETHER IN CONTRACT, STRICT LIABILITY, OR TORT

// (INCLUDING NEGLIGENCE OR OTHERWISE) ARISING IN ANY WAY OUT OF THE USE

// OF THIS SOFTWARE, EVEN IF ADVISED OF THE POSSIBILITY OF SUCH DAMAGE.

//

//*****************************************************************************

#ifndef __TIMER_IF_H__

#define __TIMER_IF_H__

//*****************************************************************************

//

// If building with a C++ compiler, make all of the definitions in this header

// have a C binding.

//

//*****************************************************************************

#ifdef __cplusplus

extern "C"

{

#endif

/****************************************************************************/

/* MACROS */

/****************************************************************************/

#define PERIODIC_TEST_CYCLES 80000000

#define PERIODIC_TEST_LOOPS 5

extern void Timer_IF_Init( unsigned long ePeripheralc, unsigned long ulBase,

unsigned long ulConfig, unsigned long ulTimer, unsigned long ulValue);

extern void Timer_IF_IntSetup(unsigned long ulBase, unsigned long ulTimer,

void (*TimerBaseIntHandler)(void));

extern void Timer_IF_InterruptClear(unsigned long ulBase);

extern void Timer_IF_Start(unsigned long ulBase, unsigned long ulTimer,

unsigned long ulValue);

extern void Timer_IF_Stop(unsigned long ulBase, unsigned long ulTimer);

extern void Timer_IF_ReLoad(unsigned long ulBase, unsigned long ulTimer,

unsigned long ulValue);

extern unsigned int Timer_IF_GetCount(unsigned long ulBase, unsigned long ulTimer);

void Timer_IF_DeInit(unsigned long ulBase,unsigned long ulTimer);

void A2CounterLoad(unsigned long ulTimer);

void A2CounterEnable(void);

void A2CounterDisable(void);

void A2CounterStop(void);

void A2CounterInit ( void (*pfnHandler)(void) );

//*****************************************************************************

//

// Mark the end of the C bindings section for C++ compilers.

//

//*****************************************************************************

#ifdef __cplusplus

}

#endif

#endif // __TIMER_IF_H__

timer_if.c

//*****************************************************************************

// timer_if.c

//

// timer interface file: contains different interface functions for timer APIs

//

// Copyright (C) 2014 Texas Instruments Incorporated - http://www.ti.com/

//

//

// Redistribution and use in source and binary forms, with or without

// modification, are permitted provided that the following conditions

// are met:

//

// Redistributions of source code must retain the above copyright

// notice, this list of conditions and the following disclaimer.

//

// Redistributions in binary form must reproduce the above copyright

// notice, this list of conditions and the following disclaimer in the

// documentation and/or other materials provided with the

// distribution.

//

// Neither the name of Texas Instruments Incorporated nor the names of

// its contributors may be used to endorse or promote products derived

// from this software without specific prior written permission.

//

// THIS SOFTWARE IS PROVIDED BY THE COPYRIGHT HOLDERS AND CONTRIBUTORS

// "AS IS" AND ANY EXPRESS OR IMPLIED WARRANTIES, INCLUDING, BUT NOT

// LIMITED TO, THE IMPLIED WARRANTIES OF MERCHANTABILITY AND FITNESS FOR

// A PARTICULAR PURPOSE ARE DISCLAIMED. IN NO EVENT SHALL THE COPYRIGHT

// OWNER OR CONTRIBUTORS BE LIABLE FOR ANY DIRECT, INDIRECT, INCIDENTAL,

// SPECIAL, EXEMPLARY, OR CONSEQUENTIAL DAMAGES (INCLUDING, BUT NOT

// LIMITED TO, PROCUREMENT OF SUBSTITUTE GOODS OR SERVICES; LOSS OF USE,

// DATA, OR PROFITS; OR BUSINESS INTERRUPTION) HOWEVER CAUSED AND ON ANY

// THEORY OF LIABILITY, WHETHER IN CONTRACT, STRICT LIABILITY, OR TORT

// (INCLUDING NEGLIGENCE OR OTHERWISE) ARISING IN ANY WAY OUT OF THE USE

// OF THIS SOFTWARE, EVEN IF ADVISED OF THE POSSIBILITY OF SUCH DAMAGE.

//

//*****************************************************************************

#include "hw_types.h"

#include "hw_memmap.h"

#include "hw_ints.h"

#include "debug.h"

#include "interrupt.h"

#include "timer.h"

#include "hw_timer.h"

#include "rom.h"

#include "rom_map.h"

#include "prcm.h"

#include "timer_if.h"

#ifdef USE_TIRTOS

#include <stdlib.h>

#include "osi.h"

#endif

#ifdef USE_TIRTOS

static unsigned char

GetPeripheralIntNum(unsigned long ulBase, unsigned long ulTimer)

{

if(ulTimer == TIMER_A)

{

switch(ulBase)

{

case TIMERA0_BASE:

return INT_TIMERA0A;

case TIMERA1_BASE:

return INT_TIMERA1A;

case TIMERA2_BASE:

return INT_TIMERA2A;

case TIMERA3_BASE:

return INT_TIMERA3A;

default:

return INT_TIMERA0A;

}

}

else if(ulTimer == TIMER_B)

{

switch(ulBase)

{

case TIMERA0_BASE:

return INT_TIMERA0B;

case TIMERA1_BASE:

return INT_TIMERA1B;

case TIMERA2_BASE:

return INT_TIMERA2B;

case TIMERA3_BASE:

return INT_TIMERA3B;

default:

return INT_TIMERA0B;

}

}

else

{

return INT_TIMERA0A;

}

}

#endif

//*****************************************************************************

//

//! Initializing the Timer

//!

//! \param ePeripheral is the peripheral which need to be initialized.

//! \param ulBase is the base address for the timer.

//! \param ulConfig is the configuration for the timer.

//! \param ulTimer selects amoung the TIMER_A or TIMER_B or TIMER_BOTH.

//! \param ulValue is the timer prescale value which must be between 0 and

//! 255 (inclusive) for 16/32-bit timers and between 0 and 65535 (inclusive)

//! for 32/64-bit timers.

//! This function

//! 1. Enables and reset the peripheral for the timer.

//! 2. Configures and set the prescale value for the timer.

//!

//! \return none

//

//*****************************************************************************

void Timer_IF_Init( unsigned long ePeripheral, unsigned long ulBase, unsigned

long ulConfig, unsigned long ulTimer, unsigned long ulValue)

{

//

// Initialize GPT A0 (in 32 bit mode) as periodic down counter.

//

MAP_PRCMPeripheralClkEnable(ePeripheral, PRCM_RUN_MODE_CLK);

MAP_PRCMPeripheralReset(ePeripheral);

MAP_TimerConfigure(ulBase,ulConfig);

MAP_TimerPrescaleSet(ulBase,ulTimer,ulValue);

}

//*****************************************************************************

//

//! setting up the timer

//!

//! \param ulBase is the base address for the timer.

//! \param ulTimer selects between the TIMER_A or TIMER_B or TIMER_BOTH.

//! \param TimerBaseIntHandler is the pointer to the function that handles the

//! interrupt for the Timer

//!

//! This function

//! 1. Register the function handler for the timer interrupt.

//! 2. enables the timer interrupt.

//!

//! \return none

//

//*****************************************************************************

void Timer_IF_IntSetup(unsigned long ulBase, unsigned long ulTimer,

void (*TimerBaseIntHandler)(void))

{

//

// Setup the interrupts for the timer timeouts.

//

#ifdef USE_TIRTOS

if(ulTimer == TIMER_BOTH)

{

osi_InterruptRegister(GetPeripheralIntNum(ulBase, TIMER_A),

TimerBaseIntHandler, INT_PRIORITY_LVL_1);

osi_InterruptRegister(GetPeripheralIntNum(ulBase, TIMER_B),

TimerBaseIntHandler, INT_PRIORITY_LVL_1);

}

else

{

osi_InterruptRegister(GetPeripheralIntNum(ulBase, ulTimer),

TimerBaseIntHandler, INT_PRIORITY_LVL_1);

}

#else

MAP_TimerIntRegister(ulBase, ulTimer, TimerBaseIntHandler);

#endif

if(ulTimer == TIMER_BOTH)

{

MAP_TimerIntEnable(ulBase, TIMER_TIMA_TIMEOUT|TIMER_TIMB_TIMEOUT);

}

else

{

MAP_TimerIntEnable(ulBase, ((ulTimer == TIMER_A) ? TIMER_TIMA_TIMEOUT :

TIMER_TIMB_TIMEOUT));

}

}

//*****************************************************************************

//

//! clears the timer interrupt

//!

//! \param ulBase is the base address for the timer.

//!

//! This function

//! 1. clears the interrupt with given base.

//!

//! \return none

//

//*****************************************************************************

void Timer_IF_InterruptClear(unsigned long ulBase)

{

unsigned long ulInts;

ulInts = MAP_TimerIntStatus(ulBase, true);

//

// Clear the timer interrupt.

//

MAP_TimerIntClear(ulBase, ulInts);

}

//*****************************************************************************

//

//! starts the timer

//!

//! \param ulBase is the base address for the timer.

//! \param ulTimer selects amoung the TIMER_A or TIMER_B or TIMER_BOTH.

//! \param ulValue is the the number of clock cycles after which the timer will

//! run out and gives the interrupt.

//!

//! This function

//! 1. Load the Timer with the specified value.

//! 2. enables the timer.

//!

//! \return none

//

//*****************************************************************************

void Timer_IF_Start(unsigned long ulBase, unsigned long ulTimer,

unsigned long ulValue)

{

MAP_TimerLoadSet(ulBase,ulTimer,ulValue);

//

// Enable the GPT

//

MAP_TimerEnable(ulBase,ulTimer);

}

//*****************************************************************************

//

//! disable the timer

//!

//! \param ulBase is the base address for the timer.

//! \param ulTimer selects amoung the TIMER_A or TIMER_B or TIMER_BOTH.

//!

//! This function

//! 1. disables the interupt.

//!

//! \return none

//

//*****************************************************************************

void Timer_IF_Stop(unsigned long ulBase, unsigned long ulTimer)

{

//

// Disable the GPT

//

MAP_TimerDisable(ulBase,ulTimer);

}

//*****************************************************************************

//

//! De-Initialize the timer

//!

//! \param uiGPTBaseAddr

//! \param ulTimer

//!

//! This function

//! 1. disable the timer interrupts

//! 2. unregister the timer interrupt

//!

//! \return None.

//

//*****************************************************************************

void Timer_IF_DeInit(unsigned long ulBase,unsigned long ulTimer)

{

//

// Disable the timer interrupt

//

MAP_TimerIntDisable(ulBase,TIMER_TIMA_TIMEOUT|TIMER_TIMB_TIMEOUT);

//

// Unregister the timer interrupt

//

MAP_TimerIntUnregister(ulBase,ulTimer);

}

//*****************************************************************************

//

//! starts the timer

//!

//! \param ulBase is the base address for the timer.

//! \param ulTimer selects between the TIMER A and TIMER B.

//! \param ulValue is the the number of clock cycles after which the timer will

//! run out and gives the interrupt.

//!

//! This function

//! 1. Reload the Timer with the specified value.

//!

//! \return none

//

//*****************************************************************************

void Timer_IF_ReLoad(unsigned long ulBase, unsigned long ulTimer,

unsigned long ulValue)

{

MAP_TimerLoadSet(ulBase,ulTimer,ulValue);

}

//*****************************************************************************

//

//! starts the timer

//!

//! \param ulBase is the base address for the timer.

//! \param ulTimer selects amoung the TIMER_A or TIMER_B or TIMER_BOTH.

//!

//! This function

//! 1. returns the timer value.

//!

//! \return Timer Value.

//

//*****************************************************************************

unsigned int Timer_IF_GetCount(unsigned long ulBase, unsigned long ulTimer)

{

unsigned long ulCounter;

ulCounter = MAP_TimerValueGet(ulBase, ulTimer);

return 0xFFFFFFFF - ulCounter;

}

void A2CounterLoad(unsigned long ulTimer)

{

TimerLoadSet(TIMERA2_BASE, TIMER_A, ulTimer);

}

void A2CounterEnable(void)

{

TimerEnable(TIMERA2_BASE, TIMER_A);

}

void A2CounterDisable(void)

{

TimerDisable(TIMERA2_BASE, TIMER_A);

}

void A2CounterStop(void)

{

TimerIntClear(TIMERA2_BASE, TIMER_A);

}

void A2CounterInit ( void (*pfnHandler)(void) )

{

// MAP_PRCMPeripheralClkEnable(PRCM_TIMERA1, PRCM_RUN_MODE_CLK);

//

// MAP_TimerConfigure(ulBase,ulConfig);

// MAP_TimerPrescaleSet(ulBase,ulTimer,ulValue);

PRCMPeripheralReset(PRCM_TIMERA2);

TimerDisable(TIMERA2_BASE, TIMER_A);

TimerConfigure(TIMERA2_BASE,TIMER_CFG_ONE_SHOT);

// TimerPrescaleSet(TIMERA2_BASE, TIMER_A, 80);

TimerIntRegister(TIMERA2_BASE, TIMER_A, pfnHandler);

TimerIntClear(TIMERA2_BASE, TIMER_A);

TimerIntEnable(TIMERA2_BASE,TIMER_TIMA_TIMEOUT);

}

//*****************************************************************************

//

// Close the Doxygen group.

//! @}

//

//*****************************************************************************

uart_if.h

/*

* uart_if.h

*

* Created on: Oct 22, 2016

* Author: shuh

*/

#ifndef UART_IF_H_

#define UART_IF_H_

/****************************************************************************/

/* MACROS */

/****************************************************************************/

#define UART_BAUD_RATE 115200

#define SYSCLK 80000000

#define CONSOLE UARTA0_BASE

#define CONSOLE_PERIPH PRCM_UARTA0

//

// Define the size of UART IF buffer for RX

//

#define UART_IF_BUFFER 64

//

// Define the UART IF buffer

//

extern unsigned char g_ucUARTBuffer[];

/****************************************************************************/

/* FUNCTION PROTOTYPES */

/****************************************************************************/

extern void DispatcherUARTConfigure(void);

extern void DispatcherUartSendPacket(unsigned char *inBuff, unsigned short usLength);

extern int GetCmd(char *pcBuffer, unsigned int uiBufLen);

extern void InitTerm(void);

extern void ClearTerm(void);

extern void Message(char *format);

extern void Error(char *format,...);

extern int Report(char *format, ...);

void UartPutChar(unsigned char ch);

void UartPutCrlf(void);

extern void UartSendCString(char *format);

void UartPutByte(unsigned char ch);

void UartPutByteHex(unsigned char ch);

//*****************************************************************************

//

// Mark the end of the C bindings section for C++ compilers.

//

//*****************************************************************************

#endif /* UART_IF_H_ */

uart_if.c

//*****************************************************************************

// uart_if.c

//

// uart interface file: Prototypes and Macros for UARTLogger

//

// Copyright (C) 2014 Texas Instruments Incorporated - http://www.ti.com/

//

//

// Redistribution and use in source and binary forms, with or without

// modification, are permitted provided that the following conditions

// are met:

//

// Redistributions of source code must retain the above copyright

// notice, this list of conditions and the following disclaimer.

//

// Redistributions in binary form must reproduce the above copyright

// notice, this list of conditions and the following disclaimer in the

// documentation and/or other materials provided with the

// distribution.

//

// Neither the name of Texas Instruments Incorporated nor the names of

// its contributors may be used to endorse or promote products derived

// from this software without specific prior written permission.

//

// THIS SOFTWARE IS PROVIDED BY THE COPYRIGHT HOLDERS AND CONTRIBUTORS

// "AS IS" AND ANY EXPRESS OR IMPLIED WARRANTIES, INCLUDING, BUT NOT

// LIMITED TO, THE IMPLIED WARRANTIES OF MERCHANTABILITY AND FITNESS FOR

// A PARTICULAR PURPOSE ARE DISCLAIMED. IN NO EVENT SHALL THE COPYRIGHT

// OWNER OR CONTRIBUTORS BE LIABLE FOR ANY DIRECT, INDIRECT, INCIDENTAL,

// SPECIAL, EXEMPLARY, OR CONSEQUENTIAL DAMAGES (INCLUDING, BUT NOT

// LIMITED TO, PROCUREMENT OF SUBSTITUTE GOODS OR SERVICES; LOSS OF USE,

// DATA, OR PROFITS; OR BUSINESS INTERRUPTION) HOWEVER CAUSED AND ON ANY

// THEORY OF LIABILITY, WHETHER IN CONTRACT, STRICT LIABILITY, OR TORT

// (INCLUDING NEGLIGENCE OR OTHERWISE) ARISING IN ANY WAY OUT OF THE USE

// OF THIS SOFTWARE, EVEN IF ADVISED OF THE POSSIBILITY OF SUCH DAMAGE.

//

//*****************************************************************************

#include <stdarg.h>

#include <stdlib.h>

#include <stdio.h>

#include <string.h>

#include "osi.h"

#include "hw_types.h"

#include "hw_memmap.h"

#include "prcm.h"

#include "pin.h"

#include "uart.h"

#include "rom.h"

#include "rom_map.h"

#include "uart_if.h"

/* BIOS module Headers */

#include <ti/sysbios/BIOS.h>

#include <ti/sysbios/knl/Clock.h>

#include <ti/sysbios/knl/Task.h>

#include <ti/sysbios/knl/Semaphore.h>

Semaphore_Struct semStruct;

Semaphore_Handle semHandle;

OsiLockObj_t g_IntNotiSLockObj;

//*****************************************************************************

// Global variable indicating command is present

//*****************************************************************************

static unsigned long __Errorlog;

//*****************************************************************************

// Global variable indicating input length

//*****************************************************************************

unsigned int ilen=1;

//*****************************************************************************

//

//! Initialization

//!

//! This function

//! 1. Configures the UART to be used.

//!

//! \return none

//

//*****************************************************************************

void

InitTerm()

{

#ifndef NOTERM

MAP_UARTConfigSetExpClk(CONSOLE,MAP_PRCMPeripheralClockGet(CONSOLE_PERIPH),

UART_BAUD_RATE, (UART_CONFIG_WLEN_8 | UART_CONFIG_STOP_ONE |

UART_CONFIG_PAR_NONE));

#endif

__Errorlog = 0;

/* Semaphore_Params semParams;

Construct a Semaphore object to be use as a resource lock, inital count 0

Semaphore_Params_init(&semParams);

Semaphore_construct(&semStruct, 1, &semParams);

Obtain instance handle

semHandle = Semaphore_handle(&semStruct);*/

if (osi_LockObjCreate(&g_IntNotiSLockObj) < 0) {

Report("Semaphore creation failure!\n\r");

}

}

//*****************************************************************************

//

//! Outputs a character string to the console

//!

//! \param str is the pointer to the string to be printed

//!

//! This function

//! 1. prints the input string character by character on to the console.

//!

//! \return none

//

//*****************************************************************************

void

Message(char *str)

{

#ifndef NOTERM

if(str != NULL)

{

while(*str!='\0')

{

MAP_UARTCharPut(CONSOLE,*str++);

}

}

#endif

}

void

UartPutChar(unsigned char ch)

{

MAP_UARTCharPut(CONSOLE,ch);

}

void UartPutByte(unsigned char ch)

{

char str[4];

sprintf ( str, "%x", (ch >> 4) & 0x0F );

MAP_UARTCharPut(CONSOLE,str[0]);

sprintf ( str, "%x", ch & 0x0F );

MAP_UARTCharPut(CONSOLE,str[0]);

}

void UartPutByteHex(unsigned char ch)

{

char str[10];

int i = 0;

sprintf(str, "%x", ch);

while(str[i]!='\0')

{

MAP_UARTCharPut(CONSOLE,str[i]);

i=i+1;

}

}

void

UartPutCrlf(void){

MAP_UARTCharPut(CONSOLE,'\r');

MAP_UARTCharPut(CONSOLE,'\n');

}

void

UartSendCString(char *str)

{

#ifndef NOTERM

Report(str);

/*char *copiedStr;

copiedStr = malloc(strlen(str));

strcpy(copiedStr,str);

Get access to resource

//Semaphore_pend(semHandle, BIOS_WAIT_FOREVER);

osi_SyncObjWait(&g_IntNotiSyncObj, OSI_WAIT_FOREVER);

osi_SyncObjClear(&g_IntNotiSyncObj);

if(str != NULL)

{

while(*copiedStr!='\0')

{

MAP_UARTCharPut(CONSOLE,*copiedStr++);

}

}

osi_SyncObjSignal(&g_IntNotiSyncObj);

//Semaphore_post(semHandle);*/

#endif

}

//*****************************************************************************

//

//! Clear the console window

//!

//! This function

//! 1. clears the console window.

//!

//! \return none

//

//*****************************************************************************

void

ClearTerm()

{

Message("\33[2J\r");

}

//*****************************************************************************

//

//! Error Function

//!

//! \param

//!

//! \return none

//!

//*****************************************************************************

void

Error(char *pcFormat, ...)

{

#ifndef NOTERM

char cBuf[256];

va_list list;

va_start(list,pcFormat);

vsnprintf(cBuf,256,pcFormat,list);

Message(cBuf);

#endif

__Errorlog++;

}

//*****************************************************************************

//

//! Get the Command string from UART

//!

//! \param pucBuffer is the command store to which command will be populated

//! \param ucBufLen is the length of buffer store available

//!

//! \return Length of the bytes received. -1 if buffer length exceeded.

//!

//*****************************************************************************

int

GetCmd(char *pcBuffer, unsigned int uiBufLen)

{

char cChar;

int iLen = 0;

//

// Wait to receive a character over UART

//

cChar = MAP_UARTCharGet(CONSOLE);

//

// Echo the received character

//

MAP_UARTCharPut(CONSOLE, cChar);

iLen = 0;

//

// Checking the end of Command

//

while((cChar != '\r') && (cChar !='\n') )

{

//

// Handling overflow of buffer

//

if(iLen >= uiBufLen)

{

return -1;

}

//

// Copying Data from UART into a buffer

//

if(cChar != '\b')

{

*(pcBuffer + iLen) = cChar;

iLen++;

}

else

{

//

// Deleting last character when you hit backspace

//

if(iLen)

{

iLen--;

}

}

//

// Wait to receive a character over UART

//

cChar = MAP_UARTCharGet(CONSOLE);

//

// Echo the received character

//

MAP_UARTCharPut(CONSOLE, cChar);

}

*(pcBuffer + iLen) = '\0';

Report("\n\r");

return iLen;

}

//*****************************************************************************

//

//! prints the formatted string on to the console

//!

//! \param format is a pointer to the character string specifying the format in

//! the following arguments need to be interpreted.

//! \param [variable number of] arguments according to the format in the first

//! parameters

//! This function

//! 1. prints the formatted error statement.

//!

//! \return count of characters printed

//

//*****************************************************************************

int Report(char *pcFormat, ...)

{

/*char *copiedStr;

copiedStr = malloc(strlen(str));

strcpy(copiedStr,str);

Get access to resource

//Semaphore_pend(semHandle, BIOS_WAIT_FOREVER);

osi_SyncObjWait(&g_IntNotiSyncObj, OSI_WAIT_FOREVER);

osi_SyncObjClear(&g_IntNotiSyncObj);

if(str != NULL)

{

while(*copiedStr!='\0')

{

MAP_UARTCharPut(CONSOLE,*copiedStr++);

}

}

osi_SyncObjSignal(&g_IntNotiSyncObj);

//Semaphore_post(semHandle);*/

//osi_LockObjLock(&g_IntNotiSLockObj, OSI_WAIT_FOREVER);

//osi_SyncObjClear(&g_IntNotiSyncObj);

int iRet = 0;

#ifndef NOTERM

char *pcBuff, *pcTemp;

int iSize = 256;

va_list list;

pcBuff = (char*)malloc(iSize);

if(pcBuff == NULL)

{

return -1;

}

while(1)

{

va_start(list,pcFormat);

iRet = vsnprintf(pcBuff,iSize,pcFormat,list);

va_end(list);

if(iRet > -1 && iRet < iSize)

{

break;

}

else

{

iSize*=2;

if((pcTemp=realloc(pcBuff,iSize))==NULL)

{

Message("Could not reallocate memory\n\r");

iRet = -1;

break;

}

else

{

pcBuff=pcTemp;

}

}

}

Message(pcBuff);

free(pcBuff);

//osi_LockObjUnlock(&g_IntNotiSLockObj);

#endif

return iRet;

}

iso14443a.h

/*

* File Name: iso14443.h

*

* Description: Headers and Defines for ISO14443A Specific Functions

*

* Copyright (C) 2016 Texas Instruments Incorporated - http://www.ti.com/

*

*

* Redistribution and use in source and binary forms, with or without

* modification, are permitted provided that the following conditions

* are met:

*

* Redistributions of source code must retain the above copyright

* notice, this list of conditions and the following disclaimer.

*

* Redistributions in binary form must reproduce the above copyright

* notice, this list of conditions and the following disclaimer in the

* documentation and/or other materials provided with the

* distribution.

*

* Neither the name of Texas Instruments Incorporated nor the names of

* its contributors may be used to endorse or promote products derived

* from this software without specific prior written permission.

*

* THIS SOFTWARE IS PROVIDED BY THE COPYRIGHT HOLDERS AND CONTRIBUTORS

* "AS IS" AND ANY EXPRESS OR IMPLIED WARRANTIES, INCLUDING, BUT NOT

* LIMITED TO, THE IMPLIED WARRANTIES OF MERCHANTABILITY AND FITNESS FOR

* A PARTICULAR PURPOSE ARE DISCLAIMED. IN NO EVENT SHALL THE COPYRIGHT

* OWNER OR CONTRIBUTORS BE LIABLE FOR ANY DIRECT, INDIRECT, INCIDENTAL,

* SPECIAL, EXEMPLARY, OR CONSEQUENTIAL DAMAGES (INCLUDING, BUT NOT

* LIMITED TO, PROCUREMENT OF SUBSTITUTE GOODS OR SERVICES; LOSS OF USE,

* DATA, OR PROFITS; OR BUSINESS INTERRUPTION) HOWEVER CAUSED AND ON ANY

* THEORY OF LIABILITY, WHETHER IN CONTRACT, STRICT LIABILITY, OR TORT

* (INCLUDING NEGLIGENCE OR OTHERWISE) ARISING IN ANY WAY OUT OF THE USE

* OF THIS SOFTWARE, EVEN IF ADVISED OF THE POSSIBILITY OF SUCH DAMAGE.

*

*/

#ifndef _ISO14443A_H_

#define _ISO14443A_H_

//================================================================

#include "trf797x.h"

#include "type_4_ndef.h"

//===============================================================

//Polling Defines

#define REQA 0x26

#define WUPA 0x52

//Anticollision Defines

#define SEL_CASCADE1 0x93

#define SEL_CASCADE2 0x95

#define SEL_CASCADE3 0x97

#define NVB_INIT 0x20

#define NVB_FULL 0x70

#define CT 0x88

//RATS Defines

#define RATS_CMD 0xE0

#define RATS_PARAM 0x70

//PPS Defines

#define PPSS 0xD0

#define PPS0 0x11

#define PPS1_106 0x00

#define PPS1_212 0x05

#define PPS1_424 0x0A

#define PPS1_848 0x0F

typedef enum

{

ISO14443A_UID_UNKNOWN = 0x00,

ISO14443A_UID_SINGLE = 0x04, // Four Bytes

ISO14443A_UID_DOUBLE = 0x07, // Seven Bytes

ISO14443A_UID_TRIPLE = 0x0A // Ten Bytes

}tISO14443A_UidSize;

typedef enum

{

CASCADE1,

CASCADE2,

CASCADE3,

UID_COMPLETE,

UID_INCOMPLETE

}tISO14443A_UidStatus;

typedef enum

{

NO_COLLISION,

COLLISION,

NO_RESPONSE,

COLLISION_ERROR

}tCollisionStatus;

//===============================================================

u08_t Iso14443a_TagSelection(u08_t ui8Command);

tCollisionStatus Iso14443a_AnticollisionLoop(tISO14443A_UidStatus sCascade);

u08_t Iso14443a_PollingCommand(u08_t ui8Command);

tCollisionStatus Iso14443a_AnticollisionCommand(tISO14443A_UidStatus sCascade, u08_t ui8NVB, u08_t * pui8UID);

u08_t Iso14443a_SelectCommand(tISO14443A_UidStatus sCascade, u08_t * pui8UID, bool bSendCT);

u08_t Iso14443a_Halt(void);

u08_t Iso14443a_Rats(void);

u08_t Iso14443a_Pps(void);

bool Iso14443a_StoreUid(tISO14443A_UidStatus sCascade, u08_t * pui8UID);

u08_t Iso14443a_Type2_Read4Blocks(u08_t ui8StartBlock);

bool Iso14443a_Get_Type4ACompliance(void);

void Iso14443a_Set_RecursionCount(u08_t ui8RecursionCount);

u08_t * Iso14443a_Get_Uid(void);

tISO14443A_UidSize Iso14443a_Get_UidSize(void);

extern void ISO14443aFindTag();

extern u08_t g_ndef_content_received;

//===============================================================

#endif

iso14443a.c

/*

* File Name: iso14443a.c

*

* Description: ISO14443A Specific Functions

*

* Copyright (C) 2016 Texas Instruments Incorporated - http://www.ti.com/

*

*

* Redistribution and use in source and binary forms, with or without

* modification, are permitted provided that the following conditions

* are met:

*

* Redistributions of source code must retain the above copyright

* notice, this list of conditions and the following disclaimer.

*

* Redistributions in binary form must reproduce the above copyright

* notice, this list of conditions and the following disclaimer in the

* documentation and/or other materials provided with the

* distribution.

*

* Neither the name of Texas Instruments Incorporated nor the names of

* its contributors may be used to endorse or promote products derived

* from this software without specific prior written permission.

*

* THIS SOFTWARE IS PROVIDED BY THE COPYRIGHT HOLDERS AND CONTRIBUTORS

* "AS IS" AND ANY EXPRESS OR IMPLIED WARRANTIES, INCLUDING, BUT NOT

* LIMITED TO, THE IMPLIED WARRANTIES OF MERCHANTABILITY AND FITNESS FOR

* A PARTICULAR PURPOSE ARE DISCLAIMED. IN NO EVENT SHALL THE COPYRIGHT

* OWNER OR CONTRIBUTORS BE LIABLE FOR ANY DIRECT, INDIRECT, INCIDENTAL,

* SPECIAL, EXEMPLARY, OR CONSEQUENTIAL DAMAGES (INCLUDING, BUT NOT

* LIMITED TO, PROCUREMENT OF SUBSTITUTE GOODS OR SERVICES; LOSS OF USE,

* DATA, OR PROFITS; OR BUSINESS INTERRUPTION) HOWEVER CAUSED AND ON ANY

* THEORY OF LIABILITY, WHETHER IN CONTRACT, STRICT LIABILITY, OR TORT

* (INCLUDING NEGLIGENCE OR OTHERWISE) ARISING IN ANY WAY OUT OF THE USE

* OF THIS SOFTWARE, EVEN IF ADVISED OF THE POSSIBILITY OF SUCH DAMAGE.

*

*/

#include "hw_memmap.h"

#include "iso14443a.h"

#include "trf7970BoosterPack.h"

#include "uart_if.h"

#include "gpio.h"

#include "gpio_if.h"

//===============================================================

// Global Variables

//===============================================================

extern u08_t g_ui8TrfBuffer[NFC_FIFO_SIZE];

static volatile tTRF797x_Status g_sTrfStatus;

static tISO14443A_UidSize g_sUidSize = ISO14443A_UID_UNKNOWN;

static u08_t g_pui8CompleteUid[10] = {0x00,0x00,0x00,0x00,0x00,0x00,0x00,0x00,0x00,0x00};

static u08_t g_pui8PartialUid[5] = {0x00,0x00,0x00,0x00,0x00};

static u08_t g_ui8UidPos = 0;

static u08_t g_ui8ValidUidByteCount = 0;

static u08_t g_ui8ValidUidBitCount = 0;

static u08_t g_ui8ValidBits;

static u08_t g_ui8RecursionCount = 0;

static u08_t g_ui8MaxRecurviseCalls = 5;

static u08_t g_ui8Iso14443aSAK;

static bool g_bType4ACompliant = false;

static u08_t g_ui8AtsSupportedBitrates = 0x00; // This is used to store the ATS reply for TA(1) which contains the Tags supported bitrates - needed to determine PPS request parameters.

u08_t g_ndef_content_received;

//===============================================================

//

// Iso14443a_TagSelection - Process to detect and select

// ISO14443A/NFC Type 2/4A Tag Platform compliant tags.

//

// \param ui8Command is the Polling command to be issued by

// the TRF797x for ISO14443A tag detection.

//

// This function issues polling command, processes the ATQA, and

// handles sending correct anticollision and selection commands.

//

// When a collision occurs, this function will call the

// anticollision function to handle the collision.

//

// \return ui8Status returns whether or not an ISO14443A

// compliant tag has been successfully selected.

//

//===============================================================

u08_t Iso14443a_TagSelection(u08_t ui8Command)

{

u08_t ui8Index = 0;

u08_t ui8LoopCount = 0;

u08_t ui8Status = STATUS_FAIL;

bool bSendCT = false;

tISO14443A_UidStatus sUidProgress = CASCADE1;

tCollisionStatus sCollisionStatus = NO_COLLISION;

// Clear UID to store new one

for(ui8Index = 0; ui8Index < 10; ui8Index++)

{

g_pui8CompleteUid[ui8Index] = 0x00;

}

// Clear partial UID buffer

for (ui8LoopCount = 0; ui8LoopCount < 5; ui8LoopCount++)

{

g_pui8PartialUid[ui8LoopCount] = 0x00;

}

g_ui8UidPos = 0; // Reset UID Position Marker

g_ui8ValidUidByteCount = 0; // Reset Valid Bytes Received Counter

g_ui8ValidUidBitCount = 0; // Reset Valid Bits Received Counter

g_ui8Iso14443aSAK = 0; // Reset the SAK

g_bType4ACompliant = false; // Reset Type 4A Compliance

g_ui8AtsSupportedBitrates = 0; // Reset the ATS Reply for TA(1)

g_ui8ValidBits = 0; // Clear Valid Bit global

// Poll for a ISO14443A tag

if (Iso14443a_PollingCommand(ui8Command))

{

if (g_sTrfStatus == RX_COMPLETE)

{

// Check ATQA Response for UID size

if ((g_ui8TrfBuffer[0] & 0xC0) == 0x00)

{

g_sUidSize = ISO14443A_UID_SINGLE;

}

else if ((g_ui8TrfBuffer[0] & 0xC0) == 0x40)

{

g_sUidSize = ISO14443A_UID_DOUBLE;

}

else if ((g_ui8TrfBuffer[0] & 0xC0) == 0x80)

{

g_sUidSize = ISO14443A_UID_TRIPLE;

}

else

{

g_sUidSize = ISO14443A_UID_UNKNOWN;

}

}

else

{

// Collision occurred, UID size not known

g_sUidSize = ISO14443A_UID_UNKNOWN;

}

}

else

{

// No response to polling command, exit function

ui8Status = STATUS_FAIL;

g_ui8RecursionCount = 0; // Reset the recursion count for the anticollision loops

return ui8Status;

}

while (sUidProgress != UID_COMPLETE)

{

sCollisionStatus = Iso14443a_AnticollisionCommand(sUidProgress, NVB_INIT, &g_pui8CompleteUid[0]); // Call anticollision loop function

// Process the response

if (sCollisionStatus == NO_COLLISION)

{

// Store the UID and keep track if the CT byte needs to be sent

bSendCT = Iso14443a_StoreUid(sUidProgress,&g_ui8TrfBuffer[0]);

// Issue Select command

if (Iso14443a_SelectCommand(sUidProgress,&g_pui8CompleteUid[g_ui8UidPos],bSendCT)) // Issue the Select Command

{

// If successful, use SAK information to determine if the UID is complete

if ((g_ui8Iso14443aSAK & BIT2) == 0x00)

{

// UID complete, set status to success

ui8Status = STATUS_SUCCESS;

sUidProgress = UID_COMPLETE;

if (g_sUidSize == ISO14443A_UID_UNKNOWN)

{

if (sUidProgress == CASCADE1)

{

g_sUidSize = ISO14443A_UID_SINGLE;

}

else if (sUidProgress == CASCADE2)

{

g_sUidSize = ISO14443A_UID_DOUBLE;

}

else if (sUidProgress == CASCADE3)

{

g_sUidSize = ISO14443A_UID_TRIPLE;

}

}

}

else

{

// UID is not Complete, increase cascade level, update UidSize as well

if (sUidProgress == CASCADE1)

{

sUidProgress = CASCADE2;

if (g_sUidSize == ISO14443A_UID_UNKNOWN)

{

g_sUidSize = ISO14443A_UID_DOUBLE;

}

}

else if (sUidProgress == CASCADE2)

{

sUidProgress = CASCADE3;

if (g_sUidSize == ISO14443A_UID_UNKNOWN)

{

g_sUidSize = ISO14443A_UID_TRIPLE;

}

}

else

{

// Either Cascade was already CASCADE3 or an error occured, so break to hit re-try loop

sUidProgress = UID_INCOMPLETE;

break;

}

}

}

else

{

// Break to hit the re-try loop

sUidProgress = UID_INCOMPLETE;

break;

}

}

else if (sCollisionStatus == COLLISION)

{

Report("COLLISION Occurred\n\r");

// If a collision occurs, call the Anticollision loop to handle tag collisions

sCollisionStatus = Iso14443a_AnticollisionLoop(sUidProgress);

// Check if the anticollision loop is successful

if (sCollisionStatus == NO_COLLISION)

{

// If successful, use SAK information to determine if the UID is complete

if ((g_ui8Iso14443aSAK & BIT2) == 0x00)

{

// UID complete, set status to success

ui8Status = STATUS_SUCCESS;

sUidProgress = UID_COMPLETE;

}

else

{

// UID is not Complete, increase cascade level, update UidSize as well

if (sUidProgress == CASCADE1)

{

sUidProgress = CASCADE2;

}

else if (sUidProgress == CASCADE2)

{

sUidProgress = CASCADE3;

}

else

{

// Either Cascade was already CASCADE3 or an error occured, so break to hit re-try loop

sUidProgress = UID_INCOMPLETE;

break;

}

}

}

else

{

break;

}

}

else

{

// Other error occurred, do not proceed

sUidProgress = UID_INCOMPLETE;

g_ui8RecursionCount = 0; // Reset the recursion count for the anticollision loops

return ui8Status;

}

}

if (sUidProgress == UID_INCOMPLETE)

{ // Some error occurred, attempt to find the tag again

if (g_ui8RecursionCount < g_ui8MaxRecurviseCalls)

{

Report("UID Incomplete: Recursively calling TAG find\n\r");

g_ui8RecursionCount++;

ui8Status = Iso14443a_TagSelection(ui8Command);

}

else

{

g_ui8RecursionCount = 0; // Reset the recursion count for the anticollision loops

return ui8Status;

}

}

// This won't repetively trigger after the recursive call of Iso14443a_TagSelection since the sUidProgress will not change

if (sUidProgress == UID_COMPLETE)

{

#ifdef ENABLE_HOST

// UID Completed

UartPutCrlf();

Report("Anticollison Completed");

UartPutCrlf();

// Output UID to UART Terminal

Report("ISO14443A UID: ");

UartPutChar('[');

if (g_sUidSize == ISO14443A_UID_UNKNOWN) // Assume ID is a single if it has not been defined to this point.

{

g_sUidSize = ISO14443A_UID_SINGLE;

}

for (ui8LoopCount=0; ui8LoopCount<g_sUidSize; ui8LoopCount++)

{

UartPutByte(g_pui8CompleteUid[ui8LoopCount]);

}

UartPutChar(']');

UartPutCrlf();

#endif

// Output compliance to ISO14443-4

if (g_ui8Iso14443aSAK & BIT5)

{

#ifdef ENABLE_HOST

Report("Tag is ISO14443-4 Compliant");

UartPutCrlf();

#endif

g_bType4ACompliant = true;

}

else

{

#ifdef ENABLE_HOST

Report("Tag is not ISO14443-4 Compliant");

UartPutCrlf();

#endif

g_bType4ACompliant = false;

}

#ifdef ENABLE_HOST

UartPutCrlf();

#endif

}

g_ui8RecursionCount = 0; // Reset the recursion count for the anticollision loops after anticollision is finished

return ui8Status;

}

//===============================================================

//

// Iso14443a_AnticollisionLoop - Issue the polling command for

// ISO14443A compliant tags.

//

// \param sCascade is the current anticollision cascade.

//

// This function handles the ISO14443A anticollision procedures

// including dealing with receiving broken bytes and issuing

// anticollisions based on those broken bytes. It will run until

// a complete UID is received unless an error occurs.

//

// This function uses a recursive call for the anticollision

// process.

//

// \return sStatus returns a status based on what tag response is

// received following the most recently issued Anticollision

// command.

//

//===============================================================

tCollisionStatus Iso14443a_AnticollisionLoop(tISO14443A_UidStatus sCascade)

{

u08_t ui8NVB = NVB_INIT;

u08_t ui8NVBytes = 0;

u08_t ui8NVBits = 0;

u08_t ui8NVBitCount = 0;

u08_t ui8CollisionPosition = 0;

u08_t ui8LoopCount = 0;

tCollisionStatus sStatus = COLLISION;

// Note: The g_ui8UidPos will be used differently in this function in that it will track where to place received

// valid UID bytes rather than mark the location of the first byte as it does in all other functions.

// When a full UID is received, the Iso14443a_StoreUid function will be called which will restore the g_ui8UidPos

// value to what is expected by the rest of the firmware. If a microcontroller with larger RAM reserves is used,

// a seperate global variable could be used instead.

ui8CollisionPosition = Trf797xGetCollisionPosition(); // Get the collision position information from the TRF driver

ui8NVBytes = (ui8CollisionPosition >> 4) - 2; // This represents the number of known valid bytes of the UID

ui8NVBitCount = ui8CollisionPosition & 0x07; // This represents the number of known valid bits of the UID (can't be more than 8 or else it would be a valid byte)

g_ui8ValidUidBitCount = ui8NVBitCount; // Set the valid bit count to be equal to the received value from the TRF

// Use the number of bits received to generate the value of the bits received so far

for(ui8LoopCount = 0; ui8LoopCount < ui8NVBitCount; ui8LoopCount++)

{

ui8NVBits = (ui8NVBits << 1) + 1; // Store the info for the valid bits

}

if (g_ui8ValidUidByteCount < ui8NVBytes)

{

if ((ui8NVBytes-g_ui8ValidUidByteCount) > 5)

{

sStatus = COLLISION_ERROR;

return sStatus;

}

// Store the received bytes of the UID in a storage buffer

for (ui8LoopCount = 0; ui8LoopCount < (ui8NVBytes-g_ui8ValidUidByteCount); ui8LoopCount++)

{

g_pui8PartialUid[ui8LoopCount+g_ui8UidPos] |= g_ui8TrfBuffer[ui8LoopCount];

}

g_ui8UidPos = ui8LoopCount+g_ui8UidPos; // Set the UID Position indicator to the next array index

if (g_ui8UidPos > 4)

{

sStatus = COLLISION_ERROR;

return sStatus;

}

g_ui8ValidUidByteCount = ui8NVBytes; // Set the Valid byte count equal to what was received by the TRF

// Store the received bits of the UID in a storage buffer

// "The valid bits shall be part of the UID CLn that was received before a collision occurred

// followed by a (0)b or (1)b, decided by the PCD. A typical implementation adds a (1)b."

if (g_ui8ValidUidBitCount < 7)

{

// Since the valid bits are not at the maximum amount of bits allowed, add the extra bit at the end of the UID

g_pui8PartialUid[g_ui8UidPos] = ((g_ui8TrfBuffer[g_ui8ValidUidByteCount] & ui8NVBits));

g_ui8ValidBits = g_pui8PartialUid[g_ui8UidPos]; // Save the current valid bits in a variable

// NVB is equivalent to the value received in the TRF797x Collision Position Register plus one for the extra bit added per the standard.

ui8NVB = ui8CollisionPosition+1; // "The PCD shall assign NVB with a value that specifies the number of valid bits of UID CLn."

g_ui8ValidUidBitCount++; // Increment the valid bit count by one to mark the extra bit which was added per specifications.

}

else

{

g_pui8PartialUid[g_ui8UidPos] = (g_ui8TrfBuffer[g_ui8ValidUidByteCount] & ui8NVBits);

g_ui8ValidBits = g_pui8PartialUid[g_ui8UidPos]; // Save the current valid bits in a variable

// NVB is equivalent to the value received in the TRF797x Collision Position Register plus one for the extra bit added per the standard.

ui8NVB = ui8CollisionPosition; // "The PCD shall assign NVB with a value that specifies the number of valid bits of UID CLn."

}

}

else

{

// Update the valid bits based on the current valid bits as well as the newly received valid bits from the tag response

// "The valid bits shall be part of the UID CLn that was received before a collision occurred

// followed by a (0)b or (1)b, decided by the PCD. A typical implementation adds a (1)b."

if (g_ui8ValidUidBitCount < 7)

{

// Since the valid bits are not at the maximum amount of bits allowed, add the extra bit at the end of the UID

g_pui8PartialUid[g_ui8UidPos] = (g_ui8ValidBits | ((g_ui8TrfBuffer[0] & ui8NVBits) << (g_ui8ValidUidBitCount-ui8NVBitCount)));

g_ui8ValidBits = g_pui8PartialUid[g_ui8UidPos]; // Save the current valid bits in a variable

ui8NVB = ui8CollisionPosition+1; // "The PCD shall assign NVB with a value that specifies the number of valid bits of UID CLn."

g_ui8ValidUidBitCount++; // Increment the valid bit count by one to mark the extra bit which was added per specifications.

}

else

{

g_pui8PartialUid[g_ui8UidPos] = (g_ui8ValidBits | ((g_ui8TrfBuffer[0] & ui8NVBits) << (g_ui8ValidUidBitCount-ui8NVBitCount)));

g_ui8ValidBits = g_pui8PartialUid[g_ui8UidPos]; // Save the current valid bits in a variable

ui8NVB = ui8CollisionPosition; // "The PCD shall assign NVB with a value that specifies the number of valid bits of UID CLn."

}

}

McuDelayMillisecond(1); // Small delay prior to sending out packet.

sStatus = Iso14443a_AnticollisionCommand(sCascade,ui8NVB,&g_pui8PartialUid[0]); // Issue anti-collision command with the partial UID

if (sStatus == NO_COLLISION)

{

// No Collision means the anticollision command was successful and the remaining bytes were received

g_pui8PartialUid[g_ui8UidPos] = g_pui8PartialUid[g_ui8UidPos] | g_ui8TrfBuffer[0]; // Combine broken byte with 1st received byte to finalize the 1st byte of the UID

g_ui8UidPos++; // Increment the UID Position Indicator

g_ui8ValidUidBitCount = 0; // Reset the valid bit counter

g_ui8ValidBits = 0; // Reset the valid bit variable

// Store the other bytes

for (ui8LoopCount = 0; ui8LoopCount < (5-g_ui8UidPos); ui8LoopCount++)

{

g_pui8PartialUid[ui8LoopCount+g_ui8UidPos] = g_ui8TrfBuffer[(ui8LoopCount+1)]; // Store remaining received UID bytes into the partial UID buffer

}

// Issue the Select Command with the fully received UID

if (Iso14443a_SelectCommand(sCascade,&g_pui8PartialUid[0],false))

{

// Received the SAK from the Select Command (This is stored in a global within the Select function)

// If the UID Size is not known yet

if (g_sUidSize == ISO14443A_UID_UNKNOWN)

{

// Use SAK information to determine if the UID is complete

if ((g_ui8Iso14443aSAK & BIT2) == 0x00)

{

if (sCascade == CASCADE1)

{

g_sUidSize = ISO14443A_UID_SINGLE;

}

else if (sCascade == CASCADE2)

{

g_sUidSize = ISO14443A_UID_DOUBLE;

}

else if (sCascade == CASCADE3)

{

g_sUidSize = ISO14443A_UID_TRIPLE;

}

}

else

{

// UID is not complete, update UidSize as well

if (sCascade == CASCADE1)

{

g_sUidSize = ISO14443A_UID_DOUBLE;

}

else if (sCascade == CASCADE2)

{

g_sUidSize = ISO14443A_UID_TRIPLE;

}

}

}

// Store the partial UID into the global UID buffer

Iso14443a_StoreUid(sCascade,&g_pui8PartialUid[0]);

// Clear partial UID buffer in order to handle future collisions

for (ui8LoopCount = 0; ui8LoopCount < 5; ui8LoopCount++)

{

g_pui8PartialUid[ui8LoopCount] = 0x00;

}

// Set status to NO_COLLISION and exit function

sStatus = NO_COLLISION;

return sStatus;

}

else

{

sStatus = COLLISION_ERROR;

}

}

else if (sStatus == COLLISION)

{

// If a collision occurred, check the Recursion Counter and then call Anticollision Loop function again if the condition is met

if (g_ui8RecursionCount < g_ui8MaxRecurviseCalls)

{

g_ui8RecursionCount++; // Increment Recursion Counter

sStatus = Iso14443a_AnticollisionLoop(sCascade); // Recursive call of Anticollision Loop

}

else

{

sStatus = COLLISION_ERROR;

}

}

else

{

// For all other statuses, return the status that was received

}

return sStatus;

}

//===============================================================

//

// Iso14443a_PollingCommand - Issue the polling command for

// ISO14443A compliant tags.

//

// \param ui8Command is the polling command to be issued.

//

// This function sends the Polling command based on the inputted

// command (either REQA or WUPA).

//

// \return ui8Status returns whether or not an ISO14443A

// compliant tag has responded to the Polling command.

//

//===============================================================

u08_t Iso14443a_PollingCommand(u08_t ui8Command)

{

u08_t ui8Offset = 0;

u08_t ui8Status = STATUS_FAIL;

if (Trf797xGetIsoControlValue() != 0x88)

{

// Trf797x has not been properly configured for ISO14443A

Trf797xWriteIsoControl(0x88); // Configure the TRF797x for ISO14443A @ 106kbps and Receive without CRC

}

if (Trf797xCheckRfField() == false)

{

// RF field is not enabled, VICC will not receive the command

Trf797xTurnRfOn(); // Ensure TRF797x is outputting an RF Field

// When a PICC is exposed to an unmodulated operating field

// it shall be able to accept a quest within 5 ms.

// PCDs should periodically present an unmodulated field of at least

// 5.1 ms duration. (ISO14443-3)

McuDelayMillisecond(6);

}

g_ui8TrfBuffer[ui8Offset++] = 0x8F; // Reset FIFO

g_ui8TrfBuffer[ui8Offset++] = 0x90; // Send without CRC

g_ui8TrfBuffer[ui8Offset++] = 0x3D; // Write Continuous

g_ui8TrfBuffer[ui8Offset++] = 0x00; // Length of packet in bytes - upper and middle nibbles of transmit byte length

g_ui8TrfBuffer[ui8Offset++] = 0x0F; // Length of packet in bytes - lower and broken nibbles of transmit byte length

g_ui8TrfBuffer[ui8Offset++] = ui8Command; // Send the polling command from function input - either REQA (0x26) or WUPA (0x52)

Trf797xRawWrite(&g_ui8TrfBuffer[0], ui8Offset); // Issue the ISO14443A Polling Command

Trf797xIrqWaitTimeout(3,30); // 3 millisecond TX timeout, 10 millisecond RX timeout

g_sTrfStatus = Trf797xGetTrfStatus();

//Report("Querying Iso14443a_PollingCommand status\n\r");

//StatusPrint(g_sTrfStatus);

if (g_sTrfStatus == RX_COMPLETE) // Tag detected - could be either a single or collided tag

{

ui8Status = STATUS_SUCCESS;

}

else if (g_sTrfStatus == PROTOCOL_ERROR)

{

ui8Status = STATUS_SUCCESS; // "A PCD detecting a collision in any bit of (b16 to b1) shall commence with the first step of the anticollision loop."

}

return ui8Status;

}

//===============================================================

//

// Iso14443a_AnticollisionCommand - Issue Anticollsion command

// for ISO14443A compliant tags.

//

// \param sCascade is the current anticollision cascade

// \param ui8NVB is the NVB value for the UID bytes and bits

// \param pui8UID is the location of the UID bytes/bits to send.

//

// This function sends the Anticollision command based on the

// current cascade level.

//

// \return sStatus returns a status based on what tag response is

// received following the Anticollision command.

//

//===============================================================

tCollisionStatus Iso14443a_AnticollisionCommand(tISO14443A_UidStatus sCascade, u08_t ui8NVB, u08_t * pui8UID)

{

u08_t ui8Offset = 0;

u08_t ui8LoopCount = 0;

u08_t ui8UidLength = 0;

u08_t ui8RxLength = 0;

u08_t ui8Select = SEL_CASCADE1;

tCollisionStatus sStatus = NO_COLLISION;

if (sCascade == CASCADE1)

{

ui8Select = SEL_CASCADE1;

}

else if (sCascade == CASCADE2)

{

ui8Select = SEL_CASCADE2;

}

else if (sCascade == CASCADE3)

{

ui8Select = SEL_CASCADE3;

}

else

{

return sStatus = COLLISION_ERROR;

}

if (Trf797xGetIsoControlValue() != 0x88)

{

// Trf797x has not been properly configured for ISO14443A with no RX CRC

Trf797xWriteIsoControl(0x88); // Configure the TRF797x for ISO14443A @ 106kbps and Receive without CRC

}

if (Trf797xCheckRfField() == false)

{

// RF field is not enabled, VICC will not receive the command

Trf797xTurnRfOn(); // Ensure TRF797x is outputting an RF Field

// When a PICC is exposed to an unmodulated operating field

// it shall be able to accept a quest within 5 ms.

// PCDs should periodically present an unmodulated field of at least

// 5.1 ms duration. (ISO14443-3)

McuDelayMillisecond(6);

}

g_ui8TrfBuffer[ui8Offset++] = 0x8F; // Reset FIFO

g_ui8TrfBuffer[ui8Offset++] = 0x90; // Transmit without CRC

g_ui8TrfBuffer[ui8Offset++] = 0x3D; // Write Continuous

g_ui8TrfBuffer[ui8Offset++] = 0x00; // Length of packet in bytes - upper and middle nibbles of transmit byte length

if((ui8NVB & 0x07) != 0x00) // Length of packet in bytes - lower nibble and broken bits of transmit byte length

{

g_ui8TrfBuffer[ui8Offset++] = (ui8NVB & 0xF0) | (((ui8NVB & 0x07) << 1) + 1); // Set the number of broken bits, last bit is 1 means broken byte

}

else

{

g_ui8TrfBuffer[ui8Offset++] = ui8NVB & 0xF0; // No broken bits

}

g_ui8TrfBuffer[ui8Offset++] = ui8Select; // Select Command; can be 0x93, 0x95 or 0x97

g_ui8TrfBuffer[ui8Offset++] = ui8NVB; // Number of valid bits

ui8UidLength = (ui8NVB >> 4) - 2;

if ((ui8NVB & 0x0F) != 0x00)

{

ui8UidLength++;

}

for (ui8LoopCount = 0; ui8LoopCount < ui8UidLength; ui8LoopCount++)

{

g_ui8TrfBuffer[ui8Offset++] = pui8UID[ui8LoopCount]; // UID Bytes

}

Trf797xRawWrite(&g_ui8TrfBuffer[0], ui8Offset); // Issue the Select Command

Trf797xIrqWaitTimeout(25,50); // 5 millisecond TX timeout, 15 millisecond RX timeout

g_sTrfStatus = Trf797xGetTrfStatus();

if (g_sTrfStatus == RX_COMPLETE)

{

ui8RxLength = Trf797xGetRxBytesReceived();

if (ui8RxLength > 1)

{

sStatus = NO_COLLISION;

}

else

{

sStatus = COLLISION_ERROR;

}

}

else if (g_sTrfStatus == PROTOCOL_ERROR)

{

sStatus = COLLISION;

}

else if (g_sTrfStatus == NO_RESPONSE_RECEIVED)

{

sStatus = NO_RESPONSE;

}

else

{

// Do nothing

sStatus = COLLISION_ERROR;

}

return sStatus;

}

//===============================================================

//

// Iso14443a_SelectCommand - Issue Select command for ISO14443A

// compliant tags.

//

// \param sCascade is the current anticollision cascade.

// \param pui8UID is the location of the UID bytes to send.

// \param bSendCT determines if the CT byte must be sent.

//

// This function issues the Select command based on the current

// cascade level.

//

// \return ui8Status returns whether or not an ISO14443A

// compliant tag has responded to the Select command.

//

//===============================================================

u08_t Iso14443a_SelectCommand(tISO14443A_UidStatus sCascade, u08_t * pui8UID, bool bSendCT)

{

u08_t ui8Offset = 0;

u08_t ui8Status = STATUS_FAIL;

u08_t ui8Select = SEL_CASCADE1;

// Sending select command and will receive a SAK response which has a CRC.

if (Trf797xGetIsoControlValue() != 0x08)

{

// Trf797x has not been properly configured for ISO14443A with RX CRC

Trf797xWriteIsoControl(0x08); // Configure the TRF797x for ISO14443A @ 106kbps and Receive with CRC

}

if (Trf797xCheckRfField() == false)

{

// RF field is not enabled, VICC will not receive the command

Trf797xTurnRfOn(); // Ensure TRF797x is outputting an RF Field

// When a PICC is exposed to an unmodulated operating field

// it shall be able to accept a quest within 5 ms.

// PCDs should periodically present an unmodulated field of at least

// 5.1 ms duration. (ISO14443-3)

McuDelayMillisecond(10);

}

if (sCascade == CASCADE1)

{

ui8Select = SEL_CASCADE1;

}

else if (sCascade == CASCADE2)

{

ui8Select = SEL_CASCADE2;

}

else if (sCascade == CASCADE3)

{

ui8Select = SEL_CASCADE3;

}

else

{

return ui8Status = STATUS_FAIL;

}

g_ui8TrfBuffer[ui8Offset++] = 0x8F; // Reset FIFO

g_ui8TrfBuffer[ui8Offset++] = 0x91; // Transmit with CRC

g_ui8TrfBuffer[ui8Offset++] = 0x3D; // Write Continuous

g_ui8TrfBuffer[ui8Offset++] = 0x00; // Length of packet in bytes - upper and middle nibbles of transmit byte length

g_ui8TrfBuffer[ui8Offset++] = 0x70; // Length of packet in bytes - lower and broken nibbles of transmit byte length

g_ui8TrfBuffer[ui8Offset++] = ui8Select; // Select Command; can be 0x93, 0x95 or 0x97

g_ui8TrfBuffer[ui8Offset++] = NVB_FULL; // Number of valid bits

if (bSendCT == true)

{

g_ui8TrfBuffer[ui8Offset++] = 0x88; // CT

g_ui8TrfBuffer[ui8Offset++] = *pui8UID; // UID Bytes

g_ui8TrfBuffer[ui8Offset++] = *(pui8UID + 1);

g_ui8TrfBuffer[ui8Offset++] = *(pui8UID + 2);

g_ui8TrfBuffer[ui8Offset++] = ( 0x88 ^ *pui8UID ^ *(pui8UID + 1) ^ *(pui8UID + 2) ); // Calculate BCC Byte

}

else

{

g_ui8TrfBuffer[ui8Offset++] = *pui8UID; // UID Bytes

g_ui8TrfBuffer[ui8Offset++] = *(pui8UID + 1);

g_ui8TrfBuffer[ui8Offset++] = *(pui8UID + 2);

g_ui8TrfBuffer[ui8Offset++] = *(pui8UID + 3);

g_ui8TrfBuffer[ui8Offset++] = ( *pui8UID ^ *(pui8UID + 1) ^ *(pui8UID + 2) ^ *(pui8UID + 3) ); // Calculate BCC Byte

}

Trf797xRawWrite(&g_ui8TrfBuffer[0], ui8Offset); // Issue the Select Command

Trf797xIrqWaitTimeout(20,80); // 5 millisecond TX timeout, 15 millisecond RX timeout

g_sTrfStatus = Trf797xGetTrfStatus();

//Report("Iso14443a_SelectCommand trfStatus: ");

//StatusPrint(g_sTrfStatus);

if (g_sTrfStatus == RX_COMPLETE)

{

ui8Status = STATUS_SUCCESS;

g_ui8Iso14443aSAK = g_ui8TrfBuffer[0];

}

else

{

// Do nothing

}

return ui8Status;

}

//===============================================================

//

// Iso14443a_Halt - Issue the Halt command to the currently

// selected ISO14443A compliant tag.

//

// This function sends the Polling command based on the inputted

// command (either REQA or WUPA).

//

// \return ui8Status returns STATUS_FAIL if the tag erroneously

// responded to the Halt command.

//

//===============================================================

u08_t Iso14443a_Halt(void)

{

u08_t ui8Offset = 0;

if (Trf797xGetIsoControlValue() != 0x88)

{

// Trf797x has not been properly configured for ISO14443A

Trf797xWriteIsoControl(0x88); // Configure the TRF797x for ISO14443A @ 106kbps and Receive without CRC

}

if (Trf797xCheckRfField() == false)

{

// RF field is not enabled, VICC will not receive the command

Trf797xTurnRfOn(); // Ensure TRF797x is outputting an RF Field

// When a PICC is exposed to an unmodulated operating field

// it shall be able to accept a quest within 5 ms.

// PCDs should periodically present an unmodulated field of at least

// 5.1 ms duration. (ISO14443-3)

McuDelayMillisecond(6);

}

g_ui8TrfBuffer[ui8Offset++] = 0x8F; // Reset FIFO

g_ui8TrfBuffer[ui8Offset++] = 0x90; // Send without CRC

g_ui8TrfBuffer[ui8Offset++] = 0x3D; // Write Continuous

g_ui8TrfBuffer[ui8Offset++] = 0x00; // Length of packet in bytes - upper and middle nibbles of transmit byte length

g_ui8TrfBuffer[ui8Offset++] = 0x20; // Length of packet in bytes - lower and broken nibbles of transmit byte length

g_ui8TrfBuffer[ui8Offset++] = 0x50; // Halt Command

g_ui8TrfBuffer[ui8Offset++] = 0x00;

Trf797xRawWrite(&g_ui8TrfBuffer[0], ui8Offset); // Issue the Halt Command

Trf797xIrqWaitTimeout(3,10); // 3 millisecond TX timeout, 10 millisecond RX timeout

g_sTrfStatus = Trf797xGetTrfStatus();

if (g_sTrfStatus != NO_RESPONSE_RECEIVED) // If PICC gives a response to the command, this means the Halt command failed or had an error

{

g_sTrfStatus = PROTOCOL_ERROR;

Trf797xSetTrfStatus(g_sTrfStatus);

#ifdef ENABLE_HOST

Report("Halt command error \n \r");

#endif

return STATUS_FAIL;

}

else

{

return STATUS_SUCCESS;

}

}

//===================================================================

//

// Iso14443a_Rats - Issue the RATS command to the currently selected

// ISO14443A compliant tag.

//

// This function sends the RATS command to activate an ISO14443A

// compliant tag for data exchange.

//

// \return ui8Status returns whether or not the selected ISO14443A

// compliant tag responded to the RATS command.

//

//===================================================================

u08_t Iso14443a_Rats(void)

{

u08_t ui8Offset = 0;

u08_t ui8RxLength = 0;

u08_t ui8Status = STATUS_FAIL;

#ifdef ENABLE_HOST

u08_t ui8LoopCount = 0;

#endif

if (Trf797xGetIsoControlValue() != 0x08)

{

// Trf797x has not been properly configured for ISO14443A

Trf797xWriteIsoControl(0x08); // Configure the TRF797x for ISO14443A @ 106kbps and Receive with CRC

}

if (Trf797xCheckRfField() == false)

{

// RF field is not enabled, VICC will not receive the command

Trf797xTurnRfOn(); // Ensure TRF797x is outputting an RF Field

// When a PICC is exposed to an unmodulated operating field

// it shall be able to accept a quest within 5 ms.

// PCDs should periodically present an unmodulated field of at least

// 5.1 ms duration. (ISO14443-3)

McuDelayMillisecond(6);

}

// Buffer setup for FIFO writing

g_ui8TrfBuffer[ui8Offset++] = 0x8F; // Reset FIFO

g_ui8TrfBuffer[ui8Offset++] = 0x91; // Send with CRC

g_ui8TrfBuffer[ui8Offset++] = 0x3D; // Write Continuous

g_ui8TrfBuffer[ui8Offset++] = 0x00; // Length of packet in bytes - upper and middle nibbles of transmit byte length

g_ui8TrfBuffer[ui8Offset++] = 0x20; // Length of packet in bytes - lower and broken nibbles of transmit byte length

g_ui8TrfBuffer[ui8Offset++] = RATS_CMD; //RATS Command

g_ui8TrfBuffer[ui8Offset++] = RATS_PARAM; //RATS Parameters: 128 byte max receive and CID = 0

Trf797xRawWrite(&g_ui8TrfBuffer[0], ui8Offset); // Issue the RATS command

Trf797xIrqWaitTimeout(3,10); // 3 millisecond TX timeout, 10 millisecond RX timeout

g_sTrfStatus = Trf797xGetTrfStatus();

// If data received

if(g_sTrfStatus == RX_COMPLETE)

{

ui8RxLength = Trf797xGetRxBytesReceived();

if (g_ui8TrfBuffer[0] == ui8RxLength)

{

ui8Status = STATUS_SUCCESS;

ui8Offset = 0;

// Print out TL

#ifdef ENABLE_HOST

Report("ISO14443A ATS Response - TL: ");

UartPutByte(g_ui8TrfBuffer[ui8Offset++]);

UartPutCrlf();

// If TL is greater than 1, at minimum Format Byte T0 will be present

if (g_ui8TrfBuffer[0] > 1)

{

// Print out the value of T0

Report("ISO14443A ATS Response - T0: ");

UartPutByte(g_ui8TrfBuffer[ui8Offset++]);

UartPutCrlf();

if (g_ui8TrfBuffer[1] & 0x10)

{

g_ui8AtsSupportedBitrates = g_ui8TrfBuffer[ui8Offset++];

// TA(1) has been received, print it out

Report("ISO14443A ATS Response - TA(1): ");

UartPutByte(g_ui8AtsSupportedBitrates);

UartPutCrlf();

}

if (g_ui8TrfBuffer[1] & 0x20)

{

// TB(1) has been received, print it out

Report("ISO14443A ATS Response - TB(1): ");

UartPutByte(g_ui8TrfBuffer[ui8Offset++]);

UartPutCrlf();

}

if (g_ui8TrfBuffer[1] & 0x40)

{

// TC(1) has been received, print it out

Report("ISO14443A ATS Response - TC(1): ");

UartPutByte(g_ui8TrfBuffer[ui8Offset++]);

UartPutCrlf();

}

if (ui8RxLength > ui8Offset)

{

// Historical Bytes have been received, print out all of them

Report("ISO14443A ATS Response - Historical Bytes: ");

for (ui8LoopCount = ui8Offset; ui8LoopCount < ui8RxLength; ui8LoopCount++)

{

UartPutByte(g_ui8TrfBuffer[ui8LoopCount]);

}

UartPutCrlf();

}

}

UartPutCrlf();

#endif

}

else

{

ui8Status = STATUS_FAIL;

}

}

else

{

ui8Status = STATUS_FAIL;

}

return ui8Status;

}

//===================================================================

//

// Iso14443a_Pps - Issue the PPS command to the currently selected

// ISO14443A compliant tag.

//

// This function sends the PPS command to modify the over the air

// data rate of the selected ISO14443A compliant tag.

//

// \return ui8Status returns whether or not the selected ISO14443A

// compliant tag responded to the PPS command.

//

//===================================================================

u08_t Iso14443a_Pps(void)

{

u08_t ui8Offset = 0;

u08_t ui8Status = STATUS_FAIL;

u08_t ui8PPSBitrate;

// Check if PPS is supported based on last received ATS reply

if ((g_ui8AtsSupportedBitrates == 0x00) || (g_ui8AtsSupportedBitrates == 0x80))

{

#ifdef ENABLE_HOST

Report("Tag does not support data rates above 106kbps. No PPS issued.");

UartPutCrlf();

UartPutCrlf();

#endif

return ui8Status = STATUS_SUCCESS;

}

if (Trf797xGetIsoControlValue() != 0x08)

{

// Trf797x has not been properly configured for ISO14443A

Trf797xWriteIsoControl(0x08); // Configure the TRF797x for ISO14443A @ 106kbps and Receive with CRC

}

if (Trf797xCheckRfField() == false)

{

// RF field is not enabled, VICC will not receive the command

Trf797xTurnRfOn(); // Ensure TRF797x is outputting an RF Field

// When a PICC is exposed to an unmodulated operating field

// it shall be able to accept a quest within 5 ms.

// PCDs should periodically present an unmodulated field of at least

// 5.1 ms duration. (ISO14443-3)

McuDelayMillisecond(6);

}

ui8PPSBitrate = PPS1_106; // Set the PPS bit rate to 106kbps for best range performance

// It is recommended to keep the data rate low to get better transmission ranges

// Buffer setup for FIFO writing

g_ui8TrfBuffer[ui8Offset++] = 0x8F; // Reset FIFO

g_ui8TrfBuffer[ui8Offset++] = 0x91; // Send with CRC

g_ui8TrfBuffer[ui8Offset++] = 0x3D; // Write Continuous

g_ui8TrfBuffer[ui8Offset++] = 0x00; // Length of packet in bytes - upper and middle nibbles of transmit byte length

g_ui8TrfBuffer[ui8Offset++] = 0x30; // Length of packet in bytes - lower and broken nibbles of transmit byte length

g_ui8TrfBuffer[ui8Offset++] = PPSS; // PPS Command

g_ui8TrfBuffer[ui8Offset++] = PPS0;

g_ui8TrfBuffer[ui8Offset++] = ui8PPSBitrate; // Send PPS Bit Rate

Trf797xRawWrite(&g_ui8TrfBuffer[0], ui8Offset); // Issue the PPS Command

Trf797xIrqWaitTimeout(3,10); // 3 millisecond TX timeout, 10 millisecond RX timeout

g_sTrfStatus = Trf797xGetTrfStatus();

// If data received

if(g_sTrfStatus == RX_COMPLETE)

{

// Check PPS response

if (g_ui8TrfBuffer[0] == PPSS)

{

ui8Status = STATUS_SUCCESS;

// Execute Bitrate Change

McuDelayMillisecond(1);

if (ui8PPSBitrate == PPS1_106)

{

Trf797xWriteIsoControl(0x08); // Configure the TRF797x for ISO14443A @ 106kbps and Receive with CRC

#ifdef ENABLE_HOST

Report("PPS Successful: ISO14443A Bit Rate Set to 106kpbs");

UartPutCrlf();

UartPutCrlf();

#endif

}

else if (ui8PPSBitrate == PPS1_212)

{

Trf797xWriteIsoControl(0x09); // Configure the TRF797x for ISO14443A @ 212kbps and Receive with CRC

#ifdef ENABLE_HOST

Report("PPS Successful: ISO14443A Bit Rate Set to 212kpbs");

UartPutCrlf();

UartPutCrlf();

#endif

}

else if (ui8PPSBitrate == PPS1_424)

{

Trf797xWriteIsoControl(0x0A); // Configure the TRF797x for ISO14443A @ 424kbps and Receive with CRC

#ifdef ENABLE_HOST

Report("PPS Successful: ISO14443A Bit Rate Set to 424kpbs");

UartPutCrlf();

UartPutCrlf();

#endif

}

else if (ui8PPSBitrate == PPS1_848)

{

Trf797xWriteIsoControl(0x0B); // Configure the TRF797x for ISO14443A @ 848kbps and Receive with CRC

#ifdef ENABLE_HOST

Report("PPS Successful: ISO14443A Bit Rate Set to 848kpbs");

UartPutCrlf();

UartPutCrlf();

#endif

}

else

{

// Do Nothing

}

McuDelayMillisecond(6);

}

else

{

ui8Status = STATUS_FAIL;

#ifdef ENABLE_HOST

Report("Error: PPS Reply Does Not Match Transmitted Frame");

UartPutCrlf();

#endif

}

}

else

{

ui8Status = STATUS_FAIL;

#ifdef ENABLE_HOST

Report("Error: PPS Reply Not Received");

UartPutCrlf();

#endif

}

return ui8Status;

}

//===============================================================

//

// Iso14443a_StoreUid - Store the received UID bytes into the

// global g_pui8CompleteUid buffer.

//

// \param sCascade is the current anticollision cascade.

// \param pui8UID is the location of the UID bytes to store.

//

// This function stores the received UID bytes into the global

// UID buffer. It will also parse out the CT byte and set a flag

// to indicate if the CT byte was present.

//

// \return bSendCT returns whether or not the next transmission

// will require the CT byte to be sent in addition to the UID

// bytes.

//

//===============================================================

bool Iso14443a_StoreUid(tISO14443A_UidStatus sCascade, u08_t * pui8UID)

{

bool bSendCT = false;

u08_t ui8Offset = 0;

if ((g_sUidSize == ISO14443A_UID_SINGLE) && (sCascade == CASCADE1))

{

// UID has no CT, so store all bytes normally.

ui8Offset = 0;

bSendCT = false;

}

else if ((g_sUidSize == ISO14443A_UID_DOUBLE) && (sCascade == CASCADE2))

{

// UID has no CT, so store all bytes normally.

ui8Offset = 0;

bSendCT = false;

}

else if ((g_sUidSize == ISO14443A_UID_TRIPLE) && (sCascade == CASCADE3))

{

// UID has no CT, so store all bytes normally.

ui8Offset = 0;

bSendCT = false;

}

else

{

if (pui8UID[0] == 0x88)

{

// UID has a CT, set bool to return that a CT must be sent

ui8Offset = 1; // Set offset to account for the location of the CT byte

bSendCT = true; // Set variable to tell Select Command to include a CT in addition to UID bytes

}

else

{

// UID has no CT, so store all bytes normally.

ui8Offset = 0;

bSendCT = false;

}

}

// Store UID based on the current Cascade level

if (sCascade == CASCADE1)

{

g_pui8CompleteUid[0] = pui8UID[0+ui8Offset];

g_pui8CompleteUid[1] = pui8UID[1+ui8Offset];

g_pui8CompleteUid[2] = pui8UID[2+ui8Offset];

g_pui8CompleteUid[3] = pui8UID[3+ui8Offset]; // BCC Byte or last byte of UID

g_ui8UidPos = 0; // Update the UID Position indicator to the first byte of the newly stored UID for when the Select command is issued

}

else if (sCascade == CASCADE2)

{

g_pui8CompleteUid[3] = pui8UID[0+ui8Offset]; // Override the BCC from prior Cascade as it is no longer needed

g_pui8CompleteUid[4] = pui8UID[1+ui8Offset];

g_pui8CompleteUid[5] = pui8UID[2+ui8Offset];

g_pui8CompleteUid[6] = pui8UID[3+ui8Offset]; // BCC Byte or last byte of UID

g_ui8UidPos = 3; // Update the UID Position indicator to the first byte of the newly stored UID for when the Select command is issued

}

else if (sCascade == CASCADE3)

{

g_pui8CompleteUid[6] = pui8UID[0]; // Override the BCC from prior Cascade as it is no longer needed

g_pui8CompleteUid[7] = pui8UID[1];

g_pui8CompleteUid[8] = pui8UID[2];

g_pui8CompleteUid[9] = pui8UID[3];

bSendCT = false; // Ensure no accidental sending of the CT occurs incase uid6 for a Triple Size UID = 0x88 (which is permitted per ISO14443-3 specifications)

g_ui8UidPos = 6; // Update the UID Position indicator to the first byte of the newly stored UID for when the Select command is issued

}

return bSendCT;

}

//===============================================================

//

// Iso14443a_Type2_Read4Blocks - Reads out four blocks of data

// from NFC Type 2 Tag Platforms.

//

// \param ui8StartBlock is the block number to start reading the

// tag data from.

//

// This function will issue a Read Block command with the

// provided starting block number. The Read Block command

// automatically will read out four blocks of data from the Type

// 2 Tag.

//

// \return ui8Status returns whether or not the tag data was

// successfully read.

//

//===============================================================

u08_t Iso14443a_Type2_Read4Blocks(u08_t ui8StartBlock)

{

u08_t ui8Offset = 0;

u08_t ui8Status = STATUS_FAIL;

#ifdef ENABLE_HOST

u08_t ui8LoopCount1 = 1;

u08_t ui8LoopCount2 = 0;

#endif

if (Trf797xGetIsoControlValue() != 0x08)

{

// Trf797x has not been properly configured for ISO14443A

Trf797xWriteIsoControl(0x08); // Configure the TRF797x for ISO14443A @ 106kbps and Receive with CRC

}

if (Trf797xCheckRfField() == false)

{

// RF field is not enabled, VICC will not receive the command

Trf797xTurnRfOn(); // Ensure TRF797x is outputting an RF Field

// When a PICC is exposed to an unmodulated operating field

// it shall be able to accept a quest within 5 ms.

// PCDs should periodically present an unmodulated field of at least

// 5.1 ms duration. (ISO14443-3)

McuDelayMillisecond(6);

}

g_ui8TrfBuffer[ui8Offset++] = 0x8F; // Reset FIFO

g_ui8TrfBuffer[ui8Offset++] = 0x91; // Send with CRC

g_ui8TrfBuffer[ui8Offset++] = 0x3D; // Write Continuous

g_ui8TrfBuffer[ui8Offset++] = 0x00; // Length of packet in bytes - upper and middle nibbles of transmit byte length

g_ui8TrfBuffer[ui8Offset++] = 0x20; // Length of packet in bytes - lower and broken nibbles of transmit byte length

g_ui8TrfBuffer[ui8Offset++] = 0x30; // Read Command

g_ui8TrfBuffer[ui8Offset++] = ui8StartBlock; // Starting from Block # (called Bno)

Trf797xRawWrite(&g_ui8TrfBuffer[0], ui8Offset); // Issue the Type 2 Read Command

Trf797xIrqWaitTimeout(5,30); // 5 millisecond TX timeout, 30 millisecond RX timeout

g_sTrfStatus = Trf797xGetTrfStatus();

if(g_sTrfStatus == RX_COMPLETE) // If block data has been received

{

ui8Status = STATUS_SUCCESS; // Mark tag has been successfully read

#ifdef ENABLE_HOST

for(ui8LoopCount2 = 0; ui8LoopCount2 < 4; ui8LoopCount2++)

{

Report("NFC Type 2 Block ");

UartPutByte(ui8StartBlock++);

Report(": [");

for(ui8LoopCount1 = (ui8LoopCount2*4); ui8LoopCount1 < 4+(ui8LoopCount2*4); ui8LoopCount1++)

{

UartPutByte(g_ui8TrfBuffer[ui8LoopCount1]); // Print out the received data

}

UartPutChar(']');

UartPutCrlf();

}

#endif

}

else

{

// Otherwise return a fail

ui8Status = STATUS_FAIL;

}

return ui8Status;

}

//===============================================================

//

// Iso14443a_Get_Type4ACompliance - Fetches g_bType4ACompliant value

//

// This function allows for higher layers to fetch the current

// Type 4A NDEF compliance information.

//

// \return g_bType4ACompliant returns the current compliance for

// Type 4A NDEF.

//

//===============================================================

bool Iso14443a_Get_Type4ACompliance(void)

{

return g_bType4ACompliant;

}

//===============================================================

//

// Iso14443a_Set_RecursionCount - Sets the g_ui8RecursionCount

// variable

//

// \param

//

// This function allows for higher layers to adjust the global

// recursion count. Useful for resetting it prior to running

// anticollision routines.

//

// \return None.

//

//===============================================================

void Iso14443a_Set_RecursionCount(u08_t ui8RecursionCount)

{

g_ui8RecursionCount = ui8RecursionCount;

}

//===============================================================

//

// Iso14443a_Get_Uid - Fetches the ISO14443A Tag UID.

//

// This function allows for higher layers to fetch the tag UID of

// an ISO14443A tag. In the current implementation, the UID

// stored is from the most recent tag which finished the

// anticollision procedure.

//

// \return g_pui8CompleteUid returns the currently stored UID.

//

//===============================================================

u08_t * Iso14443a_Get_Uid(void)

{

return g_pui8CompleteUid;

}

//===============================================================

//

// Iso14443a_Get_UidSize - Fetches the UID size of the most

// recently read ISO14443A tag.

//

// This function allows for higher layers to fetch the size of

// the current UID for an ISO14443A tag.

//

// \return g_sUidSize returns the current UID size.

//

//===============================================================

tISO14443A_UidSize Iso14443a_Get_UidSize(void)

{

return g_sUidSize;

}

//===============================================================

//

// Nfc_Iso14443a_Type4NdefApp - Customizeable application to read

// NDEF data from a Type 4A NDEF Formatted tag.

//

// Tags which are Type 4 compliant are activated via RATS.

// If the tag contains an NDEF message, then the NDEF data is

// read from it.

//

// \return None.

//

//===============================================================

void Nfc_Iso14443a_Type4NdefApp(void)

{

if (Iso14443a_Rats() == STATUS_SUCCESS)

{

Ndef_SetBlockNumberBit(0);

if (NDEF_ApplicationSelect() == STATUS_SUCCESS) // Selects NDEF Application

{

Report("Payload Received: %s\n\r",g_ndef_content);

g_ndef_content_received = 1;

}

else

{

Report("ISO14443a: Select AID failure\n\r");

}

}

else

{

Report("ISO14443a: RATS Failure\n\r");

}

}

void ISO14443aFindTag(void)

{

Trf797xTurnRfOn(); // Ensure TRF797x is outputting an RF Field

Trf797xWriteInitiatorSetup(0x88); // Configure the TRF797x for ISO14443A @ 106kbps and Receive no CRC

IRQ_CLR; // PORT2 interrupt flag clear

IRQ_ON;

// When a PICC is exposed to an unmodulated operating field

// it shall be able to accept a quest within 5 ms.

// PCDs should periodically present an unmodulated field of at least

// 5.1 ms duration. (ISO14443-3)

McuDelayMillisecond(6);

Iso14443a_Set_RecursionCount(0); // Clear the recursion count for anticollision loops

if (Iso14443a_TagSelection(REQA) == STATUS_SUCCESS) // Do a complete anticollision sequence as described in ISO14443-3 standard for type A

{

if (Iso14443a_Get_Type4ACompliance() == true)

{

//Report("Type 4A Tag\n\r");

Nfc_Iso14443a_Type4NdefApp(); // For a Type 4A compliant tag, the tag is put into Layer 4, and in order to attempt to read/write NDEF contents

}

}

Trf797xTurnRfOff();

}

iso15693.h

/*

* {iso15693.h}

*

* {ISO15693 header file}

*

* Copyright (C) 2013 Texas Instruments Incorporated - http://www.ti.com/

*

*

* Redistribution and use in source and binary forms, with or without

* modification, are permitted provided that the following conditions

* are met:

*

* Redistributions of source code must retain the above copyright

* notice, this list of conditions and the following disclaimer.

*

* Redistributions in binary form must reproduce the above copyright

* notice, this list of conditions and the following disclaimer in the

* documentation and/or other materials provided with the

* distribution.

*

* Neither the name of Texas Instruments Incorporated nor the names of

* its contributors may be used to endorse or promote products derived

* from this software without specific prior written permission.

*

* THIS SOFTWARE IS PROVIDED BY THE COPYRIGHT HOLDERS AND CONTRIBUTORS

* "AS IS" AND ANY EXPRESS OR IMPLIED WARRANTIES, INCLUDING, BUT NOT

* LIMITED TO, THE IMPLIED WARRANTIES OF MERCHANTABILITY AND FITNESS FOR

* A PARTICULAR PURPOSE ARE DISCLAIMED. IN NO EVENT SHALL THE COPYRIGHT

* OWNER OR CONTRIBUTORS BE LIABLE FOR ANY DIRECT, INDIRECT, INCIDENTAL,

* SPECIAL, EXEMPLARY, OR CONSEQUENTIAL DAMAGES (INCLUDING, BUT NOT

* LIMITED TO, PROCUREMENT OF SUBSTITUTE GOODS OR SERVICES; LOSS OF USE,

* DATA, OR PROFITS; OR BUSINESS INTERRUPTION) HOWEVER CAUSED AND ON ANY

* THEORY OF LIABILITY, WHETHER IN CONTRACT, STRICT LIABILITY, OR TORT

* (INCLUDING NEGLIGENCE OR OTHERWISE) ARISING IN ANY WAY OUT OF THE USE

* OF THIS SOFTWARE, EVEN IF ADVISED OF THE POSSIBILITY OF SUCH DAMAGE.

*

*/

#ifndef _ISO15693_H_

#define _ISO15693_H_

//================================================================

#include "trf797x.h"

#include "types.h"

#include "uart.h"

//===============================================================

// Premade Request Flags

#define T5T_SINGLE_SLOT_INVENTORY 0x26 // Tables 3 & 5 in ISO15693-3; single-subcarrier, high tag data rate, one slot

#define T5T_SIXTEEN_SLOT_INVENTORY 0x06 // Tables 3 & 5 in ISO15693-3; single-subcarrier, high tag data rate, sixteen slots

// Individual Flags

#define T5T_REQ_FLAG_SUB_CARRIER 0x01

#define T5T_REQ_FLAG_HIGH_DATA 0x02

#define T5T_REQ_FLAG_INVENTORY 0x04

#define T5T_REQ_FLAG_EXTENDED 0x08

#define T5T_REQ_FLAG_SELECT 0x10

#define T5T_REQ_FLAG_ADDRESSED 0x20

#define T5T_REQ_FLAG_OPTION 0x40

#define T5T_INV_FLAG_AFI 0x10

#define T5T_INV_FLAG_SINGLE_SLOT 0x20

#define T5T_INV_FLAG_OPTION 0x40

#define T5T_RESP_FLAG_NO_ERROR 0x00

#define T5T_RESP_FLAG_EXTENDED 0x08

//===============================================================

u08_t Iso15693_SingleSlotInventory(void);

u08_t Iso15693_Anticollision(u08_t ui8ReqFlags, u08_t ui8MaskLength, u08_t ui8Afi);

u16_t Iso15693_GetSystemInfo(u08_t ui8ReqFlag);

u16_t Iso15693_GetSystemInfoExtended(u08_t ui8ReqFlag);

u08_t Iso15693_ReadSingleBlock(u08_t ui8ReqFlag, u08_t ui8BlockNumber);

u08_t Iso15693_ReadMultipleBlocks(u08_t ui8ReqFlag, u08_t ui8FirstBlock, u08_t ui8NumberOfBlocks);

u08_t Iso15693_ReadSingleBlockExtended(u08_t ui8ReqFlag, u16_t ui16StartBlock);

u08_t Iso15693_WriteSingleBlock(u08_t ui8ReqFlag, u08_t ui8BlockNumber, u08_t ui8BlockSize, u08_t * pui8BlockData);

u08_t * Iso15693_Get_Uid(void);

u08_t Iso15693_Get_TagCount(void);

void Iso15693_Reset_TagCount(void);

extern void ISO15693FindTag(void);

//===============================================================

#endif

iso15693.c

/*

* {iso15693.c}

*

* {ISO15693 Specific Functions & Anti-collision}

*

* Copyright (C) 2013 Texas Instruments Incorporated - http://www.ti.com/

*

*

* Redistribution and use in source and binary forms, with or without

* modification, are permitted provided that the following conditions

* are met:

*

* Redistributions of source code must retain the above copyright

* notice, this list of conditions and the following disclaimer.

*

* Redistributions in binary form must reproduce the above copyright

* notice, this list of conditions and the following disclaimer in the

* documentation and/or other materials provided with the

* distribution.

*

* Neither the name of Texas Instruments Incorporated nor the names of

* its contributors may be used to endorse or promote products derived

* from this software without specific prior written permission.

*

* THIS SOFTWARE IS PROVIDED BY THE COPYRIGHT HOLDERS AND CONTRIBUTORS

* "AS IS" AND ANY EXPRESS OR IMPLIED WARRANTIES, INCLUDING, BUT NOT

* LIMITED TO, THE IMPLIED WARRANTIES OF MERCHANTABILITY AND FITNESS FOR

* A PARTICULAR PURPOSE ARE DISCLAIMED. IN NO EVENT SHALL THE COPYRIGHT

* OWNER OR CONTRIBUTORS BE LIABLE FOR ANY DIRECT, INDIRECT, INCIDENTAL,

* SPECIAL, EXEMPLARY, OR CONSEQUENTIAL DAMAGES (INCLUDING, BUT NOT

* LIMITED TO, PROCUREMENT OF SUBSTITUTE GOODS OR SERVICES; LOSS OF USE,

* DATA, OR PROFITS; OR BUSINESS INTERRUPTION) HOWEVER CAUSED AND ON ANY

* THEORY OF LIABILITY, WHETHER IN CONTRACT, STRICT LIABILITY, OR TORT

* (INCLUDING NEGLIGENCE OR OTHERWISE) ARISING IN ANY WAY OUT OF THE USE

* OF THIS SOFTWARE, EVEN IF ADVISED OF THE POSSIBILITY OF SUCH DAMAGE.

*

*/

#include "hw_types.h"

#include <string.h>

#include <stdio.h>

#include "iso15693.h"

#include "trf7970BoosterPack.h"

#include "uart_if.h"

#include "timer.h"

#include "timer_if.h"

#include "utils.h"

#include "gpio.h"

#include "gpio_if.h"

#include "hw_memmap.h"

#include "uart_if.h"

#include "osi.h"

//===============================================================

// Global Variables

//===============================================================

extern uint8_t g_ui8TrfBuffer[NFC_FIFO_SIZE];

static volatile tTRF797x_Status g_sTrfStatus;

static uint8_t g_pui8Iso15693UId[8];

static uint8_t g_pui8AnticollisionMaskBuffer[8] = {0x00, 0x00, 0x00, 0x00, 0x00, 0x00, 0x00, 0x00};

static uint8_t g_ui8TagDetectedCount = 0;

//===============================================================

//

// Iso15693_SingleSlotInventory - Issue a single slot Inventory

// command for ISO15693 tags.

//

// This function issues a single slot Inventory command for tag

// detection of ISO15693 tags. If a tag is found, the UID is

// stored in the g_pui8Iso15693UId buffer.

//

// If UART is enabled, the tag ID is sent out to a host via UART

// as well.

//

// \return ui8Status returns either STATUS_SUCCESS or STATUS_FAIL

// to indicate if the Inventory command resulted in a successful

// tag detection or not.

//

//===============================================================

uint8_t Iso15693_SingleSlotInventory(void)

{

uint8_t ui8Offset = 0;

uint8_t ui8LoopCount = 0;

uint8_t ui8Status = STATUS_FAIL;

uint8_t ui8RssiLevel;

if (Trf797xGetIsoControlValue() != 0x02)

{

// Trf797x has not been properly configured for ISO15693

Trf797xWriteIsoControl(0x02); // Configure the TRF797x for ISO15693 @ High Bit Rate, One Subcarrier, 1 out of 4

}

if (Trf797xCheckRfField() == false)

{

// RF field is not enabled, VICC will not receive the command

Trf797xTurnRfOn(); // Ensure TRF797x is outputting an RF Field

// The VCD should wait at least 2mSec after activating the

// magnetic field before sending the first request, to

// ensure that the VICC is ready to receive it. (ISO15693-3)

McuDelayMillisecond(6);

}

g_ui8TrfBuffer[ui8Offset++] = 0x8F; // Reset FIFO

g_ui8TrfBuffer[ui8Offset++] = 0x91; // Send with CRC

g_ui8TrfBuffer[ui8Offset++] = 0x3D; // Write Continuous

g_ui8TrfBuffer[ui8Offset++] = 0x00; // Length of packet in bytes - upper and middle nibbles of transmit byte length

g_ui8TrfBuffer[ui8Offset++] = 0x30; // Length of packet in bytes - lower and broken nibbles of transmit byte length

g_ui8TrfBuffer[ui8Offset++] = 0x26; // ISO15693 flags

g_ui8TrfBuffer[ui8Offset++] = 0x01; // Inventory command code

g_ui8TrfBuffer[ui8Offset++] = 0x00; // Mask Length = 0 (Also not sending AFI)

Trf797xRawWrite(&g_ui8TrfBuffer[0], ui8Offset); // Issue the ISO15693 Inventory Command

Trf797xIrqWaitTimeout(5,15); // 5 millisecond TX timeout, 15 millisecond RX timeout

g_sTrfStatus = Trf797xGetTrfStatus();

if (g_sTrfStatus == RX_COMPLETE) // If data has been received

{

if (g_ui8TrfBuffer[0] == 0x00) // Confirm "no error" in response flags byte

{

ui8Status = STATUS_SUCCESS;

ui8RssiLevel = Trf797xReadRssiLevels(); // Read the RSSI levels

// UID Starts at the 3rd received bit (1st is flags and 2nd is DSFID)

for (ui8LoopCount = 2; ui8LoopCount < 10; ui8LoopCount++)

{

g_pui8Iso15693UId[ui8LoopCount-2] = g_ui8TrfBuffer[ui8LoopCount]; // Store UID into a Buffer

}

g_ui8TagDetectedCount++;

// Print out UID and RSSI level to UART Host

UartPutCrlf();

UartSendCString("ISO15693/NFC-V UID: ");

UartPutChar('[');

for (ui8LoopCount = 0; ui8LoopCount < 8; ui8LoopCount++)

{

UartPutByte(g_pui8Iso15693UId[7-ui8LoopCount]); // Send UID to host

}

UartPutChar(']');

UartPutCrlf();

UartSendCString("RSSI LEVEL: ");

UartPutChar('[');

UartPutByte(ui8RssiLevel); // Send RSSI level to host

UartPutChar(']');

UartPutCrlf();

}

}

else

{

ui8Status = STATUS_FAIL;

}

// clear any IRQs

Trf797xResetIrqStatus();

return ui8Status;

}

//===============================================================

//

// Iso15693_Anticollision - Issue an Inventory command for either

// 1 or 16 slot anticollision of ISO15693 tags.

//

// \param ui8ReqFlag are the request flags for ISO15693 commands.

// \param pui8Mask are the masked nibbles to issue with the

// Inventory command

// \param ui8MaskLength is the number of significant bits in the

// mask value.

// \param ui8Afi is the AFI to be issued with command (if AFI

// flag is included in ui8ReqFlag)

//

// This function issues a single or sixteens lot Inventory

// command for tag detection of ISO15693 tags. If a tag is found,

// the UID is stored in the g_pui8Iso15693UId buffer. The process

// will run until all ISO15693 detected have responded with their

// UID's.

//

// The function uses a recursive call for the anticollision

// process. Since the UID is stored inside of a buffer, only

// the last ISO15693 tag to respond with it's UID will have

// that UID stored in order to read data from the tag.

//

// If UART is enabled, the UID of each ISO15693 tag detected is

// sent out to a host via UART.

//

// \return ui8Status returns STATUS_SUCCESS if the anticollision

// function resulted in a successful tag detection. Otherwise,

// returns STATUS_FAIL.

//

//===============================================================

uint8_t Iso15693_Anticollision(uint8_t ui8ReqFlags, uint8_t ui8MaskLength, uint8_t ui8Afi)

{

uint8_t ui8Offset = 0;

uint8_t ui8LoopCount1 = 1;

uint8_t ui8LoopCount2 = 1;

uint8_t ui8SlotCount;

uint16_t ui16TransmitByteLength;

uint16_t ui16SlotNumber = 0x0000;

uint8_t ui8MaskValue;

uint8_t ui8MaskByteCount;

uint8_t ui8Status = STATUS_FAIL;

if ((ui8ReqFlags & BIT5) == 0x00) // Check if Bit 5 in the Request Flag to determine the number of slots

{

ui8SlotCount = 16; // If Bit 5 is cleared, then use 16 slots

}

else

{

ui8SlotCount = 1; // If Bit 5 is set, then use 1 slot

}

ui8MaskByteCount = (((ui8MaskLength >> 2) + 1) >> 1); // Set ui8MaskByteCount based on the inputted Mask Length

// ui8MaskByteCount will be 1 for length = 4 or 8,

// ui8MaskByteCount will be 2 for length = 12 or 16,

// and so on

if (Trf797xGetIsoControlValue() != 0x02)

{

// Trf797x has not been properly configured for ISO15693

Trf797xWriteIsoControl(0x02); // Configure the TRF797x for ISO15693 @ High Bit Rate, One Subcarrier, 1 out of 4

}

if (Trf797xCheckRfField() == false)

{

// RF field is not enabled, VICC will not receive the command

Trf797xTurnRfOn(); // Ensure TRF797x is outputting an RF Field

// The VCD should wait at least 2mSec after activating the

// magnetic field before sending the first request, to

// ensure that the VICC is ready to receive it. (ISO15693-3)

McuDelayMillisecond(6);

}

// Format Anti-collision command packet

g_ui8TrfBuffer[ui8Offset++] = 0x8F; // Reset FIFO

g_ui8TrfBuffer[ui8Offset++] = 0x91; // Send with CRC

g_ui8TrfBuffer[ui8Offset++] = 0x3D; // Write Continuous

// Calculate how long the output byte will be

if (ui8ReqFlags & 0x10) // Check if AFI will be included or not

{

ui16TransmitByteLength = ui8MaskByteCount + 4; // Set packet size = Mask Value + Mask Length + AFI Byte + ISO15693 Command Code + ISO15693 Request Flags

}

else

{

ui16TransmitByteLength = ui8MaskByteCount + 3; // Set packet size = Mask Value + Mask Length + ISO15693 Command Code + ISO15693 Request Flags

}

g_ui8TrfBuffer[ui8Offset++] = (uint8_t) (ui16TransmitByteLength >> 8); // Length of packet in bytes - upper and middle nibbles of transmit byte length

g_ui8TrfBuffer[ui8Offset++] = (uint8_t) (ui16TransmitByteLength << 4); // Length of packet in bytes - lower and broken nibbles of transmit byte length

g_ui8TrfBuffer[ui8Offset++] = ui8ReqFlags; // ISO15693 Request Flags

g_ui8TrfBuffer[ui8Offset++] = 0x01; // Inventory Request Command Code

if (ui8ReqFlags & 0x10) // Check if AFI will be included or not

{

g_ui8TrfBuffer[ui8Offset++] = ui8Afi; // Optional AFI Byte

g_ui8TrfBuffer[ui8Offset++] = ui8MaskLength; // Mask Length

if (ui8MaskLength > 0)

{

for (ui8LoopCount1 = 0; ui8LoopCount1 < ui8MaskByteCount; ui8LoopCount1++)

{

g_ui8TrfBuffer[ui8Offset++] = g_pui8AnticollisionMaskBuffer[(ui8MaskByteCount-ui8LoopCount1)]; // Fill in inputted Mask Values

}

}

}

else

{

g_ui8TrfBuffer[ui8Offset++] = ui8MaskLength; // Mask Length

if (ui8MaskLength > 0)

{

for (ui8LoopCount1 = 0; ui8LoopCount1 < ui8MaskByteCount; ui8LoopCount1++)

{

g_ui8TrfBuffer[ui8Offset++] = g_pui8AnticollisionMaskBuffer[((ui8MaskByteCount-1)-ui8LoopCount1)]; // Fill in inputted Mask Values

}

}

}

Trf797xEnableSlotCounter();

Trf797xResetIrqStatus();

Trf797xRawWrite(&g_ui8TrfBuffer[0], ui8Offset); // Issue the ISO15693 Inventory Command

Trf797xIrqWaitTimeoutTxOnly(5); // 5 millisecond TX timeout

for (ui8LoopCount2 = 1; ui8LoopCount2 <= ui8SlotCount; ui8LoopCount2++) // There will be either 1 or 16 available time slots

{

Trf797xIrqWaitTimeoutRxOnly(15); // 15 millisecond RX timeout

g_sTrfStatus = Trf797xGetTrfStatus(); // Get the TRF797x Status

switch (g_sTrfStatus)

{

case RX_COMPLETE: // If data has been received, then UID is in the buffer

if (g_ui8TrfBuffer[0] == 0x00) // Confirm "no error" in response flags byte

{

ui8Status = STATUS_SUCCESS;

// UID Starts at the 3rd received bit (1st is flags and 2nd is DSFID)

for (ui8LoopCount1 = 2; ui8LoopCount1 < 10; ui8LoopCount1++)

{

g_pui8Iso15693UId[ui8LoopCount1-2] = g_ui8TrfBuffer[ui8LoopCount1]; // Store UID to a Buffer

}

g_ui8TagDetectedCount++;

// Print out UID and RSSI level to UART Host

UartPutCrlf();

UartSendCString("ISO15693/NFC-V UID: ");

UartPutChar('[');

for (ui8LoopCount1 = 0; ui8LoopCount1 < 8; ui8LoopCount1++)

{

UartPutByte(g_pui8Iso15693UId[7-ui8LoopCount1]); // Send UID to host

}

UartPutChar(']');

UartPutCrlf();

}

break;

case PROTOCOL_ERROR: // A collision has occurred for this slot

ui16SlotNumber |= (0x01 << (ui8LoopCount2-1)); // Mark a collision occurred in the correct Slot Number bit.

McuDelayMillisecond(5); // Allow time for tag to finish responding before issuing EOF

break;

case NO_RESPONSE_RECEIVED: // No Response was received, break out of the switch statement as there is no tag present

break;

case NO_RESPONSE_RECEIVED_15693: // No Response was received, break out of the switch statement as there is no tag present

break;

default:

break;

}

Trf797xReset(); // FIFO has to be reset before receiving the next response

if ((ui8SlotCount == 16) && (ui8LoopCount2 < 16)) // If 16 slots used, and the last slot as not been reached, then send EOF (i.e. next slot indicator)

{

Trf797xStopDecoders();

Trf797xRunDecoders();

Trf797xTransmitNextSlot();

}

else if ((ui8SlotCount == 16) && (ui8LoopCount2 == 16)) // Once at the end of slot 16, then stop the slot counter

{

Trf797xStopDecoders();

Trf797xDisableSlotCounter();

}

else if (ui8SlotCount == 1) // Only 1 slot to be used, no more anti-collision to be performed

{

break;

}

}

Trf797xDisableSlotCounter();

ui8MaskLength = ui8MaskLength + 4; // The mask length is a multiple of 4 bits

ui8MaskByteCount = (((ui8MaskLength >> 2) + 1) >> 1); // Set ui8MaskByteCount based on the inputted Mask Length

// ui8MaskByteCount is 1 for length = 4 or 8,

// ui8MaskByteCount is 2 for length = 12 or 16,

// and so on

// If the slot number pointer is not 0, the slot count is 16 (to indicate anticollision is needed),

// the mask length doesn't exceed 60 bits, and the slot number is not 16 then proceed to recursive function call

while ((ui16SlotNumber != 0x00)

&& (ui8SlotCount == 16)

&& (ui8MaskLength < 61))

{

ui8MaskValue = 0x00;

ui8LoopCount1 = 0;

while (ui8LoopCount1 < 16)

{

if ((ui16SlotNumber & (0x01 << ui8LoopCount1)) != 0x00)

{

ui8MaskValue = ui8LoopCount1;

ui16SlotNumber &= ~(0x01 << ui8LoopCount1); // Clear that slot bit from the array

break;

}

ui8LoopCount1++;

}

if ((ui8MaskLength & 0x04) == 0x00)

{

ui8MaskValue = ui8MaskValue << 4; // Shift slot pointer if mask length doesn't have Bit 2 (0x04) set (since it is a multiple of 4 bits)

}

else

{ // Otherwise re-copy the mask values

for (ui8LoopCount1 = 7; ui8LoopCount1 > 0; ui8LoopCount1--)

{

g_pui8AnticollisionMaskBuffer[ui8LoopCount1] = g_pui8AnticollisionMaskBuffer[ui8LoopCount1 - 1];

}

g_pui8AnticollisionMaskBuffer[0] &= 0x00; // And set the mask value for the first byte in the array = 0

}

g_pui8AnticollisionMaskBuffer[0] |= ui8MaskValue; // Now update the mask value of the first byte based on the slot number pointer

McuDelayMillisecond(2);

ui8Status = Iso15693_Anticollision(ui8ReqFlags, ui8MaskLength, ui8Afi); // Issue a recursive call with new Mask

// Restore the Global AnticollisionMaskBuffer with the values from the current anticollision function.

if ((ui8MaskLength & 0x04) == 0x00)

{

// If mask length doesn't have Bit 2 (0x04) set (since it is a multiple of 4 bits) - clear the upper nibble which is where the new mask value was placed

g_pui8AnticollisionMaskBuffer[0] &= 0x0F;

}

else

{ // Otherwise re-shift the mask values

for (ui8LoopCount1 = 0; ui8LoopCount1 < 7; ui8LoopCount1++)

{

g_pui8AnticollisionMaskBuffer[ui8LoopCount1] = g_pui8AnticollisionMaskBuffer[ui8LoopCount1 + 1];

}

g_pui8AnticollisionMaskBuffer[7] = 0x00; // And set the mask value for the first byte in the array = 0

}

}

// Clear any IRQs

Trf797xResetIrqStatus();

return ui8Status;

}

//===============================================================

//

// Iso15693_GetSystemInfo - Issue the Get System Information

// command for ISO15693 tags.

//

// \param ui8ReqFlag are the request flags for ISO15693 commands.

//

// This function issues a Get System Information command for

// ISO15693 tags. This can be used to determine how many blocks

// of data can be read from the tag.

//

// If UART is enabled, the contents of the Get System Information

// response is sent out to a host via UART as well.

//

// \return ui16NumberOfBlocks returns the number of blocks

// contained in the ISO15693 tag.

//

//===============================================================

uint16_t Iso15693_GetSystemInfo(uint8_t ui8ReqFlag)

{

uint8_t ui8Offset = 0;

uint16_t ui16NumberOfBlocks = 0x00;

uint8_t ui8LoopCount = 1;

uint8_t ui8RxLength = 0;

if (Trf797xGetIsoControlValue() != 0x02)

{

// Trf797x has not been properly configured for ISO15693

Trf797xWriteIsoControl(0x02); // Configure the TRF797x for ISO15693 @ High Bit Rate, One Subcarrier, 1 out of 4

}

if (Trf797xCheckRfField() == false)

{

// RF field is not enabled, VICC will not receive the command

Trf797xTurnRfOn(); // Ensure TRF797x is outputting an RF Field

// The VCD should wait at least 2mSec after activating the

// magnetic field before sending the first request, to

// ensure that the VICC is ready to receive it. (ISO15693-3)

McuDelayMillisecond(6);

}

g_ui8TrfBuffer[ui8Offset++] = 0x8F; // Reset FIFO

g_ui8TrfBuffer[ui8Offset++] = 0x91; // Send with CRC

g_ui8TrfBuffer[ui8Offset++] = 0x3D; // Write Continuous

g_ui8TrfBuffer[ui8Offset++] = 0x00; // Length of packet in bytes - upper and middle nibbles of transmit byte length

if (ui8ReqFlag & 0x20)

{

g_ui8TrfBuffer[ui8Offset++] = 0xA0; // Length of packet in bytes - lower and broken nibbles of transmit byte length

}

else

{

g_ui8TrfBuffer[ui8Offset++] = 0x20; // Length of packet in bytes - lower and broken nibbles of transmit byte length

}

g_ui8TrfBuffer[ui8Offset++] = ui8ReqFlag; // ISO15693 flags

g_ui8TrfBuffer[ui8Offset++] = 0x2B; // Get System Information command code

if (ui8ReqFlag & 0x20)

{

g_ui8TrfBuffer[ui8Offset++] = g_pui8Iso15693UId[0]; // Tag UID

g_ui8TrfBuffer[ui8Offset++] = g_pui8Iso15693UId[1]; // Tag UID

g_ui8TrfBuffer[ui8Offset++] = g_pui8Iso15693UId[2]; // Tag UID

g_ui8TrfBuffer[ui8Offset++] = g_pui8Iso15693UId[3]; // Tag UID

g_ui8TrfBuffer[ui8Offset++] = g_pui8Iso15693UId[4]; // Tag UID

g_ui8TrfBuffer[ui8Offset++] = g_pui8Iso15693UId[5]; // Tag UID

g_ui8TrfBuffer[ui8Offset++] = g_pui8Iso15693UId[6]; // Tag UID

g_ui8TrfBuffer[ui8Offset++] = g_pui8Iso15693UId[7]; // Tag UID

}

Trf797xRawWrite(&g_ui8TrfBuffer[0], ui8Offset); // Issue the Get System Information command

Trf797xIrqWaitTimeout(5,15); // 5 millisecond TX timeout, 15 millisecond RX timeout

g_sTrfStatus = Trf797xGetTrfStatus();

if (g_sTrfStatus == RX_COMPLETE) // If data has been received

{

if (g_ui8TrfBuffer[0] == 0x00) // Confirm "no error" in response flags byte

{

// Output received data to UART

UartSendCString("Get Sys Info ");

UartSendCString("Data: ");

UartPutChar('[');

ui8RxLength = Trf797xGetRxBytesReceived();

for (ui8LoopCount = 1; ui8LoopCount < ui8RxLength; ui8LoopCount++)

{

UartPutByte(g_ui8TrfBuffer[ui8LoopCount]); // Send Get System Info data to host

}

UartPutChar(']');

UartPutCrlf();

// Check to see that no error flags were sent and that there is a block number data available

if (g_ui8TrfBuffer[0] == 0x00 && ((g_ui8TrfBuffer[1] & 0x07) == 0x07))

{

ui16NumberOfBlocks = g_ui8TrfBuffer[12];

}

else if (g_ui8TrfBuffer[0] == 0x00 && (((g_ui8TrfBuffer[1] & 0x07) == 0x06) || ((g_ui8TrfBuffer[1] & 0x07) == 0x05)))

{

ui16NumberOfBlocks = g_ui8TrfBuffer[11];

}

else if (g_ui8TrfBuffer[0] == 0x00 && ((g_ui8TrfBuffer[1] & 0x07) == 0x04))

{

ui16NumberOfBlocks = g_ui8TrfBuffer[10];

}

}

}

else if ((g_sTrfStatus == NO_RESPONSE_RECEIVED) || (g_sTrfStatus == NO_RESPONSE_RECEIVED_15693))

{

// Case for TI HF-I Pro and Standard tags

ui16NumberOfBlocks = 0x0A;

}

// Clear any IRQs

Trf797xResetIrqStatus();

return ui16NumberOfBlocks;

}

//===============================================================

//

// Iso15693_GetSystemInfoExtended - Issue the Get System

// Information command for ISO15693 tags with the protocol

// extention flag set.

//

// \param ui8ReqFlag are the request flags for ISO15693 commands.

//

// This function issues a Get System Information command for

// ISO15693 tags with the Protocol Extension bit set in the

// request flags. This can be used to determine how many blocks

// of data can be read from the tag.

//

// If UART is enabled, the contents of the Get System Information

// response is sent out to a host via UART as well.

//

// \return ui16NumberOfBlocks returns the number of blocks

// contained in the ISO15693 tag.

//

//===============================================================

uint16_t Iso15693_GetSystemInfoExtended(uint8_t ui8ReqFlag)

{

uint8_t ui8Offset = 0;

uint16_t ui16NumberOfBlocks = 0x00;

uint8_t ui8LoopCount = 1;

uint8_t ui8RxLength = 0;

if (Trf797xGetIsoControlValue() != 0x02)

{

// Trf797x has not been properly configured for ISO15693

Trf797xWriteIsoControl(0x02); // Configure the TRF797x for ISO15693 @ High Bit Rate, One Subcarrier, 1 out of 4

}

if (Trf797xCheckRfField() == false)

{

// RF field is not enabled, VICC will not receive the command

Trf797xTurnRfOn(); // Ensure TRF797x is outputting an RF Field

// The VCD should wait at least 2mSec after activating the

// magnetic field before sending the first request, to

// ensure that the VICC is ready to receive it. (ISO15693-3)

McuDelayMillisecond(6);

}

g_ui8TrfBuffer[ui8Offset++] = 0x8F; // Reset FIFO

g_ui8TrfBuffer[ui8Offset++] = 0x91; // Send with CRC

g_ui8TrfBuffer[ui8Offset++] = 0x3D; // Write Continuous

g_ui8TrfBuffer[ui8Offset++] = 0x00; // Length of packet in bytes - upper and middle nibbles of transmit byte length

if (ui8ReqFlag & 0x20)

{

g_ui8TrfBuffer[ui8Offset++] = 0xA0; // Length of packet in bytes - lower and broken nibbles of transmit byte length

}

else

{

g_ui8TrfBuffer[ui8Offset++] = 0x20; // Length of packet in bytes - lower and broken nibbles of transmit byte length

}

g_ui8TrfBuffer[ui8Offset++] = ui8ReqFlag | 0x08; // ISO15693 flags + protocol extension bit

g_ui8TrfBuffer[ui8Offset++] = 0x2B; // Get System Information command code

if (ui8ReqFlag & 0x20)

{

g_ui8TrfBuffer[ui8Offset++] = g_pui8Iso15693UId[0]; // Tag UID

g_ui8TrfBuffer[ui8Offset++] = g_pui8Iso15693UId[1]; // Tag UID

g_ui8TrfBuffer[ui8Offset++] = g_pui8Iso15693UId[2]; // Tag UID

g_ui8TrfBuffer[ui8Offset++] = g_pui8Iso15693UId[3]; // Tag UID

g_ui8TrfBuffer[ui8Offset++] = g_pui8Iso15693UId[4]; // Tag UID

g_ui8TrfBuffer[ui8Offset++] = g_pui8Iso15693UId[5]; // Tag UID

g_ui8TrfBuffer[ui8Offset++] = g_pui8Iso15693UId[6]; // Tag UID

g_ui8TrfBuffer[ui8Offset++] = g_pui8Iso15693UId[7]; // Tag UID

}

Trf797xRawWrite(&g_ui8TrfBuffer[0], ui8Offset); // Issue the Get System Information command

Trf797xIrqWaitTimeout(5,20); // 5 millisecond TX timeout, 15 millisecond RX timeout

g_sTrfStatus = Trf797xGetTrfStatus();

if (g_sTrfStatus == RX_COMPLETE) // If data has been received

{

if (g_ui8TrfBuffer[0] == 0x00) // Confirm "no error" in response flags byte

{

UartSendCString("Get Sys Info ");

UartSendCString("Data: ");

UartPutChar('[');

ui8RxLength = Trf797xGetRxBytesReceived();

// Output received data to UART

for (ui8LoopCount = 1; ui8LoopCount < ui8RxLength; ui8LoopCount++)

{

UartPutByte(g_ui8TrfBuffer[ui8LoopCount]); // Send Get System Info data to host

}

UartPutChar(']');

UartPutCrlf();

ui16NumberOfBlocks = 0x0800; // Set block size in order to read STM M24LR64 tag

}

}

// Clear any IRQs

Trf797xResetIrqStatus();

return ui16NumberOfBlocks;

}

//===============================================================

//

// Iso15693_ReadSingleBlock - Issue the Read Single Block command

// for ISO15693 tags.

//

// \param ui8ReqFlag are the request flags for ISO15693 commands.

// \param ui8BlockNumber is the block number to read data from.

//

// This function issues a Read Single Block with the specified

// request flags and block number to read data from an ISO15693

// tag.

//

// If UART is enabled, the data read from the ISO15693 tag is

// sent out to a host via UART as well.

//

// \return ui8Status returns either STATUS_SUCCESS or STATUS_FAIL

// to indicate if the Read Single Block was successful or not.

//

//===============================================================

uint8_t Iso15693_ReadSingleBlock(uint8_t ui8ReqFlag, uint8_t ui8BlockNumber)

{

uint8_t ui8Offset = 0;

uint8_t ui8Status = STATUS_FAIL;

uint8_t ui8LoopCount = 1;

uint8_t ui8RxLength = 0;

if (Trf797xGetIsoControlValue() != 0x02)

{

// Trf797x has not been properly configured for ISO15693

Trf797xWriteIsoControl(0x02); // Configure the TRF797x for ISO15693 @ High Bit Rate, One Subcarrier, 1 out of 4

}

if (Trf797xCheckRfField() == false)

{

// RF field is not enabled, VICC will not receive the command

Trf797xTurnRfOn(); // Ensure TRF797x is outputting an RF Field

// The VCD should wait at least 2mSec after activating the

// magnetic field before sending the first request, to

// ensure that the VICC is ready to receive it. (ISO15693-3)

McuDelayMillisecond(6);

}

g_ui8TrfBuffer[ui8Offset++] = 0x8F; // Reset FIFO

g_ui8TrfBuffer[ui8Offset++] = 0x91; // Send with CRC

g_ui8TrfBuffer[ui8Offset++] = 0x3D; // Write Continuous

g_ui8TrfBuffer[ui8Offset++] = 0x00; // Length of packet in bytes - upper and middle nibbles of transmit byte length

if (ui8ReqFlag & 0x20)

{

g_ui8TrfBuffer[ui8Offset++] = 0xB0; // Length of packet in bytes - lower and broken nibbles of transmit byte length

}

else

{

g_ui8TrfBuffer[ui8Offset++] = 0x30; // Length of packet in bytes - lower and broken nibbles of transmit byte length

}

g_ui8TrfBuffer[ui8Offset++] = ui8ReqFlag; // ISO15693 flags

g_ui8TrfBuffer[ui8Offset++] = 0x20; // Read Single Block command code

if (ui8ReqFlag & 0x20)

{

g_ui8TrfBuffer[ui8Offset++] = g_pui8Iso15693UId[0]; // Tag UID

g_ui8TrfBuffer[ui8Offset++] = g_pui8Iso15693UId[1]; // Tag UID

g_ui8TrfBuffer[ui8Offset++] = g_pui8Iso15693UId[2]; // Tag UID

g_ui8TrfBuffer[ui8Offset++] = g_pui8Iso15693UId[3]; // Tag UID

g_ui8TrfBuffer[ui8Offset++] = g_pui8Iso15693UId[4]; // Tag UID

g_ui8TrfBuffer[ui8Offset++] = g_pui8Iso15693UId[5]; // Tag UID

g_ui8TrfBuffer[ui8Offset++] = g_pui8Iso15693UId[6]; // Tag UID

g_ui8TrfBuffer[ui8Offset++] = g_pui8Iso15693UId[7]; // Tag UID

}

g_ui8TrfBuffer[ui8Offset++] = ui8BlockNumber; // Block # (variable, for HF-I Plus device can go to 0x3F, Pro and Standard handled with "error" response flags)

Trf797xRawWrite(&g_ui8TrfBuffer[0], ui8Offset); // Issue the Get System Information command

Trf797xIrqWaitTimeout(5,15); // 5 millisecond TX timeout, 15 millisecond RX timeout

g_sTrfStatus = Trf797xGetTrfStatus();

if (g_sTrfStatus == RX_COMPLETE) // If data has been received

{

if (g_ui8TrfBuffer[0] == 0x00) // Confirm "no error" in response flags byte

{

UartSendCString("NFC-V Block ");

UartPutByte(ui8BlockNumber); // Output block number

UartSendCString(" Data: ");

UartPutChar('[');

ui8RxLength = Trf797xGetRxBytesReceived();

if (ui8ReqFlag & BIT6) // Handle case for Option Flag causing one extra byte to be transmitted.

{

ui8Offset = 2;

}

else

{

ui8Offset = 1;

}

// Output received data to UART

for (ui8LoopCount = ui8Offset; ui8LoopCount < ui8RxLength; ui8LoopCount++)

{

UartPutByte(g_ui8TrfBuffer[ui8LoopCount]); // Send out data read from tag to host

}

UartPutChar(']');

UartPutCrlf();

// Response received

ui8Status = STATUS_SUCCESS;

}

else // An error has been sent back in the response byte

{

// Indicates when an error occurs or block addresses are unreachable - useful for debugging

UartSendCString("NFC-V Block ");

UartPutByte(ui8BlockNumber); // Output block number

UartSendCString(" Error");

UartPutCrlf();

UartSendCString("ISO15693 Error Code: ");

UartPutByte(g_ui8TrfBuffer[1]); // Output ISO15693 error code

UartPutCrlf();

// Response with error

ui8Status = STATUS_FAIL;

}

}

else

{

// No response

ui8Status = STATUS_FAIL;

}

// Clear any IRQs

Trf797xResetIrqStatus();

return ui8Status;

}

//===============================================================

//

// Iso15693_ReadMultipleBlocks - Issue the Read Multiple Block

// command for ISO15693 tags.

//

// \param ui8ReqFlag are the request flags for ISO15693 commands.

// \param ui8FirstBlock is the starting block number to read data

// from.

// \param ui8NumberOfBlocks is the amount of blocks to read data

// from.

//

// This function issues a Read Multiple Block with the specified

// request flags, the starting block number, and the number

// blocks to read data from an ISO15693 tag.

//

// If UART is enabled, the data read from the ISO15693 tag is

// sent out to a host via UART as well.

//

// \return ui8Status returns either STATUS_SUCCESS or STATUS_FAIL

// to indicate if the Read Single Block was successful or not.

//

//===============================================================

uint8_t Iso15693_ReadMultipleBlocks(uint8_t ui8ReqFlag, uint8_t ui8FirstBlock, uint8_t ui8NumberOfBlocks)

{

uint8_t ui8Offset = 0;

uint8_t ui8Status = STATUS_FAIL;

uint8_t ui8LoopCount1 = 0;

uint8_t ui8LoopCount2 = 0;

uint8_t ui8RxLength = 0;

uint8_t ui8BlockSize = 0;

if (Trf797xGetIsoControlValue() != 0x02)

{

// Trf797x has not been properly configured for ISO15693

Trf797xWriteIsoControl(0x02); // Configure the TRF797x for ISO15693 @ High Bit Rate, One Subcarrier, 1 out of 4

}

if (Trf797xCheckRfField() == false)

{

// RF field is not enabled, VICC will not receive the command

Trf797xTurnRfOn(); // Ensure TRF797x is outputting an RF Field

// The VCD should wait at least 2mSec after activating the

// magnetic field before sending the first request, to

// ensure that the VICC is ready to receive it. (ISO15693-3)

McuDelayMillisecond(6);

}

g_ui8TrfBuffer[ui8Offset++] = 0x8F; // Reset FIFO

g_ui8TrfBuffer[ui8Offset++] = 0x91; // Send with CRC

g_ui8TrfBuffer[ui8Offset++] = 0x3D; // Write Continuous

g_ui8TrfBuffer[ui8Offset++] = 0x00; // Length of packet in bytes - upper and middle nibbles of transmit byte length

if (ui8ReqFlag & 0x20)

{

g_ui8TrfBuffer[ui8Offset++] = 0xC0; // Length of packet in bytes - lower and broken nibbles of transmit byte length

}

else

{

g_ui8TrfBuffer[ui8Offset++] = 0x40; // Length of packet in bytes - lower and broken nibbles of transmit byte length

}

g_ui8TrfBuffer[ui8Offset++] = ui8ReqFlag; // ISO15693 flags

g_ui8TrfBuffer[ui8Offset++] = 0x23; // Read Multiple Block command code

if (ui8ReqFlag & 0x20)

{

g_ui8TrfBuffer[ui8Offset++] = g_pui8Iso15693UId[0]; // Tag UID

g_ui8TrfBuffer[ui8Offset++] = g_pui8Iso15693UId[1]; // Tag UID

g_ui8TrfBuffer[ui8Offset++] = g_pui8Iso15693UId[2]; // Tag UID

g_ui8TrfBuffer[ui8Offset++] = g_pui8Iso15693UId[3]; // Tag UID

g_ui8TrfBuffer[ui8Offset++] = g_pui8Iso15693UId[4]; // Tag UID

g_ui8TrfBuffer[ui8Offset++] = g_pui8Iso15693UId[5]; // Tag UID

g_ui8TrfBuffer[ui8Offset++] = g_pui8Iso15693UId[6]; // Tag UID

g_ui8TrfBuffer[ui8Offset++] = g_pui8Iso15693UId[7]; // Tag UID

}

g_ui8TrfBuffer[ui8Offset++] = ui8FirstBlock; // Number of the first block to read from

if (ui8NumberOfBlocks > 0)

{

g_ui8TrfBuffer[ui8Offset++] = ui8NumberOfBlocks-1; // Index for number of blocks to be read - this value is one less than

}

else

{

// Invalid count provided

return ui8Status = STATUS_FAIL;

}

Trf797xRawWrite(&g_ui8TrfBuffer[0], ui8Offset); // Issue the Get System Information command

Trf797xIrqWaitTimeout(5,15+ui8NumberOfBlocks); // 5 millisecond TX timeout, 15 millisecond RX timeout - adding number of blocks to extend timeout for larger read requests

g_sTrfStatus = Trf797xGetTrfStatus();

if (g_sTrfStatus == RX_COMPLETE) // If data has been received

{

if (g_ui8TrfBuffer[0] == 0x00) // Confirm "no error" in response flags byte

{

ui8RxLength = Trf797xGetRxBytesReceived();

if (ui8ReqFlag & BIT6) // Handle case for Option Flag causing one extra byte to be transmitted.

{

ui8Offset = 2;

}

else

{

ui8Offset = 1;

}

ui8LoopCount1 = ui8RxLength-ui8Offset;

while (ui8LoopCount1 > 0)

{

if (ui8LoopCount1 > ui8NumberOfBlocks)

{

ui8LoopCount1 = ui8LoopCount1 - ui8NumberOfBlocks;

}

else

{

ui8LoopCount1 = 0;

}

ui8BlockSize++;

}

for (ui8LoopCount2 = 0; ui8LoopCount2 < ui8NumberOfBlocks; ui8LoopCount2++)

{

UartSendCString("NFC-V Block ");

UartPutByte(ui8FirstBlock+ui8LoopCount2); // Output block number

UartSendCString(" Data: ");

UartPutChar('[');

// Output received data to UART

for (ui8LoopCount1 = 0; ui8LoopCount1 < ui8BlockSize; ui8LoopCount1++)

{

UartPutByte(g_ui8TrfBuffer[ui8Offset++]); // Send out data read from tag to host

}

UartPutChar(']');

UartPutCrlf();

}

// Response received

ui8Status = STATUS_SUCCESS;

}

else // An error has been sent back in the response byte

{

// Indicates when an error occurs or block addresses are unreachable - useful for debugging

UartSendCString("NFC-V Block ");

UartPutByte(ui8FirstBlock); // Output block number

UartSendCString(" Error");

UartPutCrlf();

UartSendCString("ISO15693 Error Code: ");

UartPutByte(g_ui8TrfBuffer[1]); // Output ISO15693 error code

UartPutCrlf();

// Response with error

ui8Status = STATUS_FAIL;

}

}

else

{

// No response

ui8Status = STATUS_FAIL;

}

// Clear any IRQs

Trf797xResetIrqStatus();

return ui8Status;

}

//===============================================================

//

// Iso15693_ReadSingleBlockExtended - Issue the Read Single Block

// command for ISO15693 tags with the protocol extention flag set

//

// \param ui8ReqFlag are the request flags for ISO15693 commands.

// \param ui16BlockNumber is the block number to read data from.

//

// This function issues a Read Single Block with the block number

// and the specified request flags, including the Protocol

// Extension bit, to read data from ISO15693 tags which require

// the use of extended protocol commands.

//

// If UART is enabled, the data read from the ISO15693 tag is

// sent out to a host via UART as well.

//

// \return ui8Status returns either STATUS_SUCCESS or STATUS_FAIL

// to indicate if the Read Multiple Block was successful or not.

//

//===============================================================

uint8_t Iso15693_ReadSingleBlockExtended(uint8_t ui8ReqFlag, uint16_t ui16BlockNumber)

{

uint8_t ui8Offset = 0;

uint8_t ui8Status = STATUS_FAIL;

uint8_t ui8LoopCount = 1;

uint8_t ui8RxLength = 0;

if (Trf797xGetIsoControlValue() != 0x02)

{

// Trf797x has not been properly configured for ISO15693

Trf797xWriteIsoControl(0x02); // Configure the TRF797x for ISO15693 @ High Bit Rate, One Subcarrier, 1 out of 4

}

if (Trf797xCheckRfField() == false)

{

// RF field is not enabled, VICC will not receive the command

Trf797xTurnRfOn(); // Ensure TRF797x is outputting an RF Field

// The VCD should wait at least 2mSec after activating the

// magnetic field before sending the first request, to

// ensure that the VICC is ready to receive it. (ISO15693-3)

McuDelayMillisecond(6);

}

g_ui8TrfBuffer[ui8Offset++] = 0x8F; // Reset FIFO

g_ui8TrfBuffer[ui8Offset++] = 0x91; // Send with CRC

g_ui8TrfBuffer[ui8Offset++] = 0x3D; // Write Continuous

g_ui8TrfBuffer[ui8Offset++] = 0x00; // Length of packet in bytes - upper and middle nibbles of transmit byte length

if (ui8ReqFlag & 0x20)

{

g_ui8TrfBuffer[ui8Offset++] = 0xC0; // Length of packet in bytes - lower and broken nibbles of transmit byte length

}

else

{

g_ui8TrfBuffer[ui8Offset++] = 0x40; // Length of packet in bytes - lower and broken nibbles of transmit byte length

}

g_ui8TrfBuffer[ui8Offset++] = ui8ReqFlag | 0x08; // ISO15693 flags with protocol extension bit set

g_ui8TrfBuffer[ui8Offset++] = 0x20; // Read Single Block command code

if (ui8ReqFlag & 0x20)

{

g_ui8TrfBuffer[ui8Offset++] = g_pui8Iso15693UId[0]; // Tag UID

g_ui8TrfBuffer[ui8Offset++] = g_pui8Iso15693UId[1]; // Tag UID

g_ui8TrfBuffer[ui8Offset++] = g_pui8Iso15693UId[2]; // Tag UID

g_ui8TrfBuffer[ui8Offset++] = g_pui8Iso15693UId[3]; // Tag UID

g_ui8TrfBuffer[ui8Offset++] = g_pui8Iso15693UId[4]; // Tag UID

g_ui8TrfBuffer[ui8Offset++] = g_pui8Iso15693UId[5]; // Tag UID

g_ui8TrfBuffer[ui8Offset++] = g_pui8Iso15693UId[6]; // Tag UID

g_ui8TrfBuffer[ui8Offset++] = g_pui8Iso15693UId[7]; // Tag UID

g_ui8TrfBuffer[ui8Offset++] = (uint8_t) (ui16BlockNumber & 0xFF); // Block # (variable, for this device it can go to 0xFF)

g_ui8TrfBuffer[ui8Offset++] = (uint8_t) ((ui16BlockNumber >> 8) & 0xFF); // Block # (variable, for this device it can go to 0x07)

}

else

{

g_ui8TrfBuffer[ui8Offset++] = (uint8_t) (ui16BlockNumber & 0xFF); // Block # (variable, for this device it can go to 0xFF)

g_ui8TrfBuffer[ui8Offset++] = (uint8_t) ((ui16BlockNumber >> 8) & 0xFF); // Block # (variable, for this device it can go to 0x07)

}

Trf797xRawWrite(&g_ui8TrfBuffer[0], ui8Offset); // Issue the Read Single Block command

Trf797xIrqWaitTimeout(3,10); // 3 millisecond TX timeout, 10 millisecond RX timeout

g_sTrfStatus = Trf797xGetTrfStatus();

if (g_sTrfStatus == RX_COMPLETE) // If data has been received

{

if (g_ui8TrfBuffer[0] == 0x00) // Confirm "no error" in response flags byte

{

// Response received

ui8Status = STATUS_SUCCESS;

UartSendCString("NFC-V Block ");

UartPutByte((ui16BlockNumber >> 8) & 0xFF); // Output block number

UartPutByte(ui16BlockNumber & 0xFF);

UartSendCString(" Data: ");

UartPutChar('[');

ui8RxLength = Trf797xGetRxBytesReceived();

if (ui8ReqFlag & BIT6) // Handle case for Option Flag causing one extra byte to be transmitted.

{

ui8Offset = 2;

}

else

{

ui8Offset = 1;

}

// Output received data to UART

for (ui8LoopCount = ui8Offset; ui8LoopCount < ui8RxLength; ui8LoopCount++)

{

UartPutByte(g_ui8TrfBuffer[ui8LoopCount]); // Send out data read from tag to host

}

UartPutChar(']');

UartPutCrlf();

}

else

{

// Received an error from the tag

ui8Status = STATUS_FAIL;

// Indicates when an error occurs or block addresses are unreachable - useful for debugging

UartSendCString("NFC-V Block ");

UartPutByte(((ui16BlockNumber >> 8) & 0xFF)); // Output block number

UartPutByte((ui16BlockNumber & 0xFF));

UartSendCString(" Error");

UartPutCrlf();

UartSendCString("ISO15693 Error Code: ");

UartPutByte(g_ui8TrfBuffer[1]); // Output ISO15693 error code

UartPutCrlf();

}

}

else

{

// Did not receive a proper response from tag

ui8Status = STATUS_FAIL;

}

// Clear any IRQs

Trf797xResetIrqStatus();

return ui8Status;

}

//===============================================================

//

// Iso15693_WriteSingleBlock - Issue the Write Single Block

// command for ISO15693 tags.

//

// \param ui8ReqFlag are the request flags for ISO15693 commands.

// \param ui8BlockNumber is the block number to write data to.

// \param ui8BlockSize is the tag block size.

// \param pui8BlockData is the data to be written.

//

// Function issues an addressed Write Single Block with the

// specified request flags as well as the Address flag. The

// write single block command will write the provided data

// packet to an ISO15693 tag. This command supports writing to

// tags with more than 4 bytes of data per block.

//

// \return ui8Status returns either STATUS_SUCCESS or

// STATUS_FAIL to indicate if the Write Single Block was

// successful or not.

//

//===============================================================

uint8_t Iso15693_WriteSingleBlock(uint8_t ui8ReqFlag, uint8_t ui8BlockNumber, uint8_t ui8BlockSize, uint8_t * pui8BlockData)

{

uint8_t ui8Offset = 0;

uint8_t ui8Status = STATUS_FAIL;

uint8_t ui8LoopCount = 0;

if (Trf797xGetIsoControlValue() != 0x02)

{

// Trf797x has not been properly configured for ISO15693

Trf797xWriteIsoControl(0x02); // Configure the TRF797x for ISO15693 @ High Bit Rate, One Subcarrier, 1 out of 4

}

if (Trf797xCheckRfField() == false)

{

// RF field is not enabled, VICC will not receive the command

Trf797xTurnRfOn(); // Ensure TRF797x is outputting an RF Field

// The VCD should wait at least 2mSec after activating the

// magnetic field before sending the first request, to

// ensure that the VICC is ready to receive it. (ISO15693-3)

McuDelayMillisecond(6);

}

ui8ReqFlag = ui8ReqFlag | 0x20; // Mandatory use of addressed writes

g_ui8TrfBuffer[ui8Offset++] = 0x8F; // Reset FIFO

g_ui8TrfBuffer[ui8Offset++] = 0x91; // Send with CRC

g_ui8TrfBuffer[ui8Offset++] = 0x3D; // Write Continuous

g_ui8TrfBuffer[ui8Offset++] = (((0x0B+ui8BlockSize) & 0xF0) >> 0x04); // Length of packet in bytes - upper and middle nibbles of transmit byte length

g_ui8TrfBuffer[ui8Offset++] = ((0x0B+ui8BlockSize) << 0x04); // Length of packet in bytes - lower and broken nibbles of transmit byte length

g_ui8TrfBuffer[ui8Offset++] = ui8ReqFlag; // ISO15693 flags

g_ui8TrfBuffer[ui8Offset++] = 0x21; // Write Single Block command code

g_ui8TrfBuffer[ui8Offset++] = g_pui8Iso15693UId[0]; // Tag UID

g_ui8TrfBuffer[ui8Offset++] = g_pui8Iso15693UId[1]; // Tag UID

g_ui8TrfBuffer[ui8Offset++] = g_pui8Iso15693UId[2]; // Tag UID

g_ui8TrfBuffer[ui8Offset++] = g_pui8Iso15693UId[3]; // Tag UID

g_ui8TrfBuffer[ui8Offset++] = g_pui8Iso15693UId[4]; // Tag UID

g_ui8TrfBuffer[ui8Offset++] = g_pui8Iso15693UId[5]; // Tag UID

g_ui8TrfBuffer[ui8Offset++] = g_pui8Iso15693UId[6]; // Tag UID

g_ui8TrfBuffer[ui8Offset++] = g_pui8Iso15693UId[7]; // Tag UID

g_ui8TrfBuffer[ui8Offset++] = ui8BlockNumber; // Block # (variable, for HF-I Plus device can go to 0x3F, Pro and Standard handled with "error" response flags)

for (ui8LoopCount = 0; ui8LoopCount < ui8BlockSize; ui8LoopCount++)

{

g_ui8TrfBuffer[ui8Offset++] = pui8BlockData[ui8LoopCount]; // Data to write to tag

}

Trf797xRawWrite(&g_ui8TrfBuffer[0], ui8Offset); // Issue the Get System Information command

// Check if the option flag is set

if (ui8ReqFlag & 0x40)

{

Trf797xIrqWaitTimeoutTxOnly(10); // 10 millisecond TX timeout

g_sTrfStatus = Trf797xGetTrfStatus();

if (g_sTrfStatus == TX_COMPLETE) // If transmit is complete

{

McuDelayMillisecond(5);

Trf797xTransmitNextSlot(); // Send out End of Frame marker

Trf797xIrqWaitTimeoutRxOnly(30); // 30 millisecond RX timeout

}

else // Otherwise return an error

{

return ui8Status = STATUS_FAIL;

}

}

else

{

Trf797xIrqWaitTimeout(10,30); // 10 millisecond TX timeout, 30 millisecond RX timeout

}

g_sTrfStatus = Trf797xGetTrfStatus();

if (g_sTrfStatus == RX_COMPLETE) // If data has been received

{

if (g_ui8TrfBuffer[0] == 0x00) // Confirm "no error" in response flags byte

{

// Response received

ui8Status = STATUS_SUCCESS;

}

else // An error has been sent back in the response byte

{

ui8Status = STATUS_FAIL;

}

}

else

{

// No response

ui8Status = STATUS_FAIL;

}

// Clear any IRQs

Trf797xResetIrqStatus();

return ui8Status;

}

//===============================================================

//

// Iso15693_Get_Uid - Fetches the ISO15693 Tag UID.

//

// This function allows for higher layers to fetch the tag UID of

// an ISO15693 tag. In the current implementation, the UID

// stored is from the most recent tag which responded to an

// inventory command or the last tag to provide it's UID during

// the ISO15693 anticollision procedure.

//

// \return g_pui8Iso15693UId returns the currently stored UID.

//

//===============================================================

uint8_t * Iso15693_Get_Uid(void)

{

return g_pui8Iso15693UId;

}

//===============================================================

//

// Iso15693_Get_TagCount - Fetches the ISO15693 Tag UID.

//

// This function allows for higher layers to fetch the tag

// detected colunter in order to know how many ISO15693 tags

// have been detected since the last counter reset.

//

// \return g_ui8TagDetectedCount returns the count of ISO15693

// tags detected.

//

//===============================================================

uint8_t Iso15693_Get_TagCount(void)

{

return g_ui8TagDetectedCount;

}

//===============================================================

//

// Iso15693_Reset_TagCount - Fetches the ISO15693 Tag UID.

//

// This function allows for higher layers to reset the tag

// detected counter.

//

// \return None

//

//===============================================================

void Iso15693_Reset_TagCount(void)

{

g_ui8TagDetectedCount = 0;

}

//===============================================================

//

// Nfc_Iso15693_ReadTag - Read all blocks of a ISO15693 tag.

//

// \param ui8ReqFlag are the request flags for ISO15693 commands.

//

// This function issues Get System Information command to

// determine how many blocks of data is stored within the

// ISO15693 tag.

// Afterwards, all blocks are read out using a Read Single block,

// unless an error occurs during the read process at which point

// the function will stop reading data and return.

//

// \return None.

//

//===============================================================

void Nfc_Iso15693_ReadTag(uint8_t ui8ReqFlag)

{

uint16_t ui16ReadBlocks = 0x00;

uint16_t ui16LoopCount = 0x00;

ui16ReadBlocks = Iso15693_GetSystemInfo(ui8ReqFlag); // Get Tag Information with Request Flag = 0x02

if (ui16ReadBlocks != 0x00)

{

// Read all available blocks on the ISO15693 Tag

for (ui16LoopCount = 0; ui16LoopCount < ui16ReadBlocks+1; ui16LoopCount++)

{

if (Iso15693_ReadSingleBlock(ui8ReqFlag, ui16LoopCount) == STATUS_FAIL) // Keep reading blocks unless a No Response is received

{

// No Response - stop reading

break;

}

}

}

}

void ISO15693FindTag(void)

{

uint8_t ui8TagFound = STATUS_FAIL;

uint8_t ui8AddressedFlag = 0x00;

Trf797xTurnRfOn(); // Ensure TRF797x is outputting an RF Field

Trf797xWriteInitiatorSetup(0x02); // Configure the TRF797x for ISO15693 @ High Bit Rate, One Subcarrier, 1 out of 4

IRQ_CLR; // PORT2 interrupt flag clear

IRQ_ON;

// The VCD should wait at least 1 ms after it activated the

// powering field before sending the first request, to

// ensure that the VICCs are ready to receive it. (ISO15693-3)

osi_Sleep(10);

//McuDelayMillisecond(20);

Iso15693_Reset_TagCount();

ui8TagFound = Iso15693_SingleSlotInventory(); // Send a single slot inventory request to try and detect a single ISO15693 Tag

// Inventory failed - search with full anticollision routine

if (ui8TagFound == STATUS_FAIL)

{

McuDelayMillisecond(5); // Delay before issuing the anticollision commmand

ui8TagFound = Iso15693_Anticollision(0x06, 0x00, 0x00); // Send 16 Slot Inventory request with no mask length and no AFI

ui8AddressedFlag = 0x20; // Collision occurred, send addressed commands

}

if (ui8TagFound == STATUS_SUCCESS)

{

if (Iso15693_Get_TagCount() > 1)

{

UartPutCrlf();

UartSendCString("Multiple ISO15693 Tags Found.");

UartPutCrlf();

UartSendCString("Number of ISO15693 Tags Detected: ");

UartPutChar('0' + Iso15693_Get_TagCount());

UartPutCrlf();

UartSendCString("Please place only 1 tag in the RF Field at a time to read tag data.");

UartPutCrlf();

}

else

{

Nfc_Iso15693_ReadTag(0x02 | ui8AddressedFlag); // Read an ISO15693 tag

}

}

else

{

}

Trf797xTurnRfOff(); // Turn off RF field once done reading the tag(s)

}

spi_for_trf.h

/*

* {spi_for_trf.h}

*

* {Header File}

*

* Copyright (C) 2013 Texas Instruments Incorporated - http://www.ti.com/

*

*

* Redistribution and use in source and binary forms, with or without

* modification, are permitted provided that the following conditions

* are met:

*

* Redistributions of source code must retain the above copyright

* notice, this list of conditions and the following disclaimer.

*

* Redistributions in binary form must reproduce the above copyright

* notice, this list of conditions and the following disclaimer in the

* documentation and/or other materials provided with the

* distribution.

*

* Neither the name of Texas Instruments Incorporated nor the names of

* its contributors may be used to endorse or promote products derived

* from this software without specific prior written permission.

*

* THIS SOFTWARE IS PROVIDED BY THE COPYRIGHT HOLDERS AND CONTRIBUTORS

* "AS IS" AND ANY EXPRESS OR IMPLIED WARRANTIES, INCLUDING, BUT NOT

* LIMITED TO, THE IMPLIED WARRANTIES OF MERCHANTABILITY AND FITNESS FOR

* A PARTICULAR PURPOSE ARE DISCLAIMED. IN NO EVENT SHALL THE COPYRIGHT

* OWNER OR CONTRIBUTORS BE LIABLE FOR ANY DIRECT, INDIRECT, INCIDENTAL,

* SPECIAL, EXEMPLARY, OR CONSEQUENTIAL DAMAGES (INCLUDING, BUT NOT

* LIMITED TO, PROCUREMENT OF SUBSTITUTE GOODS OR SERVICES; LOSS OF USE,

* DATA, OR PROFITS; OR BUSINESS INTERRUPTION) HOWEVER CAUSED AND ON ANY

* THEORY OF LIABILITY, WHETHER IN CONTRACT, STRICT LIABILITY, OR TORT

* (INCLUDING NEGLIGENCE OR OTHERWISE) ARISING IN ANY WAY OUT OF THE USE

* OF THIS SOFTWARE, EVEN IF ADVISED OF THE POSSIBILITY OF SUCH DAMAGE.

*

*/

#ifndef _SPI_TRF_H_

#define _SPI_TRF_H_

#include "types.h"

#include "hw_types.h"

//================================================================

//===============================================================

extern void SpiDirectCommand(u08_t *pbuf);

extern void SpiDirectMode(void);

extern void SpiRawWrite(u08_t *pbuf, u08_t length);

extern void SpiReadCont(u08_t *pbuf, u08_t length);

extern void SpiReadSingle(u08_t *pbuf, u08_t number);

extern void SpiWriteCont(u08_t *pbuf, u08_t length);

extern void SpiWriteSingle(u08_t *pbuf, u08_t length);

//===============================================================

//*****************************************************************************

// Values that can be passed to SPIConfigSetExpClk() as ulMode parameter

//*****************************************************************************

#define SPI_MODE_MASTER 0x00000000

#define SPI_MODE_SLAVE 0x00000004

//*****************************************************************************

// Values that can be passed to SPIConfigSetExpClk() as ulSubMode parameter

//*****************************************************************************

#define SPI_SUB_MODE_0 0x00000000

#define SPI_SUB_MODE_1 0x00000001

#define SPI_SUB_MODE_2 0x00000002

#define SPI_SUB_MODE_3 0x00000003

//*****************************************************************************

// Values that can be passed to SPIConfigSetExpClk() as ulConfigFlags parameter

//*****************************************************************************

#define SPI_SW_CTRL_CS 0x01000000

#define SPI_HW_CTRL_CS 0x00000000

#define SPI_3PIN_MODE 0x02000000

#define SPI_4PIN_MODE 0x00000000

#define SPI_TURBO_ON 0x00080000

#define SPI_TURBO_OFF 0x00000000

#define SPI_CS_ACTIVEHIGH 0x00000000

#define SPI_CS_ACTIVELOW 0x00000040

#define SPI_WL_8 0x00000380

#define SPI_WL_16 0x00000780

#define SPI_WL_32 0x00000F80

//*****************************************************************************

// Values that can be passed to SPIFIFOEnable() and SPIFIFODisable()

//*****************************************************************************

#define SPI_TX_FIFO 0x08000000

#define SPI_RX_FIFO 0x10000000

//*****************************************************************************

// Values that can be passed to SPIDMAEnable() and SPIDMADisable()

//*****************************************************************************

#define SPI_RX_DMA 0x00008000

#define SPI_TX_DMA 0x00004000

//*****************************************************************************

// Values that can be passed to SPIIntEnable(), SPIIntDiasble(),

// SPIIntClear() or returned from SPIStatus()

//*****************************************************************************

#define SPI_INT_DMATX 0x20000000

#define SPI_INT_DMARX 0x10000000

#define SPI_INT_EOW 0x00020000

#define SPI_INT_WKS 0x00010000

#define SPI_INT_RX_OVRFLOW 0x00000008

#define SPI_INT_RX_FULL 0x00000004

#define SPI_INT_TX_UDRFLOW 0x00000002

#define SPI_INT_TX_EMPTY 0x00000001

//*****************************************************************************

// Values that can be passed to SPITransfer()

//*****************************************************************************

#define SPI_CS_ENABLE 0x00000001

#define SPI_CS_DISABLE 0x00000002

#endif

spi_for_trf.c

/*

* {spi_for_trf.c}

*

* {SPI Interface Functions}

*

* Copyright (C) 2013 Texas Instruments Incorporated - http://www.ti.com/

*

*

* Redistribution and use in source and binary forms, with or without

* modification, are permitted provided that the following conditions

* are met:

*

* Redistributions of source code must retain the above copyright

* notice, this list of conditions and the following disclaimer.

*

* Redistributions in binary form must reproduce the above copyright

* notice, this list of conditions and the following disclaimer in the

* documentation and/or other materials provided with the

* distribution.

*

* Neither the name of Texas Instruments Incorporated nor the names of

* its contributors may be used to endorse or promote products derived

* from this software without specific prior written permission.

*

* THIS SOFTWARE IS PROVIDED BY THE COPYRIGHT HOLDERS AND CONTRIBUTORS

* "AS IS" AND ANY EXPRESS OR IMPLIED WARRANTIES, INCLUDING, BUT NOT

* LIMITED TO, THE IMPLIED WARRANTIES OF MERCHANTABILITY AND FITNESS FOR

* A PARTICULAR PURPOSE ARE DISCLAIMED. IN NO EVENT SHALL THE COPYRIGHT

* OWNER OR CONTRIBUTORS BE LIABLE FOR ANY DIRECT, INDIRECT, INCIDENTAL,

* SPECIAL, EXEMPLARY, OR CONSEQUENTIAL DAMAGES (INCLUDING, BUT NOT

* LIMITED TO, PROCUREMENT OF SUBSTITUTE GOODS OR SERVICES; LOSS OF USE,

* DATA, OR PROFITS; OR BUSINESS INTERRUPTION) HOWEVER CAUSED AND ON ANY

* THEORY OF LIABILITY, WHETHER IN CONTRACT, STRICT LIABILITY, OR TORT

* (INCLUDING NEGLIGENCE OR OTHERWISE) ARISING IN ANY WAY OUT OF THE USE

* OF THIS SOFTWARE, EVEN IF ADVISED OF THE POSSIBILITY OF SUCH DAMAGE.

*

*/

#include "hw_types.h"

#include "spi.h"

#include "spi_for_trf.h"

#include "gpio_if.h"

#include "trf797x.h"

#include "hw_memmap.h"

#include "hw_common_reg.h"

#include "hw_ints.h"

#include "pin.h"

#include "rom.h"

#include "rom_map.h"

#include "utils.h"

#include "prcm.h"

#include "interrupt.h"

#include "pinmux.h"

#include "uart.h"

#include "uart_if.h"

#include "types.h"

#include "trf7970BoosterPack.h"

#define ASSERT_CS() (SPI_CS_ON)

#define DEASSERT_CS() (SPI_CS_OFF)

typedef unsigned int Fd_t;

//===============================================================

u08_t temp = 0;

extern u08_t direct_mode;

//===============================================================

void SpiStartCondition(void);

void SpiStopCondition(void);

void SpiUsciSet(void);

void SpiUsciDisable(void);

//===============================================================

// NAME: void SpiDirectCommand (u08_t *pbuf)

//

// BRIEF: Is used in SPI mode to transmit a Direct Command to

// reader chip.

//

// INPUTS:

// Parameters:

// u08_t *pbuf Direct Command

//

// OUTPUTS:

//

// PROCESS: [1] transmit Direct Command

//

// CHANGE:

// DATE WHO DETAIL

// 24Nov2010 RP Original Code

// 07Dec2010 RP integrated wait while busy loops

//===============================================================

void

SpiDirectCommand(u08_t *pbuf)

{

unsigned char ucDummy;

// set Address/Command Word Bit Distribution to command

*pbuf = (0x80 | *pbuf); // command

*pbuf = (0x9f & *pbuf); // command code

SPI_CS_OFF;

SPITransfer(GSPI_BASE, pbuf, &ucDummy, 1, SPI_CS_ENABLE);

SPI_CS_ON;

}

//===============================================================

// NAME: void SpiDirectMode (void)

//

// BRIEF: Is used in SPI mode to start Direct Mode.

//

// INPUTS:

//

// OUTPUTS:

//

// PROCESS: [1] start Direct Mode

//

// NOTE: No stop condition

//

// CHANGE:

// DATE WHO DETAIL

// 24Nov2010 RP Original Code

// 07Dec2010 RP integrated wait while busy loops

//===============================================================

void

SpiDirectMode(void)

{

u08_t command [2];

command[0] = TRF797x_STATUS_CONTROL;

command[1] = TRF797x_STATUS_CONTROL;

// read byte to command[1]

SPI_CS_OFF;

SPITransfer(GSPI_BASE, 0, &command[1], 1, SPI_CS_ENABLE);

command[1] |= 0x60; // RF on and BIT 6 in Chip Status Control Register set

// write command[0] byte

SPITransfer(GSPI_BASE, command, 0, 1, SPI_CS_ENABLE);

SpiWriteSingle(command, 2);

SPI_CS_ON;

}

//===============================================================

// NAME: void SpiRawWrite (u08_t *pbuf, u08_t length)

//

// BRIEF: Is used in SPI mode to write direct to the reader chip.

//

// INPUTS:

// Parameters:

// u08_t *pbuf raw data

// u08_t length number of data bytes

//

// OUTPUTS:

//

// PROCESS: [1] send raw data to reader chip

//

// CHANGE:

// DATE WHO DETAIL

// 24Nov2010 RP Original Code

// 07Dec2010 RP integrated wait while busy loops

//===============================================================

void

SpiRawWrite(u08_t *pbuf, u08_t length)

{

SPI_CS_OFF;

SPITransfer(GSPI_BASE, pbuf, 0, length, SPI_CS_ENABLE);

SPI_CS_ON;

}

//===============================================================

// NAME: void SpiReadCont (u08_t *pbuf, u08_t length)

//

// BRIEF: Is used in SPI mode to read a specified number of

// reader chip registers from a specified address upwards.

//

// INPUTS:

// Parameters:

// u08_t *pbuf address of first register

// u08_t length number of registers

//

// OUTPUTS:

//

// PROCESS: [1] read registers

// [2] write contents to *pbuf

//

// CHANGE:

// DATE WHO DETAIL

// 24Nov2010 RP Original Code

// 07Dec2010 RP integrated wait while busy loops

//===============================================================

void

SpiReadCont(u08_t *pbuf, u08_t length)

{

// Address/Command Word Bit Distribution

*pbuf = (0x60 | *pbuf); // address, read, continuous

*pbuf = (0x7f &*pbuf); // register address

// write command address/word

SPI_CS_OFF;

SPITransfer(GSPI_BASE, pbuf, 0, 1, SPI_CS_ENABLE);

// read length bytes into pbuf[length]

SPITransfer(GSPI_BASE, 0, pbuf, length, SPI_CS_ENABLE);

SPI_CS_ON;

}

//===============================================================

// NAME: void SpiReadSingle (u08_t *pbuf, u08_t number)

//

// BRIEF: Is used in SPI mode to read specified reader chip

// registers.

//

// INPUTS:

// Parameters:

// u08_t *pbuf addresses of the registers

// u08_t number number of the registers

//

// OUTPUTS:

//

// PROCESS: [1] read registers

// [2] write contents to *pbuf

//

// CHANGE:

// DATE WHO DETAIL

// 24Nov2010 RP Original Code

// 07Dec2010 RP integrated wait while busy loops

//===============================================================

void

SpiReadSingle(u08_t *pbuf, u08_t number)

{

SPI_CS_OFF;

while(number > 0)

{

// Address/Command Word Bit Distribution

*pbuf = (0x40 | *pbuf); // address, read, single

*pbuf = (0x5f & *pbuf); // register address

// write address/command byte into pbuf

SPITransfer(GSPI_BASE, pbuf, 0, 1, SPI_CS_ENABLE);

// read single byte into pbuf

SPITransfer(GSPI_BASE, 0, pbuf, 1, SPI_CS_ENABLE);

pbuf++;

number--;

}

SPI_CS_ON;

}

//===============================================================

// NAME: void SpiWriteCont (u08_t *pbuf, u08_t length)

//

// BRIEF: Is used in SPI mode to write to a specific number of

// reader chip registers from a specific address upwards.

//

// INPUTS:

// u08_t *pbuf address of first register followed by the

// contents to write

// u08_t length number of registers + 1

//

// OUTPUTS:

//

// PROCESS: [1] write to the registers

//

// CHANGE:

// DATE WHO DETAIL

// 24Nov2010 RP Original Code

// 07Dec2010 RP integrated wait while busy loops

//===============================================================

void

SpiWriteCont(u08_t *pbuf, u08_t length)

{

SPI_CS_OFF;

// Address/Command Word Bit Distribution

*pbuf = (0x20 | *pbuf); // address, write, continuous

*pbuf = (0x3f &*pbuf); // register address

// write command address/word + number of registers

SPITransfer(GSPI_BASE, pbuf, 0, length, SPI_CS_ENABLE);

SPI_CS_ON;

}

//===============================================================

// NAME: void SpiWriteSingle (u08_t *pbuf, u08_t length)

//

// BRIEF: Is used in SPI mode to write to a specified reader chip

// registers.

//

// INPUTS:

// u08_t *pbuf addresses of the registers followed by the

// contends to write

// u08_t length number of registers * 2

//

// OUTPUTS:

//

// PROCESS: [1] write to the registers

//

// CHANGE:

// DATE WHO DETAIL

// 24Nov2010 RP Original Code

// 07Dec2010 RP integrated wait while busy loops

//===============================================================

void

SpiWriteSingle(u08_t *pbuf, u08_t length)

{

SPI_CS_OFF;

while(length > 0)

{

// Address/Command Word Bit Distribution

// address, write, single (fist 3 bits = 0)

*pbuf = (0x1f &*pbuf); // register address

SPITransfer(GSPI_BASE, pbuf, 0, 2, SPI_CS_ENABLE);

pbuf=pbuf + 2;

length=length - 2;

}

SPI_CS_ON;

}

trf7970BoosterPack.h

/*

* {trf7970BoosterPack.h}

*

* {Header File}

*

* Copyright (C) 2013 Texas Instruments Incorporated - http://www.ti.com/

*

*

* Redistribution and use in source and binary forms, with or without

* modification, are permitted provided that the following conditions

* are met:

*

* Redistributions of source code must retain the above copyright

* notice, this list of conditions and the following disclaimer.

*

* Redistributions in binary form must reproduce the above copyright

* notice, this list of conditions and the following disclaimer in the

* documentation and/or other materials provided with the

* distribution.

*

* Neither the name of Texas Instruments Incorporated nor the names of

* its contributors may be used to endorse or promote products derived

* from this software without specific prior written permission.

*

* THIS SOFTWARE IS PROVIDED BY THE COPYRIGHT HOLDERS AND CONTRIBUTORS

* "AS IS" AND ANY EXPRESS OR IMPLIED WARRANTIES, INCLUDING, BUT NOT

* LIMITED TO, THE IMPLIED WARRANTIES OF MERCHANTABILITY AND FITNESS FOR

* A PARTICULAR PURPOSE ARE DISCLAIMED. IN NO EVENT SHALL THE COPYRIGHT

* OWNER OR CONTRIBUTORS BE LIABLE FOR ANY DIRECT, INDIRECT, INCIDENTAL,

* SPECIAL, EXEMPLARY, OR CONSEQUENTIAL DAMAGES (INCLUDING, BUT NOT

* LIMITED TO, PROCUREMENT OF SUBSTITUTE GOODS OR SERVICES; LOSS OF USE,

* DATA, OR PROFITS; OR BUSINESS INTERRUPTION) HOWEVER CAUSED AND ON ANY

* THEORY OF LIABILITY, WHETHER IN CONTRACT, STRICT LIABILITY, OR TORT

* (INCLUDING NEGLIGENCE OR OTHERWISE) ARISING IN ANY WAY OUT OF THE USE

* OF THIS SOFTWARE, EVEN IF ADVISED OF THE POSSIBILITY OF SUCH DAMAGE.

*

*/

#ifndef _Trf7970BOOSTERPACK_H_

#define _Trf7970BOOSTERPACK_H_

//================================================================

#include <stdint.h>

#include "types.h"

#include "gpio_if.h"

#define _BOARD_H

/* This macro is for use by other macros to form a fully valid C statement. */

#define st(x) do { x } while (__LINE__ == -1)

#define COUNT_1ms 80000

#define IRQ_CLR GPIOIntClear(GPIOA1_BASE, GPIO_PIN_4); //GPIO 7

#define IRQ_ON GPIOIntEnable(GPIOA1_BASE,GPIO_PIN_4);

#define IRQ_OFF GPIOIntDisable(GPIOA1_BASE,GPIO_PIN_4);

#define START_COUNTER A2CounterEnable();

#define RESET_COUNTER A2CounterDisable();

#define STOP_COUNTER A2CounterStop();

#define TRF_OFF GPIO_IF_Set(11,0);

#define TRF_ON GPIO_IF_Set(11,1);

#define SPI_CS_ON MAP_SPICSEnable(GSPI_BASE);

#define SPI_CS_OFF MAP_SPICSDisable(GSPI_BASE);

void Delay(unsigned long interval);

void McuDelayMillisecond(unsigned int ui_delay_in_msec);

//===============================================================

#define TRIGGER 0 // if TRIGGER 1 trigger-point at LED 5

//=====MCU constants=============================================

// IRQ on P2.0

// rising edge interrupt

#define IRQ_PIN BIT7

#define IRQ_PORT HWREG(GPIOA1_BASE + GPIO_O_GPIO_RIS)

// Hard code to only SPI mode

#define SPIMODE 1

// CSn

//-----Counter-timer constants-----------------------------------

//---------------------------------------------------------------

// Set timer capture register value based on clock source

//---------------------------------------------------------------

// 25MHz clock

//===============================================================

#endif

trf7970BoosterPack.c

/*

* {trf7970BoosterPack.c}

*

* {MSP430G2553 specific functions}

*

* Copyright (C) 2013 Texas Instruments Incorporated - http://www.ti.com/

*

*

* Redistribution and use in source and binary forms, with or without

* modification, are permitted provided that the following conditions

* are met:

*

* Redistributions of source code must retain the above copyright

* notice, this list of conditions and the following disclaimer.

*

* Redistributions in binary form must reproduce the above copyright

* notice, this list of conditions and the following disclaimer in the

* documentation and/or other materials provided with the

* distribution.

*

* Neither the name of Texas Instruments Incorporated nor the names of

* its contributors may be used to endorse or promote products derived

* from this software without specific prior written permission.

*

* THIS SOFTWARE IS PROVIDED BY THE COPYRIGHT HOLDERS AND CONTRIBUTORS

* "AS IS" AND ANY EXPRESS OR IMPLIED WARRANTIES, INCLUDING, BUT NOT

* LIMITED TO, THE IMPLIED WARRANTIES OF MERCHANTABILITY AND FITNESS FOR

* A PARTICULAR PURPOSE ARE DISCLAIMED. IN NO EVENT SHALL THE COPYRIGHT

* OWNER OR CONTRIBUTORS BE LIABLE FOR ANY DIRECT, INDIRECT, INCIDENTAL,

* SPECIAL, EXEMPLARY, OR CONSEQUENTIAL DAMAGES (INCLUDING, BUT NOT

* LIMITED TO, PROCUREMENT OF SUBSTITUTE GOODS OR SERVICES; LOSS OF USE,

* DATA, OR PROFITS; OR BUSINESS INTERRUPTION) HOWEVER CAUSED AND ON ANY

* THEORY OF LIABILITY, WHETHER IN CONTRACT, STRICT LIABILITY, OR TORT

* (INCLUDING NEGLIGENCE OR OTHERWISE) ARISING IN ANY WAY OUT OF THE USE

* OF THIS SOFTWARE, EVEN IF ADVISED OF THE POSSIBILITY OF SUCH DAMAGE.

*

*/

#include "trf797x.h"

#include "trf7970BoosterPack.h"

#include "utils.h"

//*****************************************************************************

//

//! Delay

//!

//! \param interval is time in milli second

//!

//! \return none

//!

//! \brief

//

//****************************************************************************

void Delay(unsigned long interval)

{

while(interval > 0)

{

UtilsDelay(80000);

interval--;

}

}

void McuDelayMillisecond(unsigned int ui_delay_in_msec){

UtilsDelay(80000*ui_delay_in_msec);

}

trf797x.h

/*

* File Name: trf797x.h

*

* Description: Headers and Defines for TRF797x Driver Functions

*

* Copyright (C) 2016 Texas Instruments Incorporated - http://www.ti.com/

*

*

* Redistribution and use in source and binary forms, with or without

* modification, are permitted provided that the following conditions

* are met:

*

* Redistributions of source code must retain the above copyright

* notice, this list of conditions and the following disclaimer.

*

* Redistributions in binary form must reproduce the above copyright

* notice, this list of conditions and the following disclaimer in the

* documentation and/or other materials provided with the

* distribution.

*

* Neither the name of Texas Instruments Incorporated nor the names of

* its contributors may be used to endorse or promote products derived

* from this software without specific prior written permission.

*

* THIS SOFTWARE IS PROVIDED BY THE COPYRIGHT HOLDERS AND CONTRIBUTORS

* "AS IS" AND ANY EXPRESS OR IMPLIED WARRANTIES, INCLUDING, BUT NOT

* LIMITED TO, THE IMPLIED WARRANTIES OF MERCHANTABILITY AND FITNESS FOR

* A PARTICULAR PURPOSE ARE DISCLAIMED. IN NO EVENT SHALL THE COPYRIGHT

* OWNER OR CONTRIBUTORS BE LIABLE FOR ANY DIRECT, INDIRECT, INCIDENTAL,

* SPECIAL, EXEMPLARY, OR CONSEQUENTIAL DAMAGES (INCLUDING, BUT NOT

* LIMITED TO, PROCUREMENT OF SUBSTITUTE GOODS OR SERVICES; LOSS OF USE,

* DATA, OR PROFITS; OR BUSINESS INTERRUPTION) HOWEVER CAUSED AND ON ANY

* THEORY OF LIABILITY, WHETHER IN CONTRACT, STRICT LIABILITY, OR TORT

* (INCLUDING NEGLIGENCE OR OTHERWISE) ARISING IN ANY WAY OUT OF THE USE

* OF THIS SOFTWARE, EVEN IF ADVISED OF THE POSSIBILITY OF SUCH DAMAGE.

*

*/

#ifndef _TRF797x_H_

#define _TRF797x_H_

//===============================================================

#include "spi_for_trf.h"

#include "uart.h"

#include "uart_if.h"

#include "types.h"

#define ENABLE_STANDALONE

#define NFC_FIFO_SIZE 120

//===============================================================

//==== TRF797x definitions ======================================

//---- Direct commands ------------------------------------------

#define IDLE 0x00

#define SOFT_INIT 0x03

#define INITIAL_RF_COLLISION 0x04

#define RESPONSE_RF_COLLISION_N 0x05

#define RESPONSE_RF_COLLISION_0 0x06

#define RESET 0x0F

#define TRANSMIT_NO_CRC 0x10

#define TRANSMIT_CRC 0x11

#define DELAY_TRANSMIT_NO_CRC 0x12

#define DELAY_TRANSMIT_CRC 0x13

#define TRANSMIT_NEXT_SLOT 0x14

#define CLOSE_SLOT_SEQUENCE 0x15

#define STOP_DECODERS 0x16

#define RUN_DECODERS 0x17

#define CHECK_INTERNAL_RF 0x18

#define CHECK_EXTERNAL_RF 0x19

#define ADJUST_GAIN 0x1A

//---- Registers ------------------------------------------------

#define TRF797x_STATUS_CONTROL 0x00

#define TRF797x_ISO_CONTROL 0x01

#define TRF797x_ISO_14443_TX_OPTIONS 0x02

#define TRF797x_ISO_14443_BITRATE_OPTIONS 0x03

#define TRF797x_TX_TIMER_EPC_HIGH 0x04

#define TRF797x_TX_TIMER_EPC_LOW 0x05

#define TRF797x_TX_PULSE_LENGTH_CONTROL 0x06

#define TRF797x_RX_NO_RESPONSE_WAIT_TIME 0x07

#define TRF797x_RX_WAIT_TIME 0x08

#define TRF797x_MODULATOR_CONTROL 0x09

#define TRF797x_RX_SPECIAL_SETTINGS 0x0A

#define TRF797x_REGULATOR_CONTROL 0x0B

#define TRF797x_IRQ_STATUS 0x0C // IRQ Status Register

#define TRF797x_IRQ_MASK 0x0D // Collision Position and Interrupt Mask Register

#define TRF797x_COLLISION_POSITION 0x0E

#define TRF797x_RSSI_LEVELS 0x0F

#define TRF797x_SPECIAL_FUNCTION_1 0x10

#define TRF797x_SPECIAL_FUNCTION_2 0x11

#define TRF797x_FIFO_IRQ_LEVELS 0x14

#define TRF797x_NFC_LOW_DETECTION 0x16

#define TRF797x_NFC_TARGET_LEVEL 0x18

#define TRF797x_NFC_TARGET_PROTOCOL 0x19

#define TRF797x_TEST_SETTINGS_1 0x1A

#define TRF797x_TEST_SETTINGS_2 0x1B

#define TRF797x_FIFO_STATUS 0x1C

#define TX_LENGTH_BYTE_1 0x1D

#define TX_LENGTH_BYTE_2 0x1E

#define FIFO 0x1F

//---- IRQ STATUS -----------------------------------------------

#define TRF797x_IRQ_STATUS_IDLE 0x00

#define TRF797x_IRQ_STATUS_NO_RESPONSE 0x01

#define TRF797x_IRQ_STATUS_COLLISION_ERROR 0x02

#define TRF797x_IRQ_STATUS_FRAMING_ERROR 0x04

#define TRF797x_IRQ_STATUS_PARITY_ERROR 0x08

#define TRF797x_IRQ_STATUS_CRC_ERROR 0x10

#define TRF797x_IRQ_STATUS_FIFO_HIGH_OR_LOW 0x20

#define TRF797x_IRQ_STATUS_RX_COMPLETE 0x40

#define TRF797x_IRQ_STATUS_TX_COMPLETE 0x80

//==== End of TRF797x definitions ===============================

//===============================================================

typedef enum

{

TRF_IDLE,

RX_COMPLETE,

TX_COMPLETE,

TX_ERROR,

RX_WAIT,

RX_WAIT_EXTENSION,

TX_WAIT,

PROTOCOL_ERROR,

NO_RESPONSE_RECEIVED,

NO_RESPONSE_RECEIVED_15693

}tTRF797x_Status;

//===============================================================

extern void Trf797xCommunicationSetup(void);

extern void Trf797xDirectCommand(u08_t *ui8Value);

extern void Trf797xDisableSlotCounter(void);

extern void Trf797xEnableSlotCounter(void);

extern void Trf797xInitialSettings(void);

extern void Trf797xRawWrite(u08_t * pui8Payload, u08_t ui8Length);

extern void Trf797xReConfig(void);

extern void Trf797xReadCont(u08_t * pui8Payload, u08_t ui8Length);

extern u08_t Trf797xReadIsoControl(void);

extern void Trf797xReadIrqStatus(u08_t * pui8Value);

extern void Trf797xReadSingle(u08_t *pbuf, u08_t number);

extern u08_t Trf797xReadStatusControl(void);

extern void Trf797xReset(void);

extern void Trf797xResetIrqStatus(void);

extern void Trf797xRunDecoders(void);

extern void Trf797xStopDecoders(void);

extern void Trf797xTransmitNextSlot(void);

extern void Trf797xTurnRfOff(void);

extern void Trf797xTurnRfOn(void);

extern void Trf797xWriteCont(u08_t * pui8Payload, u08_t ui8Length);

extern void Trf797xWriteIsoControl(u08_t ui8IsoControl);

extern void Trf797xWriteRegister(u08_t ui8TrfRegister, u08_t ui8Value);

extern void Trf797xWriteInitiatorSetup(u08_t ui8IsoControl);

extern void Trf797xWriteSingle(u08_t *pbuf, u08_t length);

extern void Trf797xIrqWaitTimeout(long ui8TxTimeout, long ui8RxTimeout);

extern void Trf797xIrqWaitTimeoutTxOnly(u08_t ui8TxTimeout);

extern void Trf797xIrqWaitTimeoutRxOnly(u08_t ui8RxTimeout);

extern void Trf797xIrqWaitTimeoutFeliCa(void);

extern tTRF797x_Status Trf797xGetTrfStatus(void);

extern void Trf797xSetTrfStatus(tTRF797x_Status sTrfStatus);

extern u08_t Trf797xGetCollisionPosition(void);

extern void Trf797xSetCollisionPosition(u08_t ui8ColPos);

extern u08_t Trf797xGetRxBytesReceived(void);

extern u08_t Trf797xGetIsoControlValue(void);

extern u08_t Trf797xReadRssiLevels(void);

extern bool Trf797xCheckRfField(void);

extern void A2CNTIntHandler (void);

extern void Trf797xIRQ(void);

extern void StatusPrint(tTRF797x_Status sTrfStatus);

extern u08_t g_ui8FifoRxLength;

//===============================================================

#endif

trf797x.c

/*

* File Name: trf797x.c

*

* Description: TRF797x Driver Functions

*

* Copyright (C) 2016 Texas Instruments Incorporated - http://www.ti.com/

*

*

* Redistribution and use in source and binary forms, with or without

* modification, are permitted provided that the following conditions

* are met:

*

* Redistributions of source code must retain the above copyright

* notice, this list of conditions and the following disclaimer.

*

* Redistributions in binary form must reproduce the above copyright

* notice, this list of conditions and the following disclaimer in the

* documentation and/or other materials provided with the

* distribution.

*

* Neither the name of Texas Instruments Incorporated nor the names of

* its contributors may be used to endorse or promote products derived

* from this software without specific prior written permission.

*

* THIS SOFTWARE IS PROVIDED BY THE COPYRIGHT HOLDERS AND CONTRIBUTORS

* "AS IS" AND ANY EXPRESS OR IMPLIED WARRANTIES, INCLUDING, BUT NOT

* LIMITED TO, THE IMPLIED WARRANTIES OF MERCHANTABILITY AND FITNESS FOR

* A PARTICULAR PURPOSE ARE DISCLAIMED. IN NO EVENT SHALL THE COPYRIGHT

* OWNER OR CONTRIBUTORS BE LIABLE FOR ANY DIRECT, INDIRECT, INCIDENTAL,

* SPECIAL, EXEMPLARY, OR CONSEQUENTIAL DAMAGES (INCLUDING, BUT NOT

* LIMITED TO, PROCUREMENT OF SUBSTITUTE GOODS OR SERVICES; LOSS OF USE,

* DATA, OR PROFITS; OR BUSINESS INTERRUPTION) HOWEVER CAUSED AND ON ANY

* THEORY OF LIABILITY, WHETHER IN CONTRACT, STRICT LIABILITY, OR TORT

* (INCLUDING NEGLIGENCE OR OTHERWISE) ARISING IN ANY WAY OUT OF THE USE

* OF THIS SOFTWARE, EVEN IF ADVISED OF THE POSSIBILITY OF SUCH DAMAGE.

*

*/

#include <string.h>

#include <stdio.h>

#include "hw_types.h"

#include "hw_memmap.h"

#include "trf797x.h"

#include "trf7970BoosterPack.h"

#include "timer_if.h"

#include "gpio.h"

#include "osi.h"

//===============================================================

u08_t g_ui8TrfBuffer[NFC_FIFO_SIZE];

static u08_t g_ui8CollisionPosition = 0;

static u08_t g_ui8FifoOffset = 0;

u08_t g_ui8FifoRxLength = 0;

static bool g_bRfFieldOn = false;

static u08_t g_ui8IsoControlValue = 0x00;

static tTRF797x_Status g_sTrf797xStatus = TRF_IDLE;

static volatile u08_t g_ui8IrqFlag = 0x00;

static volatile u08_t g_ui8TimeoutFlag = 0x00;

u08_t command[2];

//===============================================================

//

// Trf797xCommunicationSetup - Initialize Communication to TRF797x

//

// Call the appropriate serial communication initialize based on

// hardware setup

//

// \return None.

//

//===============================================================

void

Trf797xCommunicationSetup(void)

{

A2CounterInit(A2CNTIntHandler);

RESET_COUNTER;

STOP_COUNTER;

command[0] = SOFT_INIT;

Trf797xDirectCommand(command);

command[0] = IDLE;

Trf797xDirectCommand(command);

command[0] = TRF797x_MODULATOR_CONTROL;

command[1] = 0x01; // ASK 100%, no SYS_CLK output

Trf797xWriteSingle(command, 2);

command[0] = TRF797x_NFC_TARGET_LEVEL;

command[1] = 0x00;

Trf797xWriteSingle(command, 2);

}

//===============================================================

//

// Trf797xDirectCommand - Send a Direct Command to TRF797x.

//

// \param ui8Value is the direct command to be issued

//

// Function is used to transmit a Direct Command to TRF797x.

//

// \return None.

//

//===============================================================

void

Trf797xDirectCommand(u08_t *ui8Value)

{

SpiDirectCommand(ui8Value);

}

//===============================================================

//

// Trf797xDisableSlotCounter - Disables interrupts from 15693

// slot counter function.

//

// Turns off the firing of the IRQ interrupt when a 15693 slot

// hits the No Response timeout

//

// \return None.

//

//===============================================================

void

Trf797xDisableSlotCounter(void)

{

u08_t pui8ModControl[2];

pui8ModControl[0] = TRF797x_IRQ_MASK; // next slot counter

pui8ModControl[1] = TRF797x_IRQ_MASK;

Trf797xReadSingle(&pui8ModControl[1], 1);

pui8ModControl[1] &= 0xFE; // clear BIT0 in register 0x01

Trf797xWriteSingle(pui8ModControl, 2);

}

//===============================================================

//

// Trf797xEnableSlotCounter - Enables interrupts from 15693

// slot counter function.

//

// Turns on the firing of the IRQ interrupt when a 15693 slot

// hits the No Response timeout

//

// \return None.

//

//===============================================================

void

Trf797xEnableSlotCounter(void)

{

u08_t pui8ModControl[2];

pui8ModControl[0] = TRF797x_IRQ_MASK; // next slot counter

pui8ModControl[1] = TRF797x_IRQ_MASK;

Trf797xReadSingle(&pui8ModControl[1],1);

pui8ModControl[1] |= BIT0; // set BIT0 in register 0x01

Trf797xWriteSingle(pui8ModControl,2);

}

//===============================================================

//

// Trf797xEnableSlotCounter - Initialize TRF797x

//

// Handles setting up the clock register and writes register 0x18

// as per TRF7970A Errata

//

// \return None.

//

//===============================================================

void

Trf797xInitialSettings(void)

{

command[0] = SOFT_INIT;

Trf797xDirectCommand(command);

command[0] = IDLE;

Trf797xDirectCommand(command);

command[0] = TRF797x_MODULATOR_CONTROL;

command[1] = 0x01; // ASK 100%, no SYS_CLK output

Trf797xWriteSingle(command,2);

command[0] = TRF797x_NFC_TARGET_LEVEL;

command[1] = 0x00;

Trf797xWriteSingle(command,2);

}

//===============================================================

//

// Trf797xISR - Services TRF797x IRQ interrupts

//

// \param pui8_IrqStatus is the received IRQ Status flags

//

// The Interrupt Service Routine determines how the IRQ should

// be handled. The Trf797x IRQ status register is read to

// determine the cause of the IRQ. Conditions are checked and

// appropriate actions taken.

//

// \return None.

//

//===============================================================

void

Trf797xISR(u08_t * pui8_IrqStatus)

{

u08_t ui8DummyRead;

u08_t ui8Length;

if(*pui8_IrqStatus == (TRF797x_IRQ_STATUS_TX_COMPLETE | TRF797x_IRQ_STATUS_FIFO_HIGH_OR_LOW)) // BIT5 and BIT7

{ // TX active and 32 bytes left in FIFO

g_sTrf797xStatus = TX_COMPLETE;

}

else if(*pui8_IrqStatus == TRF797x_IRQ_STATUS_TX_COMPLETE)

{ // TX complete

g_sTrf797xStatus = TX_COMPLETE;

Trf797xReset(); // reset the FIFO after TX

}

else if((*pui8_IrqStatus & BIT1) == TRF797x_IRQ_STATUS_COLLISION_ERROR)

{ // Collision error

g_sTrf797xStatus = PROTOCOL_ERROR;

if ((g_ui8IsoControlValue == 0x08) || (g_ui8IsoControlValue == 0x88))

{

g_ui8CollisionPosition = TRF797x_COLLISION_POSITION;

Trf797xReadSingle(&g_ui8CollisionPosition, 1);

if (g_ui8CollisionPosition > 0x20)

{

ui8Length = g_ui8CollisionPosition - 0x20; // number of valid bytes in FIFO

if((ui8Length & 0x0F) != 0x00)

{

ui8Length = ui8Length + 0x10; // add 1 byte if broken byte recieved

}

ui8Length = ui8Length >> 4;

if(ui8Length != 0x00)

{

g_ui8TrfBuffer[g_ui8FifoOffset] = FIFO; // write the recieved bytes to the correct place of the buffer

Trf797xReadCont(&g_ui8TrfBuffer[g_ui8FifoOffset], ui8Length);

g_ui8FifoOffset = g_ui8FifoOffset + ui8Length;

}

}

else

{

g_ui8FifoRxLength = TRF797x_FIFO_STATUS;

Trf797xReadSingle(&g_ui8FifoRxLength,1); // determine the number of bytes left in FIFO

g_ui8FifoRxLength = 0x7F & g_ui8FifoRxLength;

g_ui8TrfBuffer[g_ui8FifoOffset] = FIFO; // write the recieved bytes to the correct place of the buffer

Trf797xReadCont(&g_ui8TrfBuffer[g_ui8FifoOffset], g_ui8FifoRxLength);

g_ui8FifoOffset = g_ui8FifoOffset + g_ui8FifoRxLength;

}

}

Trf797xStopDecoders();

Trf797xReset(); // reset the FIFO after TX

Trf797xResetIrqStatus();

IRQ_CLR;

}

else if(*pui8_IrqStatus == TRF797x_IRQ_STATUS_RX_COMPLETE || *pui8_IrqStatus == 0xC0)

{

//10-20-2016 Fix

//TRF7970A returns C0 (TX_IRQ = 1, RX_IRQ = 1) during selection command

//Really strange, but reading from fifo right afterwards does work for some reason...

// RX flag means that EOF has been recieved

// and the number of unread bytes is in FIFOstatus regiter

g_ui8FifoRxLength = TRF797x_FIFO_STATUS;

Trf797xReadSingle(&g_ui8FifoRxLength, 1); // determine the number of bytes left in FIFO

g_ui8FifoRxLength = 0x7F & g_ui8FifoRxLength;

g_ui8TrfBuffer[g_ui8FifoOffset] = FIFO; // write the recieved bytes to the correct place of the buffer

Trf797xReadCont(&g_ui8TrfBuffer[g_ui8FifoOffset], g_ui8FifoRxLength);

g_ui8FifoOffset = g_ui8FifoOffset + g_ui8FifoRxLength;

Trf797xReset(); // reset the FIFO after last byte has been read out

if (g_sTrf797xStatus == RX_WAIT_EXTENSION)

{

g_ui8FifoRxLength = g_ui8FifoOffset;

}

g_sTrf797xStatus = RX_COMPLETE;

}

else if(*pui8_IrqStatus == (TRF797x_IRQ_STATUS_RX_COMPLETE | TRF797x_IRQ_STATUS_FIFO_HIGH_OR_LOW))

{ // RX active and 96 bytes allready in FIFO

g_sTrf797xStatus = RX_WAIT;

// Read FIFO Status to determine how many bytes are in the FIFO

g_ui8FifoRxLength = TRF797x_FIFO_STATUS;

Trf797xReadSingle(&g_ui8FifoRxLength, 1);

g_ui8FifoRxLength = 0x7F & g_ui8FifoRxLength;

if (NFC_FIFO_SIZE > (g_ui8FifoOffset+g_ui8FifoRxLength))

{

// Read from the FIFO to empty it

g_ui8TrfBuffer[g_ui8FifoOffset] = FIFO;

Trf797xReadCont(&g_ui8TrfBuffer[g_ui8FifoOffset], g_ui8FifoRxLength); // read all received bytes from FIFO

g_ui8FifoOffset = g_ui8FifoOffset + g_ui8FifoRxLength; // Adjust buffer index

}

else

{

g_sTrf797xStatus = PROTOCOL_ERROR;

return;

}

// Read FIFO Status again to determine if more bytes have been received

g_ui8FifoRxLength = TRF797x_FIFO_STATUS;

Trf797xReadSingle(&g_ui8FifoRxLength, 1); // determine the number of bytes left in FIFO

g_ui8FifoRxLength = 0x7F & g_ui8FifoRxLength;

if (g_ui8FifoRxLength > 0)

{

g_sTrf797xStatus = RX_WAIT_EXTENSION;

}

else

{

g_ui8FifoRxLength = g_ui8FifoOffset;

g_sTrf797xStatus = RX_COMPLETE;

return;

}

}

else if (*pui8_IrqStatus == (TRF797x_IRQ_STATUS_RX_COMPLETE | TRF797x_IRQ_STATUS_NO_RESPONSE))

{

// RX has begun but as not completed, space exists in FIFO still, just wait longer to receive full reply.

g_sTrf797xStatus = RX_WAIT_EXTENSION;

}

else if((*pui8_IrqStatus & BIT4) == TRF797x_IRQ_STATUS_CRC_ERROR) // CRC error

{

if((*pui8_IrqStatus & BIT5) == TRF797x_IRQ_STATUS_FIFO_HIGH_OR_LOW)

{

g_sTrf797xStatus = RX_WAIT;

}

if((*pui8_IrqStatus & BIT6) == TRF797x_IRQ_STATUS_RX_COMPLETE) // 4 Bit receive

{

ui8DummyRead = FIFO; // write the recieved bytes to the correct place of the buffer

Trf797xReadCont(&ui8DummyRead, 1);

Trf797xReset();

g_sTrf797xStatus = PROTOCOL_ERROR;

}

else

{

g_sTrf797xStatus = PROTOCOL_ERROR;

}

}

else if((*pui8_IrqStatus & BIT2) == TRF797x_IRQ_STATUS_FRAMING_ERROR) // byte framing error

{

if((*pui8_IrqStatus & BIT5) == TRF797x_IRQ_STATUS_FIFO_HIGH_OR_LOW)

{

g_sTrf797xStatus = RX_WAIT;

}

else

{

g_sTrf797xStatus = PROTOCOL_ERROR;

}

}

else if(*pui8_IrqStatus == TRF797x_IRQ_STATUS_IDLE)

{ // No response interrupt

//g_sTrf797xStatus = NO_RESPONSE_RECEIVED;

}

else if(*pui8_IrqStatus == TRF797x_IRQ_STATUS_NO_RESPONSE)

{ // No response interrupt

g_sTrf797xStatus = NO_RESPONSE_RECEIVED_15693;

g_ui8FifoOffset = 0;

}

else

{ // Interrupt register not properly set

g_sTrf797xStatus = PROTOCOL_ERROR;

Trf797xStopDecoders(); // reset the FIFO after TX

Trf797xReset();

Trf797xResetIrqStatus();

IRQ_CLR;

}

} // Interrupt Service Routine

//===============================================================

//

// Trf797xIRQ - Interrupt handler for IRQ interrupts

//

// Handles receiving IRQ's, getting IRQ status, and maintaining

// timers/global variables

//

// \return None.

//

//===============================================================

void

Trf797xIRQ(void) // interrupt handler

{

u08_t ui8IrqStatus, ui8IsoControl;

RESET_COUNTER; // stop timer mode

STOP_COUNTER;

g_ui8IrqFlag = 0x01;

do

{

IRQ_CLR; // PORT2 interrupt flag clear

// IRQ status register has to be read

Trf797xReadIrqStatus(&ui8IrqStatus);

//UartSendCString("IRQ Status: ");

//UartPutByteHex(ui8IrqStatus);

//UartPutCrlf();

if(ui8IrqStatus == 0xA0) // TX active and only 3 bytes left in FIFO

{

g_sTrf797xStatus = TX_WAIT;

//StatusPrint(g_sTrf797xStatus);

break;

}

else

{

ui8IsoControl = TRF797x_ISO_CONTROL;

Trf797xReadSingle(&ui8IsoControl, 1);

if((ui8IsoControl & BIT5) != BIT5) // RFID mode

{

Trf797xISR(&ui8IrqStatus);

//StatusPrint(g_sTrf797xStatus);

}

else // NFC mode

{

// Do Nothing

}

}

} while(GPIOIntStatus(GPIOA1_BASE,1) & GPIO_PIN_4);

}

//===============================================================

//

// Trf797xRawWrite - Write data to TRF797x

//

// \param pui8Payload is the buffer with data packet contents

// \param ui8Length is the size of the data packet

//

// Function is used to write data directly to the TRF797x.

//

// \return None.

//

//===============================================================

void

Trf797xRawWrite(u08_t * pui8Payload, u08_t ui8Length)

{

u08_t ui8TxBytesRemaining;

u08_t ui8TxIndex;

u08_t ui8FifoTxLength;

u08_t ui8TxBytesAvailable;

if (127 > ui8Length)

{

SpiRawWrite(pui8Payload, ui8Length);

}

else

{

ui8TxBytesRemaining = ui8Length;

ui8TxIndex = 0;

ui8TxBytesAvailable = 127;

while(ui8TxBytesRemaining > 0)

{

if (ui8TxBytesRemaining > 127)

{

SpiRawWrite(&pui8Payload[ui8TxIndex], ui8TxBytesAvailable);

ui8TxBytesRemaining = ui8TxBytesRemaining - ui8TxBytesAvailable;

ui8TxIndex = ui8TxIndex + ui8TxBytesAvailable;

}

else

{

SpiRawWrite(&pui8Payload[ui8TxIndex], ui8TxBytesRemaining);

}

Trf797xIrqWaitTimeoutTxOnly(35);

g_sTrf797xStatus = Trf797xGetTrfStatus();

if ((g_sTrf797xStatus == TX_COMPLETE) || (g_sTrf797xStatus == TX_WAIT))

{

ui8FifoTxLength = TRF797x_FIFO_STATUS;

Trf797xReadSingle(&ui8FifoTxLength, 1); // determine the number of bytes left in FIFO

ui8TxBytesAvailable = 127-ui8FifoTxLength;

}

else

{

// Error occurred, break

g_sTrf797xStatus = TX_ERROR;

break;

}

}

}

}

//===============================================================

//

// Trf797xReadCont - Read out multiple TRF797x registers

//

// \param pui8Payload is the address of the first register as

// well as the pointer for buffer where the results will be

// \param ui8Length is the number of registers to read

//

// Function used to read a specified number of TRF797x registers

// from a specified address.

//

// \return None.

//

//===============================================================

void

Trf797xReadCont(u08_t * pui8Payload, u08_t ui8Length)

{

SpiReadCont(pui8Payload, ui8Length);

}

//===============================================================

//

// Trf797xReadIsoControl - Read the ISO Control Register

//

// Function used to read the ISO Control Register of the TRF797x

//

// \return pui8Value returns the value of the ISO Control

// Register

//

//===============================================================

u08_t

Trf797xReadIsoControl(void)

{

u08_t pui8Value[1];

*pui8Value = TRF797x_ISO_CONTROL;

SpiReadSingle(pui8Value, 1);

g_ui8IsoControlValue = pui8Value[0]; // Update the ISO Control Register variable

return pui8Value[0];

}

//===============================================================

//

// Trf797xReadIrqStatus - Read out the IRQ Status Register

//

// \param pui8Value is the pointer to the buffer where the

// result will be

//

// Function used to read the IRQ Status register of the TRF797x

// and store the result into the location pointed to by the input

//

// \return None.

//

//===============================================================

void

Trf797xReadIrqStatus(u08_t * pui8Value)

{

*pui8Value = TRF797x_IRQ_STATUS;

SpiReadSingle(pui8Value, 1);

/*

*pui8Value = TRF797x_IRQ_STATUS;

*(pui8Value + 1) = TRF797x_IRQ_MASK;

Trf797xReadCont(pui8Value, 2); // read second reg. as dummy read

*/

}

//===============================================================

//

// Trf797xReadSingle - Read out a single TRF797x registers

//

// \param pui8Value is the address of the register to read as

// well as pointer for the buffer where the result will be

//

// Function used to read a specific TRF797x register

//

// \return None.

//

//===============================================================

void

Trf797xReadSingle(u08_t *pbuf, u08_t number)

{

SpiReadSingle(pbuf, number);

}

//===============================================================

//

// Trf797xReadStatusControl - Read the Chip Status Control

// Register

//

// Function used to read the Chip Status Control Register of the

// TRF797x

//

// \return pui8Value returns the value of the Chip Status Control

// Register

//

//===============================================================

u08_t

Trf797xReadStatusControl(void)

{

u08_t pui8Value[1];

*pui8Value = TRF797x_STATUS_CONTROL;

SpiReadSingle(pui8Value, 1);

if ((pui8Value[0] & BIT5) == BIT5) // Check for RF field bit and update variable

{

g_bRfFieldOn = true;

}

else

{

g_bRfFieldOn = false;

}

return pui8Value[0];

}

//===============================================================

//

// Trf797xReset - Resets TRF797x

//

// Function used to reset the TRF797x

//

// \return None.

//

//===============================================================

void

Trf797xReset(void)

{

command[0] = RESET;

Trf797xDirectCommand(command);

}

//===============================================================

//

// Trf797xReset - Resets the IRQ Status Register of the TRF797x

//

// Function used to reset the TRF797x IRQ Status Register

//

// \return None.

//

//===============================================================

void

Trf797xResetIrqStatus(void)

{

u08_t puiIrqStatus[2];

puiIrqStatus[0] = TRF797x_IRQ_STATUS;

puiIrqStatus[1] = TRF797x_IRQ_MASK;

Trf797xReadCont(puiIrqStatus, 2); // read second reg. as dummy read

}

//===============================================================

//

// Trf797xRunDecoders - Direct command to enable TRF797x receivers

//

// Issue direct command 0x17 - Enable Receivers to the TRF797x

//

// \return None.

//

//===============================================================

void

Trf797xRunDecoders(void)

{

command[0] = RUN_DECODERS;

Trf797xDirectCommand(command);

}

//===============================================================

//

// Trf797xStopDecoders - Direct command to disable TRF797x

// receivers

//

// Issue direct command 0x16 - Block Receivers to the TRF797x

//

// \return None.

//

//===============================================================

void

Trf797xStopDecoders(void)

{

command[0] = STOP_DECODERS;

Trf797xDirectCommand(command);

}

//===============================================================

//

// Trf797xTransmitNextSlot - Direct command to transmit next slot

// for ISO15693 End of Frame

//

// Issue direct command 0x14 - End of Frame/Transmit Next Time Slot

// (ISO15693) to the TRF797x

//

// \return None.

//

//===============================================================

void

Trf797xTransmitNextSlot(void)

{

command[0] = TRANSMIT_NEXT_SLOT;

Trf797xDirectCommand(command);

}

//===============================================================

//

// Trf797xTurnRfOff - Turn off the transmission of the TRF797x

// RF Field

//

// Function used stop the TRF797x transmitting an RF field

//

// \return None.

//

//===============================================================

void

Trf797xTurnRfOff(void)

{

u08_t pui8Command[2];

pui8Command[0] = TRF797x_STATUS_CONTROL;

pui8Command[1] = 0x00; // 3.3VDC, full power out

// pui8Command[1] = 0x10; // 3.3VDC, half power out

Trf797xWriteSingle(pui8Command, 2);

g_bRfFieldOn = false; // Update RF Field variable

}

//===============================================================

//

// Trf797xTurnRfOn - Turns on the transmission of the TRF797x

// RF Field

//

// Function used make the TRF797x transmit an RF field

//

// \return None.

//

//===============================================================

void

Trf797xTurnRfOn(void)

{

u08_t pui8Command[2];

pui8Command[0] = TRF797x_STATUS_CONTROL;

pui8Command[1] = 0x20; // 3.3VDC, full power out

// pui8Command[1] = 0x30; // 3.3VDC, half power out

Trf797xWriteSingle(pui8Command, 2);

g_bRfFieldOn = true; // Update RF Field variable

}

//===============================================================

//

// Trf797xWriteCont - Write to consecutive TRF797x registers

//

// \param pui8Payload is the address of the first register

// followed by the contents to write for each register

// \param ui8Length is the number of registers to write + 1

// Minimum value of ui8Length allowed = 2 (a write to 1 register)

//

// Function used to write to a specific number of TRF797x

// registers from a specific address.

//

// \return None.

//

//===============================================================

void

Trf797xWriteCont(u08_t * pui8Payload, u08_t ui8Length)

{

if (ui8Length > 1) // Cannot specify a length of 1

{

if (*pui8Payload == 0x00) // If the write starts at the Chip Status Control Register

{

if (((*pui8Payload+1) & BIT5) == BIT5) // Check for RF field bit and update variable

{

g_bRfFieldOn = true;

}

else

{

g_bRfFieldOn = false;

}

if (ui8Length > 2) // Check if the write length includes the ISO Control Register being written to (0x01)

{

g_ui8IsoControlValue = (*pui8Payload+2); // If so, update the Iso Control Register variable

}

}

else if (*pui8Payload == 0x01) // If the write starts at the ISO Control Register

{

g_ui8IsoControlValue = *pui8Payload+1; // Update the ISO Control Register variable

}

// Call continuous write function

SpiWriteCont(pui8Payload, ui8Length);

}

else

{

// Error, cannot specify a length of 1

return;

}

}

//===============================================================

//

// Trf797xWriteIsoControl - Write to TRF797x ISO Control Register

//

// \param ui8IsoControl is the value to write to the ISO control

// register of the TRF797x

//

// Function used to write a new value into the ISO Control

// register of the TRF797x.

//

// \return None.

//

//===============================================================

void

Trf797xWriteIsoControl(u08_t ui8IsoControl)

{

u08_t pui8Write[2];

if((ui8IsoControl & BIT5) == BIT5)

{

// Attempt to enable Card Emulation/Peer to Peer which is not supported by firmware

// Exit function to avoid issues with that

return;

}

pui8Write[0] = TRF797x_ISO_CONTROL;

pui8Write[1] = ui8IsoControl;

pui8Write[1] &= ~BIT5;

Trf797xWriteSingle(pui8Write, 2);

g_ui8IsoControlValue = ui8IsoControl; // Update the ISO Control Register variable

}

//===============================================================

//

// Trf797xWriteRegister - Write single to a TRF797x Register

//

// \param ui8TrfRegister is the register address for the write

// \param ui8Value is the value to write to the specified

// register

//

// Function used to write a new value into a single TRF797x

// register.

//

// \return None.

//

//===============================================================

void

Trf797xWriteRegister(u08_t ui8TrfRegister, u08_t ui8Value)

{

u08_t pui8Write[2];

if (ui8TrfRegister == TRF797x_ISO_CONTROL)

{

// Attempt to enable Card Emulation/Peer to Peer which is not supported by firmware

// Exit function to avoid issues with that

if ((ui8Value & BIT5) == BIT5)

{

return;

}

g_ui8IsoControlValue = ui8Value; // Update the ISO Control Register variable

}

if (ui8TrfRegister == TRF797x_STATUS_CONTROL)

{

if ((ui8Value & BIT5) == BIT5) // Check for RF field bit and update variable

{

g_bRfFieldOn = true;

}

else

{

g_bRfFieldOn = false;

}

}

pui8Write[0] = ui8TrfRegister;

pui8Write[1] = ui8Value;

Trf797xWriteSingle(pui8Write, 2);

}

//===============================================================

//

// Trf797xWriteInitiatorSetup - Write the initial settings for

// a set of TRF797x registers based on which protocol is to be

// enabled.

//

// \param ui8IsoControl is the value to write to the ISO Control

// register of the TRF797x

//

// Function used to write to a series of TRF797x registers based

// on which technology will be enabled in the ISO control register

// This function currently only enables 1 technology at a time

//

// \return None.

//

//===============================================================

void

Trf797xWriteInitiatorSetup(u08_t ui8IsoControl)

{

u08_t pui8Write[2];

g_ui8IsoControlValue = ui8IsoControl; // Update the ISO Control Register variable

if (ui8IsoControl == 0x88) // ISO14443A

{

// Register 0x00

pui8Write[0] = TRF797x_STATUS_CONTROL;

pui8Write[1] = 0x20;

Trf797xWriteSingle(pui8Write, 2);

// Register 0x01

pui8Write[0] = TRF797x_ISO_CONTROL;

pui8Write[1] = ui8IsoControl;

Trf797xWriteSingle(pui8Write, 2);

// Register 0x09 - System Clock Output, Modulation Scheme

pui8Write[0] = TRF797x_MODULATOR_CONTROL;

pui8Write[1] = 0x01; // Sys Clock Output = 13.56MHz, OOK = 100%

Trf797xWriteSingle(pui8Write, 2);

}

if (ui8IsoControl == 0x0C) // ISO14443B

{

// Register 0x01

pui8Write[0] = TRF797x_ISO_CONTROL;

pui8Write[1] = ui8IsoControl;

Trf797xWriteSingle(pui8Write, 2);

// Register 0x09 - System Clock Output, Modulation Scheme

pui8Write[0] = TRF797x_MODULATOR_CONTROL;

pui8Write[1] = 0x00; // Sys Clock Output = 13.56MHz, ASK 10%

Trf797xWriteSingle(pui8Write, 2);

}

if (ui8IsoControl == 0x02) // ISO15693

{

pui8Write[0] = TRF797x_STATUS_CONTROL;

pui8Write[1] = 0x20;

Trf797xWriteSingle(pui8Write, 2);

// Register 0x01

pui8Write[0] = TRF797x_ISO_CONTROL;

pui8Write[1] = ui8IsoControl;

Trf797xWriteSingle(pui8Write, 2);

// Resgister 0x07 - No Response Wait Time

pui8Write[0] = TRF797x_RX_NO_RESPONSE_WAIT_TIME;

pui8Write[1] = 0x15;

Trf797xWriteSingle(pui8Write, 2);

// Register 0x09 - System Clock Output, Modulation Scheme

pui8Write[0] = TRF797x_MODULATOR_CONTROL;

pui8Write[1] = 0x01; // Sys Clock Output = 13.56MHz, OOK = 100%

Trf797xWriteSingle(pui8Write, 2);

/* write[0] = 0x20; //Continuous Write, starting with register 0x00

write[1] = 0x20; //Value for Chip Status Control Register 0x00, 0x20 = +3.3VDC, full power, etc.

write[2] = 0x02; //Value for ISO Control Register 0x01, 0x02 = high tag data rate, etc.

write[3] = 0x00; //0x02

write[4] = 0x00;

write[5] = 0xC1;

write[6] = 0xBB;

write[7] = 0x00;

write[8] = 0x30;

write[9] = 0x1F;

write[10] = 0x01;

write[11] = 0x40;

write[12] = 0x03;*/

/* // Register 0x00

pui8Write[0] = TRF797x_STATUS_CONTROL;

pui8Write[1] = 0x20;

Trf797xWriteSingle(pui8Write, 2);

// Register 0x01

pui8Write[0] = TRF797x_ISO_CONTROL;

pui8Write[1] = ui8IsoControl;

Trf797xWriteSingle(pui8Write, 2);

// Register 0x02

pui8Write[0] = TRF797x_ISO_14443_TX_OPTIONS;

pui8Write[1] = 0x00;

Trf797xWriteSingle(pui8Write, 2);

// Register 0x03

pui8Write[0] = TRF797x_ISO_14443_BITRATE_OPTIONS;

pui8Write[1] = 0x00;

Trf797xWriteSingle(pui8Write, 2);

// Register 0x04

pui8Write[0] = TRF797x_TX_TIMER_EPC_HIGH;

pui8Write[1] = 0xC1;

Trf797xWriteSingle(pui8Write, 2);

// Register 0x05

pui8Write[0] = TRF797x_TX_TIMER_EPC_LOW;

pui8Write[1] = 0xBB;

Trf797xWriteSingle(pui8Write, 2);

// Register 0x06

pui8Write[0] = TRF797x_TX_PULSE_LENGTH_CONTROL;

pui8Write[1] = 0x00;

Trf797xWriteSingle(pui8Write, 2);

// Resgister 0x07 - No Response Wait Time

pui8Write[0] = TRF797x_RX_NO_RESPONSE_WAIT_TIME;

pui8Write[1] = 0x30;

Trf797xWriteSingle(pui8Write, 2);

// Resgister 0x08 -

pui8Write[0] = TRF797x_RX_WAIT_TIME;

pui8Write[1] = 0x1F;

Trf797xWriteSingle(pui8Write, 2);

// Register 0x09 - System Clock Output, Modulation Scheme

pui8Write[0] = TRF797x_MODULATOR_CONTROL;

pui8Write[1] = 0x01; // Sys Clock Output = 13.56MHz, OOK = 100%

Trf797xWriteSingle(pui8Write, 2);

// Register 0x0A

pui8Write[0] = TRF797x_RX_SPECIAL_SETTINGS;

pui8Write[1] = 0x40;

Trf797xWriteSingle(pui8Write, 2);

// Register 0x0B

pui8Write[0] = TRF797x_REGULATOR_CONTROL;

pui8Write[1] = 0x03;

Trf797xWriteSingle(pui8Write, 2);

*/

/* write[0] = 0x20; //Continuous Write, starting with register 0x00

write[1] = 0x20; //Value for Chip Status Control Register 0x00, 0x20 = +3.3VDC, full power, etc.

write[2] = 0x02; //Value for ISO Control Register 0x01, 0x02 = high tag data rate, etc.

write[3] = 0x00; //0x02

write[4] = 0x00;

write[5] = 0xC1;

write[6] = 0xBB;

write[7] = 0x00;

write[8] = 0x30;

write[9] = 0x1F;

write[10] = 0x01;

write[11] = 0x40;

write[12] = 0x03;*/

//Trf797xWriteCont(write, 13); //writes registers 0x00:0x0B

}

if (ui8IsoControl == 0x1A) // FeliCa

{

// Register 0x01

pui8Write[0] = TRF797x_ISO_CONTROL;

pui8Write[1] = ui8IsoControl;

Trf797xWriteSingle(pui8Write, 2);

// Register 0x09 - System Clock Output, Modulation Scheme

pui8Write[0] = TRF797x_MODULATOR_CONTROL;

pui8Write[1] = 0x00; // Sys Clock Output = 13.56MHz, ASK 10%

Trf797xWriteSingle(pui8Write, 2);

}

if (ui8IsoControl == 0x86) // PicoPass

{

// Register 0x01

pui8Write[0] = TRF797x_ISO_CONTROL;

pui8Write[1] = ui8IsoControl;

Trf797xWriteSingle(pui8Write, 2);

// Register 0x09 - System Clock Output, Modulation Scheme

pui8Write[0] = TRF797x_MODULATOR_CONTROL;

pui8Write[1] = 0x00; // Sys Clock Output = 13.56MHz, ASK 10%

Trf797xWriteSingle(pui8Write, 2);

}

// Register 0x14 - Adjustable FIFO Level

pui8Write[0] = TRF797x_FIFO_IRQ_LEVELS;

if (ui8IsoControl == 0x86)

{

// TX water level set to 32 bytes for PicoPass

pui8Write[1] = 0x0F;

}

else

{

pui8Write[1] = 0x0C;

}

Trf797xWriteSingle(pui8Write, 2);

}

//===============================================================

//

// Trf797xWriteSingle - Write single to a TRF797x Register

//

// \param pui8Value is a pointer to a buffer which has the

// Register address for the write followed by the data to be

// written to that register

//

// Function used to write a new value into a single TRF797x

// register.

//

// \return None.

//

//===============================================================

void

Trf797xWriteSingle(u08_t *pbuf, u08_t length)

{

SpiWriteSingle(pbuf, length);

}

//===============================================================

//

// Trf797xIrqWaitTimeout - Timeout sequence for both TX and RX

//

// \param ui8TxTimeout is the TX timeout in milliseconds

// \param ui8RxTimeout is the RX timeout in milliseconds

//

// Function is used to ensure data is transmitted correct as well

// as determine if data has been received prior to the RX timeout

// When the RX timeout occurs before data is received, then mark

// the TRF797x status as a No Response Received status.

//

// \return None.

//

//===============================================================

void Trf797xIrqWaitTimeout(long ui8TxTimeout, long ui8RxTimeout)

{

g_ui8FifoOffset = 0; // Reset the FIFO Offset prior to receiving data

g_sTrf797xStatus = RX_WAIT;

g_ui8TimeoutFlag = 0x00;

while((g_sTrf797xStatus != TX_COMPLETE) && (g_sTrf797xStatus != TX_ERROR))

{ // Wait for end of TX

// Clear the IRQ Flag

g_ui8IrqFlag = 0x00;

// Setup for the Timer

// Calculate the timeout value for the timer

A2CounterLoad(COUNT_1ms * ui8TxTimeout);

// Start the Timeout

START_COUNTER;

while((g_ui8IrqFlag == 0x00) && (g_ui8TimeoutFlag == 0x00)) // Wait for an interrupt

{

// Do Nothing

}

RESET_COUNTER;

STOP_COUNTER;

if (g_sTrf797xStatus != TX_COMPLETE)

{

if (g_sTrf797xStatus == TX_WAIT) // Wait longer since we received an 0xA0

{

UartSendCString("Received TX_WAIT\n\r");

Trf797xIrqWaitTimeoutTxOnly(ui8TxTimeout); // Wait longer for transmission to complete

}

else // Failed to send packet properly - Exit TX Timeout

{

g_sTrf797xStatus = TX_ERROR; // Set status to error

}

}

}

//StatusPrint(g_sTrf797xStatus);

if (g_sTrf797xStatus != TX_ERROR)

{

g_sTrf797xStatus = RX_WAIT;

g_ui8TimeoutFlag = 0x00;

while(g_sTrf797xStatus == RX_WAIT || g_sTrf797xStatus == TX_COMPLETE) // Wait for end of RX or timeout

{

// Clear the IRQ Flag

g_ui8IrqFlag = 0x00;

// Setup for the Timer

// Calculate the timeout value for the timer

A2CounterLoad(COUNT_1ms * ui8RxTimeout);

//A2CounterLoad(COUNT_1ms * 10000);

// Start the Timeout

START_COUNTER;

while((g_ui8IrqFlag == 0x00) && (g_ui8TimeoutFlag == 0x00)) // Wait for an interrupt

{

// Do Nothing

}

//StatusPrint(g_sTrf797xStatus);

while (g_sTrf797xStatus == RX_WAIT_EXTENSION || g_sTrf797xStatus == TX_WAIT)

{

RESET_COUNTER;

STOP_COUNTER;

g_ui8IrqFlag = 0x00;

if ((g_ui8IsoControlValue & 0x1F) > 0x07)

{

A2CounterLoad(COUNT_1ms * 7);

}

else

{

A2CounterLoad(COUNT_1ms * 50);

}

START_COUNTER;

while((g_ui8IrqFlag == 0x00) && (g_ui8TimeoutFlag == 0x00)) // Wait for an interrupt

{

// Do Nothing

}

}

RESET_COUNTER;

STOP_COUNTER;

if (g_sTrf797xStatus == RX_WAIT)

{

// Exit the while loop

g_sTrf797xStatus = NO_RESPONSE_RECEIVED;

}

}

}

}

//===============================================================

//

// Trf797xIrqWaitTimeoutTxOnly - Timeout sequence for just TX

//

// \param ui8TxTimeout is the TX timeout in milliseconds

//

// Function is used to handle delays for transmit only, which

// is helpful when a response is not expected (such as with sleep

// or halt commands)

// This function will not delay to receive any responses

//

// \return None.

//

//===============================================================

void Trf797xIrqWaitTimeoutTxOnly(u08_t ui8TxTimeout)

{

g_sTrf797xStatus = RX_WAIT;

g_ui8TimeoutFlag = 0x00;

while((g_sTrf797xStatus != TX_COMPLETE) && (g_sTrf797xStatus != NO_RESPONSE_RECEIVED) && (g_sTrf797xStatus != TX_ERROR))

{ // Wait for end of TX

// Clear the IRQ Flag

g_ui8IrqFlag = 0x00;

// Setup for the Timer

// Calculate the timeout value for the timer

A2CounterLoad(COUNT_1ms * ui8TxTimeout);

// Start the Timeout

START_COUNTER;

while((g_ui8IrqFlag == 0x00) && (g_ui8TimeoutFlag == 0x00)) // Wait for an interrupt

{

// Do Nothing

}

RESET_COUNTER;

STOP_COUNTER;

if (g_sTrf797xStatus != TX_COMPLETE)

{

if (g_sTrf797xStatus == TX_WAIT) // Wait longer since we received an 0xA0

{

Trf797xIrqWaitTimeoutTxOnly(ui8TxTimeout); // Wait longer for transmission to complete

}

else // Failed to send packet properly - Exit TX Timeout

{

g_sTrf797xStatus = TX_ERROR; // Set status to error

}

}

}

}

//===============================================================

//

// Trf797xIrqWaitTimeoutRxOnly - Timeout sequence for just RX

//

// \param ui8RxTimeout is the RX timeout in milliseconds

//

// Function is used to handle delays for receive only, such as

// when waiting for a response without sending a data package

// during anticollision slot procedures.

//

// \return None.

//

//===============================================================

void Trf797xIrqWaitTimeoutRxOnly(u08_t ui8RxTimeout)

{

g_ui8FifoOffset = 0; // Reset the FIFO Offset prior to receiving data

g_sTrf797xStatus = RX_WAIT;

g_ui8TimeoutFlag = 0x00;

while(g_sTrf797xStatus == RX_WAIT) // Wait for end of RX or timeout

{

// Clear the IRQ Flag

g_ui8IrqFlag = 0x00;

// Setup for the Timer

// Calculate the timeout value for the timer

A2CounterLoad(COUNT_1ms * ui8RxTimeout);

// Start the Timeout

START_COUNTER;

while((g_ui8IrqFlag == 0x00) && (g_ui8TimeoutFlag == 0x00)) // Wait for an interrupt

{

// Do Nothing

}

while (g_sTrf797xStatus == RX_WAIT_EXTENSION)

{

RESET_COUNTER;

STOP_COUNTER;

g_ui8IrqFlag = 0x00;

if ((g_ui8IsoControlValue & 0x1F) > 0x07)

{

A2CounterLoad(COUNT_1ms * 7);

}

else

{

A2CounterLoad(COUNT_1ms * 50);

}

START_COUNTER;

while((g_ui8IrqFlag == 0x00) && (g_ui8TimeoutFlag == 0x00)) // Wait for an interrupt

{

// Do Nothing

}

}

RESET_COUNTER;

STOP_COUNTER;

if (g_sTrf797xStatus == RX_WAIT)

{

// Exit the while loop

g_sTrf797xStatus = NO_RESPONSE_RECEIVED;

}

}

}

//===============================================================

//

// Trf797xIrqWaitTimeoutFeliCa - Timeout sequence for just RX

// specifically for FeliCa slot timings

//

// Function is used to handle receive delays for FeliCa

// anticollision only.

//

// \return None.

//

//===============================================================

void Trf797xIrqWaitTimeoutFeliCa(void)

{

g_ui8FifoOffset = 0; // Reset the FIFO Offset prior to receiving data

g_sTrf797xStatus = RX_WAIT;

g_ui8TimeoutFlag = 0x00;

while(g_sTrf797xStatus == RX_WAIT) // Wait for end of RX or timeout

{

// Clear the IRQ Flag

g_ui8IrqFlag = 0x00;

// Setup for the Timer

// Calculate the timeout value for the timer

A2CounterLoad(2);

// Start the Timeout

START_COUNTER;

while((g_ui8IrqFlag == 0x00) && (g_ui8TimeoutFlag == 0x00)) // Wait for an interrupt

{

// Do Nothing

}

RESET_COUNTER;

STOP_COUNTER;

if (g_sTrf797xStatus == RX_WAIT)

{

// Exit the while loop

g_sTrf797xStatus = NO_RESPONSE_RECEIVED;

}

}

}

//===============================================================

//

// Trf797xGetTrfStatus - Returns current TRF797x driver status

//

// Function is used to pass the current TRF797x driver status

// up to higher layers of the firmware

//

// \return g_sTrf797xStatus returns the current TRF797x drive

// status

//

//===============================================================

tTRF797x_Status Trf797xGetTrfStatus(void)

{

return g_sTrf797xStatus;

}

//===============================================================

//

// Trf797xSetTrfStatus - Set the TRF797x driver status

//

// \param sTrfStatus is the new TRF797x driver status

//

// Function is used to allow higher layers of the firmware to

// set the TRF797x driver status without an IRQ event. Use with

// caution.

//

// \return None.

//

//===============================================================

void Trf797xSetTrfStatus(tTRF797x_Status sTrfStatus)

{

g_sTrf797xStatus = sTrfStatus;

}

//===============================================================

//

// Trf797xGetCollisionPosition - Return the current Collision

// Position value

//

// Function is used to pass the current Collision Position value

// up to higher layers of the firmware. Used for ISO14443 Type A

// anti-collision process.

//

// \return g_ui8CollisionPosition returns the current Collision

// Position value

//

//===============================================================

u08_t Trf797xGetCollisionPosition(void)

{

return g_ui8CollisionPosition;

}

//===============================================================

//

// Trf797xSetCollisionPosition - Set the Collision Position

// variable

//

// \param ui8ColPos is the new Collision Position value

//

// Function is used to allow higher layers of the firmware to

// set the Collision Position variable. Used for ISO14443 Type A

// anti-collision process

//

// \return None.

//

//===============================================================

void Trf797xSetCollisionPosition(u08_t ui8ColPos)

{

g_ui8CollisionPosition = ui8ColPos;

}

//===============================================================

//

// Trf797xGetRxBytesReceived - Returns the Number of RX Bytes

// received by the TRF797x FIFO

//

// Function is used to pass the number of RX bytes received

// during the last packet reception up to higher layers of the

// firmware.

// This can be used by the application layer to check for the

// length of bytes received and ensure packets were correctly

// received.

//

// \return g_ui8FifoRxLength returns the current FIFO RX Length

//

//===============================================================

u08_t Trf797xGetRxBytesReceived(void)

{

return g_ui8FifoRxLength;

}

//===============================================================

//

// Trf797xGetIsoControlValue - Fetch the latest Iso Control

// Register value

//

// Function is used to pass the current Iso Control Register

// value up to higher layers of the firmware.

//

// The Iso Control Register value is updated whenever a read or

// write to the Iso Control Register occurs.

//

// \return g_ui8IsoControlValue returns the current ISO Control

// Register value

//

//===============================================================

u08_t Trf797xGetIsoControlValue(void)

{

return g_ui8IsoControlValue;

}

//===============================================================

//

// Trf797xReadRssiLevels - Reads the RSSI Levels register and then

// returns the value of the latest RSSI measurement

//

// Function is used to determine the latest RSSI Level reading.

// The RSSI Level register is updated when RF data is received

// by the TRF797x. For most accurate reading, this function should

// be called directly following a reception of RF data.

//

// \return pui8Read returns the latest RSSI Register value

//

//===============================================================

u08_t Trf797xReadRssiLevels(void)

{

u08_t pui8Read[1];

pui8Read[0] = TRF797x_RSSI_LEVELS; // read RSSI levels

Trf797xReadSingle(pui8Read, 1);

return pui8Read[0];

}

//===============================================================

//

// Trf797xCheckRfField - Fetch the RfFieldOn variable

//

// Function is used to pass the current RfFieldOn value up to

// higher layers of the firmware

//

// \return g_bRfFieldOn retuns the current RF field status

//

//===============================================================

bool Trf797xCheckRfField(void)

{

return g_bRfFieldOn;

}

//*****************************************************************************

//

//! This function gets triggered when A2CNT interrupt occures

//!

//! \param none

//!

//! \return None

//!

//*****************************************************************************

void A2CNTIntHandler (void){

u08_t ui8IrqStatus;

ui8IrqStatus = 0x00;

STOP_COUNTER;

RESET_COUNTER;

g_ui8TimeoutFlag = 0x01;

Trf797xReadIrqStatus(&ui8IrqStatus);

ui8IrqStatus = ui8IrqStatus & 0xF7; // Set the parity flag to 0

if(ui8IrqStatus == TRF797x_IRQ_STATUS_TX_COMPLETE)

{

g_sTrf797xStatus = TX_COMPLETE;

}

else if(ui8IrqStatus == TRF797x_IRQ_STATUS_IDLE)

{

g_sTrf797xStatus = NO_RESPONSE_RECEIVED;

}

else

{

g_sTrf797xStatus = RX_WAIT;

}

}

void StatusPrint(tTRF797x_Status sTrfStatus) {

switch (sTrfStatus) {

case TRF_IDLE:

UartSendCString("Status: TRF_IDLE\n\r");

break;

case TX_COMPLETE:

UartSendCString("Status: TX_COMPLETE\n\r");

break;

case RX_COMPLETE:

UartSendCString("Status: RX_COMPLETE\n\r");

break;

case TX_ERROR:

UartSendCString("Status: TX_ERROR\n\r");

break;

case RX_WAIT:

UartSendCString("Status: RX_WAIT\n\r");

break;

case RX_WAIT_EXTENSION:

UartSendCString("Status: RX_WAIT_EXTENSION\n\r");

break;

case TX_WAIT:

UartSendCString("Status: TX_WAIT\n\r");

break;

case PROTOCOL_ERROR:

UartSendCString("Status: PROTOCOL_ERROR\n\r");

break;

case NO_RESPONSE_RECEIVED:

UartSendCString("Status: NO_RESPONSE_RECEIVED\n\r");

break;

case NO_RESPONSE_RECEIVED_15693:

UartSendCString("Status: NO_RESPONSE_RECEIVED_15693\n\r");

break;

default:

UartSendCString("Status: Unknown\n\r");

break;

}

}

type_4_ndef.h

/*

* File Name: type_4_ndef.h

*

* Description: Headers for Type 4 NDEF Functions

*

* Copyright (C) 2016 Texas Instruments Incorporated - http://www.ti.com/

*

*

* Redistribution and use in source and binary forms, with or without

* modification, are permitted provided that the following conditions

* are met:

*

* Redistributions of source code must retain the above copyright

* notice, this list of conditions and the following disclaimer.

*

* Redistributions in binary form must reproduce the above copyright

* notice, this list of conditions and the following disclaimer in the

* documentation and/or other materials provided with the

* distribution.

*

* Neither the name of Texas Instruments Incorporated nor the names of

* its contributors may be used to endorse or promote products derived

* from this software without specific prior written permission.

*

* THIS SOFTWARE IS PROVIDED BY THE COPYRIGHT HOLDERS AND CONTRIBUTORS

* "AS IS" AND ANY EXPRESS OR IMPLIED WARRANTIES, INCLUDING, BUT NOT

* LIMITED TO, THE IMPLIED WARRANTIES OF MERCHANTABILITY AND FITNESS FOR

* A PARTICULAR PURPOSE ARE DISCLAIMED. IN NO EVENT SHALL THE COPYRIGHT

* OWNER OR CONTRIBUTORS BE LIABLE FOR ANY DIRECT, INDIRECT, INCIDENTAL,

* SPECIAL, EXEMPLARY, OR CONSEQUENTIAL DAMAGES (INCLUDING, BUT NOT

* LIMITED TO, PROCUREMENT OF SUBSTITUTE GOODS OR SERVICES; LOSS OF USE,

* DATA, OR PROFITS; OR BUSINESS INTERRUPTION) HOWEVER CAUSED AND ON ANY

* THEORY OF LIABILITY, WHETHER IN CONTRACT, STRICT LIABILITY, OR TORT

* (INCLUDING NEGLIGENCE OR OTHERWISE) ARISING IN ANY WAY OUT OF THE USE

* OF THIS SOFTWARE, EVEN IF ADVISED OF THE POSSIBILITY OF SUCH DAMAGE.

*

*/

#ifndef _NDEF_H_

#define _NDEF_H_

//===============================================================

#include "trf797x.h"

//===============================================================

u08_t NDEF_ApplicationSelect(void);

u08_t NDEF_CapabilityContainerSelect(void);

u16_t NDEF_ReadBinary(u16_t ui16FileOffset, u08_t ui8ReadLength);

u08_t NDEF_FileSelect(u16_t ui16FileID);

void NDEF_UpdateBinaryLength(u16_t ui16Nlen);

void Ndef_ReadCC(void);

void Ndef_ReadApplication(void);

void Ndef_WriteText(void);

void Ndef_WriteUri(void);

void Ndef_SetBlockNumberBit(bool bValue);

void NDEF_UpdateBinaryText(void);

void NDEF_UpdateBinaryUri(void);

extern char g_ndef_content[600];

//===============================================================

#endif

type_4_ndef.c

/*

* File Name: type_4_ndef.c

*

* Description: Type 4 NDEF Functions

*

* Copyright (C) 2016 Texas Instruments Incorporated - http://www.ti.com/

*

*

* Redistribution and use in source and binary forms, with or without

* modification, are permitted provided that the following conditions

* are met:

*

* Redistributions of source code must retain the above copyright

* notice, this list of conditions and the following disclaimer.

*

* Redistributions in binary form must reproduce the above copyright

* notice, this list of conditions and the following disclaimer in the

* documentation and/or other materials provided with the

* distribution.

*

* Neither the name of Texas Instruments Incorporated nor the names of

* its contributors may be used to endorse or promote products derived

* from this software without specific prior written permission.

*

* THIS SOFTWARE IS PROVIDED BY THE COPYRIGHT HOLDERS AND CONTRIBUTORS

* "AS IS" AND ANY EXPRESS OR IMPLIED WARRANTIES, INCLUDING, BUT NOT

* LIMITED TO, THE IMPLIED WARRANTIES OF MERCHANTABILITY AND FITNESS FOR

* A PARTICULAR PURPOSE ARE DISCLAIMED. IN NO EVENT SHALL THE COPYRIGHT

* OWNER OR CONTRIBUTORS BE LIABLE FOR ANY DIRECT, INDIRECT, INCIDENTAL,

* SPECIAL, EXEMPLARY, OR CONSEQUENTIAL DAMAGES (INCLUDING, BUT NOT

* LIMITED TO, PROCUREMENT OF SUBSTITUTE GOODS OR SERVICES; LOSS OF USE,

* DATA, OR PROFITS; OR BUSINESS INTERRUPTION) HOWEVER CAUSED AND ON ANY

* THEORY OF LIABILITY, WHETHER IN CONTRACT, STRICT LIABILITY, OR TORT

* (INCLUDING NEGLIGENCE OR OTHERWISE) ARISING IN ANY WAY OUT OF THE USE

* OF THIS SOFTWARE, EVEN IF ADVISED OF THE POSSIBILITY OF SUCH DAMAGE.

*

*/

#include <string.h>

#include "type_4_ndef.h"

#include "trf7970BoosterPack.h"

#include "trf797x.h"

//===============================================================

extern u08_t g_ui8TrfBuffer[NFC_FIFO_SIZE];

static volatile tTRF797x_Status g_sTrfStatus;

static volatile bool g_bBlockNumberBit = 0;

char g_ndef_content[600]; // used for saving a content of TAG buffer

//===============================================================

//Echoes back WTX request from Android HCE

//Overwrites g_sTrfStatus

static void SBlock_WTXEcho(u08_t wtxBuf, u08_t didBuf)

{

u08_t ui8Offset = 0;

//S-Block WTX request. Echo back

// Buffer setup for FIFO writing

g_ui8TrfBuffer[ui8Offset++] = 0x8F; // Reset FIFO

g_ui8TrfBuffer[ui8Offset++] = 0x91; // Send with CRC

g_ui8TrfBuffer[ui8Offset++] = 0x3D; // Write Continuous

g_ui8TrfBuffer[ui8Offset++] = 0x00; // Length of packet in bytes - upper and middle nibbles of transmit byte length

g_ui8TrfBuffer[ui8Offset++] = 0x20; // Length of packet in bytes - lower and broken nibbles of transmit byte length

g_ui8TrfBuffer[ui8Offset++] = wtxBuf; //RATS Command

g_ui8TrfBuffer[ui8Offset++] = didBuf; //RATS Parameters: 128 byte max receive and CID = 0

Trf797xRawWrite(&g_ui8TrfBuffer[0], ui8Offset); // Issue the NDEF Command

Trf797xIrqWaitTimeout(20,50);

g_sTrfStatus = Trf797xGetTrfStatus();

}

u08_t NDEF_ApplicationSelect(void)

{

u08_t ui8SelectSuccess = STATUS_FAIL;

u08_t ui8Offset = 0;

g_ui8TrfBuffer[ui8Offset++] = 0x8F; // Reset FIFO

g_ui8TrfBuffer[ui8Offset++] = 0x91; // Send with CRC

g_ui8TrfBuffer[ui8Offset++] = 0x3D; // Write Continuous

g_ui8TrfBuffer[ui8Offset++] = 0x00; // Length of packet in bytes - upper and middle nibbles of transmit byte length

g_ui8TrfBuffer[ui8Offset++] = 0xE0; // Length of packet in bytes - lower and broken nibbles of transmit byte length

g_ui8TrfBuffer[ui8Offset++] = 0x02 | g_bBlockNumberBit; // I-Block PCB: Read Block 0 or Block 1, with CID = 0, NAD = 0, no chaining

g_ui8TrfBuffer[ui8Offset++] = 0x00; // CLA

g_ui8TrfBuffer[ui8Offset++] = 0xA4; // INS = Select (Application in this case)

g_ui8TrfBuffer[ui8Offset++] = 0x04; // P1

g_ui8TrfBuffer[ui8Offset++] = 0x00; // P2

g_ui8TrfBuffer[ui8Offset++] = 0x07; // Lc

g_ui8TrfBuffer[ui8Offset++] = 0xD2; // Data = 0xD2760000850101 - per NFC Forum Type 4 Tag Operation

g_ui8TrfBuffer[ui8Offset++] = 0x76;

g_ui8TrfBuffer[ui8Offset++] = 0x00;

g_ui8TrfBuffer[ui8Offset++] = 0x00;

g_ui8TrfBuffer[ui8Offset++] = 0x85;

g_ui8TrfBuffer[ui8Offset++] = 0x01;

g_ui8TrfBuffer[ui8Offset++] = 0x01;

g_ui8TrfBuffer[ui8Offset++] = 0x00; // Le

Trf797xRawWrite(&g_ui8TrfBuffer[0], ui8Offset); // Issue the NDEF Command

Trf797xIrqWaitTimeout(20,100); // 10 millisecond TX timeout, 20 millisecond RX timeout

g_sTrfStatus = Trf797xGetTrfStatus();

// If data received, should return same PCB, SW1 = 0x90, SW2 = 0x00

if (g_sTrfStatus == RX_COMPLETE)

{

if (g_ui8TrfBuffer[0] == 0xF2)

{

//Delay a bit before echoing

McuDelayMillisecond(50);

SBlock_WTXEcho(g_ui8TrfBuffer[0], g_ui8TrfBuffer[1]);

}

if(g_sTrfStatus == RX_COMPLETE && (g_ui8TrfBuffer[0] == 0x02 | g_bBlockNumberBit) && (g_ui8TrfBuffer[1] == 0x90) && (g_ui8TrfBuffer[2] == 0x00))

{

//Copy received payload except the first two

unsigned int copyIdx;

//Clear buffer first

memset(g_ndef_content, 0, sizeof g_ndef_content);

for (copyIdx = 3; copyIdx < g_ui8FifoRxLength; copyIdx++) {

g_ndef_content[copyIdx - 3] = g_ui8TrfBuffer[copyIdx];

}

ui8SelectSuccess = STATUS_SUCCESS;

}

}

g_bBlockNumberBit = !g_bBlockNumberBit; // Toggle the PCB Block Number

return ui8SelectSuccess;

}

u08_t NDEF_CapabilityContainerSelect(void)

{

u08_t ui8SelectSuccess = STATUS_FAIL;

u08_t ui8Offset = 0;

g_ui8TrfBuffer[ui8Offset++] = 0x8F; // Reset FIFO

g_ui8TrfBuffer[ui8Offset++] = 0x91; // Send with CRC

g_ui8TrfBuffer[ui8Offset++] = 0x3D; // Write Continuous

g_ui8TrfBuffer[ui8Offset++] = 0x00; // Length of packet in bytes - upper and middle nibbles of transmit byte length

g_ui8TrfBuffer[ui8Offset++] = 0x80; // Length of packet in bytes - lower and broken nibbles of transmit byte length

g_ui8TrfBuffer[ui8Offset++] = 0x02 | g_bBlockNumberBit; // I-Block PCB: Read Block 0 or Block 1, with CID = 0, NAD = 0, no chaining

g_ui8TrfBuffer[ui8Offset++] = 0x00; // CLA

g_ui8TrfBuffer[ui8Offset++] = 0xA4; // INS = Read CC

g_ui8TrfBuffer[ui8Offset++] = 0x00; // P1

g_ui8TrfBuffer[ui8Offset++] = 0x0C; // P2

g_ui8TrfBuffer[ui8Offset++] = 0x02; // Lc

g_ui8TrfBuffer[ui8Offset++] = 0xE1; // Data = 0xE103 - per NFC Forum Type 4 Tag Operation

g_ui8TrfBuffer[ui8Offset++] = 0x03;

Trf797xRawWrite(&g_ui8TrfBuffer[0], ui8Offset); // Issue the NDEF Command

Trf797xIrqWaitTimeout(200,200); // 10 millisecond TX timeout, 20 millisecond RX timeout

g_sTrfStatus = Trf797xGetTrfStatus();

// If data received, should return same PCB, SW1 = 0x90, SW2 = 0x00

if (g_sTrfStatus == RX_COMPLETE)

{

if (g_ui8TrfBuffer[0] == 0xF2)

{

SBlock_WTXEcho(g_ui8TrfBuffer[0], g_ui8TrfBuffer[1]);

}

if((g_ui8TrfBuffer[0] == 0x02 | g_bBlockNumberBit) && (g_ui8TrfBuffer[1] == 0x90) && (g_ui8TrfBuffer[2] == 0x00))

{

ui8SelectSuccess = STATUS_SUCCESS;

}

}

g_bBlockNumberBit = !g_bBlockNumberBit; // Toggle the PCB Block Number

McuDelayMillisecond(1); // Short delay before sending next command

return ui8SelectSuccess;

}

u16_t NDEF_ReadBinary(u16_t ui16FileOffset, u08_t ui8ReadLength)

{

u08_t ui8Offset = 0;

u16_t ui16Nlen = 0;

g_ui8TrfBuffer[ui8Offset++] = 0x8F; // Reset FIFO

g_ui8TrfBuffer[ui8Offset++] = 0x91; // Send with CRC

g_ui8TrfBuffer[ui8Offset++] = 0x3D; // Write Continuous

g_ui8TrfBuffer[ui8Offset++] = 0x00; // Length of packet in bytes - upper and middle nibbles of transmit byte length

g_ui8TrfBuffer[ui8Offset++] = 0x60; // Length of packet in bytes - lower and broken nibbles of transmit byte length

g_ui8TrfBuffer[ui8Offset++] = 0x02 | g_bBlockNumberBit; // I-Block PCB: Read Block 0 or Block 1, with CID = 0, NAD = 0, no chaining

g_ui8TrfBuffer[ui8Offset++] = 0x00; // CLA

g_ui8TrfBuffer[ui8Offset++] = 0xB0; // INS = Read Binary

g_ui8TrfBuffer[ui8Offset++] = ((ui16FileOffset >> 8) & 0xFF); // File Offset where to start reading data

g_ui8TrfBuffer[ui8Offset++] = (ui16FileOffset & 0x00FF); // File Offset where to start reading data

g_ui8TrfBuffer[ui8Offset++] = ui8ReadLength; // Read Length

Trf797xRawWrite(&g_ui8TrfBuffer[0], ui8Offset); // Issue the NDEF Command

Trf797xIrqWaitTimeout(20,100); // 20 millisecond TX timeout, 100 millisecond RX timeout

g_bBlockNumberBit = !g_bBlockNumberBit; // Toggle the PCB Block Number

g_sTrfStatus = Trf797xGetTrfStatus();

if (g_ui8TrfBuffer[0] == 0xF2)

{

SBlock_WTXEcho(g_ui8TrfBuffer[0], g_ui8TrfBuffer[1]);

}

if(g_sTrfStatus == RX_COMPLETE)

{

ui16Nlen = (g_ui8TrfBuffer[1] << 8) + g_ui8TrfBuffer[2];

}

McuDelayMillisecond(1); // Short delay before sending next command

return ui16Nlen;

}

u08_t NDEF_FileSelect(u16_t ui16FileID)

{

u08_t ui8SelectSuccess = STATUS_FAIL;

u08_t ui8Offset = 0;

g_ui8TrfBuffer[ui8Offset++] = 0x8F; // Reset FIFO

g_ui8TrfBuffer[ui8Offset++] = 0x91; // Send with CRC

g_ui8TrfBuffer[ui8Offset++] = 0x3D; // Write Continuous

g_ui8TrfBuffer[ui8Offset++] = 0x00; // Length of packet in bytes - upper and middle nibbles of transmit byte length

g_ui8TrfBuffer[ui8Offset++] = 0x80; // Length of packet in bytes - lower and broken nibbles of transmit byte length

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

g_ui8TrfBuffer[ui8Offset++] = 0x00; // CLA

g_ui8TrfBuffer[ui8Offset++] = 0xA4; // INS = Select (File in this case)

g_ui8TrfBuffer[ui8Offset++] = 0x00;

g_ui8TrfBuffer[ui8Offset++] = 0x0C;

g_ui8TrfBuffer[ui8Offset++] = 0x02;

g_ui8TrfBuffer[ui8Offset++] = ((ui16FileID >> 8) & 0xFF);

g_ui8TrfBuffer[ui8Offset++] = (ui16FileID & 0x00FF);

Trf797xRawWrite(&g_ui8TrfBuffer[0], ui8Offset); // Issue the NDEF Command

Trf797xIrqWaitTimeout(15,50); // 15 millisecond TX timeout, 50 millisecond RX timeout

// If data received, should return same PCB, SW1 = 0x90, SW2 = 0x00

if (g_sTrfStatus == RX_COMPLETE)

{

if((g_ui8TrfBuffer[0] == 0x02 | g_bBlockNumberBit) && (g_ui8TrfBuffer[1] == 0x90) && (g_ui8TrfBuffer[2] == 0x00))

{

ui8SelectSuccess = STATUS_SUCCESS;

}

}

g_bBlockNumberBit = !g_bBlockNumberBit; // Toggle the PCB Block Number

McuDelayMillisecond(1); // Short delay before sending next command

return ui8SelectSuccess;

}

void NDEF_UpdateBinaryLength(u16_t ui16Nlen)

{

u08_t ui8Offset = 0;

g_ui8TrfBuffer[ui8Offset++] = 0x8F; // Reset FIFO

g_ui8TrfBuffer[ui8Offset++] = 0x91; // Send with CRC

g_ui8TrfBuffer[ui8Offset++] = 0x3D; // Write Continuous

g_ui8TrfBuffer[ui8Offset++] = 0x00; // Length of packet in bytes - upper and middle nibbles of transmit byte length

g_ui8TrfBuffer[ui8Offset++] = 0x80; // Length of packet in bytes - lower and broken nibbles of transmit byte length

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

g_ui8TrfBuffer[ui8Offset++] = 0x00; // CLA

g_ui8TrfBuffer[ui8Offset++] = 0xD6; // INS = Update Binary

g_ui8TrfBuffer[ui8Offset++] = 0x00; // Offset, P1

g_ui8TrfBuffer[ui8Offset++] = 0x00; // Offset, P2

g_ui8TrfBuffer[ui8Offset++] = 0x02; // Length, Lc

g_ui8TrfBuffer[ui8Offset++] = ((ui16Nlen >> 8) & 0xFF); // MSByte NLEN being set to 0

g_ui8TrfBuffer[ui8Offset++] = (ui16Nlen & 0xFF); // LSByte NLEN being set to 0

Trf797xRawWrite(&g_ui8TrfBuffer[0], ui8Offset); // Issue the NDEF Command

Trf797xIrqWaitTimeout(10,20); // 10 millisecond TX timeout, 20 millisecond RX timeout

g_bBlockNumberBit = !g_bBlockNumberBit; // Toggle the PCB Block Number

}

void Ndef_ReadCC(void)

{

NDEF_CapabilityContainerSelect(); // Selects the Capability Container

NDEF_ReadBinary(0, 15); // Read the contents of the capability container

}

void Ndef_ReadApplication(void)

{

u16_t ui16NdefLength = 0;

u08_t ui8NdefReadLength = 0;

#ifdef ENABLE_HOST

u08_t ui8NdefMessageOffset = 0;

u08_t ui8LoopCount = 0;

#endif

NDEF_FileSelect(0xE104); // Selects NDEF Application

ui16NdefLength = NDEF_ReadBinary(0, 2); // Reads NDEF Application for length of message

if (ui16NdefLength > NFC_FIFO_SIZE)

{

ui8NdefReadLength = NFC_FIFO_SIZE;

#ifdef ENABLE_HOST

UartSendCString("NDEF Message Size Exceeds Internal Buffer, Displaying Partial Message Contents Only.");

UartPutCrlf();

#endif

}

else

{

ui8NdefReadLength = ui16NdefLength;

}

NDEF_ReadBinary(2, ui8NdefReadLength); // Reads NDEF Application for the NDEF content

#ifdef ENABLE_HOST

UartSendCString("NDEF Message: ");

UartPutChar('[');

if (g_ui8TrfBuffer[4] == 0x54)

{

ui8NdefMessageOffset = 8;

}

else if (g_ui8TrfBuffer[4] == 0x55)

{

ui8NdefMessageOffset = 6;

if (g_ui8TrfBuffer[5] == 0x01)

{

UartSendCString("http://wwww.");

}

else if (g_ui8TrfBuffer[5] == 0x02)

{

UartSendCString("https://wwww.");

}

else if (g_ui8TrfBuffer[5] == 0x03)

{

UartSendCString("http://");

}

else if (g_ui8TrfBuffer[5] == 0x04)

{

UartSendCString("https://");

}

}

else

{

ui8NdefMessageOffset = 0x00;

}

if (ui16NdefLength > (NFC_FIFO_SIZE-ui8NdefMessageOffset))

{

ui8NdefReadLength = NFC_FIFO_SIZE-ui8NdefMessageOffset;

}

else

{

ui8NdefReadLength = ui16NdefLength-ui8NdefMessageOffset+1;

}

for (ui8LoopCount = 0; ui8LoopCount < ui8NdefReadLength; ui8LoopCount++)

{

UartPutChar(g_ui8TrfBuffer[ui8NdefMessageOffset++]);

}

UartPutChar(']');

UartPutCrlf();

UartPutCrlf();

#endif

}

void Ndef_WriteText(void)

{

#ifdef ENABLE_HOST

UartSendCString("Now Writing New NDEF Message.");

UartPutCrlf();

UartPutCrlf();

#endif

NDEF_UpdateBinaryText();

}

void Ndef_WriteUri(void)

{

#ifdef ENABLE_HOST

UartSendCString("Now Writing New NDEF Message.");

UartPutCrlf();

UartPutCrlf();

#endif

NDEF_UpdateBinaryUri();

}

void Ndef_SetBlockNumberBit(bool bValue)

{

g_bBlockNumberBit = bValue;

}

void NDEF_UpdateBinaryText(void)

{

u08_t ui8Offset = 0;

g_ui8TrfBuffer[ui8Offset++] = 0x8F; // Reset FIFO

g_ui8TrfBuffer[ui8Offset++] = 0x91; // Send with CRC

g_ui8TrfBuffer[ui8Offset++] = 0x3D; // Write Continuous

g_ui8TrfBuffer[ui8Offset++] = 0x01; // Length of packet in bytes - upper and middle nibbles of transmit byte length

g_ui8TrfBuffer[ui8Offset++] = 0xF0; // Length of packet in bytes - lower and broken nibbles of transmit byte length

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

g_ui8TrfBuffer[ui8Offset++] = 0x00; // CLA

g_ui8TrfBuffer[ui8Offset++] = 0xD6; // INS = update Binary

g_ui8TrfBuffer[ui8Offset++] = 0x00; // Offset, P1

g_ui8TrfBuffer[ui8Offset++] = 0x02; // Offset, P2

g_ui8TrfBuffer[ui8Offset++] = 0x19; // Lc, length being written (all bytes)

g_ui8TrfBuffer[ui8Offset++] = 0xD1; // MB = 1, ME = 1, Short Record, TNF = NFC Forum Well Known Type

g_ui8TrfBuffer[ui8Offset++] = 0x01; // Length of Record Type

g_ui8TrfBuffer[ui8Offset++] = 0x15; // Length of Text being written (21 bytes, hardcoded for now)

g_ui8TrfBuffer[ui8Offset++] = 0x54; // Text

g_ui8TrfBuffer[ui8Offset++] = 0x02; // Language Length

g_ui8TrfBuffer[ui8Offset++] = 0x65; // 'e' - For English

g_ui8TrfBuffer[ui8Offset++] = 0x6E; // 'n' - For English

g_ui8TrfBuffer[ui8Offset++] = 0x4E; // N

g_ui8TrfBuffer[ui8Offset++] = 0x46; // F

g_ui8TrfBuffer[ui8Offset++] = 0x43; // C

g_ui8TrfBuffer[ui8Offset++] = 0x20; //

g_ui8TrfBuffer[ui8Offset++] = 0x50; // P

g_ui8TrfBuffer[ui8Offset++] = 0x6F; // o

g_ui8TrfBuffer[ui8Offset++] = 0x77; // w

g_ui8TrfBuffer[ui8Offset++] = 0x65; // e

g_ui8TrfBuffer[ui8Offset++] = 0x72; // r

g_ui8TrfBuffer[ui8Offset++] = 0x65; // e

g_ui8TrfBuffer[ui8Offset++] = 0x64; // d

g_ui8TrfBuffer[ui8Offset++] = 0x20; //

g_ui8TrfBuffer[ui8Offset++] = 0x42; // B

g_ui8TrfBuffer[ui8Offset++] = 0x79; // y

g_ui8TrfBuffer[ui8Offset++] = 0x20; //

g_ui8TrfBuffer[ui8Offset++] = 0x54; // T

g_ui8TrfBuffer[ui8Offset++] = 0x49; // I

g_ui8TrfBuffer[ui8Offset++] = 0x21; // !

Trf797xRawWrite(&g_ui8TrfBuffer[0], ui8Offset); // Issue the NDEF Command

Trf797xIrqWaitTimeout(10,20); // 10 millisecond TX timeout, 20 millisecond RX timeout

g_bBlockNumberBit = !g_bBlockNumberBit; // Toggle the PCB Block Number

McuDelayMillisecond(5);

NDEF_UpdateBinaryLength(0x19);

}

void NDEF_UpdateBinaryUri(void)

{

u08_t ui8Offset = 0;

g_ui8TrfBuffer[ui8Offset++] = 0x8F; // Reset FIFO

g_ui8TrfBuffer[ui8Offset++] = 0x91; // Send with CRC

g_ui8TrfBuffer[ui8Offset++] = 0x3D; // Write Continuous

g_ui8TrfBuffer[ui8Offset++] = 0x01; // Length of packet in bytes - upper and middle nibbles of transmit byte length

g_ui8TrfBuffer[ui8Offset++] = 0x50; // Length of packet in bytes - lower and broken nibbles of transmit byte length

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

g_ui8TrfBuffer[ui8Offset++] = 0x00; // CLA

g_ui8TrfBuffer[ui8Offset++] = 0xD6; // INS = update Binary

g_ui8TrfBuffer[ui8Offset++] = 0x00; // Offset, P1

g_ui8TrfBuffer[ui8Offset++] = 0x02; // Offset, P2

g_ui8TrfBuffer[ui8Offset++] = 0x0F; // Lc, length being written (all bytes)

g_ui8TrfBuffer[ui8Offset++] = 0xD1; // MB = 1, ME = 1, Short Record, TNF = NFC Forum Well Known Type

g_ui8TrfBuffer[ui8Offset++] = 0x01; // Length of Record Type

g_ui8TrfBuffer[ui8Offset++] = 0x0B; // Length of URI being written (11 bytes, hardcoded for now)

g_ui8TrfBuffer[ui8Offset++] = 0x55; // URI

g_ui8TrfBuffer[ui8Offset++] = 0x01; // URI Identifier: http://wwww.

g_ui8TrfBuffer[ui8Offset++] = 0x74; // t

g_ui8TrfBuffer[ui8Offset++] = 0x69; // i

g_ui8TrfBuffer[ui8Offset++] = 0x2E; // .

g_ui8TrfBuffer[ui8Offset++] = 0x63; // c

g_ui8TrfBuffer[ui8Offset++] = 0x6F; // o

g_ui8TrfBuffer[ui8Offset++] = 0x6D; // m

g_ui8TrfBuffer[ui8Offset++] = 0x2F; // /

g_ui8TrfBuffer[ui8Offset++] = 0x6E; // n

g_ui8TrfBuffer[ui8Offset++] = 0x66; // f

g_ui8TrfBuffer[ui8Offset++] = 0x63; // c

Trf797xRawWrite(&g_ui8TrfBuffer[0], ui8Offset); // Issue the NDEF Command

Trf797xIrqWaitTimeout(10,20); // 10 millisecond TX timeout, 20 millisecond RX timeout

g_bBlockNumberBit = !g_bBlockNumberBit; // Toggle the PCB Block Number

McuDelayMillisecond(5);

NDEF_UpdateBinaryLength(0x0F);

}

types.h

/*

* {types.h}

*

* {Header File}

*

* Copyright (C) 2013 Texas Instruments Incorporated - http://www.ti.com/

*

*

* Redistribution and use in source and binary forms, with or without

* modification, are permitted provided that the following conditions

* are met:

*

* Redistributions of source code must retain the above copyright

* notice, this list of conditions and the following disclaimer.

*

* Redistributions in binary form must reproduce the above copyright

* notice, this list of conditions and the following disclaimer in the

* documentation and/or other materials provided with the

* distribution.

*

* Neither the name of Texas Instruments Incorporated nor the names of

* its contributors may be used to endorse or promote products derived

* from this software without specific prior written permission.

*

* THIS SOFTWARE IS PROVIDED BY THE COPYRIGHT HOLDERS AND CONTRIBUTORS

* "AS IS" AND ANY EXPRESS OR IMPLIED WARRANTIES, INCLUDING, BUT NOT

* LIMITED TO, THE IMPLIED WARRANTIES OF MERCHANTABILITY AND FITNESS FOR

* A PARTICULAR PURPOSE ARE DISCLAIMED. IN NO EVENT SHALL THE COPYRIGHT

* OWNER OR CONTRIBUTORS BE LIABLE FOR ANY DIRECT, INDIRECT, INCIDENTAL,

* SPECIAL, EXEMPLARY, OR CONSEQUENTIAL DAMAGES (INCLUDING, BUT NOT

* LIMITED TO, PROCUREMENT OF SUBSTITUTE GOODS OR SERVICES; LOSS OF USE,

* DATA, OR PROFITS; OR BUSINESS INTERRUPTION) HOWEVER CAUSED AND ON ANY

* THEORY OF LIABILITY, WHETHER IN CONTRACT, STRICT LIABILITY, OR TORT

* (INCLUDING NEGLIGENCE OR OTHERWISE) ARISING IN ANY WAY OUT OF THE USE

* OF THIS SOFTWARE, EVEN IF ADVISED OF THE POSSIBILITY OF SUCH DAMAGE.

*

*/

#ifndef _TYPEDEF_H_

#define _TYPEDEF_H_

/************************************************************

* STANDARD BITS

************************************************************/

#define BIT0 (0x0001)

#define BIT1 (0x0002)

#define BIT2 (0x0004)

#define BIT3 (0x0008)

#define BIT4 (0x0010)

#define BIT5 (0x0020)

#define BIT6 (0x0040)

#define BIT7 (0x0080)

#define BIT8 (0x0100)

#define BIT9 (0x0200)

#define BITA (0x0400)

#define BITB (0x0800)

#define BITC (0x1000)

#define BITD (0x2000)

#define BITE (0x4000)

#define BITF (0x8000)

#define false 0

#define true 1

//#define bool _Bool

typedef unsigned char bool;

//================================================================

typedef unsigned char u08_t;

typedef unsigned short u16_t;

typedef unsigned long u32_t;

typedef signed char s08_t;

typedef signed short s16_t;

typedef signed long s32_t;

#ifndef STATUS_FAIL

#define STATUS_FAIL 0x00

#endif

#ifndef STATUS_SUCCESS

#define STATUS_SUCCESS 0x01

#endif

//===============================================================

#endif

cc3200v1p32.cmd

--retain=g_pfnVectors

//*****************************************************************************

// The following command line options are set as part of the CCS project.

// If you are building using the command line, or for some reason want to

// define them here, you can uncomment and modify these lines as needed.

// If you are using CCS for building, it is probably better to make any such

// modifications in your CCS project and leave this file alone.

//*****************************************************************************

//*****************************************************************************

// The starting address of the application. Normally the interrupt vectors

// must be located at the beginning of the application.

//*****************************************************************************

#define RAM_BASE 0x20004000

/* System memory map */

MEMORY

{

/* Application uses internal RAM for program and data */

SRAM_CODE (RWX) : origin = 0x20004000, length = 0x1C000

SRAM_DATA (RWX) : origin = 0x20030000, length = 0x10000

}

/* Section allocation in memory */

SECTIONS

{

.intvecs: > RAM_BASE

.init_array : > SRAM_CODE

.vtable : > SRAM_CODE

.text : > SRAM_CODE

.const : > SRAM_CODE

.cinit : > SRAM_CODE

.pinit : > SRAM_CODE

.data : > SRAM_DATA

.bss : > SRAM_DATA

.sysmem : > SRAM_DATA

.stack : > SRAM_DATA(HIGH)

}
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
