l46kok/smart-doorlock/Documents/Smart Doorlock Lab Notebook.docx

Smart Doorlock Laboratory Notebook

Primary Author: Sokwhan Huh

This space is intentionally left blank

# August 31st, 2016

Project Requirements

The core project requirements are as follows:

- Demonstrate NFC P2P capability
  - Be able to open the door lock with NFC using a smartphone app under P2P mode. The phone must be registered in advance to open the door lock.
- Demonstrate IoT capability
  - Be able to open or permanently lock (lockdown mode) the door lock over the internet using a smartphone app or by accessing Smart Doorlock’s web server with a browser. The phone must be registered in advance to open the door lock.
- Demonstrate enhanced security system
  - Be able to register phones for access.
  - Be able to clear existing registered phones.

Additional requirements are as follows:

- Implement full logging system for entries.
- Have the door lock function with a battery backup in case of power outage.

Technical Specifications

- Interfacing via NFC in P2P mode using Android Beam technology
- Interfacing via IoT to a cloud server over MQTT Protocol
- NFC communication range: 5 cm maximum (from smartphone to Smart Doorlock)
- Wi-Fi communication range: 50 meters maximum (TX 14.5dBM, RX -74.0dBM at 54 OFDM)
- Microcontroller: Texas Instruments CC3200
- NFC Transceiver IC: Texas Instruments TRF7970A
- AC power with DC battery backup
- Minimum backup battery life of 24 hours
- Keypad: Storm Interface’s Storm 720GFXI Series (7207-121W20)
- LCD: Electronic Assembly’s EA DIP203G-4NLED LCD
- Programming Language: C (Microcontroller), Java (Android Application), C# (Web Server)
- Supported Android versions: 4.0 (Ice Cream Sandwich) and above
- Web Server Framework: ASP.NET MVC 5
- Web Server Database: MySQL

Source Control (Mercurial): https://bitbucket.org/l46kok/smart-doorlock

Source code of the project, along with design documents and detailed diagrams can be found under the source control link (inside document folder).

Started a new project and pushed a new source base into repository. To test that CC3200’s basic functionality works as intended, the following simple program was made, which is to be served as the skeleton of the entire project. The following code currently only does two things: initialize the microcontroller and send ASCII strings via UART TX.

main.c

/*

* Smart Doorlock

* main.c

*

* June 15th, 2016

*

* Author: Sokwhan Huh

*/

// Driverlib includes

#include "rom.h"

#include "rom_map.h"

#include "hw_memmap.h"

#include "hw_common_reg.h"

#include "hw_types.h"

#include "hw_ints.h"

#include "uart.h"

#include "interrupt.h"

#include "pinmux.h"

#include "utils.h"

#include "prcm.h"

// Common interface include

#include "uart_if.h"

#define APPLICATION_VERSION "1.1.1"

#define APP_NAME "Smart Doorlock"

#define CONSOLE UARTA0_BASE

#define UartGetChar() MAP_UARTCharGet(CONSOLE)

#define UartPutChar(c) MAP_UARTCharPut(CONSOLE,c)

#define MAX_STRING_LENGTH 80

static void DisplayBanner(char * AppName)

{

Report("\n\n\n\r");

Report("\t\t *************************************************\n\r");

Report("\t\t \n\r", AppName);

Report("\t\t *************************************************\n\r");

Report("\n\n\n\r");

}

static void BoardInit(void)

{

/* In case of TI-RTOS vector table is initialize by OS itself */

#ifndef USE_TIRTOS

//

// Set vector table base

//

#if defined(ccs)

MAP_IntVTableBaseSet((unsigned long)&g_pfnVectors[0]);

#endif

#if defined(ewarm)

MAP_IntVTableBaseSet((unsigned long)&__vector_table);

#endif

#endif

//

// Enable Processor

//

MAP_IntMasterEnable();

MAP_IntEnable(FAULT_SYSTICK);

PRCMCC3200MCUInit();

}

int main(void) {

//

// Initailizing the board

//

BoardInit();

//

// Muxing for Enabling UART_TX and UART_RX.

//

PinMuxConfig();

//

// Initialising the Terminal.

//

InitTerm();

//

// Clearing the Terminal.

//

ClearTerm();

DisplayBanner(APP_NAME);

return 0;

}

uart_if.c

/*

* Smart Doorlock

*

* uart_if.c

*

* Created on: 2016. 8. 27.

* Author: Sokwhan

*/

// Standard includes

#include <stdarg.h>

#include <stdlib.h>

#include <stdio.h>

#include <string.h>

// Driverlib includes

#include "hw_types.h"

#include "hw_memmap.h"

#include "prcm.h"

#include "pin.h"

#include "uart.h"

#include "rom.h"

#include "rom_map.h"

#if defined(USE_FREERTOS) || defined(USE_TI_RTOS)

#include "osi.h"

#endif

#include "uart_if.h"

#define IS_SPACE(x) (x == 32 ? 1 : 0)

//*****************************************************************************

// Global variable indicating command is present

//*****************************************************************************

static unsigned long __Errorlog;

//*****************************************************************************

// Global variable indicating input length

//*****************************************************************************

unsigned int ilen=1;

//*****************************************************************************

//

//! Initialization

//!

//! This function

//! 1. Configures the UART to be used.

//!

//! \return none

//

//*****************************************************************************

void

InitTerm()

{

#ifndef NOTERM

MAP_UARTConfigSetExpClk(CONSOLE,MAP_PRCMPeripheralClockGet(CONSOLE_PERIPH),

UART_BAUD_RATE, (UART_CONFIG_WLEN_8 | UART_CONFIG_STOP_ONE |

UART_CONFIG_PAR_NONE));

#endif

__Errorlog = 0;

}

//*****************************************************************************

//

//! Outputs a character string to the console

//!

//! \param str is the pointer to the string to be printed

//!

//! This function

//! 1. prints the input string character by character on to the console.

//!

//! \return none

//

//*****************************************************************************

void

Message(const char *str)

{

#ifndef NOTERM

if(str != NULL)

{

while(*str!='\0')

{

MAP_UARTCharPut(CONSOLE,*str++);

}

}

#endif

}

//*****************************************************************************

//

//! Clear the console window

//!

//! This function

//! 1. clears the console window.

//!

//! \return none

//

//*****************************************************************************

void

ClearTerm()

{

Message("\33[2J\r");

}

//*****************************************************************************

//

//! Error Function

//!

//! \param

//!

//! \return none

//!

//*****************************************************************************

void

Error(char *pcFormat, ...)

{

#ifndef NOTERM

char cBuf[256];

va_list list;

va_start(list,pcFormat);

vsnprintf(cBuf,256,pcFormat,list);

Message(cBuf);

#endif

__Errorlog++;

}

//*****************************************************************************

//

//! Get the Command string from UART

//!

//! \param pucBuffer is the command store to which command will be populated

//! \param ucBufLen is the length of buffer store available

//!

//! \return Length of the bytes received. -1 if buffer length exceeded.

//!

//*****************************************************************************

int

GetCmd(char *pcBuffer, unsigned int uiBufLen)

{

char cChar;

int iLen = 0;

//

// Wait to receive a character over UART

//

while(MAP_UARTCharsAvail(CONSOLE) == false)

{

#if defined(USE_FREERTOS) || defined(USE_TI_RTOS)

osi_Sleep(1);

#endif

}

cChar = MAP_UARTCharGetNonBlocking(CONSOLE);

//

// Echo the received character

//

MAP_UARTCharPut(CONSOLE, cChar);

iLen = 0;

//

// Checking the end of Command

//

while((cChar != '\r') && (cChar !='\n') )

{

//

// Handling overflow of buffer

//

if(iLen >= uiBufLen)

{

return -1;

}

//

// Copying Data from UART into a buffer

//

if(cChar != '\b')

{

*(pcBuffer + iLen) = cChar;

iLen++;

}

else

{

//

// Deleting last character when you hit backspace

//

if(iLen)

{

iLen--;

}

}

//

// Wait to receive a character over UART

//

while(MAP_UARTCharsAvail(CONSOLE) == false)

{

#if defined(USE_FREERTOS) || defined(USE_TI_RTOS)

osi_Sleep(1);

#endif

}

cChar = MAP_UARTCharGetNonBlocking(CONSOLE);

//

// Echo the received character

//

MAP_UARTCharPut(CONSOLE, cChar);

}

*(pcBuffer + iLen) = '\0';

Report("\n\r");

return iLen;

}

//*****************************************************************************

//

//! Trim the spaces from left and right end of given string

//!

//! \param Input string on which trimming happens

//!

//! \return length of trimmed string

//

//*****************************************************************************

int TrimSpace(char * pcInput)

{

size_t size;

char *endStr, *strData = pcInput;

char index = 0;

size = strlen(strData);

if (!size)

return 0;

endStr = strData + size - 1;

while (endStr >= strData && IS_SPACE(*endStr))

endStr--;

*(endStr + 1) = '\0';

while (*strData && IS_SPACE(*strData))

{

strData++;

index++;

}

memmove(pcInput,strData,strlen(strData)+1);

return strlen(pcInput);

}

//*****************************************************************************

//

//! prints the formatted string on to the console

//!

//! \param format is a pointer to the character string specifying the format in

//! the following arguments need to be interpreted.

//! \param [variable number of] arguments according to the format in the first

//! parameters

//! This function

//! 1. prints the formatted error statement.

//!

//! \return count of characters printed

//

//*****************************************************************************

int Report(const char *pcFormat, ...)

{

int iRet = 0;

#ifndef NOTERM

char *pcBuff, *pcTemp;

int iSize = 256;

va_list list;

pcBuff = (char*)malloc(iSize);

if(pcBuff == NULL)

{

return -1;

}

while(1)

{

va_start(list,pcFormat);

iRet = vsnprintf(pcBuff,iSize,pcFormat,list);

va_end(list);

if(iRet > -1 && iRet < iSize)

{

break;

}

else

{

iSize*=2;

if((pcTemp=realloc(pcBuff,iSize))==NULL)

{

Message("Could not reallocate memory\n\r");

iRet = -1;

break;

}

else

{

pcBuff=pcTemp;

}

}

}

Message(pcBuff);

free(pcBuff);

#endif

return iRet;

}

uart_if.c

/*

* Smart Doorlock

*

* uart_if.c

*

* Created on: 2016. 8. 27.

* Author: Sokwhan

*/

// Standard includes

#include <stdarg.h>

#include <stdlib.h>

#include <stdio.h>

#include <string.h>

// Driverlib includes

#include "hw_types.h"

#include "hw_memmap.h"

#include "prcm.h"

#include "pin.h"

#include "uart.h"

#include "rom.h"

#include "rom_map.h"

#if defined(USE_FREERTOS) || defined(USE_TI_RTOS)

#include "osi.h"

#endif

#include "uart_if.h"

#define IS_SPACE(x) (x == 32 ? 1 : 0)

//*****************************************************************************

// Global variable indicating command is present

//*****************************************************************************

static unsigned long __Errorlog;

//*****************************************************************************

// Global variable indicating input length

//*****************************************************************************

unsigned int ilen=1;

//*****************************************************************************

//

//! Initialization

//!

//! This function

//! 1. Configures the UART to be used.

//!

//! \return none

//

//*****************************************************************************

void

InitTerm()

{

#ifndef NOTERM

MAP_UARTConfigSetExpClk(CONSOLE,MAP_PRCMPeripheralClockGet(CONSOLE_PERIPH),

UART_BAUD_RATE, (UART_CONFIG_WLEN_8 | UART_CONFIG_STOP_ONE |

UART_CONFIG_PAR_NONE));

#endif

__Errorlog = 0;

}

//*****************************************************************************

//

//! Outputs a character string to the console

//!

//! \param str is the pointer to the string to be printed

//!

//! This function

//! 1. prints the input string character by character on to the console.

//!

//! \return none

//

//*****************************************************************************

void

Message(const char *str)

{

#ifndef NOTERM

if(str != NULL)

{

while(*str!='\0')

{

MAP_UARTCharPut(CONSOLE,*str++);

}

}

#endif

}

//*****************************************************************************

//

//! Clear the console window

//!

//! This function

//! 1. clears the console window.

//!

//! \return none

//

//*****************************************************************************

void

ClearTerm()

{

Message("\33[2J\r");

}

//*****************************************************************************

//

//! Error Function

//!

//! \param

//!

//! \return none

//!

//*****************************************************************************

void

Error(char *pcFormat, ...)

{

#ifndef NOTERM

char cBuf[256];

va_list list;

va_start(list,pcFormat);

vsnprintf(cBuf,256,pcFormat,list);

Message(cBuf);

#endif

__Errorlog++;

}

//*****************************************************************************

//

//! Get the Command string from UART

//!

//! \param pucBuffer is the command store to which command will be populated

//! \param ucBufLen is the length of buffer store available

//!

//! \return Length of the bytes received. -1 if buffer length exceeded.

//!

//*****************************************************************************

int

GetCmd(char *pcBuffer, unsigned int uiBufLen)

{

char cChar;

int iLen = 0;

//

// Wait to receive a character over UART

//

while(MAP_UARTCharsAvail(CONSOLE) == false)

{

#if defined(USE_FREERTOS) || defined(USE_TI_RTOS)

osi_Sleep(1);

#endif

}

cChar = MAP_UARTCharGetNonBlocking(CONSOLE);

//

// Echo the received character

//

MAP_UARTCharPut(CONSOLE, cChar);

iLen = 0;

//

// Checking the end of Command

//

while((cChar != '\r') && (cChar !='\n') )

{

//

// Handling overflow of buffer

//

if(iLen >= uiBufLen)

{

return -1;

}

//

// Copying Data from UART into a buffer

//

if(cChar != '\b')

{

*(pcBuffer + iLen) = cChar;

iLen++;

}

else

{

//

// Deleting last character when you hit backspace

//

if(iLen)

{

iLen--;

}

}

//

// Wait to receive a character over UART

//

while(MAP_UARTCharsAvail(CONSOLE) == false)

{

#if defined(USE_FREERTOS) || defined(USE_TI_RTOS)

osi_Sleep(1);

#endif

}

cChar = MAP_UARTCharGetNonBlocking(CONSOLE);

//

// Echo the received character

//

MAP_UARTCharPut(CONSOLE, cChar);

}

*(pcBuffer + iLen) = '\0';

Report("\n\r");

return iLen;

}

//*****************************************************************************

//

//! Trim the spaces from left and right end of given string

//!

//! \param Input string on which trimming happens

//!

//! \return length of trimmed string

//

//*****************************************************************************

int TrimSpace(char * pcInput)

{

size_t size;

char *endStr, *strData = pcInput;

char index = 0;

size = strlen(strData);

if (!size)

return 0;

endStr = strData + size - 1;

while (endStr >= strData && IS_SPACE(*endStr))

endStr--;

*(endStr + 1) = '\0';

while (*strData && IS_SPACE(*strData))

{

strData++;

index++;

}

memmove(pcInput,strData,strlen(strData)+1);

return strlen(pcInput);

}

//*****************************************************************************

//

//! prints the formatted string on to the console

//!

//! \param format is a pointer to the character string specifying the format in

//! the following arguments need to be interpreted.

//! \param [variable number of] arguments according to the format in the first

//! parameters

//! This function

//! 1. prints the formatted error statement.

//!

//! \return count of characters printed

//

//*****************************************************************************

int Report(const char *pcFormat, ...)

{

int iRet = 0;

#ifndef NOTERM

char *pcBuff, *pcTemp;

int iSize = 256;

va_list list;

pcBuff = (char*)malloc(iSize);

if(pcBuff == NULL)

{

return -1;

}

while(1)

{

va_start(list,pcFormat);

iRet = vsnprintf(pcBuff,iSize,pcFormat,list);

va_end(list);

if(iRet > -1 && iRet < iSize)

{

break;

}

else

{

iSize*=2;

if((pcTemp=realloc(pcBuff,iSize))==NULL)

{

Message("Could not reallocate memory\n\r");

iRet = -1;

break;

}

else

{

pcBuff=pcTemp;

}

}

}

Message(pcBuff);

free(pcBuff);

#endif

return iRet;

}

uart_if.h

/*

* Smart Doorlock

*

* uart_if.h

*

* Created on: 2016. 8. 27.

* Author: Sokwhan

*/

#ifndef __uart_if_H__

#define __uart_if_H__

//*****************************************************************************

//

// If building with a C++ compiler, make all of the definitions in this header

// have a C binding.

//

//*****************************************************************************

#ifdef __cplusplus

extern "C"

{

#endif

/****************************************************************************/

/* MACROS */

/****************************************************************************/

#define UART_BAUD_RATE 115200

#define SYSCLK 80000000

#define CONSOLE UARTA0_BASE

#define CONSOLE_PERIPH PRCM_UARTA0

//

// Define the size of UART IF buffer for RX

//

#define UART_IF_BUFFER 64

//

// Define the UART IF buffer

//

extern unsigned char g_ucUARTBuffer[];

/****************************************************************************/

/* FUNCTION PROTOTYPES */

/****************************************************************************/

extern void DispatcherUARTConfigure(void);

extern void DispatcherUartSendPacket(unsigned char *inBuff, unsigned short usLength);

extern int GetCmd(char *pcBuffer, unsigned int uiBufLen);

extern void InitTerm(void);

extern void ClearTerm(void);

extern void Message(char *format);

extern void Error(char *format,...);

extern int Report(char *format, ...);

void UartPutChar(unsigned char ch);

void UartPutCrlf(void);

extern void UartSendCString(char *format);

void UartPutByte(unsigned char ch);

void UartPutByteHex(unsigned char ch);

//*****************************************************************************

//

// Mark the end of the C bindings section for C++ compilers.

//

//*****************************************************************************

#ifdef __cplusplus

}

#endif

#endif

pinmux.c

/*

* Smart Doorlock

*

* pinmux.c

*

* Created on: 2016. 8. 27.

* Author: Sokwhan

*/

#include "pinmux.h"

#include "hw_types.h"

#include "hw_memmap.h"

#include "hw_gpio.h"

#include "pin.h"

#include "rom.h"

#include "rom_map.h"

#include "gpio.h"

#include "prcm.h"

//*****************************************************************************

void

PinMuxConfig(void)

{

//

// Enable Peripheral Clocks

//

MAP_PRCMPeripheralClkEnable(PRCM_UARTA0, PRCM_RUN_MODE_CLK);

//

// Configure PIN_55 for UART0 UART0_TX

//

MAP_PinTypeUART(PIN_55, PIN_MODE_3);

//

// Configure PIN_57 for UART0 UART0_RX

//

MAP_PinTypeUART(PIN_57, PIN_MODE_3);

}

pinmux.h

/*

* Smart Doorlock

*

* pinmux.h

*

* Created on: 2016. 8. 27.

* Author: Sokwhan

*/

#ifndef PINMUX_H_

#define PINMUX_H_

extern void PinMuxConfig(void);

#endif /* PINMUX_H_ */

# September 1st, 2016

Further research was performed on NFC communication via tag on TRF7970A. The demo NFCReaderApp from TI would not work for some reason, potentially due to version difference in TRF7970A. Online findings indicated that they’ve changed the pin configurations on the board and the code would have to match the newly set pins. After changing the pin configurations, still no luck so I made a post on TI forums and see if anyone else has an idea. A TI employee answered the post, looked over my code modifications and saw no issues with it. He advised that I solder the jumper pin on IRQ to revert the pin settings back to old version. Will have to try this in lab later. The actual forum link is the following: http://e2e.ti.com/support/wireless_connectivity/nfc_rfid/f/667/p/518595/1905610#1905610

Another option is to just jump directly to NFC P2P, but I’m a bit skeptical on whether this approach is sound or not as NFC P2P tends to be a lot more complicated than simple tag read. If I can’t get the NFC tag to work, then I guess this is the alternative route I have to take.

If only I could get my hands on the TRF7970A breakout board, life would be so much easier but they are way too expensive…

# September 4th, 2016

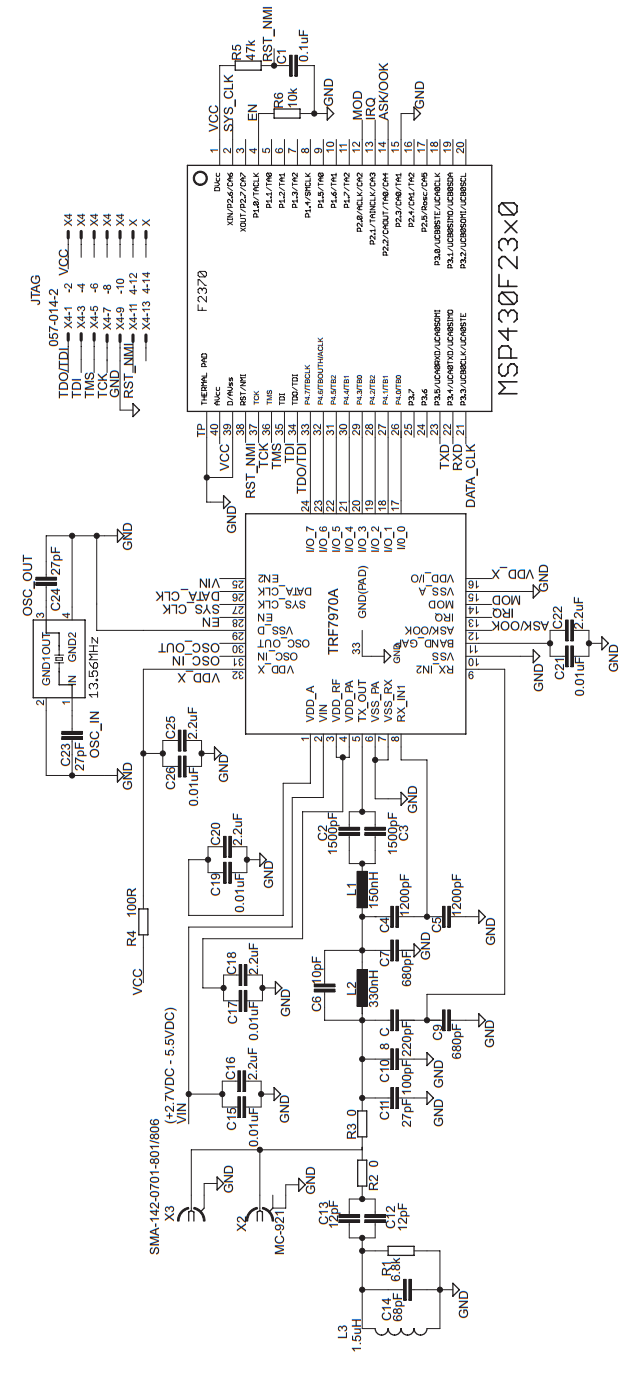
[picture p27: figure]

There are couple of things I missed in the initial schematic of this project. Below is a sample schematic of TRF7970A from documentation:

2

1

First, TRF7970A requires a separate crystal oscillator clocked at 13.56MHz. The development board comes with one, so I mistakenly assumed that the actual chip has an internal clock integrated with it [1]. The second, and probably the bigger problem is that I need to build an entire RF circuitry for the NFC communication to work [2]. I have no prior background in RF so this will pose a huge challenge for me, but it must be catered for before the PCB design. I’m pretty sure CC3200 would require a separate RF circuitry design for Wi-Fi communication but this has not been verified yet. The example seems to be using 50-ohm female-type antenna (with the actual “pole?” thing to be plugged in later), if I am not mistaken, but I will have to find a different schematic as I’ll be using a flat card-like antenna found in most NFC devices.

There are no DIP modules for TRF7970A either so I basically have zero way of testing the RF stuff. I will also have to find out a way of testing this RF circuitry before printing the PCB (if possible).

# September 7th, 2016

RTOS functionality has been included to the project. CC3200 will now spawn a separate thread for executing the main logic of the application. GPIO code was also added for blinking LEDs and handling interrupts in the future.

main.c

/*

* Smart Doorlock

* main.c

*

* Created on: 2016. 8. 27.

*

* Author: Sokwhan Huh

*/

// C-Library includes

#include <string.h>

// Driverlib includes

#include "rom.h"

#include "rom_map.h"

#include "hw_memmap.h"

#include "hw_common_reg.h"

#include "hw_types.h"

#include "hw_ints.h"

#include "uart.h"

#include "interrupt.h"

#include "pinmux.h"

#include "utils.h"

#include "prcm.h"

#include "simplelink.h"

// Common interface include

#include "uart_if.h"

#include "gpio_if.h"

#define APP_NAME "Smart Doorlock"

//RTOS Related Defines

#define OSI_STACK_SIZE 4096 /* 2048 */

#define SPAWN_TASK_PRIORITY 9

static void DisplayBanner(char * AppName)

{

Report("\n\n\n\r");

Report("\t\t *************************************************\n\r");

Report("\t\t %s \n\r", AppName);

Report("\t\t *************************************************\n\r");

Report("\n\n\n\r");

}

static void BoardInit(void)

{

// Enable Processor

MAP_IntMasterEnable();

MAP_IntEnable(FAULT_SYSTICK);

PRCMCC3200MCUInit();

}

/**

*

*/

void SmartDoorlockApp(void *pvParameters) {

GPIO_IF_LedConfigure(LED1|LED2|LED3);

for (;;) {

GPIO_IF_LedOn(MCU_RED_LED_GPIO);

osi_Sleep(500);

GPIO_IF_LedOff(MCU_RED_LED_GPIO);

osi_Sleep(500);

}

}

int main(void) {

// Initailizing the board

BoardInit();

// Muxing for Enabling GPIO, UART_TX and UART_RX.

PinMuxConfig();

// Init Terminal

InitTerm();

ClearTerm();

DisplayBanner(APP_NAME);

//Start the simplelink host

VStartSimpleLinkSpawnTask(SPAWN_TASK_PRIORITY);

// Start the SmartDoorlock task

osi_TaskCreate( SmartDoorlockApp,

(const signed char*)"Smart Doorlock App",

OSI_STACK_SIZE, NULL, 1, NULL );

osi_start();

return 0;

}

gpio_if.c

/*

* gpio_if.c

*

* Created on: 2016. 9. 7.

* Author: Sokwhan

*/

#include <stdio.h>

#include "hw_types.h"

#include "hw_ints.h"

#include "hw_memmap.h"

#include "interrupt.h"

#include "pin.h"

#include "gpio.h"

#include "hw_apps_rcm.h"

#include "prcm.h"

#include "rom.h"

#include "rom_map.h"

#include "gpio_if.h"

//****************************************************************************

// GLOBAL VARIABLES

//****************************************************************************

static unsigned long ulReg[]=

{

GPIOA0_BASE,

GPIOA1_BASE,

GPIOA2_BASE,

GPIOA3_BASE

};

//*****************************************************************************

// Variables to store TIMER Port,Pin values

//*****************************************************************************

unsigned int g_uiLED1Port = 0,g_uiLED2Port = 0,g_uiLED3Port = 0;

unsigned char g_ucLED1Pin, g_ucLED2Pin, g_ucLED3Pin;

extern unsigned char g_heart_beat, g_state;

#define PIN_LED1 9

#define PIN_LED2 10

#define PIN_LED3 11

//****************************************************************************

// LOCAL FUNCTION DEFINITIONS

//****************************************************************************

//*****************************************************************************

//

//! GPIO Enable & Configuration

//!

//! \param ucPins is the bit-pack representation of 3 LEDs

//! LSB:GP09-GP10-GP11:MSB

//!

//! \return None

//

//*****************************************************************************

void

GPIO_IF_LedConfigure(unsigned char ucPins)

{

if(ucPins & LED1)

{

GPIO_IF_GetPortNPin(PIN_LED1,

&g_uiLED1Port,

&g_ucLED1Pin);

}

if(ucPins & LED2)

{

GPIO_IF_GetPortNPin(PIN_LED2,

&g_uiLED2Port,

&g_ucLED2Pin);

}

if(ucPins & LED3)

{

GPIO_IF_GetPortNPin(PIN_LED3,

&g_uiLED3Port,

&g_ucLED3Pin);

}

}

//*****************************************************************************

//

//! Turn LED On

//!

//! \param ledNum is the LED Number

//!

//! \return none

//!

//! \brief Turns a specific LED Off

//

//*****************************************************************************

void

GPIO_IF_LedOn(char ledNum)

{

switch(ledNum)

{

case MCU_GREEN_LED_GPIO:

{

/* Switch ON GREEN LED */

GPIO_IF_Set(PIN_LED3, g_uiLED3Port, g_ucLED3Pin, 1);

break;

}

case MCU_ORANGE_LED_GPIO:

{

/* Switch ON ORANGE LED */

GPIO_IF_Set(PIN_LED2, g_uiLED2Port, g_ucLED2Pin, 1);

break;

}

case MCU_RED_LED_GPIO:

{

/* Switch ON RED LED */

GPIO_IF_Set(PIN_LED1, g_uiLED1Port, g_ucLED1Pin, 1);

break;

}

case MCU_ALL_LED_IND:

{

/* Switch ON ALL LEDs LED */

GPIO_IF_Set(PIN_LED3, g_uiLED3Port, g_ucLED3Pin, 1);

GPIO_IF_Set(PIN_LED2, g_uiLED2Port, g_ucLED2Pin, 1);

GPIO_IF_Set(PIN_LED1, g_uiLED1Port, g_ucLED1Pin, 1);

break;

}

default:

break;

}

}

//*****************************************************************************

//

//! Turn LED Off

//!

//! \param ledNum is the LED Number

//!

//! \return none

//!

//! \brief Turns a specific LED Off

//

//*****************************************************************************

void

GPIO_IF_LedOff(char ledNum)

{

switch(ledNum)

{

case MCU_GREEN_LED_GPIO:

{

/* Switch OFF GREEN LED */

GPIO_IF_Set(PIN_LED3, g_uiLED3Port, g_ucLED3Pin, 0);

break;

}

case MCU_ORANGE_LED_GPIO:

{

/* Switch OFF ORANGE LED */

GPIO_IF_Set(PIN_LED2, g_uiLED2Port, g_ucLED2Pin, 0);

break;

}

case MCU_RED_LED_GPIO:

{

/* Switch OFF RED LED */

GPIO_IF_Set(PIN_LED1, g_uiLED1Port, g_ucLED1Pin, 0);

break;

}

case MCU_ALL_LED_IND:

{

/* Switch OFF ALL LEDs LED */

GPIO_IF_Set(PIN_LED3, g_uiLED3Port, g_ucLED3Pin, 0);

GPIO_IF_Set(PIN_LED2, g_uiLED2Port, g_ucLED2Pin, 0);

GPIO_IF_Set(PIN_LED1, g_uiLED1Port, g_ucLED1Pin, 0);

break;

}

default:

break;

}

}

//*****************************************************************************

//

//! \brief This function returns LED current Status

//!

//! \param[in] ucGPIONum is the GPIO to which the LED is connected

//! MCU_GREEN_LED_GPIO\MCU_ORANGE_LED_GPIO\MCU_RED_LED_GPIO

//!

//!

//! \return 1: LED ON, 0: LED OFF

//

//*****************************************************************************

unsigned char

GPIO_IF_LedStatus(unsigned char ucGPIONum)

{

unsigned char ucLEDStatus;

switch(ucGPIONum)

{

case MCU_GREEN_LED_GPIO:

{

ucLEDStatus = GPIO_IF_Get(ucGPIONum, g_uiLED3Port, g_ucLED3Pin);

break;

}

case MCU_ORANGE_LED_GPIO:

{

ucLEDStatus = GPIO_IF_Get(ucGPIONum, g_uiLED2Port, g_ucLED2Pin);

break;

}

case MCU_RED_LED_GPIO:

{

ucLEDStatus = GPIO_IF_Get(ucGPIONum, g_uiLED1Port, g_ucLED1Pin);

break;

}

default:

ucLEDStatus = 0;

}

return ucLEDStatus;

}

//*****************************************************************************

//

//! Toggle the Led state

//!

//! \param ledNum is the LED Number

//!

//! \return none

//!

//! \brief Toggles a board LED

//

//*****************************************************************************

void GPIO_IF_LedToggle(unsigned char ucLedNum)

{

unsigned char ucLEDStatus = GPIO_IF_LedStatus(ucLedNum);

if(ucLEDStatus == 1)

{

GPIO_IF_LedOff(ucLedNum);

}

else

{

GPIO_IF_LedOn(ucLedNum);

}

}

//****************************************************************************

//

//! Get the port and pin of a given GPIO

//!

//! \param ucPin is the pin to be set-up as a GPIO (0:39)

//! \param puiGPIOPort is the pointer to store GPIO port address return value

//! \param pucGPIOPin is the pointer to store GPIO pin return value

//!

//! This function

//! 1. Return the GPIO port address and pin for a given external pin number

//!

//! \return None.

//

//****************************************************************************

void

GPIO_IF_GetPortNPin(unsigned char ucPin,

unsigned int *puiGPIOPort,

unsigned char *pucGPIOPin)

{

//

// Get the GPIO pin from the external Pin number

//

*pucGPIOPin = 1 << (ucPin % 8);

//

// Get the GPIO port from the external Pin number

//

*puiGPIOPort = (ucPin / 8);

*puiGPIOPort = ulReg[*puiGPIOPort];

}

//****************************************************************************

//

//! Configures the GPIO selected as input to generate interrupt on activity

//!

//! \param uiGPIOPort is the GPIO port address

//! \param ucGPIOPin is the GPIO pin of the specified port

//! \param uiIntType is the type of the interrupt (refer gpio.h)

//! \param pfnIntHandler is the interrupt handler to register

//!

//! This function

//! 1. Sets GPIO interrupt type

//! 2. Registers Interrupt handler

//! 3. Enables Interrupt

//!

//! \return None

//

//****************************************************************************

void

GPIO_IF_ConfigureNIntEnable(unsigned int uiGPIOPort,

unsigned char ucGPIOPin,

unsigned int uiIntType,

void (*pfnIntHandler)(void))

{

//

// Set GPIO interrupt type

//

MAP_GPIOIntTypeSet(uiGPIOPort,ucGPIOPin,uiIntType);

//

// Register Interrupt handler

//

MAP_GPIOIntRegister(uiGPIOPort,pfnIntHandler);

//

// Enable Interrupt

//

MAP_GPIOIntClear(uiGPIOPort,ucGPIOPin);

MAP_GPIOIntEnable(uiGPIOPort,ucGPIOPin);

}

//****************************************************************************

//

//! Set a value to the specified GPIO pin

//!

//! \param ucPin is the GPIO pin to be set (0:39)

//! \param uiGPIOPort is the GPIO port address

//! \param ucGPIOPin is the GPIO pin of the specified port

//! \param ucGPIOValue is the value to be set

//!

//! This function

//! 1. Sets a value to the specified GPIO pin

//!

//! \return None.

//

//****************************************************************************

void

GPIO_IF_Set(unsigned char ucPin,

unsigned int uiGPIOPort,

unsigned char ucGPIOPin,

unsigned char ucGPIOValue)

{

//

// Set the corresponding bit in the bitmask

//

ucGPIOValue = ucGPIOValue << (ucPin % 8);

//

// Invoke the API to set the value

//

MAP_GPIOPinWrite(uiGPIOPort,ucGPIOPin,ucGPIOValue);

}

//****************************************************************************

//

//! Set a value to the specified GPIO pin

//!

//! \param ucPin is the GPIO pin to be set (0:39)

//! \param uiGPIOPort is the GPIO port address

//! \param ucGPIOPin is the GPIO pin of the specified port

//!

//! This function

//! 1. Gets a value of the specified GPIO pin

//!

//! \return value of the GPIO pin

//

//****************************************************************************

unsigned char

GPIO_IF_Get(unsigned char ucPin,

unsigned int uiGPIOPort,

unsigned char ucGPIOPin)

{

unsigned char ucGPIOValue;

long lGPIOStatus;

//

// Invoke the API to Get the value

//

lGPIOStatus = MAP_GPIOPinRead(uiGPIOPort,ucGPIOPin);

//

// Set the corresponding bit in the bitmask

//

ucGPIOValue = lGPIOStatus >> (ucPin % 8);

return ucGPIOValue;

}

void GPIO_Set(unsigned char ucGPIONum){

int ucGPIOPin, uiGPIOPort;

ucGPIOPin = 1 << (ucGPIONum % 8);

uiGPIOPort = ulReg[ucGPIONum / 8];

MAP_GPIOPinWrite(uiGPIOPort,ucGPIOPin,0xff);

}

void GPIO_Clear(unsigned char ucGPIONum){

int ucGPIOPin, uiGPIOPort;

ucGPIOPin = 1 << (ucGPIONum % 8);

uiGPIOPort = ulReg[ucGPIONum / 8];

MAP_GPIOPinWrite(uiGPIOPort,ucGPIOPin,0x0);

}

void GPIOIntInit(unsigned long ulPort, unsigned char ucPin, unsigned long ulInterrupt, void (*pfnHandler)(void), unsigned long ulIntType, unsigned char ucPriority) {

IntRegister(ulInterrupt, pfnHandler);

IntPrioritySet(ulInterrupt, INT_PRIORITY_LVL_1);

GPIOIntTypeSet(ulPort,ucPin,ulIntType);

GPIOIntClear(ulPort,0xFF);

GPIOIntEnable(ulPort,ucPin);

IntEnable(ulInterrupt);

}

gpio_if.h

/*

* gpio_if.h

*

* Created on: 2016. 9. 7.

* Author: Sokwhan

*/

#ifndef __GPIOIF_H__

#define __GPIOIF_H__

typedef enum

{

NO_LED,

LED1 = 0x1, /* RED LED D7/GP9/Pin64 */

LED2 = 0x2, /* ORANGE LED D6/GP10/Pin1 */

LED3 = 0x4 /* GREEN LED D5/GP11/Pin2 */

} ledEnum;

typedef enum

{

MCU_RED_LED_GPIO = 9, /* GP09 for LED RED as per LP 3.0 */

MCU_ORANGE_LED_GPIO = 10,/* GP10 for LED ORANGE as per LP 3.0 */

MCU_GREEN_LED_GPIO = 11, /* GP11 for LED GREEN as per LP 3.0 */

MCU_ALL_LED_IND = 12

} ledNames;

//*****************************************************************************

//

// API Function prototypes

//

//*****************************************************************************

extern void GPIO_IF_GetPortNPin(unsigned char ucPin,

unsigned int *puiGPIOPort,

unsigned char *pucGPIOPin);

extern void GPIO_IF_ConfigureNIntEnable(unsigned int uiGPIOPort,

unsigned char ucGPIOPin,

unsigned int uiIntType,

void (*pfnIntHandler)(void));

extern void GPIO_IF_Set(unsigned char ucPin,

unsigned int uiGPIOPort,

unsigned char ucGPIOPin,

unsigned char ucGPIOValue);

extern unsigned char GPIO_IF_Get(unsigned char ucPin,

unsigned int uiGPIOPort,

unsigned char ucGPIOPin);

extern void GPIO_IF_LedConfigure(unsigned char ucPins);

extern void GPIO_IF_LedOn(char ledNum);

extern void GPIO_IF_LedOff(char ledNum);

extern unsigned char GPIO_IF_LedStatus(unsigned char ucGPIONum);

extern void GPIO_IF_LedToggle(unsigned char ucLedNum);

extern void GPIO_Set(unsigned char ucGPIONum);

extern void GPIO_Clear(unsigned char ucGPIONum);

extern void GPIO_Toggle(unsigned char ucGPIONum);

void GPIOIntInit( unsigned long ulPort,

unsigned char ucPin,

unsigned long ulInterrupt,

void (*pfnHandler)(void),

unsigned long ulIntType,

unsigned char ucPriority);

void GPIOs3IntHandler(void);

//*****************************************************************************

//

// Mark the end of the C bindings section for C++ compilers.

//

//*****************************************************************************

#ifdef __cplusplus

}

#endif

#endif // __GPIOIF_H__

pinmux.c

/*

* Smart Doorlock

*

* pinmux.c

*

* Created on: 2016. 8. 27.

* Author: Sokwhan

*/

#include "pinmux.h"

#include "hw_types.h"

#include "hw_memmap.h"

#include "hw_gpio.h"

#include "pin.h"

#include "rom.h"

#include "rom_map.h"

#include "gpio.h"

#include "prcm.h"

//*****************************************************************************

void

PinMuxConfig(void)

{

// Enable Peripheral Clocks

MAP_PRCMPeripheralClkEnable(PRCM_UARTA0, PRCM_RUN_MODE_CLK);

// Reserved for Future Use (Probably IRQ)

MAP_PRCMPeripheralClkEnable(PRCM_GPIOA0, PRCM_RUN_MODE_CLK);

// Used for LED1,2,3

MAP_PRCMPeripheralClkEnable(PRCM_GPIOA1, PRCM_RUN_MODE_CLK);

// Configure PIN_55 for UART0 UART0_TX

MAP_PinTypeUART(PIN_55, PIN_MODE_3);

// Configure PIN_57 for UART0 UART0_RX

MAP_PinTypeUART(PIN_57, PIN_MODE_3);

// Configure PIN_64 for LED1 (GPIO9)

MAP_PinTypeGPIO(PIN_64, PIN_MODE_0, false);

MAP_GPIODirModeSet(GPIOA1_BASE, 0x2, GPIO_DIR_MODE_OUT);

// Configure PIN_01 for LED2

MAP_PinTypeGPIO(PIN_01, PIN_MODE_0, false);

MAP_GPIODirModeSet(GPIOA1_BASE, 0x4, GPIO_DIR_MODE_OUT);

// Configure PIN_02 for LED3

MAP_PinTypeGPIO(PIN_02, PIN_MODE_0, false);

MAP_GPIODirModeSet(GPIOA1_BASE, 0x8, GPIO_DIR_MODE_OUT);

}

# September 22nd, 2016

Over the week, the portion of LCD and keypad interfacing was worked on. Unfortunately, for LCD, the hardware needs a specific socket for it to be able to connect to a breadboard (or even jumper cables in this case), so I had to order those. The keypad interfacing worked flawlessly with a simple test code. Substantial changes were made to GPIO interfacing code in general.

main.c (only test code portion is shown)

void SmartDoorlockApp(void *pvParameters) {

long lRetVal = -1;

unsigned int uiConnectTimeoutCnt = 0;

//GPIO_IF_LedConfigure(LED1|LED2|LED3);

GPIO_IF_Set(PIN_KEYPAD_R1,1);

GPIO_IF_Set(PIN_KEYPAD_R2,1);

GPIO_IF_Set(PIN_KEYPAD_R3,1);

GPIO_IF_Set(PIN_KEYPAD_R4,1);

unsigned int rowEnum = 0;

for (;;) {

unsigned int test = 0;

if (rowEnum == 0) {

GPIO_IF_Set(PIN_KEYPAD_R1,0);

GPIO_IF_Set(PIN_KEYPAD_R2,1);

GPIO_IF_Set(PIN_KEYPAD_R3,1);

GPIO_IF_Set(PIN_KEYPAD_R4,1);

}

else if (rowEnum == 1) {

GPIO_IF_Set(PIN_KEYPAD_R1,1);

GPIO_IF_Set(PIN_KEYPAD_R2,0);

GPIO_IF_Set(PIN_KEYPAD_R3,1);

GPIO_IF_Set(PIN_KEYPAD_R4,1);

}

else if (rowEnum == 2) {

GPIO_IF_Set(PIN_KEYPAD_R1,1);

GPIO_IF_Set(PIN_KEYPAD_R2,1);

GPIO_IF_Set(PIN_KEYPAD_R3,0);

GPIO_IF_Set(PIN_KEYPAD_R4,1);

}

else if (rowEnum == 3) {

GPIO_IF_Set(PIN_KEYPAD_R1,1);

GPIO_IF_Set(PIN_KEYPAD_R2,1);

GPIO_IF_Set(PIN_KEYPAD_R3,1);

GPIO_IF_Set(PIN_KEYPAD_R4,0);

}

Report("------------------------");

Report("Row: %d", rowEnum + 1);

test = GPIO_IF_Get(PIN_KEYPAD_C1);

Report("C1: %d ",test);

test = GPIO_IF_Get(PIN_KEYPAD_C2);

Report("C2: %d ",test);

test = GPIO_IF_Get(PIN_KEYPAD_C3);

Report("C3: %d\n\r",test);

rowEnum++;

if (rowEnum >= 4)

rowEnum = 0;

osi_Sleep(500);

}

gpio.h

/*

* gpio_if.h

*

* Created on: 2016. 9. 7.

* Author: Sokwhan

*/

#ifndef __GPIOIF_H__

#define __GPIOIF_H__

typedef enum

{

PIN_LCD_RS = 0, //4 RS (CS) H / L H=Data, L=Command

PIN_LCD_RW = 3, //5 R/W (SID) H / L H=Read, L=Write

PIN_LCD_E = 4, //6 E (SCLK) H Enable (falling edge)

PIN_LCD_D0 = 5, //7 D0 (SOD) H / L Display Data, LSB

PIN_LCD_D1 = 6, //8 D1 H / L Display Data

PIN_LCD_D2 = 7, //9 D2 H / L Display Data

PIN_LCD_D3 = 8, //10 D3 H / L Display Data

PIN_LCD_D4 = 9, //11 D4 (D0) H / L Display Data

PIN_LCD_D5 = 10, //12 D5 (D1) H / L Display Data

PIN_LCD_D6 = 11, //13 D6 (D2) H / L Display Data

PIN_LCD_D7 = 12 //14 D7 (D3) H / L Display Data, MSB

} lcdPinEnum;

typedef enum

{

PIN_KEYPAD_C1 = 13,

PIN_KEYPAD_C2 = 14,

PIN_KEYPAD_C3 = 15,

PIN_KEYPAD_R1 = 17,

PIN_KEYPAD_R2 = 9,

PIN_KEYPAD_R3 = 30,

PIN_KEYPAD_R4 = 28

} keypadPinEnum;

//*****************************************************************************

//

// API Function prototypes

//

//*****************************************************************************

extern void GPIO_IF_GetPortNPin(unsigned char ucPin,

unsigned int *puiGPIOPort,

unsigned char *pucGPIOPin);

extern void GPIO_IF_ConfigureNIntEnable(unsigned int uiGPIOPort,

unsigned char ucGPIOPin,

unsigned int uiIntType,

void (*pfnIntHandler)(void));

extern void GPIO_IF_Set(unsigned int gpioNum, unsigned int state);

extern void GPIO_IF_Toggle(unsigned int gpioNum);

extern unsigned char GPIO_IF_GetVal(unsigned char ucPin,

unsigned int uiGPIOPort,

unsigned char ucGPIOPin);

static void GPIO_IF_SetVal(unsigned char ucPin,

unsigned int uiGPIOPort,

unsigned char ucGPIOPin,

unsigned char ucGPIOValue);

extern void GPIO_Set(unsigned char ucGPIONum);

extern void GPIO_Clear(unsigned char ucGPIONum);

extern void GPIO_Toggle(unsigned char ucGPIONum);

extern unsigned char GPIO_IF_Get(unsigned int gpioNum);

void GPIOIntInit( unsigned long ulPort,

unsigned char ucPin,

unsigned long ulInterrupt,

void (*pfnHandler)(void),

unsigned long ulIntType,

unsigned char ucPriority);

void GPIOs3IntHandler(void);

//*****************************************************************************

//

// Mark the end of the C bindings section for C++ compilers.

//

//*****************************************************************************

#ifdef __cplusplus

}

#endif

#endif // __GPIOIF_H__

gpio.c

/*

* gpio_if.c

*

* Created on: 2016. 9. 7.

* Author: Sokwhan

*/

#include <stdio.h>

#include "hw_types.h"

#include "hw_ints.h"

#include "hw_memmap.h"

#include "interrupt.h"

#include "pin.h"

#include "gpio.h"

#include "hw_apps_rcm.h"

#include "prcm.h"

#include "rom.h"

#include "rom_map.h"

#include "gpio_if.h"

//****************************************************************************

// GLOBAL VARIABLES

//****************************************************************************

static unsigned long ulReg[]=

{

GPIOA0_BASE,

GPIOA1_BASE,

GPIOA2_BASE,

GPIOA3_BASE

};

//*****************************************************************************

// Variables to store TIMER Port,Pin values

//*****************************************************************************

//****************************************************************************

// LOCAL FUNCTION DEFINITIONS

//****************************************************************************

void

GPIO_IF_Set(unsigned int gpioNum, unsigned int state) {

unsigned int portNum = 0;

unsigned char pinNum;

GPIO_IF_GetPortNPin(gpioNum,

&portNum,

&pinNum);

GPIO_IF_SetVal(gpioNum, portNum, pinNum, state);

}

void

GPIO_IF_Toggle(unsigned int gpioNum) {

unsigned int portNum = 0;

unsigned char pinNum;

unsigned int portStatus;

GPIO_IF_GetPortNPin(gpioNum,

&portNum,

&pinNum);

portStatus = !GPIO_IF_GetVal(gpioNum, portNum, pinNum);

GPIO_IF_SetVal(gpioNum, portNum, pinNum, portStatus);

}

unsigned char

GPIO_IF_Get(unsigned int gpioNum) {

unsigned int portNum = 0;

unsigned char pinNum;

GPIO_IF_GetPortNPin(gpioNum,

&portNum,

&pinNum);

return GPIO_IF_GetVal(gpioNum, portNum, pinNum);

}

//****************************************************************************

//

//! Get the port and pin of a given GPIO

//!

//! \param ucPin is the pin to be set-up as a GPIO (0:39)

//! \param puiGPIOPort is the pointer to store GPIO port address return value

//! \param pucGPIOPin is the pointer to store GPIO pin return value

//!

//! This function

//! 1. Return the GPIO port address and pin for a given external pin number

//!

//! \return None.

//

//****************************************************************************

void

GPIO_IF_GetPortNPin(unsigned char ucPin,

unsigned int *puiGPIOPort,

unsigned char *pucGPIOPin)

{

//

// Get the GPIO pin from the external Pin number

//

*pucGPIOPin = 1 << (ucPin % 8);

//

// Get the GPIO port from the external Pin number

//

*puiGPIOPort = (ucPin / 8);

*puiGPIOPort = ulReg[*puiGPIOPort];

}

//****************************************************************************

//

//! Configures the GPIO selected as input to generate interrupt on activity

//!

//! \param uiGPIOPort is the GPIO port address

//! \param ucGPIOPin is the GPIO pin of the specified port

//! \param uiIntType is the type of the interrupt (refer gpio.h)

//! \param pfnIntHandler is the interrupt handler to register

//!

//! This function

//! 1. Sets GPIO interrupt type

//! 2. Registers Interrupt handler

//! 3. Enables Interrupt

//!

//! \return None

//

//****************************************************************************

void

GPIO_IF_ConfigureNIntEnable(unsigned int uiGPIOPort,

unsigned char ucGPIOPin,

unsigned int uiIntType,

void (*pfnIntHandler)(void))

{

//

// Set GPIO interrupt type

//

MAP_GPIOIntTypeSet(uiGPIOPort,ucGPIOPin,uiIntType);

//

// Register Interrupt handler

//

MAP_GPIOIntRegister(uiGPIOPort,pfnIntHandler);

//

// Enable Interrupt

//

MAP_GPIOIntClear(uiGPIOPort,ucGPIOPin);

MAP_GPIOIntEnable(uiGPIOPort,ucGPIOPin);

}

//****************************************************************************

//

//! Set a value to the specified GPIO pin

//!

//! \param ucPin is the GPIO pin to be set (0:39)

//! \param uiGPIOPort is the GPIO port address

//! \param ucGPIOPin is the GPIO pin of the specified port

//! \param ucGPIOValue is the value to be set

//!

//! This function

//! 1. Sets a value to the specified GPIO pin

//!

//! \return None.

//

//****************************************************************************

static void

GPIO_IF_SetVal(unsigned char ucPin,

unsigned int uiGPIOPort,

unsigned char ucGPIOPin,

unsigned char ucGPIOValue)

{

//

// Set the corresponding bit in the bitmask

//

ucGPIOValue = ucGPIOValue << (ucPin % 8);

//

// Invoke the API to set the value

//

MAP_GPIOPinWrite(uiGPIOPort,ucGPIOPin,ucGPIOValue);

}

//****************************************************************************

//

//! Set a value to the specified GPIO pin

//!

//! \param ucPin is the GPIO pin to be set (0:39)

//! \param uiGPIOPort is the GPIO port address

//! \param ucGPIOPin is the GPIO pin of the specified port

//!

//! This function

//! 1. Gets a value of the specified GPIO pin

//!

//! \return value of the GPIO pin

//

//****************************************************************************

unsigned char

GPIO_IF_GetVal(unsigned char ucPin,

unsigned int uiGPIOPort,

unsigned char ucGPIOPin)

{

unsigned char ucGPIOValue;

long lGPIOStatus;

//

// Invoke the API to Get the value

//

lGPIOStatus = MAP_GPIOPinRead(uiGPIOPort,ucGPIOPin);

//

// Set the corresponding bit in the bitmask

//

ucGPIOValue = lGPIOStatus >> (ucPin % 8);

return ucGPIOValue;

}

/*

void GPIO_Set(unsigned char ucGPIONum){

int ucGPIOPin, uiGPIOPort;

ucGPIOPin = 1 << (ucGPIONum % 8);

uiGPIOPort = ulReg[ucGPIONum / 8];

MAP_GPIOPinWrite(uiGPIOPort,ucGPIOPin,0xff);

}

void GPIO_Clear(unsigned char ucGPIONum){

int ucGPIOPin, uiGPIOPort;

ucGPIOPin = 1 << (ucGPIONum % 8);

uiGPIOPort = ulReg[ucGPIONum / 8];

MAP_GPIOPinWrite(uiGPIOPort,ucGPIOPin,0x0);

}

*/

void GPIOIntInit(unsigned long ulPort, unsigned char ucPin, unsigned long ulInterrupt, void (*pfnHandler)(void), unsigned long ulIntType, unsigned char ucPriority) {

IntRegister(ulInterrupt, pfnHandler);

IntPrioritySet(ulInterrupt, INT_PRIORITY_LVL_1);

GPIOIntTypeSet(ulPort,ucPin,ulIntType);

GPIOIntClear(ulPort,0xFF);

GPIOIntEnable(ulPort,ucPin);

IntEnable(ulInterrupt);

}

# September 26th, 2016

Commenced work on MQTT client code. The TI example is mostly straight forward, so implementing the protocol on the project was not troublesome. Tested the implementation on cloud server and results show that both publishing & subscribing on topics works pretty well.

mqtt_client.c

/*

* mqtt_client.c

*

* Created on: Sep 26, 2016

* Author: shuh

*/

// Standard includes

#include <stdlib.h>

// Common Interface Includes

#include "common.h"

#include "sl_mqtt_client.h"

#include "uart_if.h"

#include "network.h"

// Project Includes

#include "mqtt_client.h"

/*Operate Lib in MQTT 3.1 mode.*/

#define MQTT_3_1_1 false /*MQTT 3.1.1 */

#define MQTT_3_1 true /*MQTT 3.1*/

#define WILL_TOPIC "Client"

#define WILL_MSG "Client Stopped"

#define WILL_QOS QOS2

#define WILL_RETAIN false

/*Background receive task priority*/

#define TASK_PRIORITY 3

#define UART_PRINT Report

/*Defining Number of topics*/

#define TOPIC_COUNT 3

/* Keep Alive Timer value*/

#define KEEP_ALIVE_TIMER 25

/*Defining Broker IP address and port Number*/

#define SERVER_ADDRESS "messagesight.demos.ibm.com"

#define PORT_NUMBER 1883

#define SERVER_MODE MQTT_3_1

/*Specifying Receive time out for the Receive task*/

#define RCV_TIMEOUT 30

/*Defining QOS levels*/

#define QOS0 0

#define QOS1 1

#define QOS2 2

/*Defining Subscription Topic Values*/

#define TOPIC1 "/cc3200/ToggleLEDCmdL1"

#define TOPIC2 "/cc3200/ToggleLEDCmdL2"

#define TOPIC3 "/cc3200/ToggleLEDCmdL3"

//*****************************************************************************

// LOCAL FUNCTION PROTOTYPES

//*****************************************************************************

static void

Mqtt_Recv(void *app_hndl, const char *topstr, long top_len, const void *payload,

long pay_len, bool dup,unsigned char qos, bool retain);

static void sl_MqttEvt(void *app_hndl,long evt, const void *buf,

unsigned long len);

static void sl_MqttDisconnect(void *app_hndl);

int initMqtt();

/* library configuration */

SlMqttClientLibCfg_t Mqtt_Client={

1882,

TASK_PRIORITY,

30,

true,

(long(*)(const char *, ...))UART_PRINT

};

typedef struct connection_config{

SlMqttClientCtxCfg_t broker_config;

void *clt_ctx;

unsigned char *client_id;

unsigned char *usr_name;

unsigned char *usr_pwd;

bool is_clean;

unsigned int keep_alive_time;

SlMqttClientCbs_t CallBAcks;

int num_topics;

char *topic[TOPIC_COUNT];

unsigned char qos[TOPIC_COUNT];

SlMqttWill_t will_params;

bool is_connected;

}connect_config;

/* connection configuration */

connect_config usr_connect_config[] =

{

{

{

{

SL_MQTT_NETCONN_URL,

SERVER_ADDRESS,

PORT_NUMBER,

0,

0,

0,

NULL

},

SERVER_MODE,

true,

},

NULL,

"user1",

NULL,

NULL,

true,

KEEP_ALIVE_TIMER,

{Mqtt_Recv, sl_MqttEvt, sl_MqttDisconnect},

TOPIC_COUNT,

{TOPIC1, TOPIC2, TOPIC3},

{QOS2, QOS2, QOS2},

{WILL_TOPIC,WILL_MSG,WILL_QOS,WILL_RETAIN},

false

}

};

/*Message Queue*/

OsiMsgQ_t g_PBQueue;

void *app_hndl = (void*)usr_connect_config;

int initMqtt() {

long lRetVal = -1;

lRetVal = sl_ExtLib_MqttClientInit(&Mqtt_Client);

if(lRetVal != 0)

{

// lib initialization failed

UART_PRINT("MQTT Client lib initialization failed\n\r");

return -1;

}

int iCount = 0;

event_msg RecvQue;

connect_config *local_con_conf = (connect_config *)app_hndl;

connect_to_broker:

//create client context

local_con_conf[iCount].clt_ctx =

sl_ExtLib_MqttClientCtxCreate(&local_con_conf[iCount].broker_config,

&local_con_conf[iCount].CallBAcks,

&(local_con_conf[iCount]));

//

// Set Client ID

//

sl_ExtLib_MqttClientSet((void*)local_con_conf[iCount].clt_ctx,

SL_MQTT_PARAM_CLIENT_ID,

local_con_conf[iCount].client_id,

strlen((char*)(local_con_conf[iCount].client_id)));

//

// Set will Params

//

if(local_con_conf[iCount].will_params.will_topic != NULL)

{

sl_ExtLib_MqttClientSet((void*)local_con_conf[iCount].clt_ctx,

SL_MQTT_PARAM_WILL_PARAM,

&(local_con_conf[iCount].will_params),

sizeof(SlMqttWill_t));

}

//

// setting username and password

//

if(local_con_conf[iCount].usr_name != NULL)

{

sl_ExtLib_MqttClientSet((void*)local_con_conf[iCount].clt_ctx,

SL_MQTT_PARAM_USER_NAME,

local_con_conf[iCount].usr_name,

strlen((char*)local_con_conf[iCount].usr_name));

if(local_con_conf[iCount].usr_pwd != NULL)

{

sl_ExtLib_MqttClientSet((void*)local_con_conf[iCount].clt_ctx,

SL_MQTT_PARAM_PASS_WORD,

local_con_conf[iCount].usr_pwd,

strlen((char*)local_con_conf[iCount].usr_pwd));

}

}

//

// connectin to the broker

//

if((sl_ExtLib_MqttClientConnect((void*)local_con_conf[iCount].clt_ctx,

local_con_conf[iCount].is_clean,

local_con_conf[iCount].keep_alive_time) & 0xFF) != 0)

{

UART_PRINT("\n\rBroker connect fail for conn no. %d \n\r",iCount+1);

//delete the context for this connection

sl_ExtLib_MqttClientCtxDelete(local_con_conf[iCount].clt_ctx);

return -1;

}

else

{

UART_PRINT("\n\rSuccess: conn to Broker no. %d\n\r ", iCount+1);

local_con_conf[iCount].is_connected = true;

}

//

// Subscribe to topics

//

if(sl_ExtLib_MqttClientSub((void*)local_con_conf[iCount].clt_ctx,

local_con_conf[iCount].topic,

local_con_conf[iCount].qos, TOPIC_COUNT) < 0)

{

UART_PRINT("\n\r Subscription Error for conn no. %d\n\r", iCount+1);

UART_PRINT("Disconnecting from the broker\r\n");

sl_ExtLib_MqttClientDisconnect(local_con_conf[iCount].clt_ctx);

local_con_conf[iCount].is_connected = false;

//delete the context for this connection

sl_ExtLib_MqttClientCtxDelete(local_con_conf[iCount].clt_ctx);

return -1;

}

else

{

int iSub;

UART_PRINT("Client subscribed on following topics:\n\r");

for(iSub = 0; iSub < local_con_conf[iCount].num_topics; iSub++)

{

UART_PRINT("%s\n\r", local_con_conf[iCount].topic[iSub]);

}

}

for(;;)

{

osi_MsgQRead( &g_PBQueue, &RecvQue, OSI_WAIT_FOREVER);

if(BROKER_DISCONNECTION == RecvQue.event)

{

/* Derive the value of the local_con_conf or clt_ctx from the message */

sl_ExtLib_MqttClientCtxDelete(((connect_config*)(RecvQue.hndl))->clt_ctx);

if(!IS_CONNECTED(g_ulStatus))

{

UART_PRINT("device has disconnected from AP \n\r");

UART_PRINT("retry connection to the AP\n\r");

while(!(IS_CONNECTED(g_ulStatus)) || !(IS_IP_ACQUIRED(g_ulStatus)))

{

osi_Sleep(10);

}

goto connect_to_broker;

}

//

// device not connected to any broker

//

goto end;

}

}

end:

//

// Deinitializating the client library

//

sl_ExtLib_MqttClientExit();

UART_PRINT("\n\r Exiting the Application\n\r");

return 0;

}

//****************************************************************************

//! Defines Mqtt_Pub_Message_Receive event handler.

//! Client App needs to register this event handler with sl_ExtLib_mqtt_Init

//! API. Background receive task invokes this handler whenever MQTT Client

//! receives a Publish Message from the broker.

//!

//!\param[out] topstr => pointer to topic of the message

//!\param[out] top_len => topic length

//!\param[out] payload => pointer to payload

//!\param[out] pay_len => payload length

//!\param[out] retain => Tells whether its a Retained message or not

//!\param[out] dup => Tells whether its a duplicate message or not

//!\param[out] qos => Tells the Qos level

//!

//!\return none

//****************************************************************************

static void

Mqtt_Recv(void *app_hndl, const char *topstr, long top_len, const void *payload,

long pay_len, bool dup,unsigned char qos, bool retain)

{

char *output_str=(char*)malloc(top_len+1);

memset(output_str,'\0',top_len+1);

strncpy(output_str, (char*)topstr, top_len);

output_str[top_len]='\0';

if(strncmp(output_str,TOPIC1, top_len) == 0)

{

//ToggleLedState(LED1);

}

else if(strncmp(output_str,TOPIC2, top_len) == 0)

{

//ToggleLedState(LED2);

}

else if(strncmp(output_str,TOPIC3, top_len) == 0)

{

//ToggleLedState(LED3);

}

UART_PRINT("\n\rPublish Message Received");

UART_PRINT("\n\rTopic: ");

UART_PRINT("%s",output_str);

free(output_str);

UART_PRINT(" [Qos: %d] ",qos);

if(retain)

UART_PRINT(" [Retained]");

if(dup)

UART_PRINT(" [Duplicate]");

output_str=(char*)malloc(pay_len+1);

memset(output_str,'\0',pay_len+1);

strncpy(output_str, (char*)payload, pay_len);

output_str[pay_len]='\0';

UART_PRINT("\n\rData is: ");

UART_PRINT("%s",(char*)output_str);

UART_PRINT("\n\r");

free(output_str);

return;

}

//****************************************************************************

//! Defines sl_MqttEvt event handler.

//! Client App needs to register this event handler with sl_ExtLib_mqtt_Init

//! API. Background receive task invokes this handler whenever MQTT Client

//! receives an ack(whenever user is in non-blocking mode) or encounters an error.

//!

//! param[out] evt => Event that invokes the handler. Event can be of the

//! following types:

//! MQTT_ACK - Ack Received

//! MQTT_ERROR - unknown error

//!

//!

//! \param[out] buf => points to buffer

//! \param[out] len => buffer length

//!

//! \return none

//****************************************************************************

static void

sl_MqttEvt(void *app_hndl, long evt, const void *buf,unsigned long len)

{

int i;

switch(evt)

{

case SL_MQTT_CL_EVT_PUBACK:

UART_PRINT("PubAck:\n\r");

UART_PRINT("%s\n\r",buf);

break;

case SL_MQTT_CL_EVT_SUBACK:

UART_PRINT("\n\rGranted QoS Levels are:\n\r");

for(i=0;i<len;i++)

{

UART_PRINT("QoS %d\n\r",((unsigned char*)buf)[i]);

}

break;

case SL_MQTT_CL_EVT_UNSUBACK:

UART_PRINT("UnSub Ack \n\r");

UART_PRINT("%s\n\r",buf);

break;

default:

break;

}

}

//****************************************************************************

//

//! callback event in case of MQTT disconnection

//!

//! \param app_hndl is the handle for the disconnected connection

//!

//! return none

//

//****************************************************************************

static void

sl_MqttDisconnect(void *app_hndl)

{

connect_config *local_con_conf;

event_msg msg;

local_con_conf = app_hndl;

msg.hndl = app_hndl;

msg.event = BROKER_DISCONNECTION;

UART_PRINT("disconnect from broker %s\r\n",

(local_con_conf->broker_config).server_info.server_addr);

local_con_conf->is_connected = false;

//

// write message indicating publish message

//

osi_MsgQWrite(&g_PBQueue,&msg,OSI_NO_WAIT);

}

mqtt_client.h

/*

* mqtt_client.h

*

* Created on: Sep 26, 2016

* Author: shuh

*/

#ifndef MQTT_CLIENT_H_

#define MQTT_CLIENT_H_

typedef enum

{

PUSH_BUTTON_SW2_PRESSED,

PUSH_BUTTON_SW3_PRESSED,

BROKER_DISCONNECTION

}events;

typedef struct

{

void * hndl;

events event;

}event_msg;

extern int initMqtt();

extern OsiMsgQ_t g_PBQueue;

#endif /* MQTT_CLIENT_H_ */

# September 27th, 2016

Source Control (Mercurial): https://bitbucket.org/l46kok/smart-doorlock-web-server

Created a repository for Smart Doorlock web server. Originally, I was planning to use ASP.NET MVC for web server, but the framework is a bit too heavy for the cloud server (Amazon EC2). I’ve decided to use NancyFX instead - testing it on my local machine showed that it has a very low memory consumption, making it pretty ideal for this project. For MQTT server, there is an open source .NET project just for this purpose known as GnatMQ. (https://github.com/ppatierno/gnatmq). The documentation is lacking (actually I’d say it’s practically non-existent), but the source code itself is nicely written, so determining its functionalities by reading over the source code was not difficult at all.

As mentioned in the project requirement section, the language for the webserver is C#. The following files are for the back-end of the server

Program.cs

using Nancy.Hosting.Self;

using System;

using System.Collections.Generic;

using System.Linq;

using System.Text;

using System.Threading.Tasks;

namespace smart_doorlock_web_server

{

class Program

{

private const string WEB_SERVER_PORT = "1234";

private const string TERMINATE_STRING = "/Terminate";

static void Main(string[] args)

{

MqttBroker mqttBroker = MqttBroker.Instance;

#if TRACE

//MqttUtility.Trace.TraceLevel = MqttUtility.TraceLevel.Verbose | MqttUtility.TraceLevel.Frame;

//MqttUtility.Trace.TraceListener = (f, a) => System.Diagnostics.Trace.WriteLine(System.String.Format(f, a));

#endif

mqttBroker.Start();

var uri = new Uri("http://localhost:" + WEB_SERVER_PORT + "/");

var config = new HostConfiguration

{

UrlReservations = { CreateAutomatically = true },

AllowChunkedEncoding = false

};

var host = new NancyHost(config, uri);

try

{

host.Start();

Console.Write("Smart Doorlock Web Server\n" +

"\t\"" + uri + "\"\n" +

"To quit, input \"" + TERMINATE_STRING + "\".\n\n");

do Console.Write("> "); while (Console.ReadLine() != TERMINATE_STRING);

}

catch (Exception e)

{

Console.WriteLine("Unhandled exception has been occured!\n"

+ e.Message);

Console.ReadKey(true);

}

finally

{

host.Stop();

mqttBroker.Stop();

}

}

}

}

WebServerMainModule.cs

using Nancy;

using System;

using System.Collections.Generic;

using System.Linq;

using System.Text;

using System.Threading.Tasks;

namespace smart_doorlock_web_server

{

public class WebServerMainModule : NancyModule

{

MainPageSL mainPageSl = MainPageSL.Instance;

MqttBroker mqttBroker = MqttBroker.Instance;

public WebServerMainModule()

{

Get["/"] = _ =>

{

//MqttBroker.Instance.Publish("/cc3200/ToggleLEDCmdL1", "Test2");

return View["Views/MainPage.sshtml",mainPageSl.GetMainPageData()];

};

Post["/Subscribe"] = x =>

{

string clientId = Request.Form.clientId;

string topic = Request.Form.topic;

if (mqttBroker.Subscribe(clientId, topic))

return "OK";

return "Fail";

};

Post["/Publish"] = x =>

{

string clientId = Request.Form.clientId;

string topic = Request.Form.topic;

string message = Request.Form.message;

mqttBroker.Publish(topic, message);

return "OK";

};

}

}

}

MqttBroker.cs

using System;

using System.Collections.Generic;

using System.Linq;

using System.Text;

using uPLibrary.Networking.M2Mqtt.Messages;

using uPLibrary.Networking.M2Mqtt.Exceptions;

using uPLibrary.Networking.M2Mqtt.Managers;

using uPLibrary.Networking.M2Mqtt.Communication;

using uPLibrary.Networking.M2Mqtt.Session;

using System.Security.Cryptography.X509Certificates;

using System.Net.Security;

using uPLibrary.Networking.M2Mqtt;

namespace smart_doorlock_web_server

{

/// <summary>

/// MQTT broker business logic

/// </summary>

public class MqttBroker

{

internal const byte PROTOCOL_VERSION_V3_1 = 0x03;

internal const byte PROTOCOL_VERSION_V3_1_1 = 0x04; // [v.3.1.1]

// max length for client id (removed in 3.1.1)

internal const int CLIENT_ID_MAX_LENGTH = 23;

// MQTT broker settings

private MqttSettings settings;

// clients connected list

private MqttClientCollection clients;

// reference to publisher manager

private MqttPublisherManager publisherManager;

// reference to subscriber manager

private MqttSubscriberManager subscriberManager;

// reference to session manager

private MqttSessionManager sessionManager;

// reference to User Access Control manager

private MqttUacManager uacManager;

// MQTT communication layer

private IMqttCommunicationLayer commLayer;

private static readonly MqttBroker _instance = new MqttBroker();

public static MqttBroker Instance

{

get {

return _instance;

}

}

/// <summary>

/// User authentication method

/// </summary>

public MqttUserAuthenticationDelegate UserAuth

{

get { return this.uacManager.UserAuth; }

set { this.uacManager.UserAuth = value; }

}

/// <summary>

/// Constructor (TCP/IP communication layer on port 1883 and default settings)

/// </summary>

private MqttBroker()

: this(new MqttTcpCommunicationLayer(MqttSettings.MQTT_BROKER_DEFAULT_PORT), MqttSettings.Instance)

{

}

/// <summary>

/// Constructor

/// </summary>

/// <param name="commLayer">Communication layer to use (TCP)</param>

/// <param name="settings">Broker settings</param>

private MqttBroker(IMqttCommunicationLayer commLayer, MqttSettings settings)

{

// MQTT broker settings

this.settings = settings;

// MQTT communication layer

this.commLayer = commLayer;

this.commLayer.ClientConnected += commLayer_ClientConnected;

// create managers (publisher, subscriber, session and UAC)

this.subscriberManager = new MqttSubscriberManager();

this.sessionManager = new MqttSessionManager();

this.publisherManager = new MqttPublisherManager(this.subscriberManager, this.sessionManager);

this.uacManager = new MqttUacManager();

this.clients = new MqttClientCollection();

}

/// <summary>

/// Start broker

/// </summary>

public void Start()

{

this.commLayer.Start();

this.publisherManager.Start();

}

/// <summary>

/// Stop broker

/// </summary>

public void Stop()

{

this.commLayer.Stop();

this.publisherManager.Stop();

// close connection with all clients

foreach (MqttClient client in this.clients)

{

client.Close();

}

}

public void Publish(string topic, string message)

{

MqttMsgPublish publishMsg = new MqttMsgPublish(topic, Encoding.UTF8.GetBytes(message),false,1,false);

publisherManager.Publish(publishMsg);

}

public MqttClientCollection GetClientList()

{

return clients;

}

public bool Subscribe(string clientId, string topic)

{

MqttClient client = GetClient(clientId);

if (client == null)

return false;

byte[] qosLevel = new byte[] {MqttMsgBase.QOS_LEVEL_AT_LEAST_ONCE};

string[] topicParam = new string[] { topic };

client.Subscribe(topicParam,qosLevel);

return true;

}

/// <summary>

/// Close a client

/// </summary>

/// <param name="client">Client to close</param>

private void CloseClient(MqttClient client)

{

if (this.clients.Contains(client))

{

// if client is connected and it has a will message

if (!client.IsConnected && client.WillFlag)

{

// create the will PUBLISH message

MqttMsgPublish publish =

new MqttMsgPublish(client.WillTopic, Encoding.UTF8.GetBytes(client.WillMessage), false, client.WillQosLevel, false);

// publish message through publisher manager

this.publisherManager.Publish(publish);

}

// if not clean session

if (!client.CleanSession)

{

List<MqttSubscription> subscriptions = this.subscriberManager.GetSubscriptionsByClient(client.ClientId);

if ((subscriptions != null) && (subscriptions.Count > 0))

{

this.sessionManager.SaveSession(client.ClientId, client.Session, subscriptions);

// TODO : persist client session if broker close

}

}

// delete client from runtime subscription

this.subscriberManager.Unsubscribe(client);

// close the client

client.Close();

// remove client from the collection

this.clients.Remove(client);

}

}

void commLayer_ClientConnected(object sender, MqttClientConnectedEventArgs e)

{

// register event handlers from client

e.Client.MqttMsgDisconnected += Client_MqttMsgDisconnected;

e.Client.MqttMsgPublishReceived += Client_MqttMsgPublishReceived;

e.Client.MqttMsgConnected += Client_MqttMsgConnected;

e.Client.MqttMsgSubscribeReceived += Client_MqttMsgSubscribeReceived;

e.Client.MqttMsgUnsubscribeReceived += Client_MqttMsgUnsubscribeReceived;

e.Client.ConnectionClosed += Client_ConnectionClosed;

// add client to the collection

this.clients.Add(e.Client);

// start client threads

e.Client.Open();

}

void Client_MqttMsgPublishReceived(object sender, MqttMsgPublishEventArgs e)

{

MqttClient client = (MqttClient)sender;

// create PUBLISH message to publish

// [v3.1.1] DUP flag from an incoming PUBLISH message is not propagated to subscribers

// It should be set in the outgoing PUBLISH message based on transmission for each subscriber

MqttMsgPublish publish = new MqttMsgPublish(e.Topic, e.Message, false, e.QosLevel, e.Retain);

Console.WriteLine("Publish Received: [{0},{1}]",e.Topic,e.Message);

// publish message through publisher manager

this.publisherManager.Publish(publish);

}

void Client_MqttMsgUnsubscribeReceived(object sender, MqttMsgUnsubscribeEventArgs e)

{

MqttClient client = (MqttClient)sender;

for (int i = 0; i < e.Topics.Length; i++)

{

// unsubscribe client for each topic requested

this.subscriberManager.Unsubscribe(e.Topics[i], client);

}

try

{

// send UNSUBACK message to the client

client.Unsuback(e.MessageId);

}

catch (MqttCommunicationException)

{

this.CloseClient(client);

}

}

void Client_MqttMsgSubscribeReceived(object sender, MqttMsgSubscribeEventArgs e)

{

MqttClient client = (MqttClient)sender;

Console.WriteLine("Subscribe Received");

for (int i = 0; i < e.Topics.Length; i++)

{

// TODO : business logic to grant QoS levels based on some conditions ?

// now the broker granted the QoS levels requested by client

// subscribe client for each topic and QoS level requested

this.subscriberManager.Subscribe(e.Topics[i], e.QoSLevels[i], client);

Console.WriteLine("Topic: " + e.Topics[i]);

}

try

{

// send SUBACK message to the client

client.Suback(e.MessageId, e.QoSLevels);

for (int i = 0; i < e.Topics.Length; i++)

{

// publish retained message on the current subscription

this.publisherManager.PublishRetaind(e.Topics[i], client.ClientId);

}

}

catch (MqttCommunicationException)

{

this.CloseClient(client);

}

}

void Client_MqttMsgConnected(object sender, MqttMsgConnectEventArgs e)

{

// [v3.1.1] session present flag

bool sessionPresent = false;

// [v3.1.1] generated client id for client who provides client id zero bytes length

string clientId = null;

MqttClient client = (MqttClient)sender;

// verify message to determine CONNACK message return code to the client

byte returnCode = this.MqttConnectVerify(e.Message);

// [v3.1.1] if client id is zero length, the broker assigns a unique identifier to it

clientId = (e.Message.ClientId.Length != 0) ? e.Message.ClientId : Guid.NewGuid().ToString();

// connection "could" be accepted

if (returnCode == MqttMsgConnack.CONN_ACCEPTED)

{

// check if there is a client already connected with same client Id

MqttClient clientConnected = this.GetClient(clientId);

// force connection close to the existing client (MQTT protocol)

if (clientConnected != null)

{

this.CloseClient(clientConnected);

}

}

try

{

// connection accepted, load (if exists) client session

if (returnCode == MqttMsgConnack.CONN_ACCEPTED)

{

// check if not clean session and try to recovery a session

if (!e.Message.CleanSession)

{

// create session for the client

MqttClientSession clientSession = new MqttClientSession(clientId);

// get session for the connected client

MqttBrokerSession session = this.sessionManager.GetSession(clientId);

// set inflight queue into the client session

if (session != null)

{

clientSession.InflightMessages = session.InflightMessages;

// [v3.1.1] session present flag

if (client.ProtocolVersion == MqttProtocolVersion.Version_3_1_1)

sessionPresent = true;

}

// send CONNACK message to the client

client.Connack(e.Message, returnCode, clientId, sessionPresent);

// load/inject session to the client

client.LoadSession(clientSession);

if (session != null)

{

// set reference to connected client into the session

session.Client = client;

// there are saved subscriptions

if (session.Subscriptions != null)

{

// register all subscriptions for the connected client

foreach (MqttSubscription subscription in session.Subscriptions)

{

this.subscriberManager.Subscribe(subscription.Topic, subscription.QosLevel, client);

// publish retained message on the current subscription

this.publisherManager.PublishRetaind(subscription.Topic, clientId);

}

}

// there are saved outgoing messages

if (session.OutgoingMessages.Count > 0)

{

// publish outgoing messages for the session

this.publisherManager.PublishSession(session.ClientId);

}

}

}

// requested clean session

else

{

// send CONNACK message to the client

client.Connack(e.Message, returnCode, clientId, sessionPresent);

this.sessionManager.ClearSession(clientId);

}

}

else

{

// send CONNACK message to the client

client.Connack(e.Message, returnCode, clientId, sessionPresent);

}

}

catch (MqttCommunicationException)

{

this.CloseClient(client);

}

}

void Client_MqttMsgDisconnected(object sender, EventArgs e)

{

MqttClient client = (MqttClient)sender;

// close the client

this.CloseClient(client);

}

void Client_ConnectionClosed(object sender, EventArgs e)

{

MqttClient client = (MqttClient)sender;

// close the client

this.CloseClient(client);

}

/// <summary>

/// Check CONNECT message to accept or not the connection request

/// </summary>

/// <param name="connect">CONNECT message received from client</param>

/// <returns>Return code for CONNACK message</returns>

private byte MqttConnectVerify(MqttMsgConnect connect)

{

byte returnCode = MqttMsgConnack.CONN_ACCEPTED;

// unacceptable protocol version

if ((connect.ProtocolVersion != PROTOCOL_VERSION_V3_1) &&

(connect.ProtocolVersion != PROTOCOL_VERSION_V3_1_1))

returnCode = MqttMsgConnack.CONN_REFUSED_PROT_VERS;

else

{

// client id length exceeded (only for old MQTT 3.1)

if ((connect.ProtocolVersion == PROTOCOL_VERSION_V3_1) &&

(connect.ClientId.Length > CLIENT_ID_MAX_LENGTH))

returnCode = MqttMsgConnack.CONN_REFUSED_IDENT_REJECTED;

else

{

// [v.3.1.1] client id zero length is allowed but clean session must be true

if ((connect.ClientId.Length == 0) && (!connect.CleanSession))

returnCode = MqttMsgConnack.CONN_REFUSED_IDENT_REJECTED;

else

{

// check user authentication

if (!this.uacManager.UserAuthentication(connect.Username, connect.Password))

returnCode = MqttMsgConnack.CONN_REFUSED_USERNAME_PASSWORD;

// server unavailable and not authorized ?

else

{

// TODO : other checks on CONNECT message

}

}

}

}

return returnCode;

}

/// <summary>

/// Return reference to a client with a specified Id is already connected

/// </summary>

/// <param name="clientId">Client Id to verify</param>

/// <returns>Reference to client</returns>

private MqttClient GetClient(string clientId)

{

var query = from c in this.clients

where c.ClientId == clientId

select c;

return query.FirstOrDefault();

}

}

}

MainPageSL.cs

using System;

using System.Collections.Generic;

using System.Linq;

using System.Text;

using System.Threading.Tasks;

using uPLibrary.Networking.M2Mqtt;

namespace smart_doorlock_web_server

{

public class MainPageSL

{

MqttBroker mqttBroker = MqttBroker.Instance;

private static readonly MainPageSL _instance = new MainPageSL();

public static MainPageSL Instance

{

get

{

return _instance;

}

}

private MainPageSL() { }

public List<MainPageData> GetMainPageData()

{

List<MainPageData> dataList = new List<MainPageData>();

MqttClientCollection clientList = mqttBroker.GetClientList();

int doorlockNo = 1;

foreach (MqttClient client in clientList) {

MainPageData data = new MainPageData();

data.DoorlockNo = doorlockNo;

data.ClientId = client.ClientId;

data.ProtocolVer = client.ProtocolVersion.ToString();

dataList.Add(data);

doorlockNo++;

}

return dataList;

}

}

}

MainPageData.cs

using System;

using System.Collections.Generic;

using System.Linq;

using System.Text;

using System.Threading.Tasks;

namespace smart_doorlock_web_server

{

public class MainPageData

{

public int DoorlockNo {get; set;}

public string ClientId { get; set; }

public string ProtocolVer { get; set; }

}

}

The following portions are the front-end portion of the server. SuperSimpleViewEngine was used to render the pages. Due to the verbose nature of HTML and excessive tabbing required, the front-end code is a bit difficult to read on this notebook. Referencing the front-end portion of the server code from the source control is recommended.

MainPage.sshtml

@Master['MasterPage']

@Section['Content']

<link href="./Content/css/MainPage.css" rel="stylesheet">

<!-- Begin page content -->

<div class="container">

<div class="page-header">

<h1>Doorlock Status</h1>

</div>

<table id="myTable" class="tablesorter">

<thead>

<tr>

<th>Doorlock No.</th>

<th>Client Id</th>

<th>Protocol Ver.</th>

<th>Status</th>

</tr>

</thead>

<tbody class="centerText">

@Each.Model

<tr>

<td rowspan="3">@Current.DoorlockNo</td>

<td>@Current.ClientId</td>

<td>@Current.ProtocolVer</td>

<td>Active</td>

</tr>

<tr>

<td colspan="2" class="txtInput"><input type="text" id="inputSubscribeTopic@Current.ClientId" class="form-control" id="usr" placeholder="Topic"></td>

<td><button id="btnSubscribe" data-cid="@Current.ClientId" type="button" class="btn btn-success btnStyle">Subscribe</button></td>

</tr>

<tr>

<td class="txtInput"><input id="inputPublishTopic@Current.ClientId" type="text" class="form-control" id="usr" placeholder="Topic" value="/SmartDoorlock/DoorControl"></td>

<td class="txtInput"><input id="inputPublishMessage@Current.ClientId" type="text" class="form-control" id="usr" placeholder="Message" value="Open"></td>

<td><button id="btnPublish" data-cid="@Current.ClientId" type="button" class="btn btn-info btnStyle">Publish</button></td>

</tr>

@EndEach

</tbody>

</table>

<h1>MQTT Log</h1>

<textarea id="mqttLog" readonly class="form-control" rows="15"></textarea>

</div>

<script language="JavaScript" src="/Content/scripts/jquery.tablesorter.js"></script>

<script language="JavaScript" src="/Content/scripts/MainPage.js"></script>

@EndSection

MainPage.css

@media (min-width: 1200px) {

.container{

max-width: 1000px;

}

}

/* tables */

table.tablesorter {

font-family:inherit;

border: 1px solid #CDD2D2;

margin:10px 0pt 15px;

width: 100%;

text-align: center;

}

table.tablesorter thead tr th, table.tablesorter tfoot tr th {

background-color: #e6EEEE;

border: 1px solid #CDD2D2;

padding: 4px;

white-space:nowrap;

width:1%;

}

table.tablesorter thead tr .header {

background-image: url(tblColArrow.gif);

background-repeat: no-repeat;

background-position: center right;

cursor: pointer;

}

table.tablesorter tbody td {

color: #3D3D3D;

padding: 4px;

background-color: #FFF;

vertical-align: middle;

border: 1px solid #CDD2D2;

white-space:nowrap;

width:0;

}

table.tablesorter thead tr .headerSortUp {

background-image: url(tblColAsc.gif);

}

table.tablesorter thead tr .headerSortDown {

background-image: url(tblColDesc.gif);

}

table.tablesorter thead tr .headerSortDown, table.tablesorter thead tr .headerSortUp {

background-color: #8dbdd8;

}

table.tablesorter .winrateheader {

min-width: 180px;

}

.txtInput {

min-width: 180px;

}

.btnStyle {

width: 100px;

}

.leftText {

text-align: left !important;

}

MasterPage.sshtml

<!DOCTYPE html>

<html xmlns="http://www.w3.org/1999/xhtml">

<head>

<title>Smart Doorlock</title>

<link href="/Content/css/MasterPage.css" rel="stylesheet">

<link href="https://maxcdn.bootstrapcdn.com/bootstrap/3.3.6/css/bootstrap.min.css" rel="stylesheet">

<script src="https://code.jquery.com/jquery-2.2.4.min.js" integrity="sha256-BbhdlvQf/xTY9gja0Dq3HiwQF8LaCRTXxZKRutelT44=" crossorigin="anonymous"></script>

<script src="https://maxcdn.bootstrapcdn.com/bootstrap/3.3.6/js/bootstrap.min.js"></script>

</head>

<body>

<nav class="navbar navbar-default navbar-fixed-top">

<div class="container">

<div class="navbar-header">

<a class="navbar-brand" href="/">Smart Doorlock</a>

</div>

<div id="navbar" class="navbar-collapse collapse">

<ul class="nav navbar-nav">

<!--<li class="active"><a href="/">Home</a></li>-->

<li><a href="/">Home</a></li>

<li><a href="/About">About</a></li>

<li><a href="/Log">Log</a></li>

</ul>

</div>

</div>

</nav>

<!-- Wrap all page content here -->

<div id="wrap">

@Section['Content']

</div>

<div id="footer">

<div class="container">

<p class="text-muted">(C) 2016 Sokwhan Huh.</p>

</div>

</div>

</body>

</html>

MasterPage.css

body {

margin-bottom: 60px;

}

body > .container {

padding: 60px 15px 0;

}

.container .text-muted {

margin: 20px 0;

}

/* Sticky footer styles

-------------------------------------------------- */

html,

body {

height: 100%;

overflow: hidden;

/* The html and body elements cannot have any padding or margin. */

}

/* Wrapper for page content to push down footer */

#wrap {

height: calc(100% - 120px);

overflow-y: scroll;

padding: 0px 10%;

margin-top: 60px;

}

/* Set the fixed height of the footer here */

#footer {

height: 60px;

background-color: #f5f5f5;

position: fixed;

bottom: 0;

width: 100%;

}

MainPage.js

function appendToLog(txt) {

var log = $("#mqttLog");

log.val(log.val() + txt + "\n");

}

$(document).ready(function () {

$("#myTable").tablesorter();

$("#btnSubscribe").click(function () {

var btnElement = $(this);

var clientId = btnElement.attr("data-cid");

var txtElement = $("#inputSubscribe" + clientId);

var data = { "clientId": clientId, "topic": txtElement.val() }

$.ajax({

type: "POST",

url: "/Subscribe",

data: data,

success: function (data) { alert(data); },

dataType: "json"

});

});

$("#btnPublish").click(function () {

var btnElement = $(this);

var clientId = btnElement.attr("data-cid");

var txtTopic = $("#inputPublishTopic" + clientId);

var txtMessage = $("#inputPublishMessage" + clientId);

var data = { "clientId": clientId, "topic": txtTopic.val(), "message": txtMessage.val() }

$.ajax({

type: "POST",

url: "/Publish",

data: data,

dataType: "json"

});

appendToLog("Published to topic: " + txtTopic.val() + ", message: " + txtMessage.val())

});

});

# September 28th, 2016

The solenoid motor that will be used for this project requires 12V @ 550mA upon activation. This is slightly problematic for two reasons. 1) Rest of the circuitry in this project uses 5V, 3.3V. 2) Without the solenoid, the expected average current draw is about 400~500mA. With the solenoid, this adds up to approximately 1A of maximum current draw. This means that I will have to find a good power supply that not only provides voltage for all 3.3V, 5V and 12V, but the power supply will also have to supply a fair amount of current (say, 2A). After inquiring Dr. Barrett about this problem, he recommended some very good power supplies with dual voltage outputs (5V, 12V). This only requires me to use a single 3.3V linear regulator to step the 5V down to 3.3V. Dr. Barrett also recommended me some very good components to go along with the power supply, such as AC receptacle, chrome bezel LED indicator, fuse holder etc. and a method to mount the power supply to my chassis – something I haven’t given too much thought about. There is one more concern I have regarding the project – that is, it has a requirement of operating under a backup battery. I still haven’t found a good solution for this, mostly due to the high voltage requirement and a large current consumption. Car batteries for 12V @ 2A do exist, but these are way too big for this project (After all, this is a doorlock. It does have a practical size limitation).

The following is a list of items I was planning to place on order: Lock-style Solenoid - 12VDC, 1N4001 Diode - 10 pack, TIP120 Power Darlington Transistors - 3 pack, Molex 2695 Series 10-Position Mating Connector, Molex 6373 Series 10-Position Male-Pin Connector, AC/DC CONVERTER 5V 12V 30W, Fuseholder Panel Mount D Type .25" X1.25" Fuse Solder Terminal, 8-Foot 3-Conductor SJT Detachable AC Power Cord, Toggle Switch Full Single Pole Single Throw (On-Off) 6.0 Inch Wire 125VAC @ 6 Amp 1/2 Inch Mounting, Receptacle Male 10A@250VoltFused Fast-On UL/CSA/Vde, Led Indicator Chrome Bezel 2.0Vf@20mA 0.24" Diameter. After inquiring George – our master technician about these components, it turned out that the shop already had majority of these components at hand so I ended up only placing order on solenoid, molex connectors and AC/DC power supply.

# September 30th, 2016

I’ve finally borrowed a spectrum analyzer from Dr. Kubichek to confirm whether my NFC reader (TRF7970A) actually works or not.

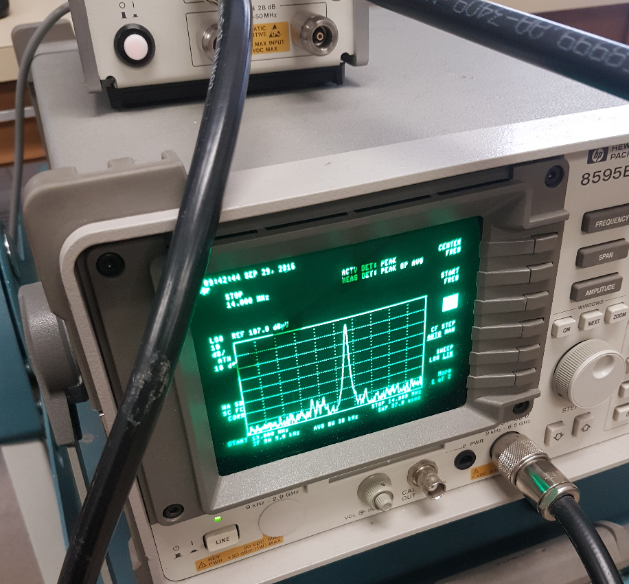
[picture p28: figure]

Much to my surprise, when I’ve powered on the spectrum analyzer and brought the antenna close to TRF7970A, I was getting a clear reading – indicating that the NFC reader is actually transmitting something.

This shows that the NFC reader is likely not defective and the code, at least for generating RF field, is correct. This definitely narrowed down places to look on getting this reader to work.

I’ve decided to test every single pin of the NFC reader (at least for those pins that are possible) by hooking them up into GPIO pins.

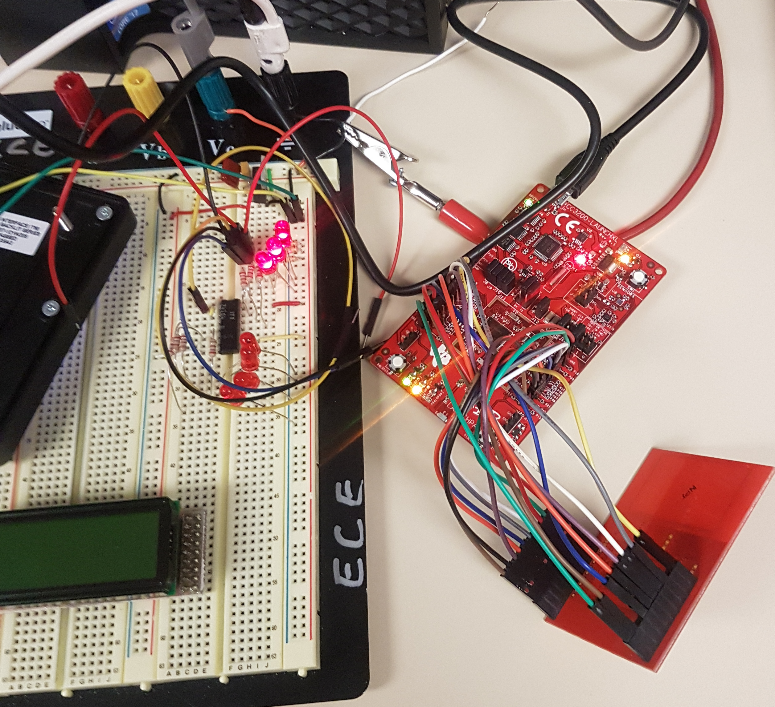
[picture p29: figure]

I was able to determine that due to the hardware update of TRF7970A, the boosterpack can no longer be just inserted on top of the CC3200 launchpad – one of the pin is no longer compatible. But there was one more bizzare issue – CC3200 would not be handling interrupts coming from TRF7970A. Even manually toggling the interrupt by short circuiting between 3.3V and ground would not toggle the interrupt. After investigating this issue, it turned out that there was a critical issue with the latest CC3200 Launchpad (Rev 4.5) that would cause the microcontroller to not handle interrupts under a very specific circumstance. Using certain semaphore commands with TI-RTOS, causes all interrupt handling to halt on the CC3200. A hotfix was released for this on September 9th, 2016 with a service pack, of which the MCU image needed flashing in order to rectify this issue.

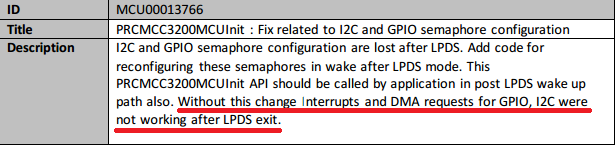
[picture p30: figure]

After flashing the MCU, the NFC reader started to work properly. This probably caused me to waste a good 3 months in trying to interface the NFC reader.

I’m genuinely shocked that TI would release an untested software (hardware?) on the market. Had TI not release this service pack soon enough, it definitely jeopardized my entire project, likely forcing me spend a great deal of time trying to figure out what’s going on, until I actually start looking for a different NFC reader. Part of this ordeal is from my own fault – I didn’t spend enough time investigating whether there has been a major hardware update, with completely different pin configurations. But to my knowledge, there’s literally no way a typical consumer can figure out in advance whether a required component would work or not.

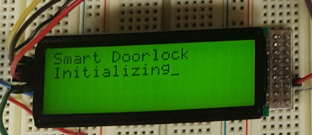
[picture p31: figure]

Another work that was done today is with regards to the LCD. Because the LCD pins were too close to each other (0.7mm apart) for it to be connected on the breadboard, and pins were also too thin for jumper cables, I’ve requested for an adapter board to be made. Vic and George were very helpful (in fact, I couldn’t have done this without them) in creating this adapter board. Interfacing the LCD (with slight modification to the earlier LCD code) worked well.

lcd.c

/*

* lcd.c

*

* Created on: Sep 23, 2016

* Author: shuh

*/

#include "lcd.h"

// Driverlib includes

#include "rom_map.h"

#include "hw_memmap.h"

#include "hw_types.h"

#include "prcm.h"

#include "simplelink.h"

// Common interface include

#include "spi.h"

// Project Includes

#include "spi_l.h"

#define CMD_START_BIT 0xF8 //5 1s for start bit

#define CMD_RW 2

#define CMD_RS 1

#define CMD_DATA_SHIFT_BIT 4

#define LCD_HOME_L1 0x80

unsigned long ulDummy;

static unsigned char reverse(unsigned char b) {

b = (b & 0xF0) >> 4 | (b & 0x0F) << 4;

b = (b & 0xCC) >> 2 | (b & 0x33) << 2;

b = (b & 0xAA) >> 1 | (b & 0x55) << 1;

return b;

}

void lcdCheckBusy(void) {

unsigned char command = CMD_START_BIT;

unsigned char isBusy = 1;

command |= (1 << CMD_RW) | (0 << CMD_RS);

do {

SPI_LCD_CS_ON;

MAP_SPIDataPut(GSPI_BASE,command);

MAP_SPIDataGet(GSPI_BASE,&ulDummy);

isBusy = (char)ulDummy;

SPI_LCD_CS_OFF;

}

while (isBusy & 0x01 > 0);

}

static void lcdSPIPutData(unsigned char spiData) {

//SPI Data Protocol (Weirdest crap I've ever seen in my life when it comes to SPI)

//First, 5 start bytes are transferred (Handled in lcdputcommand).

//Then, a byte of data is sent into two chunks. To be specific,

//(4 Lower Bit + 0000) then (4 Upper Bit + 0000), LSB first

//http://www.lcd-module.de/fileadmin/eng/pdf/zubehoer/ssd1803_2.0.pdf

//The level of confusion is LEGENDARY

unsigned char reversedData = reverse(spiData);

//Get lower 4 bits (Since bit was reversed, we actually do and operation on upper 4 bit)

unsigned char lowerData = reversedData & 0xF0;

MAP_SPIDataPut(GSPI_BASE,lowerData);

MAP_SPIDataGet(GSPI_BASE,&ulDummy);

//Get upper 4 bits

unsigned char upperData = (reversedData & 0x0F) << CMD_DATA_SHIFT_BIT;

MAP_SPIDataPut(GSPI_BASE,upperData);

MAP_SPIDataGet(GSPI_BASE,&ulDummy);

}

static void lcdPutCommand(lcdCommandEnum cmdType) {

unsigned char command = CMD_START_BIT;

command |= (0 << CMD_RW) | (0 << CMD_RS);

switch (cmdType) {

case CLEAR_SCREEN:

SPI_LCD_CS_ON;

MAP_SPIDataPut(GSPI_BASE,command);

MAP_SPIDataGet(GSPI_BASE,&ulDummy);

lcdSPIPutData(0x01);

SPI_LCD_CS_OFF;

break;

case DISPLAY_ON:

SPI_LCD_CS_ON;

MAP_SPIDataPut(GSPI_BASE,command);

MAP_SPIDataGet(GSPI_BASE,&ulDummy);

//Display on command

lcdSPIPutData(0x0F);

//lcdSPIPutData(0x0C);

SPI_LCD_CS_OFF;

break;

case LCD_INIT:

SPI_LCD_CS_ON;

MAP_SPIDataPut(GSPI_BASE,command);

MAP_SPIDataGet(GSPI_BASE,&ulDummy);

//8-Bit, RE=1

lcdSPIPutData(0x34);

SPI_LCD_CS_OFF;

osi_Sleep(2);

SPI_LCD_CS_ON;

MAP_SPIDataPut(GSPI_BASE,command);

MAP_SPIDataGet(GSPI_BASE,&ulDummy);

//4 Line Mode

lcdSPIPutData(0x09);

SPI_LCD_CS_OFF;

osi_Sleep(2);

SPI_LCD_CS_ON;

MAP_SPIDataPut(GSPI_BASE,command);

MAP_SPIDataGet(GSPI_BASE,&ulDummy);

//8-Bit, RE=0

lcdSPIPutData(0x30);

SPI_LCD_CS_OFF;

break;

case RETURN_HOME:

SPI_LCD_CS_ON;

MAP_SPIDataPut(GSPI_BASE,command);

MAP_SPIDataGet(GSPI_BASE,&ulDummy);

//Return home

lcdSPIPutData(0x06);

SPI_LCD_CS_OFF;

break;

}

}

void lcdSetPosition(unsigned char position) {

lcdCheckBusy();

SPI_LCD_CS_ON;

unsigned char command = CMD_START_BIT;

MAP_SPIDataPut(GSPI_BASE,command);

MAP_SPIDataGet(GSPI_BASE,&ulDummy);

lcdSPIPutData(LCD_HOME_L1 + position);

SPI_LCD_CS_OFF;

}

void lcdClearScreen(void) {

lcdPutCommand(CLEAR_SCREEN);

lcdPutCommand(RETURN_HOME);

osi_Sleep(2);

}

void lcdInit(void) {

lcdPutCommand(LCD_INIT);

osi_Sleep(2);

}

void lcdReset(void) {

//Reset LCD

GPIO_IF_Set(13,0);

osi_Sleep(50);

GPIO_IF_Set(13,1);

}

void lcdDisplayOn(void) {

lcdPutCommand(DISPLAY_ON);

osi_Sleep(2);

}

void lcdPutChar(unsigned char lcdChar) {

//RW = 0

//RS = 1

SPI_LCD_CS_ON;

unsigned char command = CMD_START_BIT;

command |= (0 << CMD_RW) | (1 << CMD_RS);

MAP_SPIDataPut(GSPI_BASE,command);

MAP_SPIDataGet(GSPI_BASE,&ulDummy);

lcdSPIPutData(lcdChar);

SPI_LCD_CS_OFF;

}

void lcdPutString(unsigned char* str) {

do

{

lcdCheckBusy();

lcdPutChar(*str++);

}

while(*str);

}

lcd.h

/*

* lcd.h

*

* Created on: Sep 23, 2016

* Author: shuh

*/

#ifndef LCD_H_

#define LCD_H_

#define LCD_LINE1 0

#define LCD_LINE2 LCD_LINE1+0x20

#define LCD_LINE3 LCD_LINE1+0x40

#define LCD_LINE4 LCD_LINE1+0x60

typedef enum

{

LCD_INIT,

DISPLAY_ON,

CLEAR_SCREEN,

RETURN_HOME

} lcdCommandEnum;

extern void lcdInit();

extern void lcdReset();

extern void lcdDisplayOn();

extern void lcdClearScreen(void);

extern void lcdPutString(unsigned char* str);

extern void lcdPutChar(unsigned char lcdChar);

extern void lcdSetPosition(unsigned char position);

#endif /* LCD_H_ */

spi_l.c

/*

* spi.c

*

* Created on: Sep 30, 2016

* Author: shuh

*/

//Driver Lib Includes

#include "rom_map.h"

#include "hw_memmap.h"

#include "hw_types.h"

#include "prcm.h"

// Project Includes

#include "spi_l.h"

void SPIInit(void) {

MAP_PRCMPeripheralReset(PRCM_GSPI);

// Reset SPI

MAP_SPIReset(GSPI_BASE);

// Configure SPI interface

//SPI_SUB_MODE_1 = [POL = 0, PHA = 1]

MAP_SPIConfigSetExpClk(GSPI_BASE,MAP_PRCMPeripheralClockGet(PRCM_GSPI),

SPI_IF_BIT_RATE,SPI_MODE_MASTER,SPI_SUB_MODE_1,

(SPI_SW_CTRL_CS |

SPI_4PIN_MODE |

SPI_TURBO_OFF |

SPI_CS_ACTIVELOW |

SPI_WL_8));

// Enable SPI for communication

MAP_SPIEnable(GSPI_BASE);

}

spi_l.h

/*

* spi.h

*

* Created on: Sep 30, 2016

* Author: shuh

*/

#ifndef SPI_L_H_

#define SPI_L_H_

//Common Interface Includes

#include "spi.h"

#include "gpio_if.h"

//#define SPI_IF_BIT_RATE 2000000

#define SPI_IF_BIT_RATE 2000000

#define SPI_TRF_CS_ON MAP_SPICSEnable(GSPI_BASE);

#define SPI_TRF_CS_OFF MAP_SPICSDisable(GSPI_BASE);

#define SPI_LCD_CS_ON GPIO_IF_Set(10,0);

#define SPI_LCD_CS_OFF GPIO_IF_Set(10,1);

extern void SPIInit(void);

#endif /* SPI_L_H_ */

NDEF.c

/* {NDEF.c}

*

* {NDEF specific functions file}

**

*/

#include "hw_types.h"

#include "NDEF.h"

#include "timer.h"

#include "timer_if.h"

#include "trf7970.h"

#include "trf7970BoosterPack.h"

#include "hw_types.h"

#include "uart_if.h"

#include "utils.h"

#include "gpio.h"

#include "gpio_if.h"

#include "hw_memmap.h"

#include "uart_if.h"

#include "utils.h"

//===============================================================

extern u08_t buf[140];

extern u08_t i_reg;

extern u08_t irq_flag;

extern u08_t stand_alone_flag;

extern s08_t rxtx_state;

extern u08_t rx_error_flag;

//===============================================================

unsigned char NDEFApplicationSelect(void)

{

u08_t NDEF_Support = 0;

rx_error_flag = 0x00;

buf[0] = 0x8f;

buf[1] = 0x91;

buf[2] = 0x3d;

buf[3] = 0x00;

buf[4] = 0xE0; // length

buf[5] = 0x02;

buf[6] = 0x00;

buf[7] = 0xA4;

buf[8] = 0x04;

buf[9] = 0x00;

buf[10] = 0x07;

buf[11] = 0xD2;

buf[12] = 0x76;

buf[13] = 0x00;

buf[14] = 0x00;

buf[15] = 0x85;

buf[16] = 0x01;

buf[17] = 0x01;

buf[18] = 0x00;

Trf7970RawWrite(&buf[0], 19); //writing to FIFO

//Trf7970ResetIrqStatus();

IRQ_ON;

i_reg = 0x01;

rxtx_state = 0; /* the response will be stored in buf[0] upwards */

// COUNT_VALUE = COUNT_1ms * 20; /* 10ms for TIMEOUT */

A2CounterLoad(COUNT_1ms * 20);

START_COUNTER; /* start timer up mode */

while(i_reg == 0x01); // Wait for end of TX

i_reg = 0x01;

RESET_COUNTER;

// COUNT_VALUE = COUNT_1ms * 20; /* 10ms for TIMEOUT */

A2CounterLoad(COUNT_1ms * 20);

START_COUNTER; /* start timer up mode */

while(i_reg == 0x01); /* wait for RX complete */

if( (buf[1] == 0x90) && (buf[2] == 0x00)){

NDEF_Support = 1;

}

RESET_COUNTER;

Trf7970ResetIrqStatus();

McuDelayMillisecond(1);

return NDEF_Support;

}

void CapabilityContainerSelect(void)

{

rx_error_flag = 0x00;

buf[0] = 0x8f;

buf[1] = 0x91;

buf[2] = 0x3d;

buf[3] = 0x00;

buf[4] = 0x80; // length

buf[5] = 0x03;

buf[6] = 0x00;

buf[7] = 0xA4;

buf[8] = 0x00;

buf[9] = 0x0C;

buf[10] = 0x02;

buf[11] = 0xE1;

buf[12] = 0x03;

Trf7970RawWrite(&buf[0], 13);

IRQ_CLR; // PORT2 interrupt flag clear (inside MSP430)

IRQ_ON;

i_reg = 0x01;

rxtx_state = 0; /* the response will be stored in buf[0] upwards */

//COUNT_VALUE = COUNT_1ms * 20; /* 10ms for TIMEOUT */

A2CounterLoad(COUNT_1ms * 20);

START_COUNTER; /* start timer up mode */

while(i_reg == 0x01); // Wait for end of TX

i_reg = 0x01;

RESET_COUNTER;

A2CounterLoad(COUNT_1ms * 20);

// COUNT_VALUE = COUNT_1ms * 20; /* 10ms for TIMEOUT */

START_COUNTER; /* start timer up mode */

while(i_reg == 0x01); /* wait for RX complete */

Trf7970ResetIrqStatus();

//stopCounter;

McuDelayMillisecond(1);

}

unsigned char ReadBinary(unsigned char Offset, unsigned char Read_Length)

{

/*~~~~~~~~~~~~~~~~~~~~~~~~~~~~~~~~~~~~~~~~~~~~~~*/

unsigned char Nlen=0;

// extern unsigned char Tag_found;

/*~~~~~~~~~~~~~~~~~~~~~~~~~~~~~~~~~~~~~~~~~~~~~~*/

rx_error_flag = 0x00;

buf[0] = 0x8f;

buf[1] = 0x91;

buf[2] = 0x3d;

buf[3] = 0x00;

buf[4] = 0x60; // length

buf[5] = 0x02;

buf[6] = 0x00;

buf[7] = 0xB0;

buf[8] = 0x00;

buf[9] = Offset; // offset

buf[10] = Read_Length; // Read Length

Trf7970RawWrite(&buf[0], 11);

Trf7970ResetIrqStatus();

IRQ_ON;

i_reg = 0x01;

rxtx_state = 0; /* the response will be stored in buf[0] upwards */

//COUNT_VALUE = COUNT_1ms * 20;

A2CounterLoad(COUNT_1ms * 20);

START_COUNTER; /* start timer up mode */

while(i_reg == 0x01); // Wait for end of TX

i_reg = 0x01;

RESET_COUNTER;

A2CounterLoad(COUNT_1ms * 20);

// COUNT_VALUE = COUNT_1ms * 20; /* 10ms for TIMEOUT */

START_COUNTER; /* start timer up mode */

while(i_reg == 0x01); /* wait for RX complete */

RESET_COUNTER;

//Trf7970ResetIrqStatus();

// might need test case here, like if(i_reg == 0xFF)

Nlen = buf[2];

McuDelayMillisecond(1);

return Nlen;

}

unsigned char ReadBinary2(unsigned char Offset, unsigned char Read_Length)

{

/*~~~~~~~~~~~~~~~~~~~~~~~~~~~~~~~~~~~~~~~~~~~~~~*/

unsigned char Nlen=0;

// extern unsigned char Tag_found;

/*~~~~~~~~~~~~~~~~~~~~~~~~~~~~~~~~~~~~~~~~~~~~~~*/

rx_error_flag = 0x00;

buf[0] = 0x8f;

buf[1] = 0x91;

buf[2] = 0x3d;

buf[3] = 0x00;

buf[4] = 0x60; // length

buf[5] = 0x03;

buf[6] = 0x00;

buf[7] = 0xB0;

buf[8] = 0x00;

buf[9] = Offset; // offset

buf[10] = Read_Length; // Read Length

Trf7970RawWrite(&buf[0], 11);

Trf7970ResetIrqStatus();

IRQ_ON;

i_reg = 0x01;

rxtx_state = 0; /* the response will be stored in buf[0] upwards */

//COUNT_VALUE = COUNT_1ms * 20;

A2CounterLoad(COUNT_1ms * 20);

START_COUNTER; /* start timer up mode */

while(i_reg == 0x01); // Wait for end of TX

i_reg = 0x01;

RESET_COUNTER;

// COUNT_VALUE = COUNT_1ms * 20; /* 10ms for TIMEOUT */

A2CounterLoad(COUNT_1ms * 20);

START_COUNTER; /* start timer up mode */

while(i_reg == 0x01); /* wait for RX complete */

RESET_COUNTER;

//Trf7970ResetIrqStatus();

// might need test case here, like if(i_reg == 0xFF)

Nlen = buf[2];

McuDelayMillisecond(1);

return Nlen;

}

void SelectNDEF(void)

{

rx_error_flag = 0x00;

buf[0] = 0x8f;

buf[1] = 0x91;

buf[2] = 0x3d;

buf[3] = 0x00;

buf[4] = 0x80; // length

buf[5] = 0x03;

buf[6] = 0x00;

buf[7] = 0xA4;

buf[8] = 0x00;

buf[9] = 0x0C;

buf[10] = 0x02;

buf[11] = 0xE1;

buf[12] = 0x04;

Trf7970RawWrite(&buf[0], 13);

Trf7970ResetIrqStatus();

IRQ_ON;

i_reg = 0x01;

rxtx_state = 0; /* the response will be stored in buf[0] upwards */

// COUNT_VALUE = COUNT_1ms * 20;

A2CounterLoad(COUNT_1ms * 20);

START_COUNTER; /* start timer up mode */

while(i_reg == 0x01); // Wait for end of TX

i_reg = 0x01;

RESET_COUNTER;

// COUNT_VALUE = COUNT_1ms * 20; /* 10ms for TIMEOUT */

A2CounterLoad(COUNT_1ms * 20);

START_COUNTER; /* start timer up mode */

while(i_reg == 0x01); /* wait for RX complete */

Trf7970ResetIrqStatus();

RESET_COUNTER;

McuDelayMillisecond(1);

}

void RATS(void)

{

u08_t write[4];

rx_error_flag = 0x00;

write[0] = ISO_CONTROL;

write[1] = 0x08;

Trf7970WriteSingle(write, 2);

buf[0] = 0x8f;

buf[1] = 0x91;

buf[2] = 0x3d;

buf[3] = 0x00;

buf[4] = 0x20; // length

buf[5] = 0xE0;

buf[6] = 0x80;

Trf7970RawWrite(&buf[0], 7);

Trf7970ResetIrqStatus();

IRQ_ON;

i_reg = 0x01;

rxtx_state = 0; /* the response will be stored in buf[0] upwards */

// COUNT_VALUE = COUNT_1ms * 20;

A2CounterLoad(COUNT_1ms * 20);

START_COUNTER; /* start timer up mode */

while(i_reg == 0x01); // Wait for end of TX

i_reg = 0x01;

RESET_COUNTER;

// COUNT_VALUE = COUNT_1ms * 20; /* 10ms for TIMEOUT */

A2CounterLoad(COUNT_1ms * 20);

START_COUNTER; /* start timer up mode */

while(i_reg == 0x01); /* wait for RX complete */

Trf7970ResetIrqStatus();

RESET_COUNTER;

McuDelayMillisecond(1);

}

NDEF.h

/*

* {NDEF.h}

*

* {NDEF header file}

*

*/

#ifndef _NDEF_H_

#define _NDEF_H_

//===============================================================

//#include <MSP430x23x0.h> // processor specific header

//#include <stdio.h> // standard input/output header

#include "trf7970.h"

#include "types.h"

//===============================================================

//void Attrib(void);

void RATS(void);

unsigned char NDEFApplicationSelect(void);

void CapabilityContainerSelect(void);

unsigned char ReadBinary(unsigned char Offset, unsigned char Read_Length);

unsigned char ReadBinary2(unsigned char Offset, unsigned char Read_Length);

void SelectNDEF(void);

//===============================================================

#endif

iso15693.c

/*

* {iso15693.c}

*

* {ISO15693 Specific Functions & Anti-collision}

*

*/

#include "hw_types.h"

#include <string.h>

#include <stdio.h>

#include "iso15693.h"

#include "uart_if.h"

#include "timer.h"

#include "timer_if.h"

#include "trf7970BoosterPack.h"

#include "utils.h"

#include "gpio.h"

#include "gpio_if.h"

#include "hw_memmap.h"

#include "uart_if.h"

#define UART_PRINT Report

//===============================================================

u08_t afi = 0;

extern u08_t flags = 0; // request flags used in command, based on ISO15693-3, tables 3, 4 and 5

extern u08_t blocknum = 0;// for making block number dynamic (somewhat at this time :))

extern u08_t buf[300];

extern u08_t i_reg;

extern u08_t irq_flag;

extern s08_t rxtx_state;

extern u08_t rx_error_flag;

extern u08_t stand_alone_flag;

extern u08_t remote_flag;

extern u08_t Tag_Count;

extern u08_t g_uid[300];

extern char g_block_content[200];

extern char g_tag_content[600];

extern u08_t g_rssi[10];

extern u08_t g_tag_found;

//===============================================================

// NAME: void Iso15693FindTag(void)

//

// BRIEF: Is used to detect ISO15693 conform tags in stand alone

// mode.

//

// INPUTS:

//

// OUTPUTS:

//

// PROCESS: [1] turn on RF driver

// [2] do a complete anti-collision sequence

// [3] turn off RF driver

//

// NOTE: If ISO15693 conform Tag is detected, ISO15693 LED will

// be turned on.

//

// CHANGE:

// DATE WHO DETAIL

// 23Nov2010 RP Original Code

//===============================================================

void Iso15693FindTag(void) {

Trf7970TurnRfOn();

Trf7970WriteIsoControl(0x02);

// The VCD should wait at least 1 ms after it activated the

// powering field before sending the first request, to

// ensure that the VICCs are ready to receive it. (ISO15693-3)

McuDelayMillisecond(6);

flags = SIXTEEN_SLOTS;

//flags = ONE_SLOT;

buf[20] = 0x00;

Iso15693Anticollision(&buf[20], 0x00); // send Inventory request

Trf7970TurnRfOff();

// clear any IRQs

Trf7970ResetIrqStatus();

}

//===============================================================

// NAME: void NFC_TYPEV_READ_SINGLE_BLOCK(void)

//

// BRIEF: Is used to issue optional ISO15693 command: Read Single Block

// Function: Reads a single block of ISO15693 tag memory and loops, incrementing the block number each time.

//

// INPUTS: request flags, block # (in this case default request flags are 0x02, block # starts a 0x00)

//

// OUTPUTS: Block Data, from 0x00 to 0x3F (256 bytes of data) or to the point where error flags are returned (for tags smaller than 256 bytes, i.e. HF-I Pro or Standard)

//

// PROCESS: [1] turn on RF driver

// [2] do a complete read single block sequence (Command Code 0x20)

// [3] turn off RF driver

// [4] loop until block 0x3F is read or error flags are returned in response (see note in INPUTS section)

////

// CHANGE:

// DATE WHO DETAIL

// 01/17/2014 JDW / JC Original Code

//===============================================================

void NFC_TYPEV_READ_SINGLE_BLOCK(u08_t ui8StartBlock) {

u16_t k;

Trf7970TurnRfOn();

Trf7970WriteIsoControl(0x02);

// The VCD should wait at least 2mSec after activating the

// magnetic field before sending the first request, to

// ensure that the VICC is ready to receive it. (ISO15693-3)

rxtx_state = 1; //resetting buffer pointer

McuDelayMillisecond(6); //plenty of time :)

flags = SSC_HTDR_NA; //non-addressed request flags

// flags = SSC_HTDR_ADDR; //addressed (requires getting and storing UID first)

buf[0] = 0x8F; //reset FIFO

buf[1] = 0x91; // sending with CRC, means TRF79xx will append CRC to string going out over the air

buf[2] = 0x3D; // write continuous from 1D

buf[3] = 0x00; //upper and middle nibbles of transmit byte length

buf[4] = 0x30; //lower and broken nibbles of transmit byte length

buf[5] = flags; // ISO15693 flags

buf[6] = 0x20; // Read Single Block command code

buf[7] = ui8StartBlock; // Block # (variable, for HF-I Plus device can go to 0x3F, Pro and Standard handled with "error" response flags)

Trf7970ResetIrqStatus(); //clearing IRQ (just in case)

A2CounterLoad(COUNT_1ms * 30); // TimerA set 30ms, not 20ms

IRQ_CLR; // PORT2 interrupt flag clear (inside MSP430)

IRQ_ON;

Trf7970RawWrite(&buf[0], 8); //issuing the Read Single Block command

i_reg = 0x01;

irq_flag = 0x00;

START_COUNTER; // Starting Timeout

while (irq_flag == 0x00) {

} // wait for end of TX interrupt

RESET_COUNTER;

A2CounterLoad(COUNT_1ms * 20); // TimerA set

START_COUNTER; // start timer up mode

irq_flag = 0x00;

while (irq_flag == 0x00) {

} // wait for interrupt

RESET_COUNTER;

while (i_reg == 0x01) // wait for RX complete

{

k++;

if (k == 0xFFF0) {

i_reg = 0x00;

rx_error_flag = 0x00;

}

}

if (i_reg == 0xFF) { // if received block data in buffer

if ((stand_alone_flag == 1) && (buf[1] == 0x00)) // Confirming "no error" in response flags byte // Confirming "no error" in response flags byte

{

//Sergey, printing the content of vlovk into global block_content variable

int cx;

cx = snprintf(g_block_content, 300, "%s", "NFC-V Block ");

cx = cx + snprintf(g_block_content+cx, sizeof(g_block_content)-cx, "%x", (ui8StartBlock >> 4) & 0x0F );

cx = cx + snprintf(g_block_content+cx, sizeof(g_block_content)-cx, "%x", ui8StartBlock & 0x0F );

cx = cx + snprintf(g_block_content+cx, sizeof(g_block_content)-cx, "%s", " Data: [" );

int i;

for (i = 2; i < 6; i++) {

cx = cx + snprintf(g_block_content+cx, sizeof(g_block_content)-cx, "%x", (buf[i] >> 4) & 0x0F );

cx = cx + snprintf(g_block_content+cx, sizeof(g_block_content)-cx, "%x", buf[i] & 0x0F );

}

snprintf(g_block_content+cx, sizeof(g_block_content)-cx, "%s", "]\n" );

rxtx_state = 1; //resetting buffer pointer

}

}

Trf7970TurnRfOff();

// clear any IRQs

Trf7970ResetIrqStatus();

}

//===============================================================

// NAME: void Iso15693ReadMultipleBlocks(void)

//

// BRIEF: Is used to issue optional ISO15693 command: Read Multiple Blocks

// Function: Reads multiple blocks of ISO15693 tag memory.

//

// INPUTS: request flags, block # (in this case default request flags are 0x02, starting block # is 0x00, reading 8 blocks of data)

//

// OUTPUTS: Block Data

//

// PROCESS: [1] turn on RF driver

// [2] do a complete read multiple blocks sequence (Command Code 0x23)

// [3] turn off RF driver

//

//

// CHANGE:

// DATE WHO DETAIL

// 01/17/2014 JDW Original Code

//===============================================================

void Iso15693ReadMultipleBlocks_0_18(void) //only use for 2k bit tag

{

u16_t k;

Trf7970TurnRfOn();

Trf7970WriteIsoControl(0x02);

// The VCD should wait at least 2mSec after activating the

// magnetic field before sending the first request, to

// ensure that the VICC is ready to receive it. (ISO15693-3)

McuDelayMillisecond(6); //plenty of time :)

flags = SSC_HTDR_NA; //non-addressed

// flags = SSC_HTDR_ADDR; //addressed (requires getting and storing UID first)

buf[0] = 0x8F; //reset FIFO

buf[1] = 0x91;// sending with CRC, means TRF79xx will append CRC to string going out over the air

buf[2] = 0x3D; // write continuous from 1D

buf[3] = 0x00; // upper and middle nibbles of transmit byte length

buf[4] = 0x40; // lower and broken nibbles of transmit byte length

buf[5] = flags; // ISO15693 flags

buf[6] = 0x23; // Read Multiple Blocks command code

buf[7] = 0x00; // starting block # (hardcoded for now)

buf[8] = 0x18;// # of blocks (0x18 = 25 blocks, hardcoded for now, see comment on 26th block )

Trf7970ResetIrqStatus(); //clearing IRQ (just in case)

A2CounterLoad(COUNT_1ms * 30); // TimerA set 30ms, not 20ms

IRQ_CLR; // PORT2 interrupt flag clear (inside MSP430)

IRQ_ON;

Trf7970RawWrite(&buf[0], 9); //issuing the Read Multiple Blocks command

i_reg = 0x01;

irq_flag = 0x00;

START_COUNTER; //Starting Timeout

while (irq_flag == 0x00) {

} // wait for end of TX interrupt

RESET_COUNTER;

// COUNT_VALUE = COUNT_1ms * 250;

A2CounterLoad(COUNT_1ms * 250); // TimerA set

START_COUNTER; // start timer up mode

irq_flag = 0x00;

while (irq_flag == 0x00) {

} // wait for interrupt

RESET_COUNTER;

while (i_reg == 0x01) // wait for RX complete

{

k++;

if (k == 0xFFF0) {

i_reg = 0x00;

rx_error_flag = 0x00;

}

}

if (i_reg == 0xFF) { // if received block data in buffer

if (stand_alone_flag == 1) {

//found = 1;

#ifdef ENABLE_HOST

/*

//Tag_Count++;

UartPutChar('[');

UartSendCString("Now reading 9 data blocks, data is rotated");

UartPutChar(']');

UartPutCrlf();

UartSendCString("BLOCK 00: ");

//for(i = 5; i > 1; i--) //is 4 bytes of block data as it comes in

for (i = 2; i < 6; i++) //rotates the 4 bytes of block data

{

UartPutByte(buf[i]); // send block 0 data to host

}

UartPutCrlf();

UartSendCString("BLOCK 01: ");

for (i = 6; i < 10; i++) {

UartPutByte(buf[i]); // send block 1 data to host

}

UartPutCrlf();

UartSendCString("BLOCK 02: ");

for (i = 10; i < 14; i++) {

UartPutByte(buf[i]); // send block 2 data to host

}

UartPutCrlf();

UartSendCString("BLOCK 03: ");

for (i = 14; i < 18; i++) {

UartPutByte(buf[i]); // send block 3 data to host

}

UartPutCrlf();

UartSendCString("BLOCK 04: ");

for (i = 18; i < 22; i++) {

UartPutByte(buf[i]); // send block 4 data to host

}

UartPutCrlf();

UartSendCString("BLOCK 05: ");

for (i = 22; i < 26; i++) {

UartPutByte(buf[i]); // send block 5 data to host

}

UartPutCrlf();

UartSendCString("BLOCK 06: ");

for (i = 26; i < 30; i++) {

UartPutByte(buf[i]); // send block 6 data to host

}

UartPutCrlf();

UartSendCString("BLOCK 07: ");

for (i = 30; i < 34; i++) {

UartPutByte(buf[i]); // send block 7 data to host

}

UartPutCrlf();

UartSendCString("BLOCK 08: ");

for (i = 34; i < 38; i++) {

UartPutByte(buf[i]); // send block 8 data to host

}

UartPutCrlf();

UartSendCString("BLOCK 09: ");

for (i = 38; i < 42; i++) {

UartPutByte(buf[i]); // send block 9 data to host

}

UartPutCrlf();

UartSendCString("BLOCK 0A: ");

for (i = 42; i < 46; i++) {

UartPutByte(buf[i]); // send block 10 data to host

}

UartPutCrlf();

UartSendCString("BLOCK 0B: ");

for (i = 46; i < 50; i++) {

UartPutByte(buf[i]); // send block 11 data to host

}

UartPutCrlf();

UartSendCString("BLOCK 0C: ");

for (i = 50; i < 54; i++) {

UartPutByte(buf[i]); // send block 12 data to host

}

UartPutCrlf();

UartSendCString("BLOCK 0D: ");

for (i = 54; i < 58; i++) {

UartPutByte(buf[i]); // send block 13 data to host

}

UartPutCrlf();

UartSendCString("BLOCK 0E: ");

for (i = 58; i < 62; i++) {

UartPutByte(buf[i]); // send block 14 data to host

}

UartPutCrlf();

UartSendCString("BLOCK 0F: ");

for (i = 62; i < 66; i++) {

UartPutByte(buf[i]); // send block 15 data to host

}

UartPutCrlf();

UartSendCString("BLOCK 10: ");

for (i = 66; i < 70; i++) {

UartPutByte(buf[i]); // send block 16 data to host

}

UartPutCrlf();

UartSendCString("BLOCK 11: ");

for (i = 70; i < 74; i++) {

UartPutByte(buf[i]); // send block 17 data to host

}

UartPutCrlf();

UartSendCString("BLOCK 12: ");

for (i = 74; i < 78; i++) {

UartPutByte(buf[i]); // send block 18 data to host

}

UartPutCrlf();

UartSendCString("BLOCK 13: ");

for (i = 78; i < 82; i++) {

UartPutByte(buf[i]); // send block 19 data to host

}

UartPutCrlf();

UartSendCString("BLOCK 14: ");

for (i = 82; i < 86; i++) {

UartPutByte(buf[i]); // send block 20 data to host

}

UartPutCrlf();

UartSendCString("BLOCK 15: ");

for (i = 86; i < 90; i++) {

UartPutByte(buf[i]); // send block 21 data to host

}

UartPutCrlf();

UartSendCString("BLOCK 16: ");

for (i = 90; i < 94; i++) {

UartPutByte(buf[i]); // send block 22 data to host

}

UartPutCrlf();

UartSendCString("BLOCK 17: ");

for (i = 94; i < 98; i++) {

UartPutByte(buf[i]); // send block 23 data to host

}

UartPutCrlf();

UartSendCString("BLOCK 18: ");

for (i = 98; i < 102; i++) {

UartPutByte(buf[i]); // send block 24 data to host

}

UartPutCrlf();

UartPutCrlf();

McuDelayMillisecond(250);

*/

#endif

}

}

Trf7970TurnRfOff();

Trf7970ResetIrqStatus(); // clear any IRQs

}

//===============================================================

// NAME: void Iso15693Anticollision(u08_t *mask, u08_t length)

//

// BRIEF: Is used to perform a inventory cycle of 1 or 16 time slots.

//

// INPUTS:

// Parameters:

// u08_t *mask mask value

// u08_t length number of significant bits of

// mask value

//

// OUTPUTS:

//

// PROCESS: [1] send command

// [2] receive respond

// [3] send respond to host

//

// CHANGE:

// DATE WHO DETAIL

// 23Nov2010 RP Original Code

//===============================================================

void Iso15693Anticollision(u08_t *mask, u08_t length) // host command 0x14

{

u08_t i = 1, j = 1, command[2], no_slots, found = 0;

u08_t *p_slot_no;

u08_t slot_no[17];

u08_t new_mask[8], new_length, mask_size;

u32_t size;

u08_t ui8BlockNumber;

u08_t fifo_length = 0;

u16_t k;

slot_no[0] = 0x00;

buf[0] = ISO_CONTROL;

buf[1] = 0x02;// Receive with no CRC, means the TRF79xx will check CRC and strip out of FIFO

Trf7970WriteIsoControl(buf[1]);

Trf7970ReadSingle(buf, 1);

McuDelayMillisecond(2);

if ((flags & BIT5)== 0x00) // flag bit5 is the number of slots indicator

{

no_slots = 16; // 16 slots if bit is cleared

} else {

no_slots = 1; // 1 slot if bit is set

}

p_slot_no = &slot_no[0]; // slot number pointer

mask_size = (((length >> 2) + 1) >> 1); // mask_size is 1 for length = 4 or 8

buf[0] = 0x8F;

buf[1] = 0x91; // send with CRC

buf[2] = 0x3D; // write continuous from 1D

buf[5] = flags; // ISO15693 flags

buf[6] = 0x01; // anti-collision command code

//optional AFI should be here

if (flags & 0x10) {

// mask_size is 2 for length = 12 or 16 ;

// and so on

size = mask_size + 4;// mask value + mask length + AFI + command code + flags

buf[7] = afi;

buf[8] = length; // mask length

if (length > 0) {

for (i = 0; i < mask_size; i++) {

buf[9 + i] = *(mask + i);

}

}

fifo_length = 9;

} else {

// mask_size is 2 for length = 12 or 16

// and so on

size = mask_size + 3;// mask value + mask length + command code + flags

buf[7] = length; // mask length

if (length > 0) {

for (i = 0; i < mask_size; i++) {

buf[8 + i] = *(mask + i);

}

}

fifo_length = 8;

}

buf[3] = (char) (size >> 8);

buf[4] = (char) (size << 4);

Trf7970ResetIrqStatus();

RESET_COUNTER; // TimerA set

A2CounterLoad(COUNT_1ms * 30);

// COUNT_VALUE = COUNT_1ms * 30; // 30ms, not 20ms

IRQ_CLR; // PORT2 interrupt flag clear

IRQ_ON;

Trf7970RawWrite(&buf[0], mask_size + fifo_length);// Transmitting 15693 Inventory Command.

i_reg = 0x01;

irq_flag = 0x00;

START_COUNTER; // Starting Timeout

// while(TA0R < 1000) {

// i_reg = TA0R;

// }

while (irq_flag == 0x00) {

} // wait for end of TX interrupt

RESET_COUNTER;

for (j = 1; j <= no_slots; j++) // 1 or 16 available time slots

{

rxtx_state = 1; // prepare the external counter

// the first UID will be stored from buf[1] upwards

// TimerA set

// COUNT_VALUE = COUNT_1ms * 20;

A2CounterLoad(COUNT_1ms * 20);

START_COUNTER; // start timer up mode

irq_flag = 0x00;

while (irq_flag == 0x00) {

} // wait for interrupt

RESET_COUNTER;

while (i_reg == 0x01) // wait for RX complete

{

k++;

if (k == 0xFFF0) {

i_reg = 0x00;

rx_error_flag = 0x00;

}

}

command[0] = RSSI_LEVELS; // read RSSI levels

Trf7970ReadSingle(command, 1);

switch (i_reg) {

case 0xFF: // if received UID in buffer

if (stand_alone_flag == 1) {

found = 1;

g_tag_found = ISO15693;

// build uid string

char * cptr;

cptr = (char *) g_uid;

for (i = 10; i > 2; i--) {

cptr = cptr + sprintf(cptr, "%x", (buf[i] >> 4) & 0x0F);

cptr = cptr + sprintf(cptr, "%x", buf[i] & 0x0F);

}

cptr = (char *) g_rssi;

cptr = cptr + sprintf(cptr, "%x", (command[0] >> 4) & 0x0F);

cptr = cptr + sprintf(cptr, "%x", command[0] & 0x0F);

#ifdef ENABLE_HOST

Tag_Count++;

// UartPutCrlf();

// UartSendCString("ISO15693/NFC-V UID: ");

// UartPutChar('[');

for (i = 10; i > 2; i--) {

// UartPutByte(buf[i]); // send UID to host

}

// UartPutChar(']');

// Report("\r\n");

// UartSendCString("RSSI LEVEL: ");

// UartPutChar('[');

// UartPutByte(command[0]); // RSSI levels

// UartPutChar(']');

// UartPutCrlf();

// Report("\r\n ");

// Report((char *) g_uid);

// Report("\r\n ");

#endif

// build_message(my_message, buf, 10, 3, "ISO15693/NFC-V UID: ");

}

break;

case 0x02: // collision occurred

p_slot_no++; // remember a collision was detected

*p_slot_no = j;

break;

case 0x00: // timer interrupt

if (stand_alone_flag == 1) {

}

break;

default:

break;

}

Trf7970Reset(); // FIFO has to be reset before receiving the next response

if ((no_slots == 16) && (j < 16))// if 16 slots used send EOF(next slot)

{

Trf7970StopDecoders();

Trf7970RunDecoders();

Trf7970TransmitNextSlot();

} else if ((no_slots == 16) && (j == 16))// at the end of slot 16 stop the slot counter

{

Trf7970StopDecoders();

Trf7970DisableSlotCounter();

} else if (no_slots == 1) // 1 slot is used

{

break;

}

} // for

if (found == 1) // LED on?

{

//LED_15693_ON; // LEDs indicate detected ISO15693 tag

int cx = 0;

for (ui8BlockNumber = 0; ui8BlockNumber < 0x4; ui8BlockNumber++) //0x7F support includes TI Tag-It HF-I Plus, Pro, standard and STM M24LR04E tags)

{

NFC_TYPEV_READ_SINGLE_BLOCK(ui8BlockNumber);

cx = cx + snprintf(g_tag_content+cx, sizeof(g_tag_content)-cx, "%s", g_block_content);

}

// UART_PRINT(g_tag_content);

} else {

//LED_15693_OFF;

}

new_length = length + 4; // the mask length is a multiple of 4 bits

mask_size = (((new_length >> 2) + 1) >> 1);

while ((*p_slot_no != 0x00) && (no_slots == 16) && (new_length < 61)

&& (slot_no[16] != 16)) {

*p_slot_no = *p_slot_no - 1;

for (i = 0; i < 8; i++) {

new_mask[i] = *(mask + i); //first the whole mask is copied

}

if ((new_length & BIT2)== 0x00){

*p_slot_no = *p_slot_no << 4;

} else {

for (i = 7; i > 0; i--) {

new_mask[i] = new_mask[i - 1];

}

new_mask[0] &= 0x00;

}

new_mask[0] |= *p_slot_no; // the mask is changed

McuDelayMillisecond(2);

Iso15693Anticollision(&new_mask[0], new_length);// recursive call with new Mask

p_slot_no--;

}

IRQ_OFF;

}

iso15693.h

/*

* {iso15693.h}

*

* {ISO15693 header file}

*

*

*/

#ifndef _ISO15693_H_

#define _ISO15693_H_

//================================================================

#include "trf7970.h"

#include "types.h"

#include "uart.h"

//===============================================================

//Mandatory Command Request Flags

#define SIXTEEN_SLOTS 0x06 //tables 3 & 5 in ISO15693-3; single-subcarrier, high tag data rate, sixteen slots

#define ONE_SLOT 0x26 //tables 3 & 5 in ISO15693-3; single-subcarrier, high tag data rate, one slot

//Optional Command Request Flags

#define SSC_HTDR_NA 0x02 //tables 3 & 4 in ISO15693-3; single-subcarrier, high tag data rate, non-addressed

#define SSC_HTDR_ADDR 0x22 //tables 3 & 4 in ISO15693-3; single-subcarrier, high tag data rate, addressed

#define ISO15693 1

//===============================================================

// if disabled file ISO15693.c may be excluded from build

//#define ENABLE15693 // delete to disable standard

//===============================================================

void Iso15693FindTag(void);

void NFC_TYPEV_READ_SINGLE_BLOCK(u08_t StartBlock);

void Iso15693Anticollision(u08_t *mask, u08_t length);

//void Iso15693ReadMultipleBlocks_0_18(void);

//===============================================================

#endif

spi_for_trf.c

/*

* {spi_for_trf.c}

*

* {SPI Interface Functions}

*

*

*/

#include "hw_types.h"

#include "spi.h"

#include "spi_for_trf.h"

#include "gpio_if.h"

#include "trf7970.h"

#include "hw_memmap.h"

#include "hw_common_reg.h"

#include "hw_ints.h"

#include "pin.h"

#include "rom.h"

#include "rom_map.h"

#include "utils.h"

#include "prcm.h"

#include "interrupt.h"

#include "pinmux.h"

#include "uart.h"

#include "uart_if.h"

#include "types.h"

#include "trf7970BoosterPack.h"

#define ASSERT_CS() (SPI_CS_ON)

#define DEASSERT_CS() (SPI_CS_OFF)

typedef unsigned int Fd_t;

//===============================================================

u08_t temp = 0;

extern u08_t direct_mode;

//===============================================================

void SpiStartCondition(void);

void SpiStopCondition(void);

void SpiUsciSet(void);

void SpiUsciDisable(void);

//===============================================================

// NAME: void SpiDirectCommand (u08_t *pbuf)

//

// BRIEF: Is used in SPI mode to transmit a Direct Command to

// reader chip.

//

// INPUTS:

// Parameters:

// u08_t *pbuf Direct Command

//

// OUTPUTS:

//

// PROCESS: [1] transmit Direct Command

//

// CHANGE:

// DATE WHO DETAIL

// 24Nov2010 RP Original Code

// 07Dec2010 RP integrated wait while busy loops

//===============================================================

void

SpiDirectCommand(u08_t *pbuf)

{

unsigned char ucDummy;

// set Address/Command Word Bit Distribution to command

*pbuf = (0x80 | *pbuf); // command

*pbuf = (0x9f & *pbuf); // command code

SPI_CS_OFF;

SPITransfer(GSPI_BASE, pbuf, &ucDummy, 1, SPI_CS_ENABLE);

SPI_CS_ON;

}

//===============================================================

// NAME: void SpiDirectMode (void)

//

// BRIEF: Is used in SPI mode to start Direct Mode.

//

// INPUTS:

//

// OUTPUTS:

//

// PROCESS: [1] start Direct Mode

//

// NOTE: No stop condition

//

// CHANGE:

// DATE WHO DETAIL

// 24Nov2010 RP Original Code

// 07Dec2010 RP integrated wait while busy loops

//===============================================================

void

SpiDirectMode(void)

{

u08_t command [2];

command[0] = CHIP_STATE_CONTROL;

command[1] = CHIP_STATE_CONTROL;

// read byte to command[1]

SPI_CS_OFF;

SPITransfer(GSPI_BASE, 0, &command[1], 1, SPI_CS_ENABLE);

command[1] |= 0x60; // RF on and BIT 6 in Chip Status Control Register set

// write command[0] byte

SPITransfer(GSPI_BASE, command, 0, 1, SPI_CS_ENABLE);

SpiWriteSingle(command, 2);

SPI_CS_ON;

}

//===============================================================

// NAME: void SpiRawWrite (u08_t *pbuf, u08_t length)

//

// BRIEF: Is used in SPI mode to write direct to the reader chip.

//

// INPUTS:

// Parameters:

// u08_t *pbuf raw data

// u08_t length number of data bytes

//

// OUTPUTS:

//

// PROCESS: [1] send raw data to reader chip

//

// CHANGE:

// DATE WHO DETAIL

// 24Nov2010 RP Original Code

// 07Dec2010 RP integrated wait while busy loops

//===============================================================

void

SpiRawWrite(u08_t *pbuf, u08_t length)

{

SPI_CS_OFF;

SPITransfer(GSPI_BASE, pbuf, 0, length, SPI_CS_ENABLE);

SPI_CS_ON;

}

//===============================================================

// NAME: void SpiReadCont (u08_t *pbuf, u08_t length)

//

// BRIEF: Is used in SPI mode to read a specified number of

// reader chip registers from a specified address upwards.

//

// INPUTS:

// Parameters:

// u08_t *pbuf address of first register

// u08_t length number of registers

//

// OUTPUTS:

//

// PROCESS: [1] read registers

// [2] write contents to *pbuf

//

// CHANGE:

// DATE WHO DETAIL

// 24Nov2010 RP Original Code

// 07Dec2010 RP integrated wait while busy loops

//===============================================================

void

SpiReadCont(u08_t *pbuf, u08_t length)

{

// Address/Command Word Bit Distribution

*pbuf = (0x60 | *pbuf); // address, read, continuous

*pbuf = (0x7f &*pbuf); // register address

// write command address/word

SPI_CS_OFF;

SPITransfer(GSPI_BASE, pbuf, 0, 1, SPI_CS_ENABLE);

// read length bytes into pbuf[length]

SPITransfer(GSPI_BASE, 0, pbuf, length, SPI_CS_ENABLE);

SPI_CS_ON;

}

//===============================================================

// NAME: void SpiReadSingle (u08_t *pbuf, u08_t number)

//

// BRIEF: Is used in SPI mode to read specified reader chip

// registers.

//

// INPUTS:

// Parameters:

// u08_t *pbuf addresses of the registers

// u08_t number number of the registers

//

// OUTPUTS:

//

// PROCESS: [1] read registers

// [2] write contents to *pbuf

//

// CHANGE:

// DATE WHO DETAIL

// 24Nov2010 RP Original Code

// 07Dec2010 RP integrated wait while busy loops

//===============================================================

void

SpiReadSingle(u08_t *pbuf, u08_t number)

{

SPI_CS_OFF;

while(number > 0)

{

// Address/Command Word Bit Distribution

*pbuf = (0x40 | *pbuf); // address, read, single

*pbuf = (0x5f & *pbuf); // register address

// write address/command byte into pbuf

SPITransfer(GSPI_BASE, pbuf, 0, 1, SPI_CS_ENABLE);

// read single byte into pbuf

SPITransfer(GSPI_BASE, 0, pbuf, 1, SPI_CS_ENABLE);

pbuf++;

number--;

}

SPI_CS_ON;

}

//===============================================================

// NAME: void SpiWriteCont (u08_t *pbuf, u08_t length)

//

// BRIEF: Is used in SPI mode to write to a specific number of

// reader chip registers from a specific address upwards.

//

// INPUTS:

// u08_t *pbuf address of first register followed by the

// contents to write

// u08_t length number of registers + 1

//

// OUTPUTS:

//

// PROCESS: [1] write to the registers

//

// CHANGE:

// DATE WHO DETAIL

// 24Nov2010 RP Original Code

// 07Dec2010 RP integrated wait while busy loops

//===============================================================

void

SpiWriteCont(u08_t *pbuf, u08_t length)

{

SPI_CS_OFF;

// Address/Command Word Bit Distribution

*pbuf = (0x20 | *pbuf); // address, write, continuous

*pbuf = (0x3f &*pbuf); // register address

// write command address/word + number of registers

SPITransfer(GSPI_BASE, pbuf, 0, length, SPI_CS_ENABLE);

SPI_CS_ON;

}

//===============================================================

// NAME: void SpiWriteSingle (u08_t *pbuf, u08_t length)

//

// BRIEF: Is used in SPI mode to write to a specified reader chip

// registers.

//

// INPUTS:

// u08_t *pbuf addresses of the registers followed by the

// contends to write

// u08_t length number of registers * 2

//

// OUTPUTS:

//

// PROCESS: [1] write to the registers

//

// CHANGE:

// DATE WHO DETAIL

// 24Nov2010 RP Original Code

// 07Dec2010 RP integrated wait while busy loops

//===============================================================

void

SpiWriteSingle(u08_t *pbuf, u08_t length)

{

SPI_CS_OFF;

while(length > 0)

{

// Address/Command Word Bit Distribution

// address, write, single (fist 3 bits = 0)

*pbuf = (0x1f &*pbuf); // register address

SPITransfer(GSPI_BASE, pbuf, 0, 2, SPI_CS_ENABLE);

pbuf=pbuf + 2;

length=length - 2;

}

SPI_CS_ON;

}

spi_for_trf.h

/*

* {spi_for_trf.h}

*

* {Header File}

*

*/

#ifndef _SPI_TRF_H_

#define _SPI_TRF_H_

#include "types.h"

#include "hw_types.h"

//================================================================

//===============================================================

extern void SpiDirectCommand(u08_t *pbuf);

extern void SpiDirectMode(void);

extern void SpiRawWrite(u08_t *pbuf, u08_t length);

extern void SpiReadCont(u08_t *pbuf, u08_t length);

extern void SpiReadSingle(u08_t *pbuf, u08_t number);

extern void SpiWriteCont(u08_t *pbuf, u08_t length);

extern void SpiWriteSingle(u08_t *pbuf, u08_t length);

//===============================================================

//*****************************************************************************

// Values that can be passed to SPIConfigSetExpClk() as ulMode parameter

//*****************************************************************************

#define SPI_MODE_MASTER 0x00000000

#define SPI_MODE_SLAVE 0x00000004

//*****************************************************************************

// Values that can be passed to SPIConfigSetExpClk() as ulSubMode parameter

//*****************************************************************************

#define SPI_SUB_MODE_0 0x00000000

#define SPI_SUB_MODE_1 0x00000001

#define SPI_SUB_MODE_2 0x00000002

#define SPI_SUB_MODE_3 0x00000003

//*****************************************************************************

// Values that can be passed to SPIConfigSetExpClk() as ulConfigFlags parameter

//*****************************************************************************

#define SPI_SW_CTRL_CS 0x01000000

#define SPI_HW_CTRL_CS 0x00000000

#define SPI_3PIN_MODE 0x02000000

#define SPI_4PIN_MODE 0x00000000

#define SPI_TURBO_ON 0x00080000

#define SPI_TURBO_OFF 0x00000000

#define SPI_CS_ACTIVEHIGH 0x00000000

#define SPI_CS_ACTIVELOW 0x00000040

#define SPI_WL_8 0x00000380

#define SPI_WL_16 0x00000780

#define SPI_WL_32 0x00000F80

//*****************************************************************************

// Values that can be passed to SPIFIFOEnable() and SPIFIFODisable()

//*****************************************************************************

#define SPI_TX_FIFO 0x08000000

#define SPI_RX_FIFO 0x10000000

//*****************************************************************************

// Values that can be passed to SPIDMAEnable() and SPIDMADisable()

//*****************************************************************************

#define SPI_RX_DMA 0x00008000

#define SPI_TX_DMA 0x00004000

//*****************************************************************************

// Values that can be passed to SPIIntEnable(), SPIIntDiasble(),

// SPIIntClear() or returned from SPIStatus()

//*****************************************************************************

#define SPI_INT_DMATX 0x20000000

#define SPI_INT_DMARX 0x10000000

#define SPI_INT_EOW 0x00020000

#define SPI_INT_WKS 0x00010000

#define SPI_INT_RX_OVRFLOW 0x00000008

#define SPI_INT_RX_FULL 0x00000004

#define SPI_INT_TX_UDRFLOW 0x00000002

#define SPI_INT_TX_EMPTY 0x00000001

//*****************************************************************************

// Values that can be passed to SPITransfer()

//*****************************************************************************

#define SPI_CS_ENABLE 0x00000001

#define SPI_CS_DISABLE 0x00000002

#endif

trf7970.c

/*

* {trf7970.c}

*

* {TRF7970 Communication functions}

*

*/

#include "trf7970.h"

#include "spi_for_trf.h"

#include "hw_memmap.h"

#include "hw_gpio.h"

#include "gpio.h"

#include "timer.h"

#include "timer_if.h"

#include "trf7970BoosterPack.h"

//===============================================================

u08_t command[2];

u08_t direct_mode = 0;

extern u08_t buf[140];

extern u08_t i_reg;

#ifdef ENABLE14443A

extern u08_t coll_poss;

#endif

extern u08_t irq_flag;

extern u08_t rx_error_flag;

extern s08_t rxtx_state;

extern u08_t stand_alone_flag;

//P_EVENT_HANDLER pIraEventHandler = 0;

//===============================================================

void Trf7970ISR(u08_t *irq_status);

//===============================================================

// ;

//===============================================================

/*

void

Trf7970CommunicationSetup(void)

{

if(SPIMODE)

{

SpiSetup();

}

}

*/

//===============================================================

// NAME: void Trf7970DirectCommand (u08_t *pbuf)

//

// BRIEF: Is used to transmit a Direct Command to Trf7970.

//

// INPUTS:

// Parameters:

// u08_t *pbuf Direct Command

//

// OUTPUTS:

//

// PROCESS: [1] transmit Direct Command

//

// CHANGE:

// DATE WHO DETAIL

// 24Nov2010 RP Original Code

//===============================================================

void

Trf7970DirectCommand(u08_t *pbuf)

{

if(SPIMODE) // SPI mode given by jumper setting

{

SpiDirectCommand(pbuf);

}

}

//===============================================================

// NAME: void Trf7970DirectMode (void)

//

// BRIEF: Is used to start Direct Mode.

//

// INPUTS:

//

// OUTPUTS:

//

// PROCESS: [1] start Direct Mode

//

// NOTE: No stop condition

//

// CHANGE:

// DATE WHO DETAIL

// 24Nov2010 RP Original Code

//===============================================================

void

Trf7970DirectMode(void)

{

direct_mode = 1;

if(SPIMODE) // SPI mode given by jumper setting

{

SpiDirectMode();

}

}

//===============================================================

// 02DEC2010 RP Original Code

//===============================================================

void

Trf7970DisableSlotCounter(void)

{

buf[40] = IRQ_MASK;

buf[41] = IRQ_MASK; // next slot counter

Trf7970ReadSingle(&buf[41], 1);

buf[41] &= 0xFE; // clear BIT0 in register 0x01

Trf7970WriteSingle(&buf[40], 2);

}

//===============================================================

// 02DEC2010 RP Original Code

//===============================================================

void

Trf7970EnableSlotCounter(void)

{

buf[40] = IRQ_MASK;

buf[41] = IRQ_MASK; // next slot counter

Trf7970ReadSingle (&buf[41], 1);

buf[41] |= BIT0; // set BIT0 in register 0x01

Trf7970WriteSingle(&buf[40], 2);

}

//===============================================================

// 02DEC2010 RP Original Code

//===============================================================

void

Trf7970InitialSettings(void)

{

command[0] = SOFT_INIT;

Trf7970DirectCommand(command);

command[0] = IDLE;

Trf7970DirectCommand(command);

#ifdef TRF7970A

command[0] = MODULATOR_CONTROL;

command[1] = 0x01; // ASK 100%, no SYS_CLK output

Trf7970WriteSingle(command, 2);

#endif

}

//===============================================================

// The Interrupt Service Routine determines how the IRQ should ;

// be handled. The Trf7970 IRQ status register is read to ;

// determine the cause of the IRQ. Conditions are checked and ;

// appropriate actions taken. ;

//===============================================================

void

Trf7970ISR(u08_t *irq_status)

{

if(*irq_status == 0xA0) // BIT5 and BIT7

{ // TX active and only 3 bytes left in FIFO

// i_reg = 0x00;

}

else if(*irq_status == BIT7)

{ // TX complete

i_reg = 0x00;

Trf7970Reset(); // reset the FIFO after TX

}

else if((*irq_status & BIT1) == BIT1)

{ // collision error

i_reg = 0x02; // RX complete

#ifdef ENABLE14443A

coll_poss = COLLISION_POSITION;

Trf7970ReadSingle(&coll_poss, 1);

buf[rxtx_state] = FIFO; // write the recieved bytes to the correct place of the

// buffer;

if (coll_poss >= 0x20)

{

Trf7970ReadCont(&buf[rxtx_state], 5);

}

#endif

Trf7970StopDecoders(); // reset the FIFO after TX

Trf7970Reset();

Trf7970ResetIrqStatus();

GPIOIntClear(GPIOA1_BASE, GPIO_PIN_3);

}

else if(*irq_status == BIT6)

{ // RX flag means that EOF has been recieved

// and the number of unread bytes is in FIFOstatus regiter

if(rx_error_flag == 0x02)

{

i_reg = 0x02;

return;

}

*irq_status = FIFO_STATUS;

Trf7970ReadSingle(irq_status, 1); // determine the number of bytes left in FIFO

*irq_status = 0x7F & *irq_status;

buf[rxtx_state] = FIFO; // write the recieved bytes to the correct place of the buffer

Trf7970ReadCont(&buf[rxtx_state], *irq_status);

rxtx_state = rxtx_state + *irq_status;

Trf7970Reset(); // reset the FIFO after last byte has been read out

i_reg = 0xFF; // signal to the recieve funnction that this are the last bytes

}

else if(*irq_status == 0x60)

{ // RX active and 9 bytes allready in FIFO

i_reg = 0x01;

buf[rxtx_state] = FIFO;

Trf7970ReadCont(&buf[rxtx_state], 9); // read 9 bytes from FIFO

rxtx_state = rxtx_state + 9;

if((IRQ_PORT & IRQ_PIN) == IRQ_PIN) // if IRQ pin high

{

Trf7970ReadIrqStatus(irq_status);

GPIOIntClear(GPIOA1_BASE, GPIO_PIN_3);

if(*irq_status == 0x40) // end of recieve

{

*irq_status = FIFO_STATUS;

Trf7970ReadSingle(irq_status, 1); // determine the number of bytes left in FIFO

*irq_status = 0x7F & *irq_status;

buf[rxtx_state] = FIFO; // write the recieved bytes to the correct place of the buffer

Trf7970ReadCont(&buf[rxtx_state], *irq_status);

rxtx_state = rxtx_state + *irq_status;

i_reg = 0xFF; // signal to the recieve funnction that this are the last bytes

Trf7970Reset(); // reset the FIFO after last byte has been read out

}

else if(*irq_status == 0x50) // end of recieve and error

{

i_reg = 0x02;

}

}

else

{

Trf7970ReadIrqStatus(irq_status);

if(irq_status[0] == 0x00)

{

i_reg = 0xFF;

}

}

}

else if((*irq_status & BIT4) == BIT4) // CRC error

{

if((*irq_status & BIT5) == BIT5)

{

i_reg = 0x01; // RX active

rx_error_flag = 0x02;

}

if((*irq_status & BIT6) == BIT6) // 4 Bit receive

{

buf[100] = FIFO; // write the received bytes to the correct place of the buffer

Trf7970ReadCont(&buf[100], 1);

Trf7970Reset();

i_reg = 0x02; // end of RX

rx_error_flag = 0x02;

}

else

{

i_reg = 0x02; // end of RX

}

}

else if((*irq_status & BIT2) == BIT2) // byte framing error

{

if((*irq_status & BIT5) == BIT5)

{

i_reg = 0x01; // RX active

rx_error_flag = 0x02;

}

else

i_reg = 0x02; // end of RX

}

else if((*irq_status == BIT0))

{ // No response interrupt

i_reg = 0x00;

}

else

{ // Interrupt register not properly set

i_reg = 0x02;

Trf7970StopDecoders(); // reset the FIFO after TX

Trf7970Reset();

Trf7970ResetIrqStatus();

GPIOIntClear(GPIOA1_BASE, GPIO_PIN_4);

}

} // Interrupt Service Routine

//===============================================================

// 02DEC2010 RP Original Code

//===============================================================

void Trf7970PortB(void) // interrupt handler

{

u08_t irq_status[4], iso_control;

irq_flag = 0x02;

// Sergey to fix STOP_COUNTER; // stop timer mode

RESET_COUNTER;

do

{

GPIOIntClear(GPIOA1_BASE, GPIO_PIN_4); // interrupt flag clear

iso_control = ISO_CONTROL;

Trf7970ReadSingle(&iso_control, 1);

Trf7970ReadIrqStatus(irq_status);

if((iso_control & BIT5) != BIT5) // RFID mode

{

Trf7970ISR(irq_status);

}

} while(GPIOIntStatus(GPIOA1_BASE,1) & GPIO_PIN_4);

// __bic_SR_register_on_exit(LPM0_bits);

}

//===============================================================

// NAME: void Trf7970RawWrite (u08_t *pbuf, u08_t length)

//

// BRIEF: Is used to write direct to the Trf7970.

//

// INPUTS:

// Parameters:

// u08_t *pbuf raw data

// u08_t length number of data bytes

//

// OUTPUTS:

//

// PROCESS: [1] send raw data to Trf7970

//

// CHANGE:

// DATE WHO DETAIL

// 24Nov2010 RP Original Code

//===============================================================

void

Trf7970RawWrite(u08_t *pbuf, u08_t length)

{

if(SPIMODE) // SPI mode given by jumper setting

{

SpiRawWrite(pbuf, length);

}

}

//===============================================================

// NAME: void Trf7970ReadCont (u08_t *pbuf, u08_t length)

//

// BRIEF: Is used to read a specified number of Trf7970 registers

// from a specified address upwards.

//

// INPUTS:

// Parameters:

// u08_t *pbuf address of first register

// u08_t length number of registers

//

// OUTPUTS:

//

// PROCESS: [1] read registers

// [2] write contents to *pbuf

//

// CHANGE:

// DATE WHO DETAIL

// 24Nov2010 RP Original Code

//===============================================================

void

Trf7970ReadCont(u08_t *pbuf, u08_t length)

{

if(SPIMODE) // SPI mode given by jumper setting

{

SpiReadCont(pbuf, length);

}

else // parallel mode

{

}

}

//===============================================================

// 02DEC2010 RP Original Code

//===============================================================

void

Trf7970ReadIrqStatus(u08_t *pbuf)

{

*pbuf = IRQ_STATUS;

*(pbuf + 1) = IRQ_MASK;

Trf7970ReadCont(pbuf, 2); // read second reg. as dummy read

}

//===============================================================

// NAME: void Trf7970ReadSingle (u08_t *pbuf, u08_t number)

//

// BRIEF: Is used to read specified Trf7970 registers.

//

// INPUTS:

// Parameters:

// u08_t *pbuf addresses of the registers

// u08_t number number of the registers

//

// OUTPUTS:

//

// PROCESS: [1] read registers

// [2] write contents to *pbuf

//

// CHANGE:

// DATE WHO DETAIL

// 24Nov2010 RP Original Code

//===============================================================

void

Trf7970ReadSingle(u08_t *pbuf, u08_t number)

{

if(SPIMODE) // SPI mode given by jumper setting

{

SpiReadSingle(pbuf, number);

}

}

//===============================================================

// resets FIFO ;

// 02DEC2010 RP Original Code

//===============================================================

void

Trf7970Reset(void)

{

command[0] = RESET;

Trf7970DirectCommand(command);

}

//===============================================================

// resets IRQ Status ;

// 02DEC2010 RP Original Code

//===============================================================

void

Trf7970ResetIrqStatus(void)

{

u08_t irq_status[4];

irq_status[0] = IRQ_STATUS;

irq_status[1] = IRQ_MASK;

if(SPIMODE) // SPI mode given by jumper setting

{

Trf7970ReadCont(irq_status, 2); // read second reg. as dummy read

}

}

//===============================================================

// ;

// 02DEC2010 RP Original Code

//===============================================================

void

Trf7970RunDecoders(void)

{

command[0] = RUN_DECODERS;

Trf7970DirectCommand(command);

}

//===============================================================

// 02DEC2010 RP Original Code

//===============================================================

void

Trf7970StopDecoders(void)

{

command[0] = STOP_DECODERS;

Trf7970DirectCommand(command);

}

//===============================================================

// 02DEC2010 RP Original Code

//===============================================================

void

Trf7970TransmitNextSlot(void)

{

command[0] = TRANSMIT_NEXT_SLOT;

Trf7970DirectCommand(command);

}

//===============================================================

// 02DEC2010 RP Original Code

//===============================================================

void

Trf7970TurnRfOff(void)

{

command[0] = CHIP_STATE_CONTROL;

command[1] = CHIP_STATE_CONTROL;

Trf7970ReadSingle(&command[1], 1);

command[1] &= 0x1F;

Trf7970WriteSingle(command, 2);

}

//===============================================================

// 02DEC2010 RP Original Code

//===============================================================

void

Trf7970TurnRfOn(void)

{

u08_t write[4];

write[0] = CHIP_STATE_CONTROL;

write[1] = 0x20; // 3.3VDC, Full power out

Trf7970WriteSingle(write, 2);

}

//===============================================================

// NAME: void SpiWriteCont (u08_t *pbuf, u08_t length)

//

// BRIEF: Is used to write to a specific number of reader chip

// registers from a specific address upwards.

//

// INPUTS:

// u08_t *pbuf address of first register followed by the

// contents to write

// u08_t length number of registers + 1

//

// OUTPUTS:

//

// PROCESS: [1] write to the registers

//

// CHANGE:

// DATE WHO DETAIL

//===============================================================

void

Trf7970WriteCont(u08_t *pbuf, u08_t length)

{

if(SPIMODE) // SPI mode given by jumper setting

{

SpiWriteCont(pbuf, length);

}

else // parallel mode

{

}

}

//===============================================================

// 02DEC2010 RP Original Code

//===============================================================

void

Trf7970WriteIsoControl(u08_t iso_control)

{

u08_t write[16];

/*

write[0] = ISO_CONTROL;

write[1] = iso_control;

write[1] &= ~BIT5;

Trf7970WriteSingle(write, 2);

iso_control &= 0x1F;

write[0] = IRQ_MASK;

write[1] = 0x3F;

Trf7970WriteSingle(write, 2);

*/

//#ifdef ENABLE15693 // this standard can be disabled in ISO15693.h

if (iso_control == 0x02)

{

write[0] = 0x20; //Continuous Write, starting with register 0x00

write[1] = 0x20; //Value for Chip Status Control Register 0x00, 0x20 = +3.3VDC, full power, etc.

write[2] = 0x02; //Value for ISO Control Register 0x01, 0x02 = high tag data rate, etc.

write[3] = 0x00;

write[4] = 0x00;

write[5] = 0xC1;

write[6] = 0xBB;

write[7] = 0x00;

write[8] = 0x30;

write[9] = 0x1F;

write[10] = 0x01;

write[11] = 0x40;

write[12] = 0x03;

Trf7970WriteCont(write, 13); //writes registers 0x00:0x0B

}

//#endif

//#ifdef ENABLE14443A // this standard can be disabled in ISO14443A.h

if (iso_control == 0x88)

{

/*

write[0] = 0x20;

write[1] = 0x20; //full power out, 3.3VDC

write[2] = 0x88;

write[3] = 0x00;

write[4] = 0x00;

write[5] = 0xC1;

write[6] = 0xBB;

write[7] = 0x20;

write[8] = 0x0E;

write[9] = 0x07;

write[10] = 0x21;

write[11] = 0x20;

write[12] = 0x87;

Trf7970WriteCont(write, 13);

*/

//write[0] = IRQ_MASK;

//write[1] = 0x3E;

//Trf7970WriteSingle(write, 2);

write[0] = ISO_CONTROL;

write[1] = 0x88;

Trf7970WriteSingle(write, 2);

write[0] = MODULATOR_CONTROL;

write[1] = 0x01;

Trf7970WriteSingle(write, 2);

write[0] = ADJUSTABLE_FIFO_LEVEL; //this is register 0x14

write[1] = 0x0F;

Trf7970WriteSingle(write, 2);

}

/*

write[0] = 0x20;

write[1] = 0x20; //full power out, 3.3VDC

write[2] = 0x88;

write[3] = 0x00;

write[4] = 0x00;

write[5] = 0xC1;

write[6] = 0xBB;

write[7] = 0x20;

write[8] = 0x0E;

write[9] = 0x07;

write[10] = 0x21;

write[11] = 0x20;

write[12] = 0x87;

Trf7970WriteCont(write, 13);

*/

//#endif

//#ifdef ENABLE14443B // this standard can be disabled in ISO14443B.h

if (iso_control == 0x0C)

{

write[0] = 0x20;

write[1] = 0x20; //full power out, 3.3VDC

write[2] = 0x0C;

write[3] = 0x00;

write[4] = 0x00;

write[5] = 0xC1;

write[6] = 0xBB;

write[7] = 0x00;

write[8] = 0x0D;

write[9] = 0x07;

write[10] = 0x03;

write[11] = 0x00;

write[12] = 0x87;

Trf7970WriteCont(write, 13);

write[0] = IRQ_MASK;

write[1] = 0x3E;

Trf7970WriteSingle(write, 2);

write[0] = ADJUSTABLE_FIFO_LEVEL;

write[1] = 0x0F;

Trf7970WriteSingle(write, 2);

}

//#endif

//#ifdef ENABLEFELICA // this standard can be disabled in felica.h

if (iso_control == 0x1A)

{

write[0] = 0x20;

write[1] = 0x20; //full power out, 3.3VDC

write[2] = 0x1A;

//write[3] = 0x00;

//write[4] = 0x00;

//write[5] = 0xC1;

//write[6] = 0xBB;

//write[7] = 0x00;

//write[8] = 0x14;

//write[9] = 0x00;

//write[10] = 0x00;

//write[11] = 0x00;

//write[12] = 0x87;

Trf7970WriteCont(write, 03);

write[0] = IRQ_MASK;

write[1] = 0x3E;

Trf7970WriteSingle(write, 2);

write[0] = ADJUSTABLE_FIFO_LEVEL;

write[1] = 0x0F;

Trf7970WriteSingle(write, 2);

}

//#endif

}

//===============================================================

// NAME: void Trf7970WriteSingle (u08_t *pbuf, u08_t length)

//

// BRIEF: Is used to write to specified reader chip registers.

//

// INPUTS:

// u08_t *pbuf addresses of the registers followed by the

// contents to write

// u08_t length number of registers * 2

//

// OUTPUTS:

//

// PROCESS: [1] write to the registers

//

// CHANGE:

// DATE WHO DETAIL

// 24Nov2010 RP Original Code

//===============================================================

void

Trf7970WriteSingle(u08_t *pbuf, u08_t length)

{

if(SPIMODE) // SPI mode given by jumper setting

{

SpiWriteSingle(pbuf, length);

}

else // parallel mode

{

}

}

trf7970.h

/*

* {trf7970.h}

*

* {Header File}

*

*/

#ifndef _Trf7970_H_

#define _Trf7970_H_

//===============================================================

#include <stdlib.h> // general purpose standard library

#include "types.h"

//===============================================================

#define DBG 0 // if DBG 1 interrupts are display

//==== Trf7970 definitions ======================================

//---- Direct commands ------------------------------------------

#define BIT0 0x01

#define BIT1 0x02

#define BIT2 0x04

#define BIT3 0x08

#define BIT4 0x10

#define BIT5 0x20

#define BIT6 0x40

#define BIT7 0x80

#define IDLE 0x00

#define SOFT_INIT 0x03

#define INITIAL_RF_COLLISION 0x04

#define RESPONSE_RF_COLLISION_N 0x05

#define RESPONSE_RF_COLLISION_0 0x06

#define RESET 0x0F

#define TRANSMIT_NO_CRC 0x10

#define TRANSMIT_CRC 0x11

#define DELAY_TRANSMIT_NO_CRC 0x12

#define DELAY_TRANSMIT_CRC 0x13

#define TRANSMIT_NEXT_SLOT 0x14

#define CLOSE_SLOT_SEQUENCE 0x15

#define STOP_DECODERS 0x16

#define RUN_DECODERS 0x17

#define CHECK_INTERNAL_RF 0x18

#define CHECK_EXTERNAL_RF 0x19

#define ADJUST_GAIN 0x1A

//---- Reader register ------------------------------------------

#define CHIP_STATE_CONTROL 0x00

#define ISO_CONTROL 0x01

#define ISO_14443B_OPTIONS 0x02

#define ISO_14443A_OPTIONS 0x03

#define TX_TIMER_EPC_HIGH 0x04

#define TX_TIMER_EPC_LOW 0x05

#define TX_PULSE_LENGTH_CONTROL 0x06

#define RX_NO_RESPONSE_WAIT_TIME 0x07

#define RX_WAIT_TIME 0x08

#define MODULATOR_CONTROL 0x09

#define RX_SPECIAL_SETTINGS 0x0A

#define REGULATOR_CONTROL 0x0B

#define IRQ_STATUS 0x0C // IRQ Status Register

#define IRQ_MASK 0x0D // Collision Position and Interrupt Mask Register

#define COLLISION_POSITION 0x0E

#define RSSI_LEVELS 0x0F

#define SPECIAL_FUNCTION 0x10

#define RAM_START_ADDRESS 0x11 //RAM is 6 bytes long (0x11 - 0x16)

#define ADJUSTABLE_FIFO_LEVEL 0x14

#define NFCID 0x17

#define NFC_TARGET_LEVEL 0x18

#define NFC_TARGET_PROTOCOL 0x19

#define TEST_SETTINGS_1 0x1A

#define TEST_SETTINGS_2 0x1B

#define FIFO_STATUS 0x1C

#define TX_LENGTH_BYTE_1 0x1D

#define TX_LENGTH_BYTE_2 0x1E

#define FIFO 0x1F

//===============================================================

void Trf7970CommunicationSetup(void);

void Trf7970DirectCommand(u08_t *pbuf);

void Trf7970DirectMode(void);

void Trf7970DisableSlotCounter(void);

void Trf7970EnableSlotCounter(void);

void Trf7970InitialSettings(void);

void Trf7970RawWrite(u08_t *pbuf, u08_t length);

void Trf7970ReConfig(void);

void Trf7970ReadCont(u08_t *pbuf, u08_t length);

void Trf7970ReadIrqStatus(u08_t *pbuf);

void Trf7970ReadSingle(u08_t *pbuf, u08_t length);

void Trf7970Reset(void);

void Trf7970ResetIrqStatus(void);

void Trf7970RunDecoders(void);

void Trf7970StopDecoders(void);

void Trf7970TransmitNextSlot(void);

void Trf7970TurnRfOff(void);

void Trf7970TurnRfOn(void);

void Trf7970WriteCont(u08_t *pbuf, u08_t length);

void Trf7970WriteIsoControl(u08_t iso_control);

void Trf7970WriteSingle(u08_t *pbuf, u08_t length);

void Trf7970PortB(void) ;

//===============================================================

#endif

trf7970BoosterPack.c

/*

* {trf7970BoosterPack.c}

*

* {MSP430G2553 specific functions}

*

*/

#include "trf7970.h"

#include "trf7970BoosterPack.h"

#include "utils.h"

//*****************************************************************************

//

//! Delay

//!

//! \param interval is time in milli second

//!

//! \return none

//!

//! \brief

//

//****************************************************************************

void Delay(unsigned long interval)

{

while(interval > 0)

{

UtilsDelay(80000);

interval--;

}

}

void McuDelayMillisecond(unsigned int ui_delay_in_msec){

UtilsDelay(80000*ui_delay_in_msec);

}

trf7970BoosterPack.h

/*

* {trf7970BoosterPack.h}

*

* {Header File}

*

*

*/

#ifndef _Trf7970BOOSTERPACK_H_

#define _Trf7970BOOSTERPACK_H_

//================================================================

#include <stdint.h>

#include "types.h"

#define _BOARD_H

/* This macro is for use by other macros to form a fully valid C statement. */

#define st(x) do { x } while (__LINE__ == -1)

#define COUNT_1ms 80000

#define IRQ_CLR GPIOIntClear(GPIOA1_BASE, GPIO_PIN_4); //GPIO 7

#define IRQ_ON GPIOIntEnable(GPIOA1_BASE,GPIO_PIN_4);

#define IRQ_OFF GPIOIntDisable(GPIOA1_BASE,GPIO_PIN_4);

#define START_COUNTER A2CounterEnable();

#define RESET_COUNTER A2CounterDisable();

#define TRF_OFF GPIO_IF_Set(11,0);

#define TRF_ON GPIO_IF_Set(11,1);

#define SPI_CS_ON MAP_SPICSEnable(GSPI_BASE);

#define SPI_CS_OFF MAP_SPICSDisable(GSPI_BASE);

void Delay(unsigned long interval);

void McuDelayMillisecond(unsigned int ui_delay_in_msec);

//===============================================================

#define TRIGGER 0 // if TRIGGER 1 trigger-point at LED 5

//=====MCU constants=============================================

// IRQ on P2.0

// rising edge interrupt

#define IRQ_PIN BIT7

#define IRQ_PORT HWREG(GPIOA1_BASE + GPIO_O_GPIO_RIS)

// Hard code to only SPI mode

#define SPIMODE 1

// CSn

//-----Counter-timer constants-----------------------------------

//---------------------------------------------------------------

// Set timer capture register value based on clock source

//---------------------------------------------------------------

// 25MHz clock

//===============================================================

#endif

main.c

/*

* Smart Doorlock

* main.c

*

* Created on: 2016. 8. 27.

*

* Author: Sokwhan Huh

*/

// C-Library includes

#include <string.h>

// Driverlib includes

#include "rom.h"

#include "rom_map.h"

#include "hw_memmap.h"

#include "hw_common_reg.h"

#include "hw_types.h"

#include "hw_ints.h"

#include "uart.h"

#include "interrupt.h"

#include "pinmux.h"

#include "utils.h"

#include "prcm.h"

#include "simplelink.h"

#include "gpio.h"

#include "timer.h"

// Common interface include

#include "common.h"

#include "uart_if.h"

#include "gpio_if.h"

#include "timer_if.h"

// Project includes

#include "network.h"

#include "keypad.h"

#include "lcd.h"

#include "mqtt_client.h"

#include "spi_l.h"

#include "trf7970.h"

#include "trf7970BoosterPack.h"

#include "iso15693.h"

#define APP_NAME "Smart Doorlock"

//RTOS Related Defines

#define OSI_STACK_SIZE 4096 /* 2048 */

#define SPAWN_TASK_PRIORITY 9

#define CONNECTION_TIMEOUT_COUNT 20 /* 10sec */

//Globals

unsigned int g_appReady = 0;

unsigned int g_activeMode = 0;

//===============================================================

/********** GLOBAL VARIABLES TRF7970A **********/

//===============================================================

u08_t buf[300]; // TX/RX BUFFER FOR TRF7970A

u08_t g_uid[300] = "none"; // used for coping card ID

char g_tag_content[600]; // used for saving a content of TAG buffer

char g_block_content[200]; // used for saving a content of single/multiple block(s)

u08_t g_rssi[10];

u08_t g_tag_found = 0; // 0->no tag found

// 1- ISO15693 tag found

// 2- ISO14443A tag found

// 8 - MASTER

u08_t Tag_Count;

u08_t i_reg = 0x01; // INTERRUPT REGISTER

u08_t irq_flag = 0x00;

u08_t rx_error_flag = 0x00;

s08_t rxtx_state = 1; // USED FOR TRANSMIT RECEIVE BYTE COUNT

u08_t host_control_flag = 0;

u08_t stand_alone_flag = 1;

int g_tag_count; // Tag counter

char g_tag_count_str[10]; // string representation of tag counter

static void DisplayBanner(char * AppName)

{

Report("\n\n\n\r");

Report("\t\t *************************************************\n\r");

Report("\t\t %s \n\r", AppName);

Report("\t\t *************************************************\n\r");

Report("\n\n\n\r");

}

static void SmartDoorlockLCDBanner() {

lcdReset();

lcdInit();

lcdDisplayOn();

lcdClearScreen();

lcdPutString("Smart Doorlock");

lcdSetPosition(LCD_LINE2);

lcdPutString("Initializing");

}

static void BoardInit(void)

{

// Enable Processor

MAP_IntMasterEnable();

MAP_IntEnable(FAULT_SYSTICK);

PRCMCC3200MCUInit();

}

static void SmartDoorlockMenuTask(void *pvParameters) {

SmartDoorlockLCDBanner();

for (;;) {

if (g_appReady) {

buttonEnum pressedBtn = getPressedButton();

char *btnType;//

switch (pressedBtn) {

case UP_ARROW:

btnType = "UP";

break;

case LEFT_ARROW:

btnType = "LEFT";

break;

case DOWN_ARROW:

btnType = "DOWN";

break;

case RIGHT_ARROW:

btnType = "RIGHT";

break;

case ENTER:

btnType = "ENTER";

case CANCEL:

Report("Disconnecting from MQTT/AP\n\r");

Mqtt_ClientExit();

Network_IF_DisconnectFromAP();

Network_IF_DeInitDriver();

Report("Exiting");

return;

}

if (pressedBtn != NONE) {

Report("Pressed: %s \n\r",btnType);

}

}

osi_Sleep(50);

}

}

static void SmartDoorlockNFCTask(void *pvParameters) {

Report("Entering NFC tag read mode\n\r");

g_tag_found = 0;

// TRF IRQ disable and clear

IRQ_OFF;

// TRF disable

TRF_OFF;

// delay at least 10 ms

osi_Sleep(100);

// Enter LPM3

TRF_ON;

// Must wait at least 4.8 mSec to allow TRF7970A to initialize.

osi_Sleep(5);

for (;;) {

g_tag_found = 0;

Iso15693FindTag(); // Scan for 15693 tags

if(g_tag_found) {

UART_PRINT("Tag Found \n\r");

}

osi_Sleep(10);

}

}

static void SmartDoorlockIoTTask(void *pvParameters) {

int retVal = ConnectAP("SW_Private", "smartdoorlock");

if (retVal != 0) {

Report("Connection to AP failed!\n\r");

return;

}

Report("Connection Successful!\n\r");

g_appReady = 1;

retVal = initMqtt();

if (retVal != 0)

return;

mqttConnect();

event_msg RecvQue;

for(;;)

{

osi_MsgQRead( &g_PBQueue, &RecvQue, OSI_WAIT_FOREVER);

if(BROKER_DISCONNECTION == RecvQue.event)

{

attemptReconnect();

}

if(DOORLOCK_OPEN == RecvQue.event)

{

Report("Queue: Opening Doorlock\n\r");

}

/* const char *pub_topic_sw3 = "/cc3200/ButtonPressEvtSw3";

unsigned char *data_sw2={"Push button sw2 is pressed on CC32XX device"};

sl_ExtLib_MqttClientSend((void*)local_con_conf[0].clt_ctx,//

pub_topic_sw3,data_sw2,strlen((char*)data_sw2),QOS2,RETAIN);

UART_PRINT("\n\r CC3200 Publishes the following message \n\r");

UART_PRINT("Topic: %s\n\r","TEST");

UART_PRINT("Data: %s\n\r","TEST");*/

}

}

//*****************************************************************************

//

//! This function gets triggered when A2CNT interrupt occures

//!

//! \param none

//!

//! \return None

//!

//*****************************************************************************

void A2CNTIntHandler (void){

u08_t irq_status[4];

TimerIntClear(TIMERA2_BASE, TIMER_A); // STOP_COUNTER;

irq_flag = 0x02;

Trf7970ReadIrqStatus(irq_status);

*irq_status = *irq_status & 0xF7; // set the parity flag to 0

if(*irq_status == 0x00 || *irq_status == 0x80)

{

i_reg = 0x00; // timer interrupt

}

else

{

i_reg = 0x01;

}

}

int main(void) {

// Initailizing the board

BoardInit();

// Muxing for Enabling GPIO, UART_TX and UART_RX.

PinMuxConfig();

//Init SPI

SPIInit();

//Turn off TRF7970A

SPI_TRF_CS_OFF;

SPI_LCD_CS_OFF;

// GPIO interrupt setting

// TRF7970 IRQ

GPIOIntInit(GPIOA1_BASE, GPIO_PIN_4, INT_GPIOA1, Trf7970PortB, GPIO_RISING_EDGE, INT_PRIORITY_LVL_1);

// Set Clock Frequency and Modulation

Trf7970InitialSettings();

A2CounterInit(A2CNTIntHandler);

// Init Terminal

InitTerm();

ClearTerm();

DisplayBanner(APP_NAME);

//Start the simplelink host

VStartSimpleLinkSpawnTask(SPAWN_TASK_PRIORITY);

/*

// Start the SmartDoorlock task

osi_TaskCreate( SmartDoorlockNFCTask,

(const signed char*)"Smart Doorlock NFCTask",

OSI_STACK_SIZE, NULL, 1, NULL );

*/

// Start the SmartDoorlock task

osi_MsgQCreate(&g_PBQueue,"PBQueue",sizeof(event_msg),10);

osi_TaskCreate( SmartDoorlockIoTTask,

(const signed char*)"Smart Doorlock IoTTask",

OSI_STACK_SIZE, NULL, 1, NULL );

// Start the Keypad task

osi_TaskCreate( SmartDoorlockMenuTask,

(const signed char*)"MenuTask",

OSI_STACK_SIZE, NULL, 1, NULL );

osi_start();

return 0;

}

# October 7th, 2016

I’ve made a critical mistake of burning out my MCU, LCD and NFC reader. What happened was I left one of the jumper wire unconnected and while trying to rearrange some connections on the breadboard, that wire left unconnected somehow made its way to the 9V power line, immediately destroying everything that was connected to it. Unfortunately, those parts were unsalvageable and I had to reorder the CC3200 launchpad, TRF7970A NFC reader and LCD.

I decided to change the LCD to a different one. The reason for this was that I wanted a display that’s slightly bigger and since I was experiencing issues when TRF7970A and LCD were connected at the same time (strangely, they work perfectly when connected independently. When connected together, TRF7970A simply stops reading and LCD starts to display broken characters), I wanted a display that runs on UART, instead of SPI. I decided to purchase Newhaven’s 20x4 display (NHD-0420D3Z-NSW-BBW-V3-ND), as its size was slightly larger than EA’s display and it supports four different interfacing modes: parallel, UART, SPI and I2C.

When I’ve reconnected everything with new parts, everything worked perfectly. Only issue I’ve encountered was that the NFC reading would slow down my entire program, so I had to optimize the program a bit by adjusting the NFC reading interval.

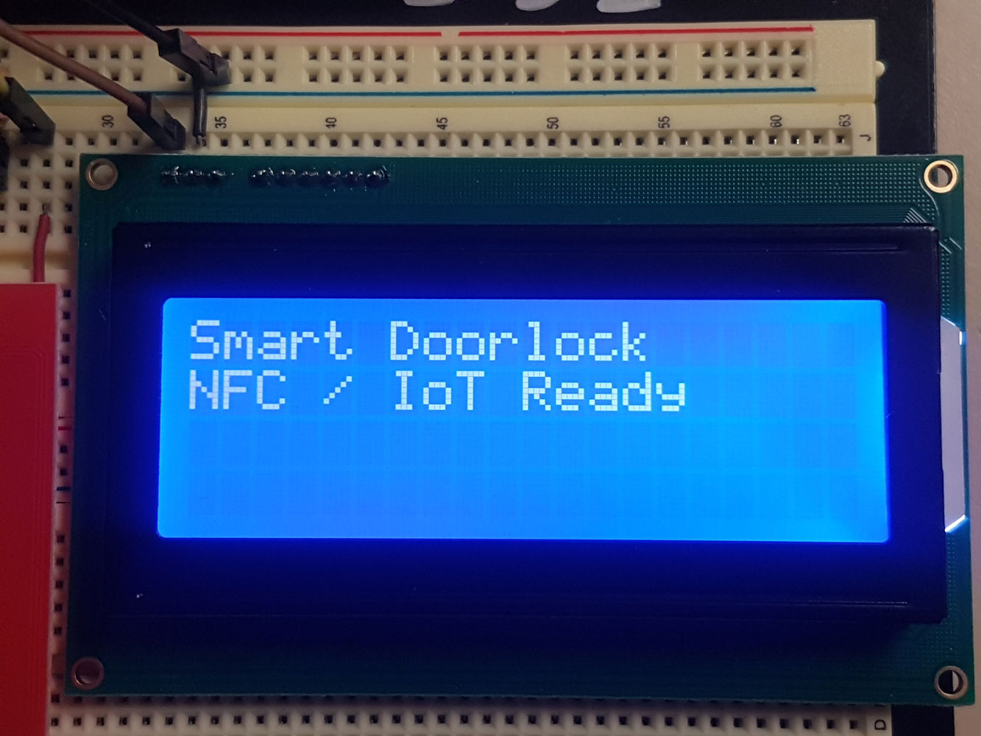
[picture p32: figure]
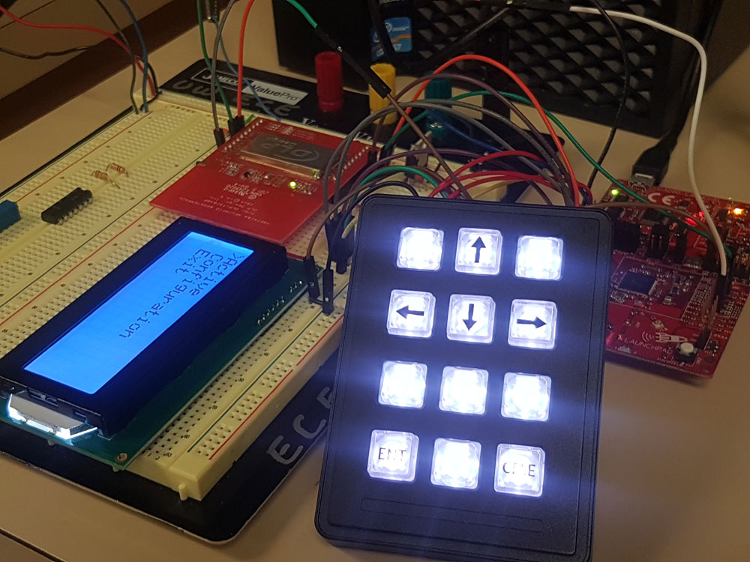
[picture p33: figure]

Full view of prototype setup

Smart doorlock in active mode

Because the LCD was changed, its code was updated accordingly.

lcd.c

/*

* lcd.c

*

* Created on: Sep 23, 2016

* Author: shuh

*/

#include "lcd.h"

// Driverlib includes

#include "rom_map.h"

#include "hw_memmap.h"

#include "hw_types.h"

#include "prcm.h"

#include "simplelink.h"

#include "uart.h"

// Common Interface Includes

#include "uart_if.h"

#define LCD_LINE1 0

#define LCD_LINE2 0x40

#define LCD_LINE3 0x14

#define LCD_LINE4 0x54

typedef enum

{

LCD_INIT,

CLEAR_SCREEN

} lcdCommandEnum;

static void lcdPutCommand(lcdCommandEnum cmdType) {

switch (cmdType) {

case CLEAR_SCREEN:

MAP_UARTCharPut(UARTA1_BASE,0xFE);

MAP_UARTCharPut(UARTA1_BASE,0x51);

break;

case LCD_INIT:

MAP_UARTConfigSetExpClk(UARTA1_BASE,MAP_PRCMPeripheralClockGet(CONSOLE_PERIPH),

9600, (UART_CONFIG_WLEN_8 | UART_CONFIG_STOP_ONE |

UART_CONFIG_PAR_NONE));

osi_Sleep(5);

MAP_UARTCharPut(UARTA1_BASE,0xFE);

MAP_UARTCharPut(UARTA1_BASE,0x41);

break;

}

}

void lcdSetPosition(unsigned int position) {

if (position < 1 || position > 4)

return;

MAP_UARTCharPut(UARTA1_BASE,0xFE);

MAP_UARTCharPut(UARTA1_BASE,0x45);

switch (position) {

case 1:

MAP_UARTCharPut(UARTA1_BASE,LCD_LINE1);

break;

case 2:

MAP_UARTCharPut(UARTA1_BASE,LCD_LINE2);

break;

case 3:

MAP_UARTCharPut(UARTA1_BASE,LCD_LINE3);

break;

case 4:

MAP_UARTCharPut(UARTA1_BASE,LCD_LINE4);

break;

}

}

void lcdClearScreen(void) {

lcdPutCommand(CLEAR_SCREEN);

osi_Sleep(3);

}

void lcdInit(void) {

lcdPutCommand(LCD_INIT);

osi_Sleep(1);

}

void lcdPutChar(unsigned char lcdChar) {

MAP_UARTCharPut(UARTA1_BASE,lcdChar);

}

void lcdPutString(unsigned char* str) {

do

{

lcdPutChar(*str++);

}

while(*str);

}

lcd.h

/*

* lcd.h

*

* Created on: Sep 23, 2016

* Author: shuh

*/

#ifndef LCD_H_

#define LCD_H_

extern void lcdInit();

extern void lcdClearScreen(void);

extern void lcdPutString(unsigned char* str);

extern void lcdPutChar(unsigned char lcdChar);

extern void lcdSetPosition(unsigned int position);

#endif /* LCD_H_ */

Slight modifications were made to main.c as well (lcd related changes & refactoring)

main.c

/*

* Smart Doorlock

* main.c

*

* Created on: 2016. 8. 27.

*

* Author: Sokwhan Huh

*/

// C-Library includes

#include <string.h>

// Driverlib includes

#include "rom.h"

#include "rom_map.h"

#include "hw_memmap.h"

#include "hw_common_reg.h"

#include "hw_types.h"

#include "hw_ints.h"

#include "uart.h"

#include "interrupt.h"

#include "pinmux.h"

#include "utils.h"

#include "prcm.h"

#include "simplelink.h"

#include "gpio.h"

#include "timer.h"

// Common interface include

#include "common.h"

#include "uart_if.h"

#include "gpio_if.h"

#include "timer_if.h"

// Project includes

#include "network.h"

#include "keypad.h"

#include "lcd.h"

#include "mqtt_client.h"

#include "spi_l.h"

#include "trf7970.h"

#include "trf7970BoosterPack.h"

#include "iso15693.h"

#define APP_NAME "Smart Doorlock"

//RTOS Related Defines

#define OSI_STACK_SIZE 4096 /* 2048 */

#define SPAWN_TASK_PRIORITY 9

#define CONNECTION_TIMEOUT_COUNT 20 /* 10sec */

//Globals

unsigned int g_appReady;

unsigned int g_openingDoor;

unsigned int g_appMode;

unsigned int g_currMenuOption;

//===============================================================

/********** GLOBAL VARIABLES TRF7970A **********/

//===============================================================

u08_t buf[300]; // TX/RX BUFFER FOR TRF7970A

u08_t g_uid[300] = "none"; // used for coping card ID

char g_tag_content[600]; // used for saving a content of TAG buffer

char g_block_content[200]; // used for saving a content of single/multiple block(s)

u08_t g_rssi[10];

u08_t g_tag_found = 0; // 0->no tag found

// 1- ISO15693 tag found

// 2- ISO14443A tag found

// 8 - MASTER

u08_t Tag_Count;

u08_t i_reg = 0x01; // INTERRUPT REGISTER

u08_t irq_flag = 0x00;

u08_t rx_error_flag = 0x00;

s08_t rxtx_state = 1; // USED FOR TRANSMIT RECEIVE BYTE COUNT

u08_t host_control_flag = 0;

u08_t stand_alone_flag = 1;

int g_tag_count; // Tag counter

char g_tag_count_str[10]; // string representation of tag counter

typedef enum

{

LCD_DISP_INIT,

LCD_DISP_CONNECT_AP,

LCD_DISP_CONNECT_MQTT,

LCD_DISP_ACTIVE,

LCD_DISP_OPENING_DOOR,

LCD_DISP_EXITING_APP

} sdLcdEnum;

typedef enum

{

MODE_MENU,

MODE_ACTIVE,

MODE_CONFIG

} appModeEnum;

typedef enum

{

MENU_ACTIVE,

MENU_CONFIG,

MENU_EXIT

} appMenuEnum;

#define MENU_COUNT 3

const unsigned char *menuList[3];

static void DisplayBanner(char * AppName)

{

Report("\n\n\n\r");

Report("\t\t *************************************************\n\r");

Report("\t\t %s \n\r", AppName);

Report("\t\t *************************************************\n\r");

Report("\n\n\n\r");

}

static void BoardInit(void)

{

// Enable Processor

MAP_IntMasterEnable();

MAP_IntEnable(FAULT_SYSTICK);

PRCMCC3200MCUInit();

}

static void SmartDoorlockLCDDisplay(sdLcdEnum lcdEnum) {

lcdClearScreen();

switch (lcdEnum) {

case LCD_DISP_INIT:

lcdPutString("Smart Doorlock");

lcdSetPosition(2);

lcdPutString("Initializing");

break;

case LCD_DISP_CONNECT_AP:

lcdPutString("Smart Doorlock");

lcdSetPosition(2);

lcdPutString("Connecting to AP...");

lcdSetPosition(3);

lcdPutString("SSID: SW_Private");

break;

case LCD_DISP_CONNECT_MQTT:

lcdPutString("Smart Doorlock");

lcdSetPosition(2);

lcdPutString("Connecting to");

lcdSetPosition(3);

lcdPutString("MQTT Broker...");

break;

case LCD_DISP_ACTIVE:

lcdPutString("Smart Doorlock");

lcdSetPosition(2);

lcdPutString("NFC / IoT Ready");

break;

case LCD_DISP_OPENING_DOOR:

lcdPutString("Smart Doorlock");

lcdSetPosition(2);

lcdPutString("Opening Door...");

break;

case LCD_DISP_EXITING_APP:

lcdPutString("Smart Doorlock");

lcdSetPosition(2);

lcdPutString("Exiting App.");

break;

}

}

static void MoveMenu(int menuOption) {

lcdClearScreen();

int i = 0;

for (i = 0; i < MENU_COUNT; i++) {

lcdSetPosition(i+1);

i == menuOption ? lcdPutChar('>') : lcdPutChar(' ');

lcdPutString((unsigned char*)menuList[i]);

}

}

static void OpenDoor() {

Report("Opening Doorlock\n\r");

SmartDoorlockLCDDisplay(LCD_DISP_OPENING_DOOR);

g_openingDoor = 1;

GPIO_IF_Set(22,1);

osi_Sleep(3000);

GPIO_IF_Set(22,0);

g_openingDoor = 0;

SmartDoorlockLCDDisplay(LCD_DISP_ACTIVE);

Report("Closing Doorlock\n\r");

}

static void SmartDoorlockMenuTask(void *pvParameters) {

lcdInit();

lcdClearScreen();

SmartDoorlockLCDDisplay(LCD_DISP_INIT);

menuList[0] = "Active";

menuList[1] = "Configuration";

menuList[2] = "Exit";

g_appMode = MODE_MENU;

g_currMenuOption = 0;

while (!g_appReady) {

osi_Sleep(1);

}

MoveMenu(g_currMenuOption);

for (;;) {

buttonEnum pressedBtn = getPressedButton();

if (g_appMode == MODE_MENU) {

if (pressedBtn == UP_ARROW && g_currMenuOption > 0) {

g_currMenuOption--;

MoveMenu(g_currMenuOption);

}

else if (pressedBtn == DOWN_ARROW && g_currMenuOption < MENU_COUNT - 1) {

g_currMenuOption++;

MoveMenu(g_currMenuOption);

}

else if (pressedBtn == ENTER) {

if (g_currMenuOption == MENU_ACTIVE) {

g_appMode = MODE_ACTIVE;

SmartDoorlockLCDDisplay(LCD_DISP_ACTIVE);

}

else if (g_currMenuOption == MENU_EXIT) {

SmartDoorlockLCDDisplay(LCD_DISP_EXITING_APP);

Report("Disconnecting from MQTT/AP\n\r");

Mqtt_ClientExit();

Network_IF_DisconnectFromAP();

Network_IF_DeInitDriver();

Report("Exiting");

return;

}

}

}

else if (g_appMode == MODE_ACTIVE && g_openingDoor == 0) {

if (pressedBtn == CANCEL) {

g_appMode = MODE_MENU;

MoveMenu(g_currMenuOption);

}

}

osi_Sleep(40);

}

}

static void SmartDoorlockNFCTask(void *pvParameters) {

Report("Entering NFC tag read mode\n\r");

for (;;) {

if (g_appMode != MODE_ACTIVE || g_openingDoor == 1) {

osi_Sleep(1);

continue;

}

g_tag_found = 0;

// TRF IRQ disable and clear

IRQ_OFF;

// TRF disable

TRF_OFF;

// delay at least 10 ms

osi_Sleep(100);

// Enter LPM3

TRF_ON;

// Must wait at least 4.8 mSec to allow TRF7970A to initialize.

osi_Sleep(5);

Iso15693FindTag(); // Scan for 15693 tags

if(g_tag_found) {

UART_PRINT("Tag Found \n\r");

OpenDoor();

}

osi_Sleep(300);

}

}

static void SmartDoorlockIoTTask(void *pvParameters) {

osi_Sleep(500);

SmartDoorlockLCDDisplay(LCD_DISP_CONNECT_AP);

int retVal = ConnectAP("SW_Private", "smartdoorlock");

if (retVal != 0) {

lcdClearScreen();

lcdPutString("Connection to AP failed!");

Report("Connection to AP failed!\n\r");

return;

}

Report("Connection Successful!\n\r");

retVal = initMqtt();

if (retVal != 0)

return;

osi_Sleep(100);

SmartDoorlockLCDDisplay(LCD_DISP_CONNECT_MQTT);

retVal = mqttConnect();

osi_Sleep(500);

if (retVal != 0) {

lcdClearScreen();

lcdPutString("Connection to MQTT failed!");

return;

}

g_appReady = 1;

event_msg RecvQue;

for(;;)

{

osi_MsgQRead( &g_PBQueue, &RecvQue, OSI_WAIT_FOREVER);

if (g_appMode != MODE_ACTIVE) {

Report("IoT Task: Msg received but not in active mode\n\r");

osi_Sleep(1);

continue;

}

if(BROKER_DISCONNECTION == RecvQue.event)

{

attemptReconnect();

}

if(DOORLOCK_OPEN == RecvQue.event)

{

if (g_openingDoor == 1) {

Report("IoT Task: Doorlock is already being opened\n\r");

continue;

}

OpenDoor();

}

}

}

//*****************************************************************************

//

//! This function gets triggered when A2CNT interrupt occures

//!

//! \param none

//!

//! \return None

//!

//*****************************************************************************

void A2CNTIntHandler (void){

u08_t irq_status[4];

TimerIntClear(TIMERA2_BASE, TIMER_A); // STOP_COUNTER;

irq_flag = 0x02;

Trf7970ReadIrqStatus(irq_status);

*irq_status = *irq_status & 0xF7; // set the parity flag to 0

if(*irq_status == 0x00 || *irq_status == 0x80)

{

i_reg = 0x00; // timer interrupt

}

else

{

i_reg = 0x01;

}

}

int main(void) {

// Initailizing the board

BoardInit();

// Muxing for Enabling GPIO, UART_TX and UART_RX.

PinMuxConfig();

//Init SPI

SPIInit();

//Turn off TRF7970A

SPI_TRF_CS_OFF;

// GPIO interrupt setting

// TRF7970 IRQ

GPIOIntInit(GPIOA1_BASE, GPIO_PIN_4, INT_GPIOA1, Trf7970PortB, GPIO_RISING_EDGE, INT_PRIORITY_LVL_1);

// Set Clock Frequency and Modulation

Trf7970InitialSettings();

A2CounterInit(A2CNTIntHandler);

// Init Terminal

InitTerm();

ClearTerm();

DisplayBanner(APP_NAME);

//Start the simplelink host

VStartSimpleLinkSpawnTask(SPAWN_TASK_PRIORITY);

// Start the Keypad task

osi_TaskCreate( SmartDoorlockMenuTask,

(const signed char*)"MenuTask",

OSI_STACK_SIZE, NULL, 1, NULL );

// Start the SmartDoorlock NFC task

osi_TaskCreate( SmartDoorlockNFCTask,

(const signed char*)"Smart Doorlock NFCTask",

OSI_STACK_SIZE, NULL, 1, NULL );

// Start the SmartDoorlock IoT task

osi_MsgQCreate(&g_PBQueue,"PBQueue",sizeof(event_msg),10);

osi_TaskCreate( SmartDoorlockIoTTask,

(const signed char*)"Smart Doorlock IoTTask",

OSI_STACK_SIZE, NULL, 1, NULL );

osi_start();

return 0;

}

# October 10th, 2016

The 5V/12V dual output power supply & solenoid motor finally came. George, our master technician has helped me solder the ends to the AC receptacle. Testing the 5V line with a multimeter yielded correct voltage, so I’ve went ahead and connected the 5V line to the breadboard. The 12V line however, showed fluctuating voltage between 14.1V to 14.6V. To determine the cause for this, I’ve relooked at the datasheet. It turned out that the 12V line requires a minimum load of 20% for proper operation. The 12V line is rated at 1.3A max current, so a simple calculation shows

1.3A * 0.20 = 0.26A minimum load required

R=V/I=(12V)/(0.26A)=46.15Ω or lower value resistor required

P=V*I=12V*0.26A=3.12W or greater watt threshold resistor required

I’m not too happy about the excessive power wasted just to power the solenoid, but I suppose this is the price of buying a really small-sized power supply.

The following circuit diagram, taken from Adafruit’s website was used to quickly test the solenoid.

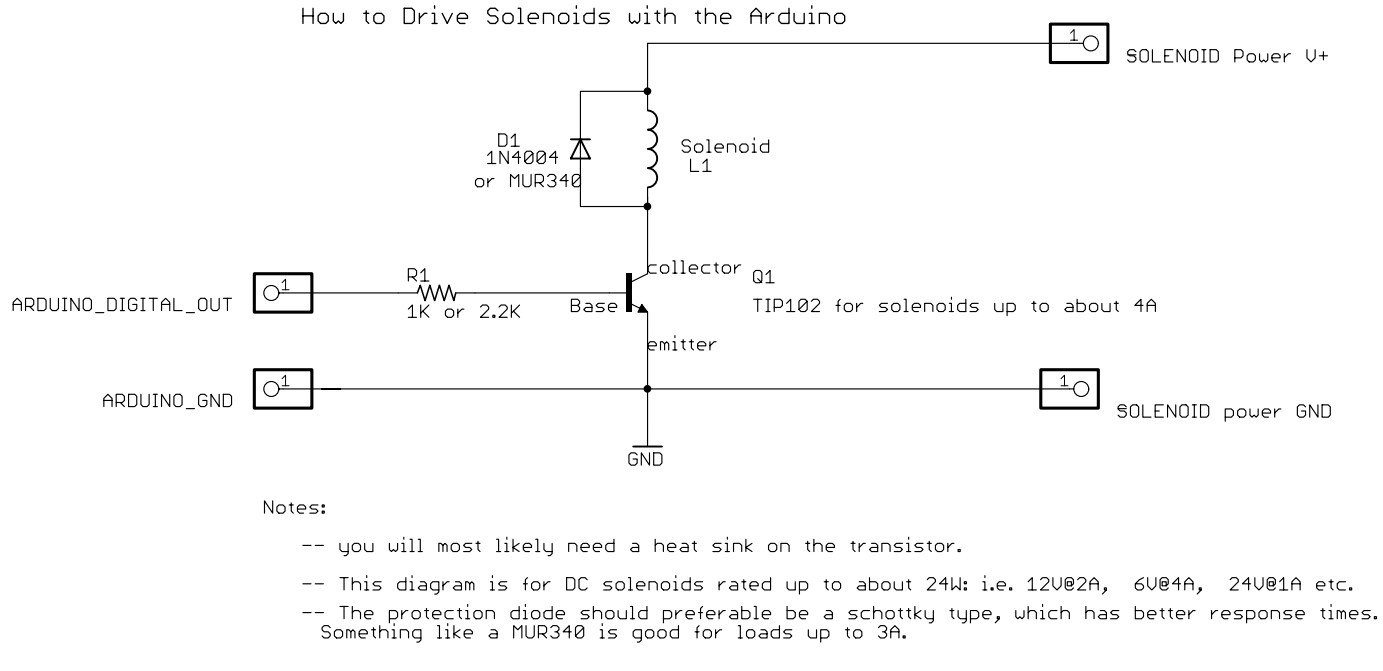
[picture p34: figure]

Adafruit’s example on how to drive a solenoid with Arduino

Feeding 5V to the base of the transistor demonstrated that the solenoid works correctly. The solenoid will be connected later when I acquire a 5W, ~40 ohm power resistor.
