l46kok/smart-doorlock/Documents/SD_PCB/PCB_BLACK_BLUE_LAYER.pdf

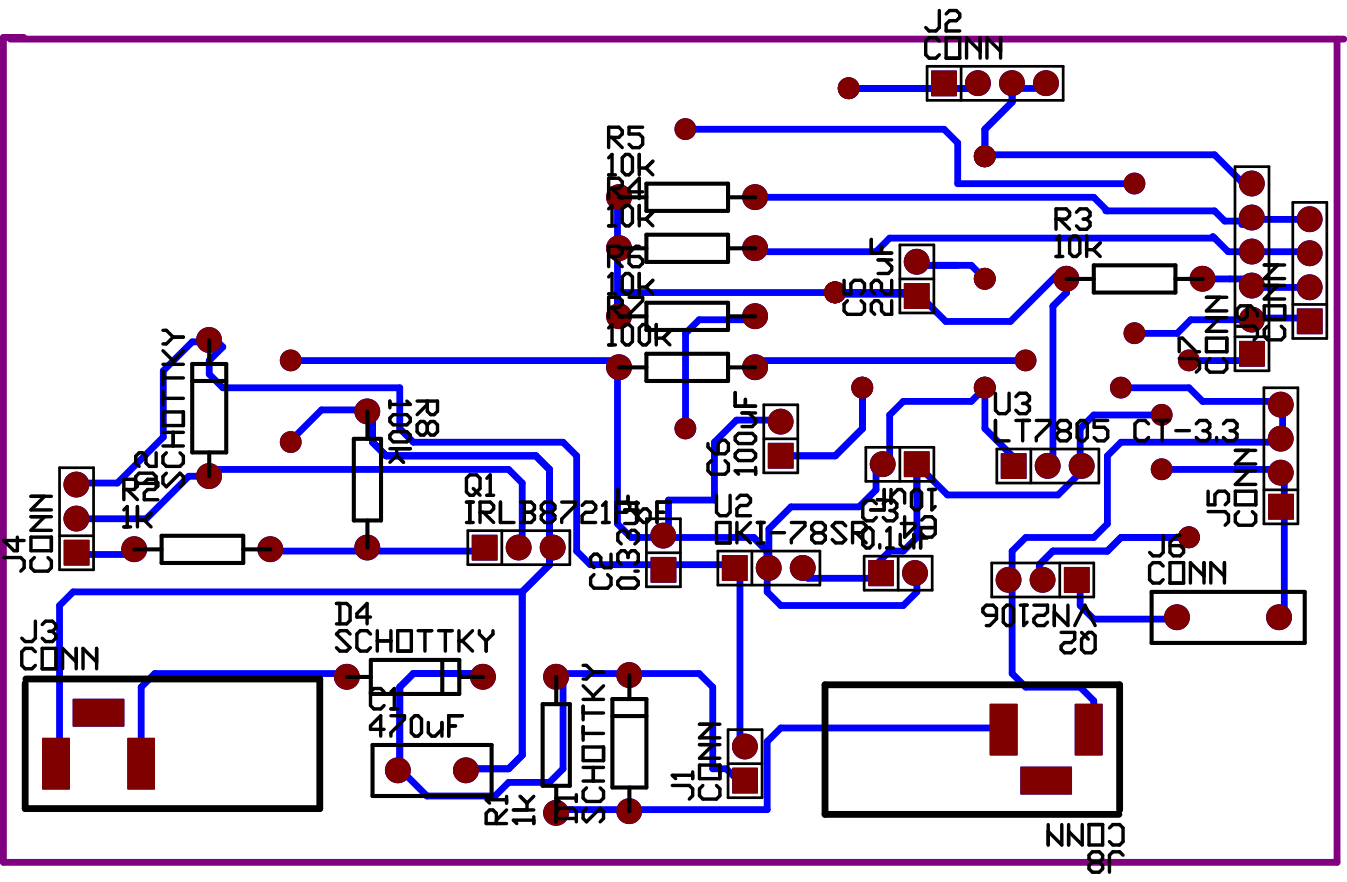
[picture p35: page 1]
