l46kok/smart-doorlock/Documents/SD_PCB/PCB_BLACK_ORIG.pdf

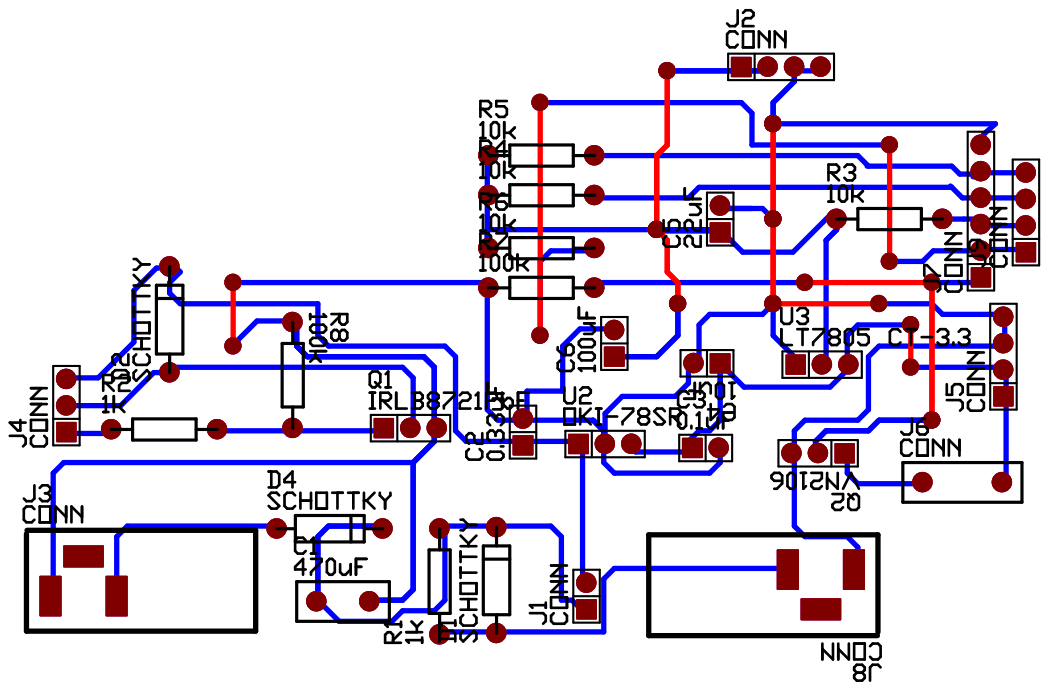
[picture p36: page 1]
