l46kok/smart-doorlock/Documents/SD_PCB/PCB_BLACK_ORIG_SINGLE_PAGE.pdf

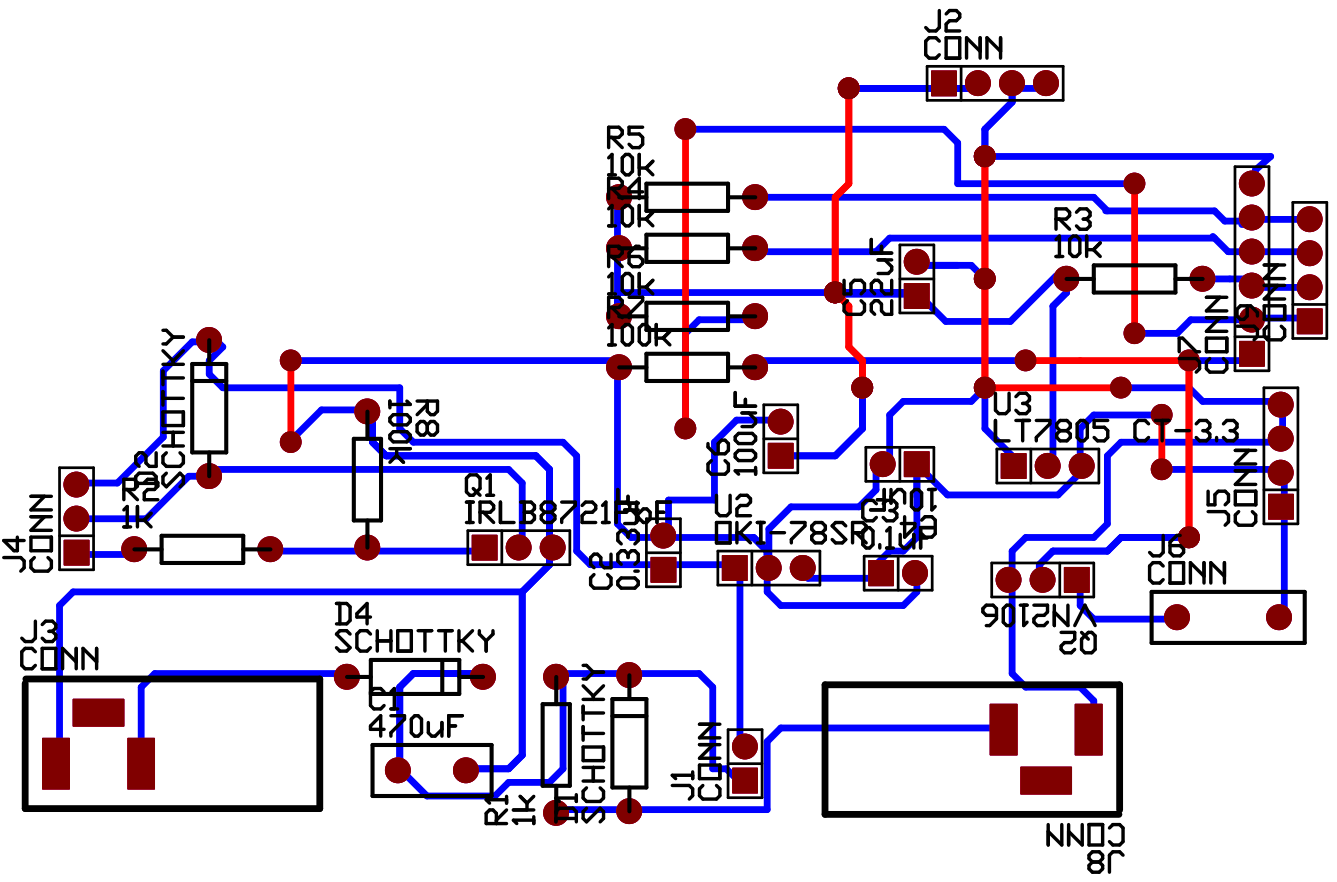
[picture p37: page 1]
