l46kok/smart-doorlock/Documents/SD_PCB/PCB_BLACK_OVERLAY_OFF.pdf

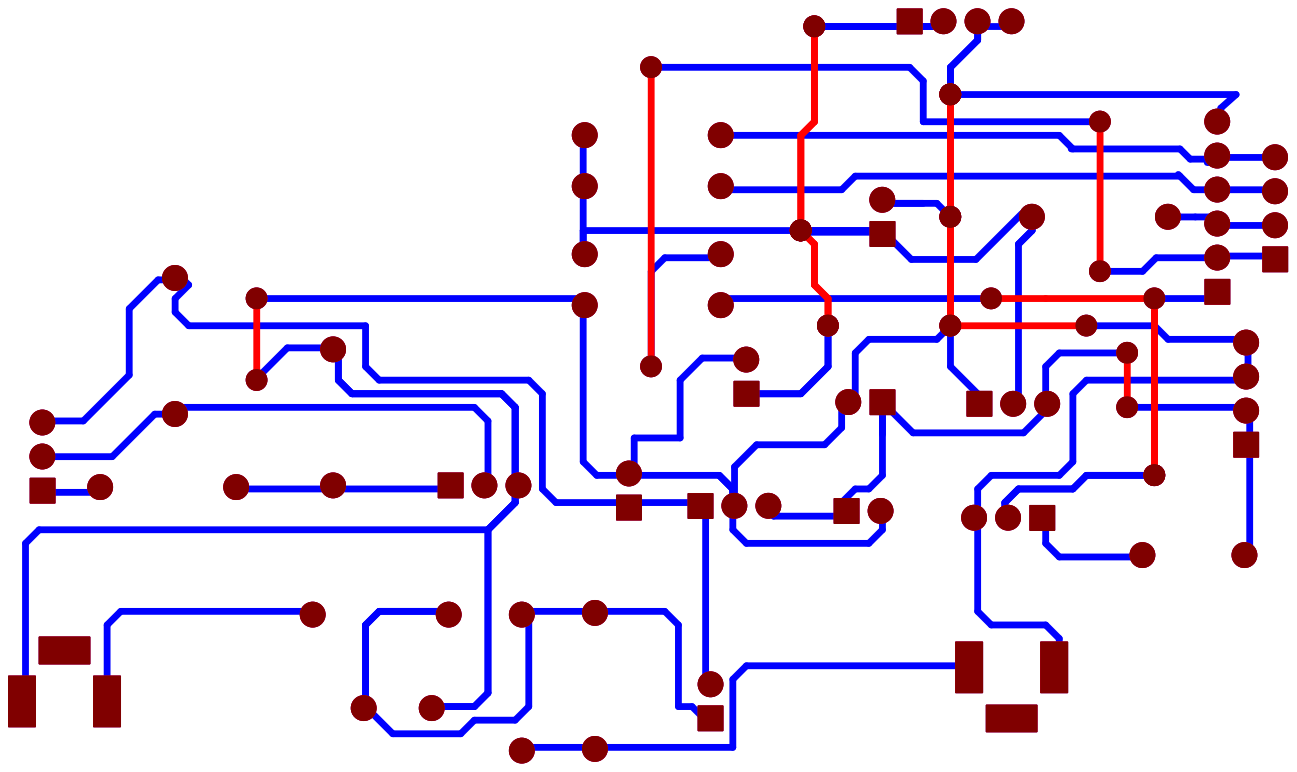
[picture p38: page 1]
