l46kok/smart-doorlock/(list of files, drawings)

Other design files:
Documents/SD_PCB/SD_PCB.PCB
Documents/SD_PCB/SD_PCB_2-vic.PCB
Documents/SD_PCB/SD_PCB_2.PCB
Documents/SD_PCB/SD_PCB_Final.PCB
