l46kok/smart-doorlock/timer_if.c

//*****************************************************************************
// timer_if.c
//
// timer interface file: contains different interface functions for timer APIs
//
// Copyright (C) 2014 Texas Instruments Incorporated - http://www.ti.com/ 
// 
// 
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
//    Redistributions of source code must retain the above copyright 
//    notice, this list of conditions and the following disclaimer.
//
//    Redistributions in binary form must reproduce the above copyright
//    notice, this list of conditions and the following disclaimer in the 
//    documentation and/or other materials provided with the   
//    distribution.
//
//    Neither the name of Texas Instruments Incorporated nor the names of
//    its contributors may be used to endorse or promote products derived
//    from this software without specific prior written permission.
//
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
//*****************************************************************************

#include "hw_types.h"
#include "hw_memmap.h"
#include "hw_ints.h"
#include "debug.h"
#include "interrupt.h"
#include "timer.h"
#include "hw_timer.h"
#include "rom.h"
#include "rom_map.h"
#include "prcm.h"
#include "timer_if.h"
#ifdef USE_TIRTOS
#include <stdlib.h>
#include "osi.h"
#endif

#ifdef USE_TIRTOS
static unsigned char
GetPeripheralIntNum(unsigned long ulBase, unsigned long ulTimer)
{
    if(ulTimer == TIMER_A)
    {
       switch(ulBase)
       {
           case TIMERA0_BASE:
		   	  return INT_TIMERA0A;
		   case TIMERA1_BASE:
		   	  return INT_TIMERA1A;
		   case TIMERA2_BASE:
		   	  return INT_TIMERA2A;
		   case TIMERA3_BASE:
		   	  return INT_TIMERA3A;
		   default:
		   	  return INT_TIMERA0A;
       	}
    }
	else if(ulTimer == TIMER_B)
	{
       switch(ulBase)
       {
           case TIMERA0_BASE:
		   	  return INT_TIMERA0B;
		   case TIMERA1_BASE:
		   	  return INT_TIMERA1B;
		   case TIMERA2_BASE:
		   	  return INT_TIMERA2B;
		   case TIMERA3_BASE:
		   	  return INT_TIMERA3B;
		   default:
		   	  return INT_TIMERA0B;
       	}
    }
	else
	{
		return INT_TIMERA0A;
	}

}
#endif
//*****************************************************************************
//
//!	Initializing the Timer
//!
//! \param ePeripheral is the peripheral which need to be initialized.
//! \param ulBase is the base address for the timer.
//! \param ulConfig is the configuration for the timer.
//! \param ulTimer selects amoung the TIMER_A or TIMER_B or TIMER_BOTH.
//! \param ulValue is the timer prescale value which must be between 0 and
//! 255 (inclusive) for 16/32-bit timers and between 0 and 65535 (inclusive)
//! for 32/64-bit timers.
//! This function
//! 	1. Enables and reset the peripheral for the timer.
//! 	2. Configures and set the prescale value for the timer.
//!
//! \return none
//
//*****************************************************************************
void Timer_IF_Init( unsigned long ePeripheral, unsigned long ulBase, unsigned
               long ulConfig, unsigned long ulTimer, unsigned long ulValue)
{
    //
    // Initialize GPT A0 (in 32 bit mode) as periodic down counter.
    //
    MAP_PRCMPeripheralClkEnable(ePeripheral, PRCM_RUN_MODE_CLK);
    MAP_PRCMPeripheralReset(ePeripheral);
    MAP_TimerConfigure(ulBase,ulConfig);
    MAP_TimerPrescaleSet(ulBase,ulTimer,ulValue);
}

//*****************************************************************************
//
//!	setting up the timer
//!
//! \param ulBase is the base address for the timer.
//! \param ulTimer selects between the TIMER_A or TIMER_B or TIMER_BOTH.
//! \param TimerBaseIntHandler is the pointer to the function that handles the
//!	interrupt for the Timer
//!
//! This function
//! 	1. Register the function handler for the timer interrupt.
//! 	2. enables the timer interrupt.
//!
//! \return none
//
//*****************************************************************************
void Timer_IF_IntSetup(unsigned long ulBase, unsigned long ulTimer, 
                   void (*TimerBaseIntHandler)(void))
{
  //
  // Setup the interrupts for the timer timeouts.
  //
#ifdef USE_TIRTOS
	  if(ulTimer == TIMER_BOTH)
	  {
	      osi_InterruptRegister(GetPeripheralIntNum(ulBase, TIMER_A),
	  		     				TimerBaseIntHandler, INT_PRIORITY_LVL_1);
	      osi_InterruptRegister(GetPeripheralIntNum(ulBase, TIMER_B),
	  						    TimerBaseIntHandler, INT_PRIORITY_LVL_1);
	  }
	  else
      {
          osi_InterruptRegister(GetPeripheralIntNum(ulBase, ulTimer),
	  		     				TimerBaseIntHandler, INT_PRIORITY_LVL_1);
      }
		
#else
	  MAP_TimerIntRegister(ulBase, ulTimer, TimerBaseIntHandler);
#endif
 

  if(ulTimer == TIMER_BOTH)
  {
    MAP_TimerIntEnable(ulBase, TIMER_TIMA_TIMEOUT|TIMER_TIMB_TIMEOUT);
  }
  else
  {
    MAP_TimerIntEnable(ulBase, ((ulTimer == TIMER_A) ? TIMER_TIMA_TIMEOUT : 
                                   TIMER_TIMB_TIMEOUT));
  }
}

//*****************************************************************************
//
//!	clears the timer interrupt
//!
//! \param ulBase is the base address for the timer.
//!
//! This function
//! 	1. clears the interrupt with given base.
//!
//! \return none
//
//*****************************************************************************
void Timer_IF_InterruptClear(unsigned long ulBase)
{
    unsigned long ulInts;
    ulInts = MAP_TimerIntStatus(ulBase, true);
    //
    // Clear the timer interrupt.
    //
    MAP_TimerIntClear(ulBase, ulInts);
}

//*****************************************************************************
//
//!	starts the timer
//!
//! \param ulBase is the base address for the timer.
//! \param ulTimer selects amoung the TIMER_A or TIMER_B or TIMER_BOTH.
//! \param ulValue is the the number of clock cycles after which the timer will
//! run out and gives the interrupt.
//!
//! This function
//! 	1. Load the Timer with the specified value.
//! 	2. enables the timer.
//!
//! \return none
//
//*****************************************************************************
void Timer_IF_Start(unsigned long ulBase, unsigned long ulTimer, 
                unsigned long ulValue)
{
    MAP_TimerLoadSet(ulBase,ulTimer,ulValue);
    //
    // Enable the GPT 
    //
    MAP_TimerEnable(ulBase,ulTimer);
}

//*****************************************************************************
//
//!	disable the timer
//!
//! \param ulBase is the base address for the timer.
//! \param ulTimer selects amoung the TIMER_A or TIMER_B or TIMER_BOTH.
//!
//! This function
//! 	1. disables the interupt.
//!
//! \return none
//
//*****************************************************************************
void Timer_IF_Stop(unsigned long ulBase, unsigned long ulTimer)
{
    //
    // Disable the GPT 
    //
    MAP_TimerDisable(ulBase,ulTimer);
}

//*****************************************************************************
//
//!	De-Initialize the timer
//!
//! \param uiGPTBaseAddr
//! \param ulTimer
//!
//! This function 
//!		1. disable the timer interrupts
//!		2. unregister the timer interrupt
//!
//!	\return None.
//
//*****************************************************************************
void Timer_IF_DeInit(unsigned long ulBase,unsigned long ulTimer)
{
  //
  // Disable the timer interrupt
  //
  MAP_TimerIntDisable(ulBase,TIMER_TIMA_TIMEOUT|TIMER_TIMB_TIMEOUT);
  //
  // Unregister the timer interrupt
  //
  MAP_TimerIntUnregister(ulBase,ulTimer);
}

//*****************************************************************************
//
//!	starts the timer
//!
//! \param ulBase is the base address for the timer.
//! \param ulTimer selects between the TIMER A and TIMER B.
//! \param ulValue is the the number of clock cycles after which the timer will
//! run out and gives the interrupt.
//!
//! This function
//! 	1. Reload the Timer with the specified value.
//!
//! \return none
//
//*****************************************************************************
void Timer_IF_ReLoad(unsigned long ulBase, unsigned long ulTimer, 
                unsigned long ulValue)
{
     MAP_TimerLoadSet(ulBase,ulTimer,ulValue);
}

//*****************************************************************************
//
//!	starts the timer
//!
//! \param ulBase is the base address for the timer.
//! \param ulTimer selects amoung the TIMER_A or TIMER_B or TIMER_BOTH.
//!
//! This function
//! 	1. returns the timer value.
//!
//! \return Timer Value.
//
//*****************************************************************************
unsigned int Timer_IF_GetCount(unsigned long ulBase, unsigned long ulTimer)
{
    unsigned long ulCounter;
    ulCounter = MAP_TimerValueGet(ulBase, ulTimer);
    return 0xFFFFFFFF - ulCounter;
}

void A2CounterLoad(unsigned long ulTimer)
{
	TimerLoadSet(TIMERA2_BASE, TIMER_A, ulTimer);
}
void A2CounterEnable(void)
{
	TimerEnable(TIMERA2_BASE, TIMER_A);
}
void A2CounterDisable(void)
{
	TimerDisable(TIMERA2_BASE, TIMER_A);
}
void A2CounterStop(void)
{
	TimerIntClear(TIMERA2_BASE, TIMER_A);
}

void A2CounterInit (   void (*pfnHandler)(void) )
{

 //   MAP_PRCMPeripheralClkEnable(PRCM_TIMERA1, PRCM_RUN_MODE_CLK);
 //
 //   MAP_TimerConfigure(ulBase,ulConfig);
 //   MAP_TimerPrescaleSet(ulBase,ulTimer,ulValue);

	PRCMPeripheralReset(PRCM_TIMERA2);
	TimerDisable(TIMERA2_BASE, TIMER_A);
	TimerConfigure(TIMERA2_BASE,TIMER_CFG_ONE_SHOT);
 //   TimerPrescaleSet(TIMERA2_BASE, TIMER_A, 80);

    TimerIntRegister(TIMERA2_BASE,  TIMER_A,  pfnHandler);
    TimerIntClear(TIMERA2_BASE, TIMER_A);
    TimerIntEnable(TIMERA2_BASE,TIMER_TIMA_TIMEOUT);
}




//*****************************************************************************
//
// Close the Doxygen group.
//! @}
//
//*****************************************************************************
