l46kok/smart-doorlock/(commit log)

2016-08-28 Added UART functionality, pinmux. Linked dependencies
2016-08-29 Adjusted project heap size, removed uart_if.h (using common includes)
2016-09-08 Added GPIO (LED1,2,3)
2016-09-08 Added network interfacing code (not working currently)
    [gpio_if.c, main.c, network.c, network.h, network_common.c]
2016-09-22 Added Keypad Interfacing code. Works perfectly (PIN21 on Launchpad does not work for some reason, so temporarily routed it to PIN64 (GPIO9) for time being)
    [gpio_if.c, gpio_if.h, main.c, pinmux.c]
2016-09-23 Added base code for general timer (A0), not tested yet
2016-09-23 Removed timer.c, switched keypad functionality from timer polling based to thread based
2016-09-24 Added SPI code, tested on 74LS164 shift register, works properly
2016-09-24 Added lcd.c, lcd.h, refactored SPI related code into lcd file
2016-09-24 Completed LCD putchar, putcommand, clearscreen command. Not tested yet (Waiting for lcd socket to arrive).
2016-09-26 Fixed network.c (Performs ping test), AP connection works well, Removed globas.h, added ENTER enum in keypad.c
    [keypad.c, keypad.h, lcd.c, main.c, network.c, network.h]
2016-09-26 Completed mqtt_client test code (Verified with IBM mqtt broker), changed SRAM_CODE, SRAM_DATA region
    [main.c, mqtt_client.c, mqtt_client.h, network.c, network.h]
2016-09-26 Added 2 Button GPIO (Testing only), added Cancel keypad event, added mqtt_client send example back to broker. Hitting cancel button gracefully quits network driver.
    [keypad.c, keypad.h, main.c, mqtt_client.c, mqtt_client.h, network.c, network.h, pinmux.c]
2016-09-30 Added NFC related files & timer_if
2016-10-02 Removed iso14443a standard NFC, changed pin layout on Keypad, added bunch of methods to lcd.c,h (not working)
    [gpio_if.h, iso14443a.c, iso14443a.h, iso15693.c, lcd.c, lcd.h, main.c, pinmux.c]
2016-10-03 Added lcdSetPosition method, fixed lcdCheckBusy method
    [lcd.c, lcd.h, main.c]
2016-10-03 Added GPIO output for solenoid, added main LCD text strings
2016-10-03 Changed PIN_06->PIN_15 for Solenoid, commented out LCDCheckBusy
2016-10-10 Changed LCD to Newhaven, changed interface type from SPI->UART
2016-10-12 Added MODE_EXIT functionality (Exits from all three threads)
2016-10-12 Switched solenoid pin from 15->4, fixed minor initialization issues
    [main.c, pinmux.c]
2016-10-31 Added two more menus (Operation Setup, Factory Reset)
    [lcd.c, lcd.h, main.c]
2016-10-31 Added Operation Menu, Unregister Menu, Factory Reset functionality
    [lcd.c, lcd.h, main.c, menu.c, menu.h, nfc.c, nfc.h, s_flash.c]
2016-10-31 Added reboot after setting operation mode
    [lcd.c, lcd.h, menu.c]
2016-11-01 Refactored reboot function to mcu.c, implemented first time setup functionality (code needs serious refactoring...)
    [lcd.c, lcd.h, main.c, mcu.c, menu.c, s_flash.c, sd_globals.h]
2016-11-03 Changed keypad type from hex-keypad to 4-button (smaller)
2016-11-03 Added buzzer related code
    [gpio_if.h, main.c, nfc.c, pinmux.c]
2016-11-03 Changed default mode from MODE_MENU to MODE_ACTIVE on load, changed exit menu to reboot
    [main.c, menu.c, sd_globals.h]
2016-11-09 Changed GPIO pin for buzzer (previous one doesn't work, board defective?)
    [gpio_if.h, pinmux.c]
2016-12-08 Added schematics,circuits & videos
    [SD_PCB.PCB, SD_PCB_2-vic.PCB, SD_PCB_2.PCB, SD_PCB_Final.PCB]
